panibillo/Colorimeter/docs/IMPLEMENTATION_COMPLETE.md

# Exposure Optimization Implementation — Complete ✓

**Date:** 2026-08-20  
**All steps completed and verified**

---

## Summary

Three major deliverables completed:

### 1. ✓ Database: Improved Exposures Written

**File:** `/home/bill/R/pi/colorimeter_2026-08-20.sqlite`

**What was updated:**
- Violet e* improved: 17,808 → 11,872 µs (−1 rung)
- Royal-blue e* improved: 3,290 → 2,193 µs (−1 rung)
- Cyan e* improved: 7,402 → 11,103 µs (+1 rung)

**Result:** 45 new active exposures inserted; 45 old ones deactivated (history preserved)

**Status:** Next Normal test run automatically uses improved exposures — **no action required**

---

### 2. ✓ Config: Pre-Image LEDs Updated

**Action taken by you:** Updated `capture_preimage_led_order` to `photo_red,green,cyan,royal_blue,violet`

**Current pre-image setup:**
```
Enabled:      true
LEDs:         photo_red, green, cyan, royal_blue, violet (5 illuminants)
Rung shift:   Per-LED (see #3 below)
```

**Result:** Next test run will capture pre-images of all five LEDs + the measurement LEDs

---
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
