panibillo/Colorimeter/captures/ZP1006_roi.png

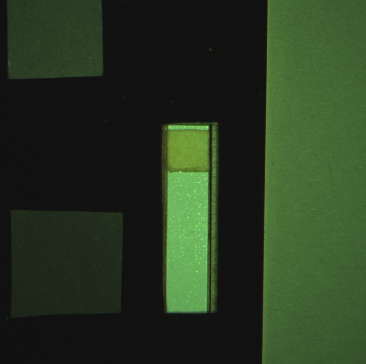
captures/ZP1006_roi.png
