panibillo/Colorimeter/desktop/padanalysis/fig/analysis1_C1002_roi.png

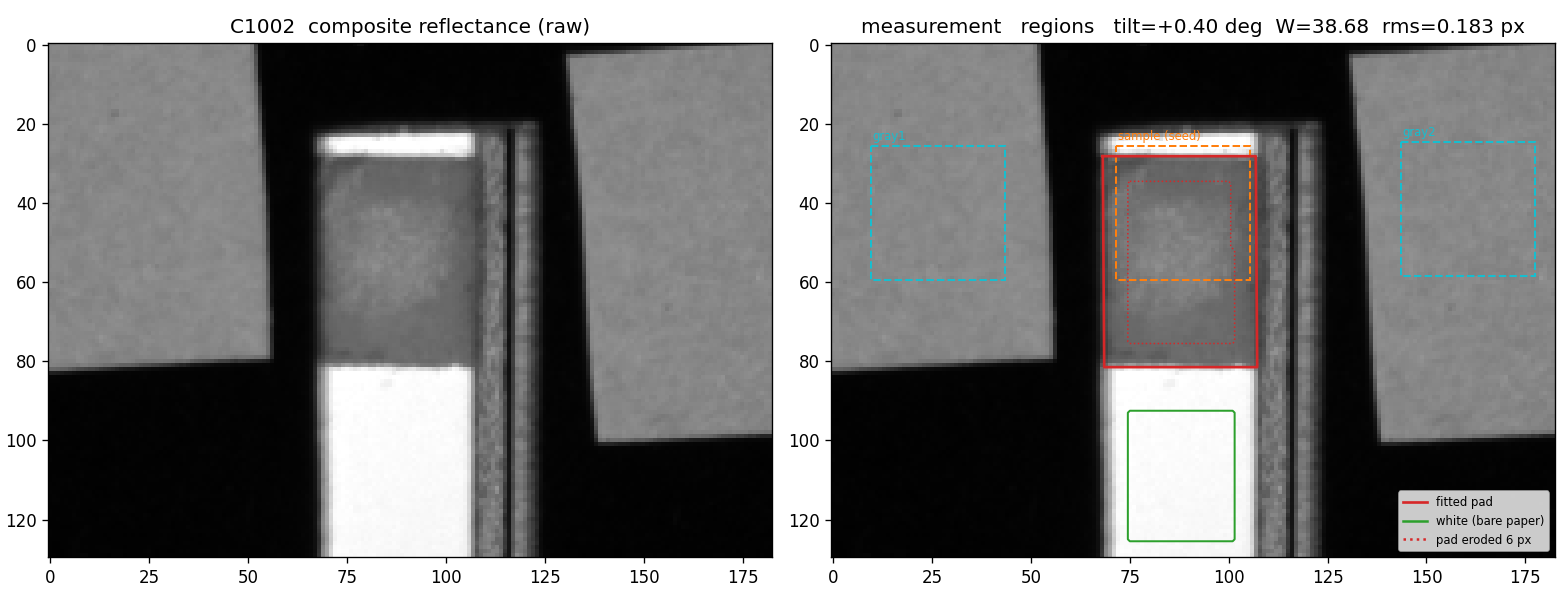
desktop/padanalysis/fig/analysis1_C1002_roi.png
