panibillo/Colorimeter/desktop/padanalysis/fig/analysis1_C1017_pca.png

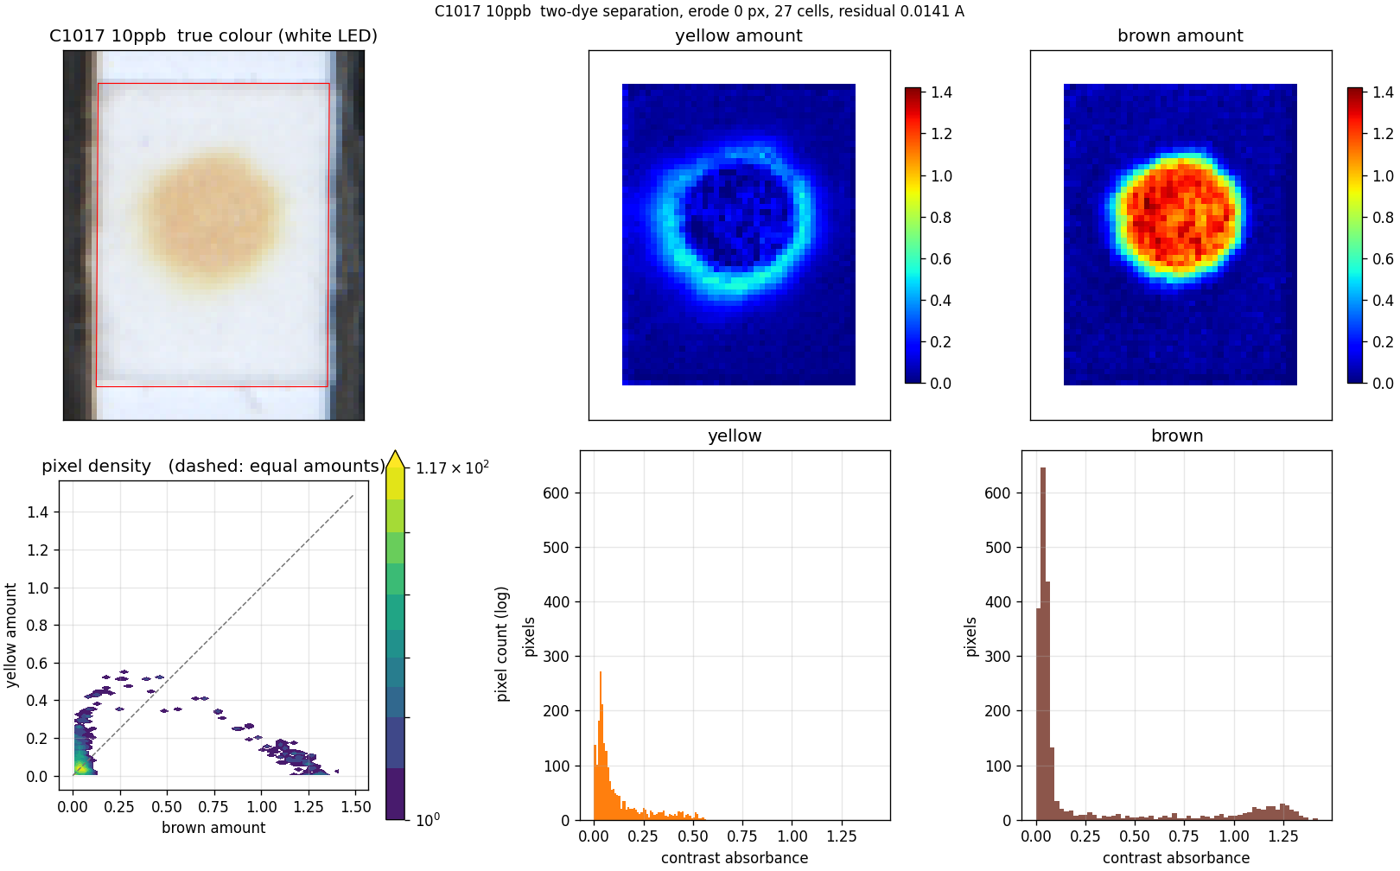
desktop/padanalysis/fig/analysis1_C1017_pca.png
