panibillo/Colorimeter/desktop/padanalysis/fig/analysis1_C1020_cells_R.png

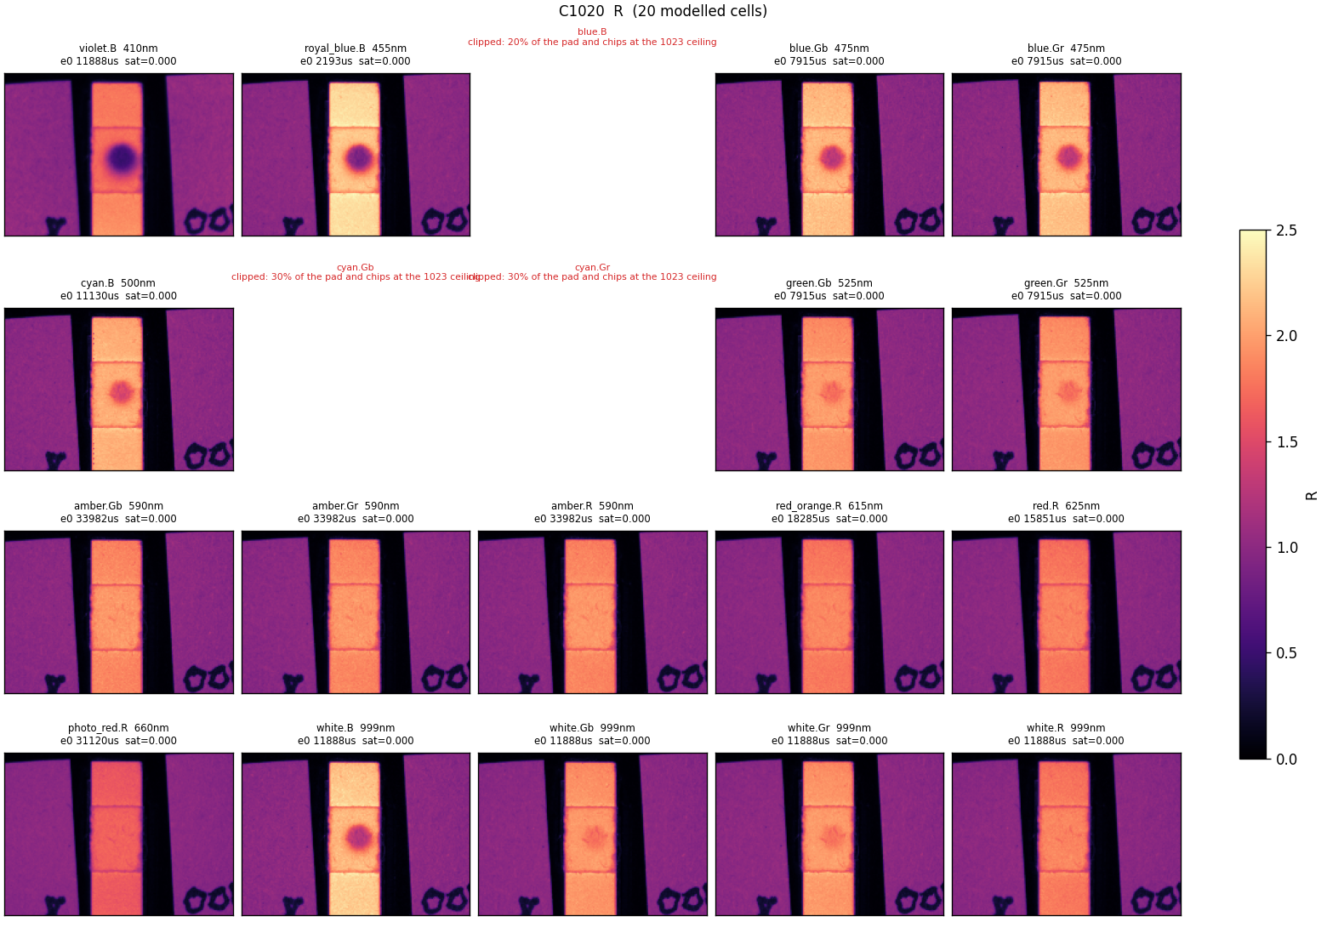
desktop/padanalysis/fig/analysis1_C1020_cells_R.png
