panibillo/Colorimeter/desktop/padanalysis/fig/analysis1_C1020_prepost.png

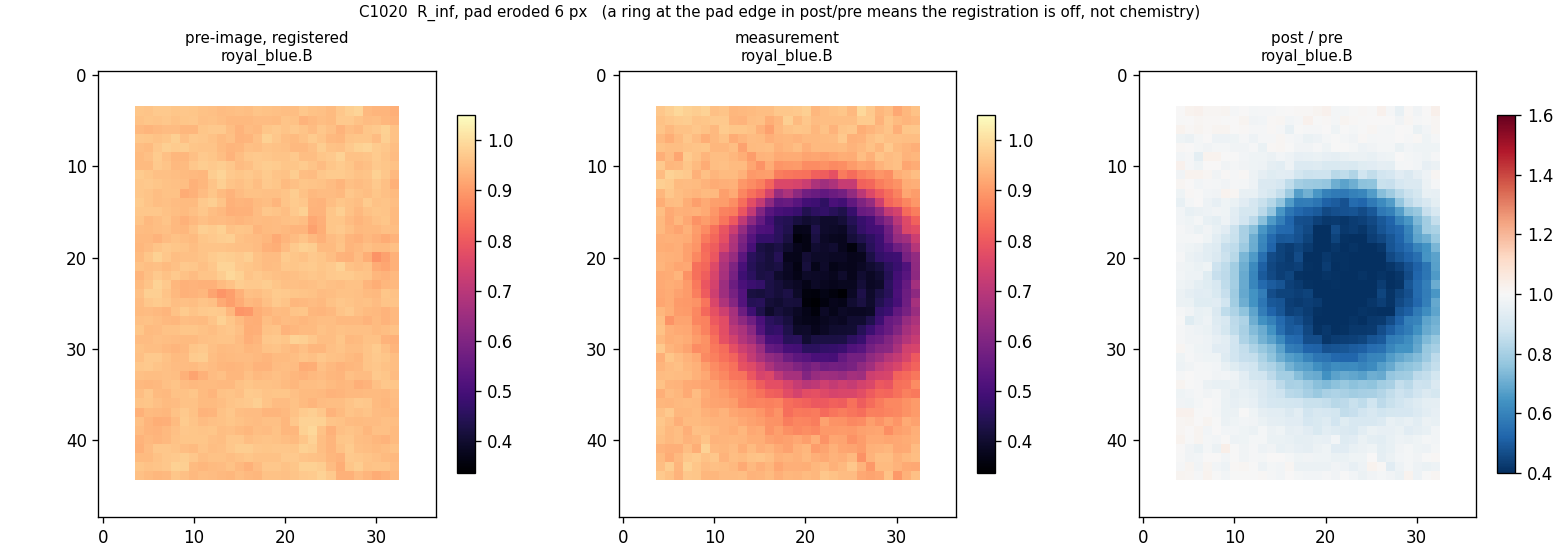
desktop/padanalysis/fig/analysis1_C1020_prepost.png
