panibillo/Colorimeter/desktop/padanalysis/fig/analysis1_C1020_roi.png

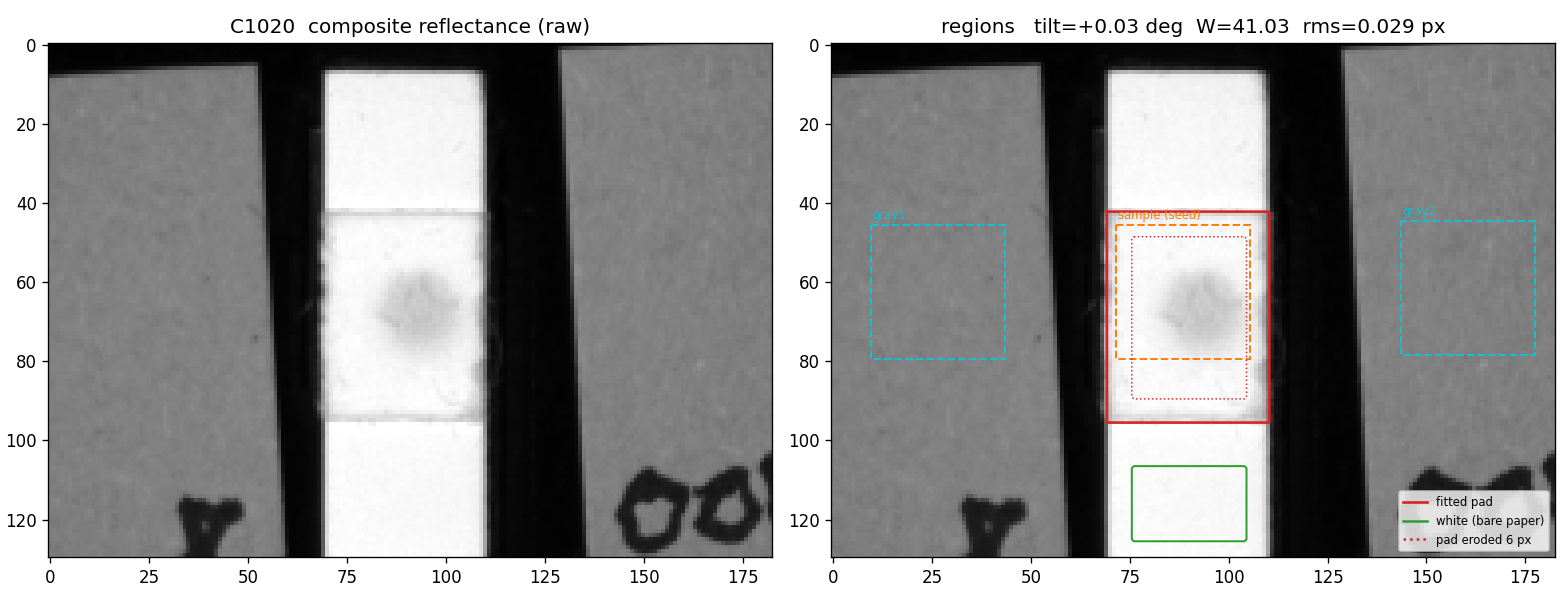
desktop/padanalysis/fig/analysis1_C1020_roi.png
