panibillo/Colorimeter/desktop/padanalysis/fig/analysis1_C1022_cells_R_inf.png

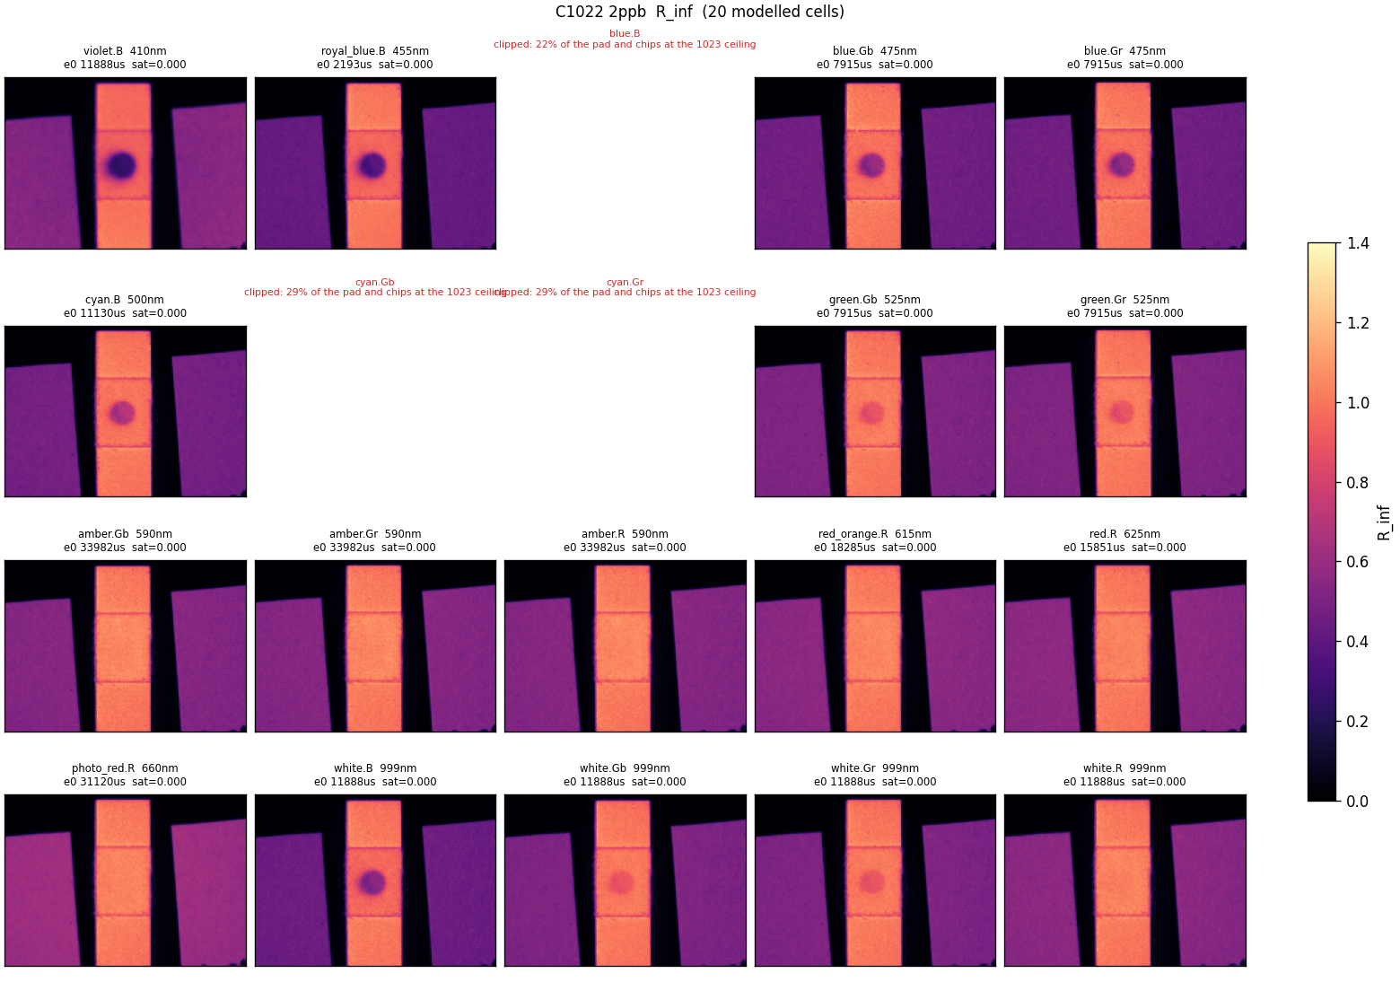
desktop/padanalysis/fig/analysis1_C1022_cells_R_inf.png
