panibillo/Colorimeter/desktop/padanalysis/fig/analysis1_C1022_pca.png

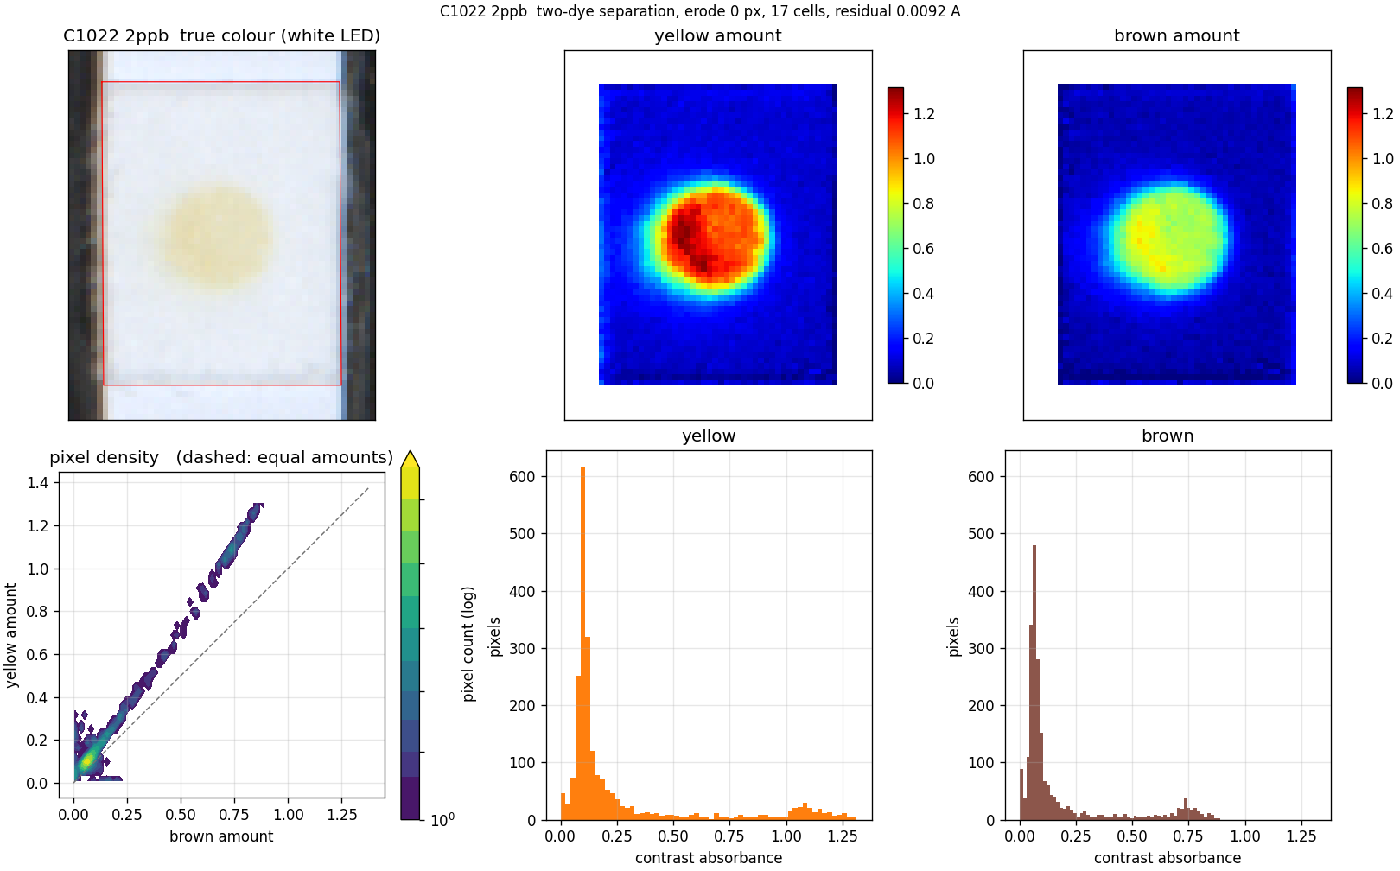
desktop/padanalysis/fig/analysis1_C1022_pca.png
