panibillo/Colorimeter/desktop/padanalysis/fig/analysis1_C1022_roi.png

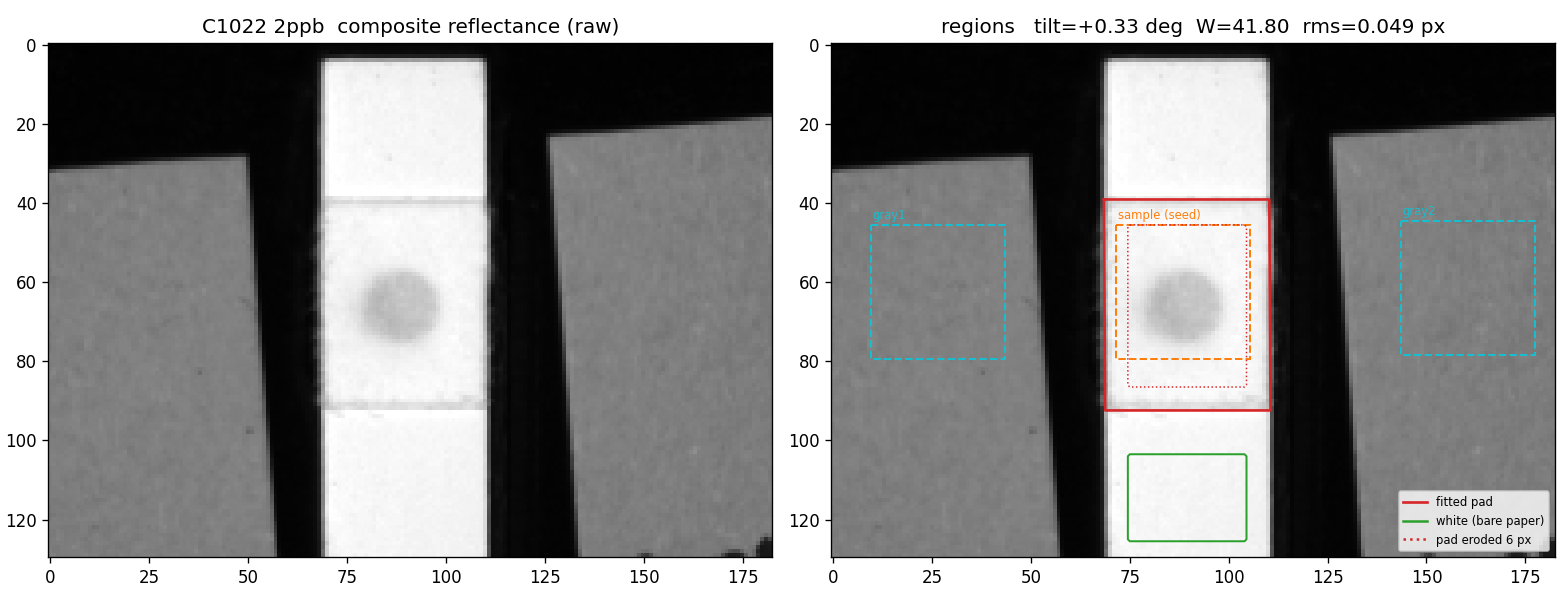
desktop/padanalysis/fig/analysis1_C1022_roi.png
