panibillo/Colorimeter/desktop/padanalysis/fig/analysis1_C1023_cells_R_inf.png

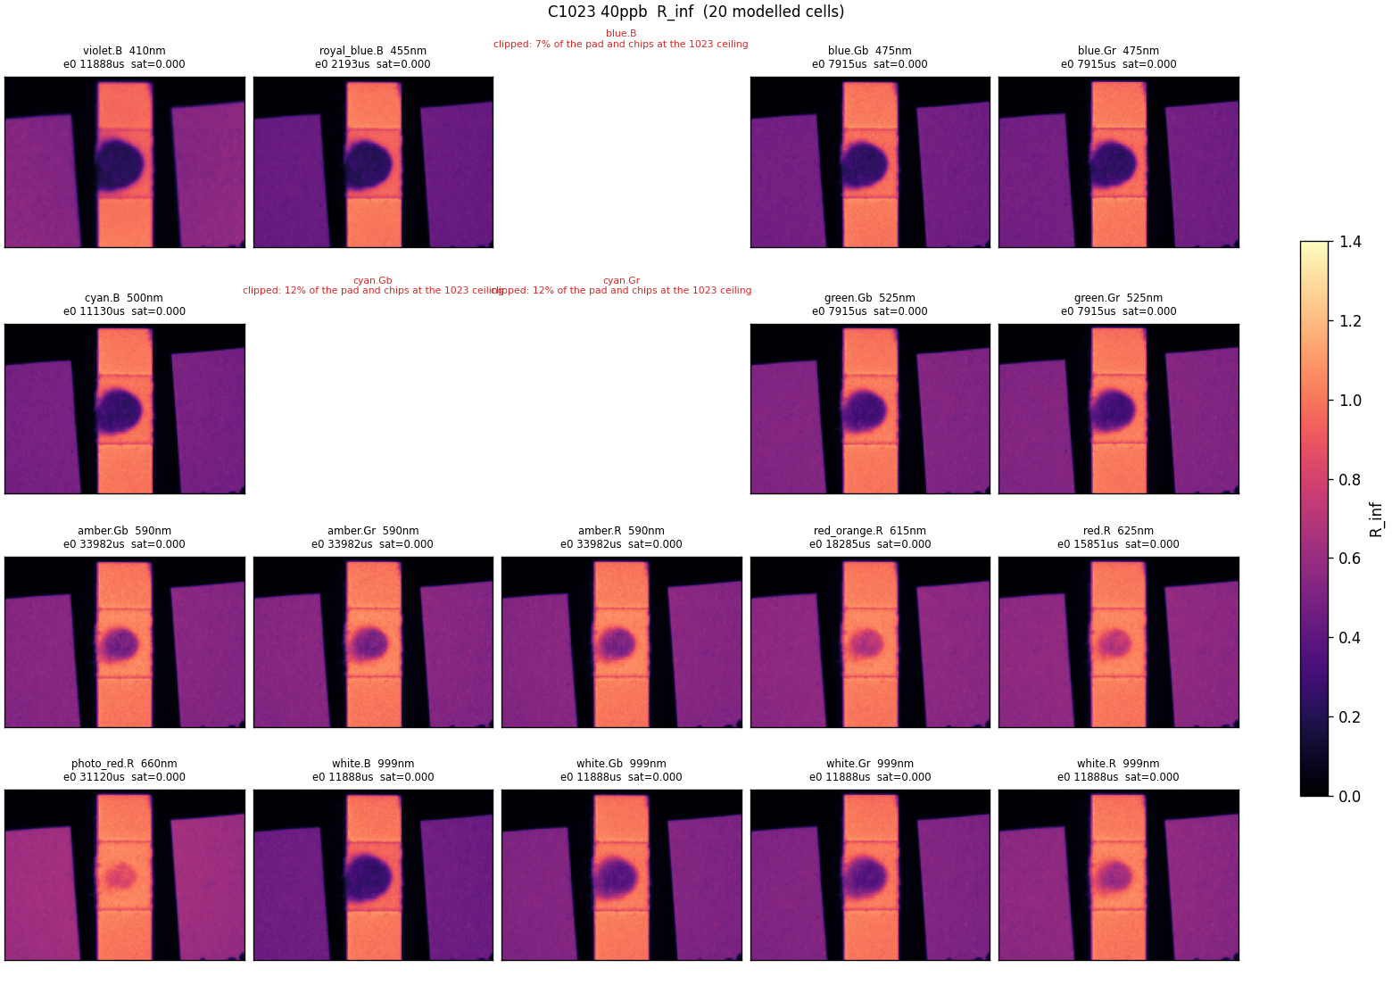
desktop/padanalysis/fig/analysis1_C1023_cells_R_inf.png
