panibillo/Colorimeter/desktop/padanalysis/fig/analysis1_C1023_pca.png

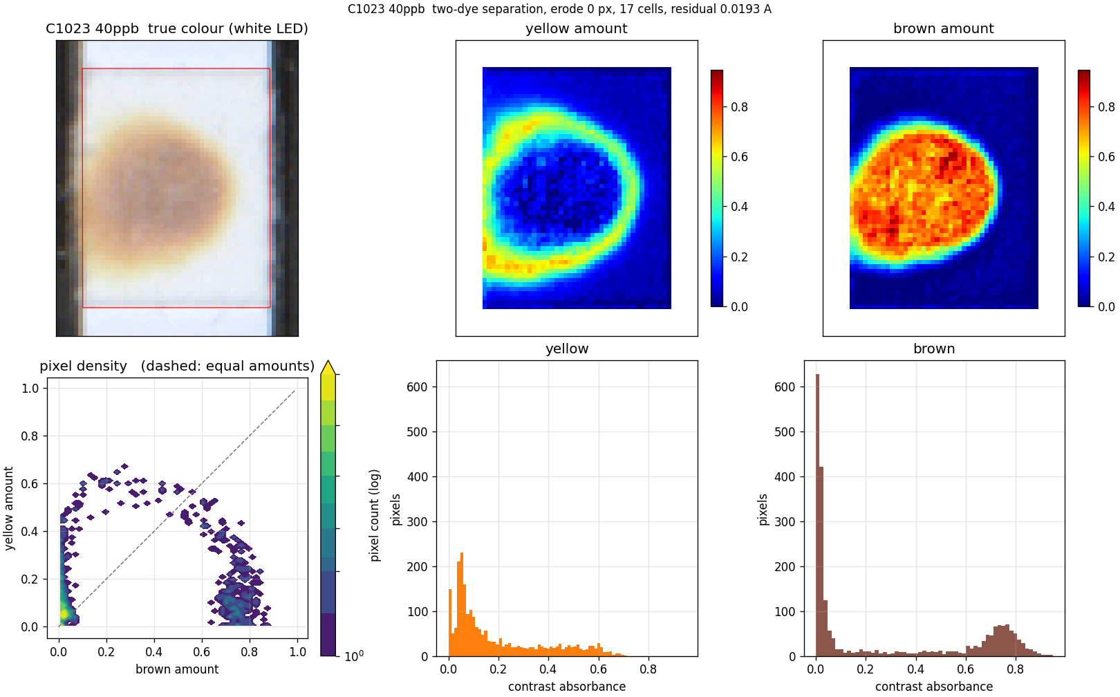
desktop/padanalysis/fig/analysis1_C1023_pca.png
