panibillo/Colorimeter/desktop/padanalysis/fig/analysis1_C1023_roi.png

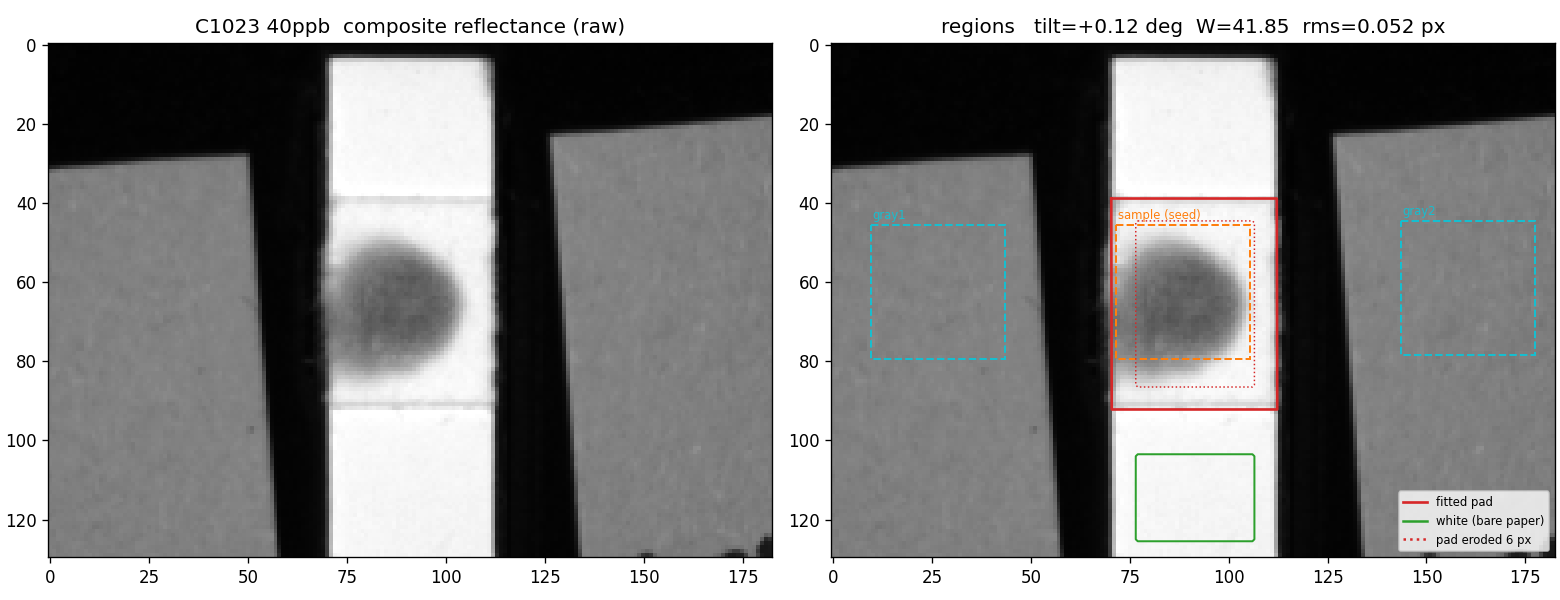
desktop/padanalysis/fig/analysis1_C1023_roi.png
