panibillo/Colorimeter/desktop/padanalysis/fig/analysis1_C1025_pca.png

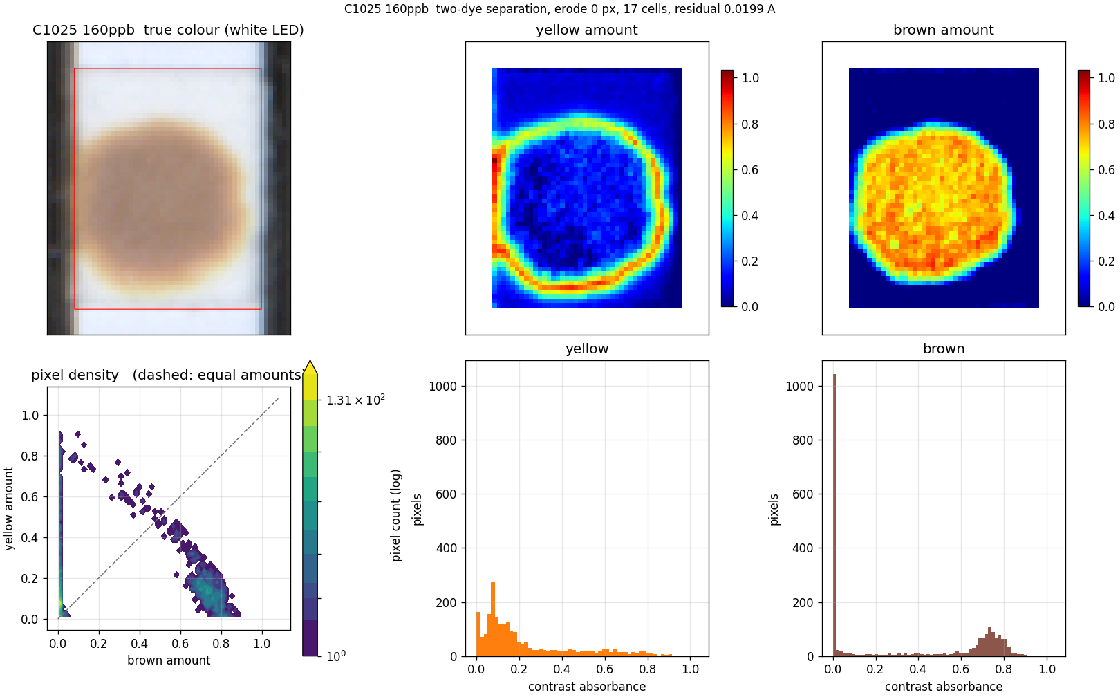
desktop/padanalysis/fig/analysis1_C1025_pca.png
