panibillo/Colorimeter/desktop/padanalysis/fig/analysis1_C1025_roi.png

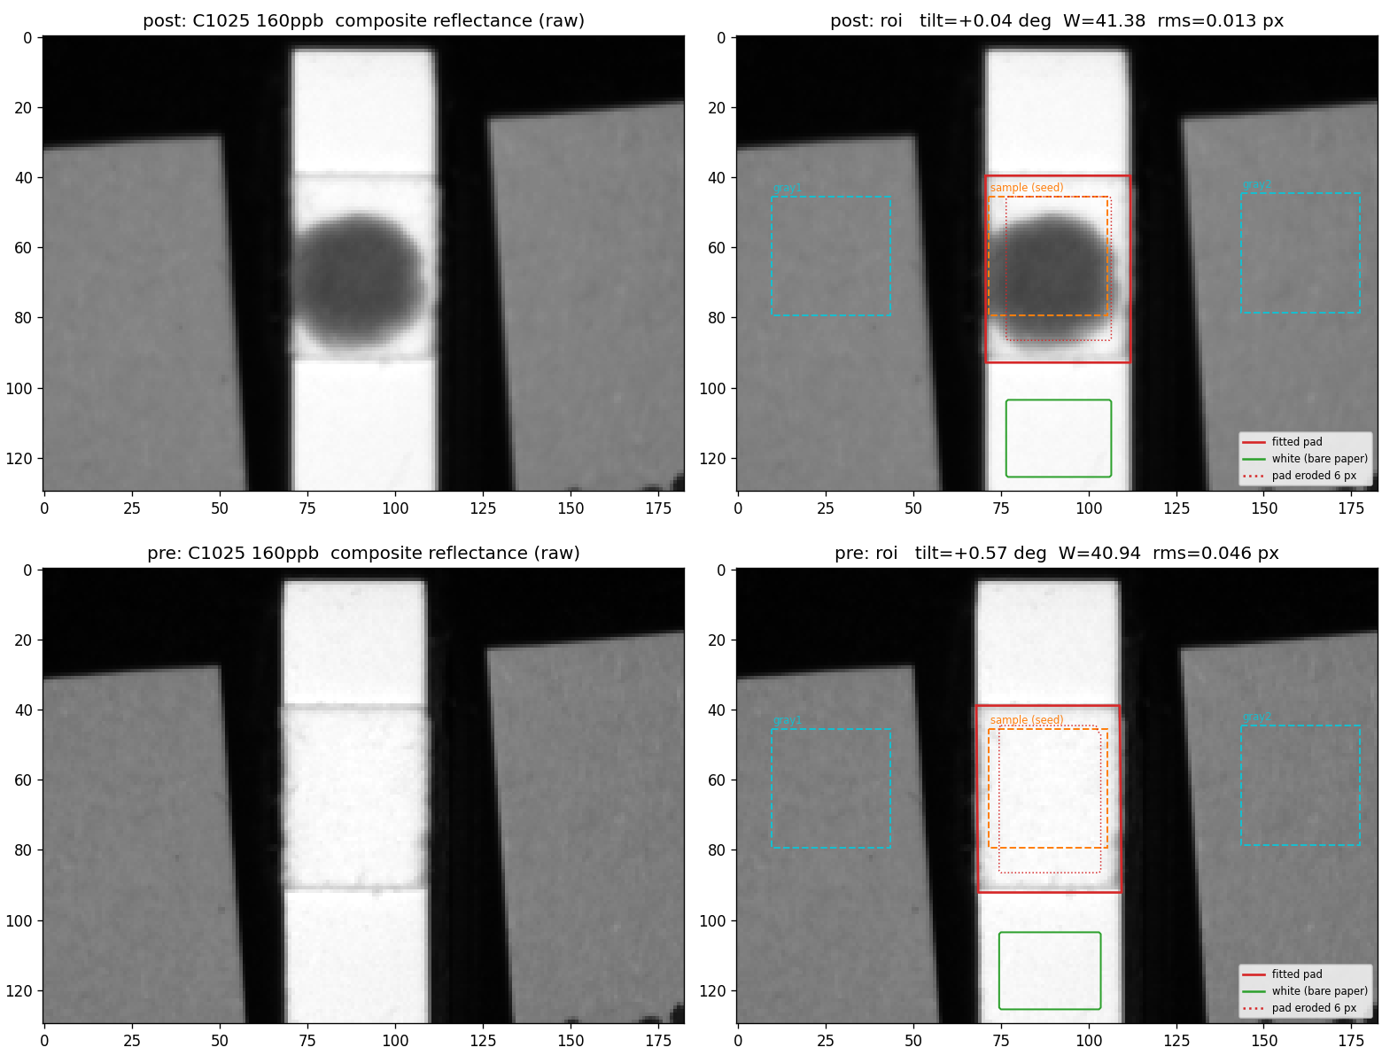
desktop/padanalysis/fig/analysis1_C1025_roi.png
