panibillo/Colorimeter/desktop/padanalysis/fig/C1002_white_bound.png

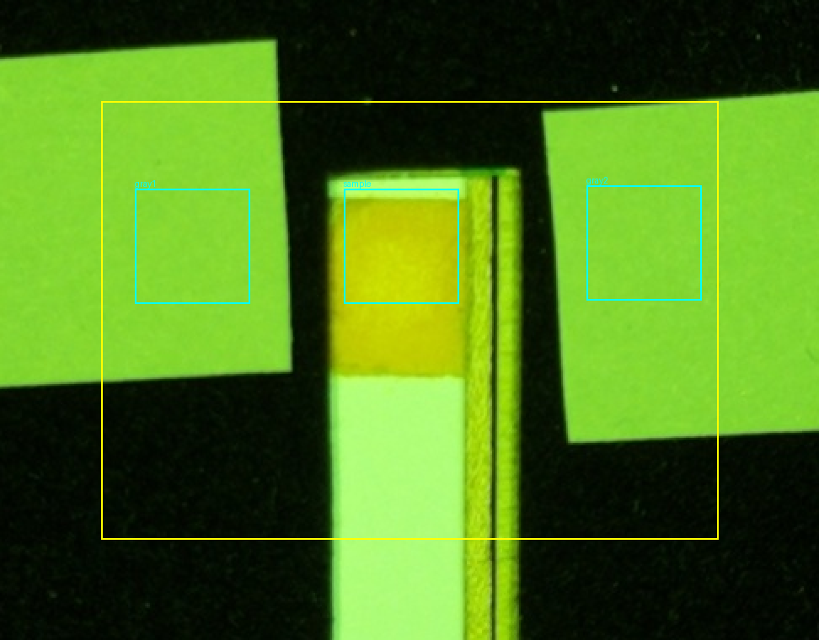
desktop/padanalysis/fig/C1002_white_bound.png
