panibillo/Colorimeter/desktop/padanalysis/fig/C1004_white_bound.png

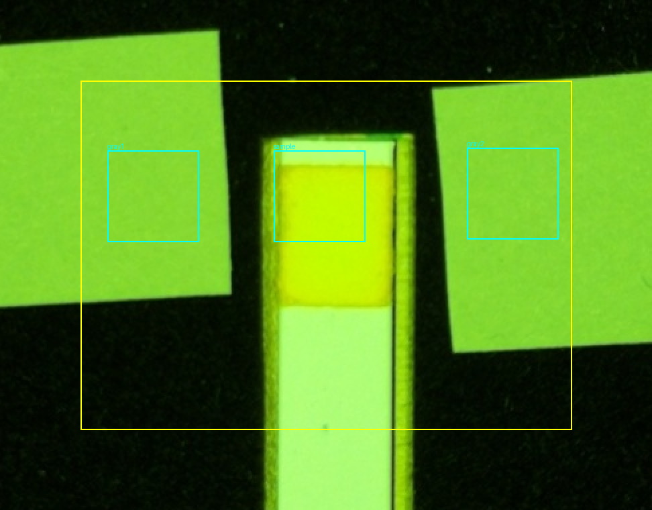
desktop/padanalysis/fig/C1004_white_bound.png
