panibillo/Colorimeter/desktop/padanalysis/fig/edge_effect.png

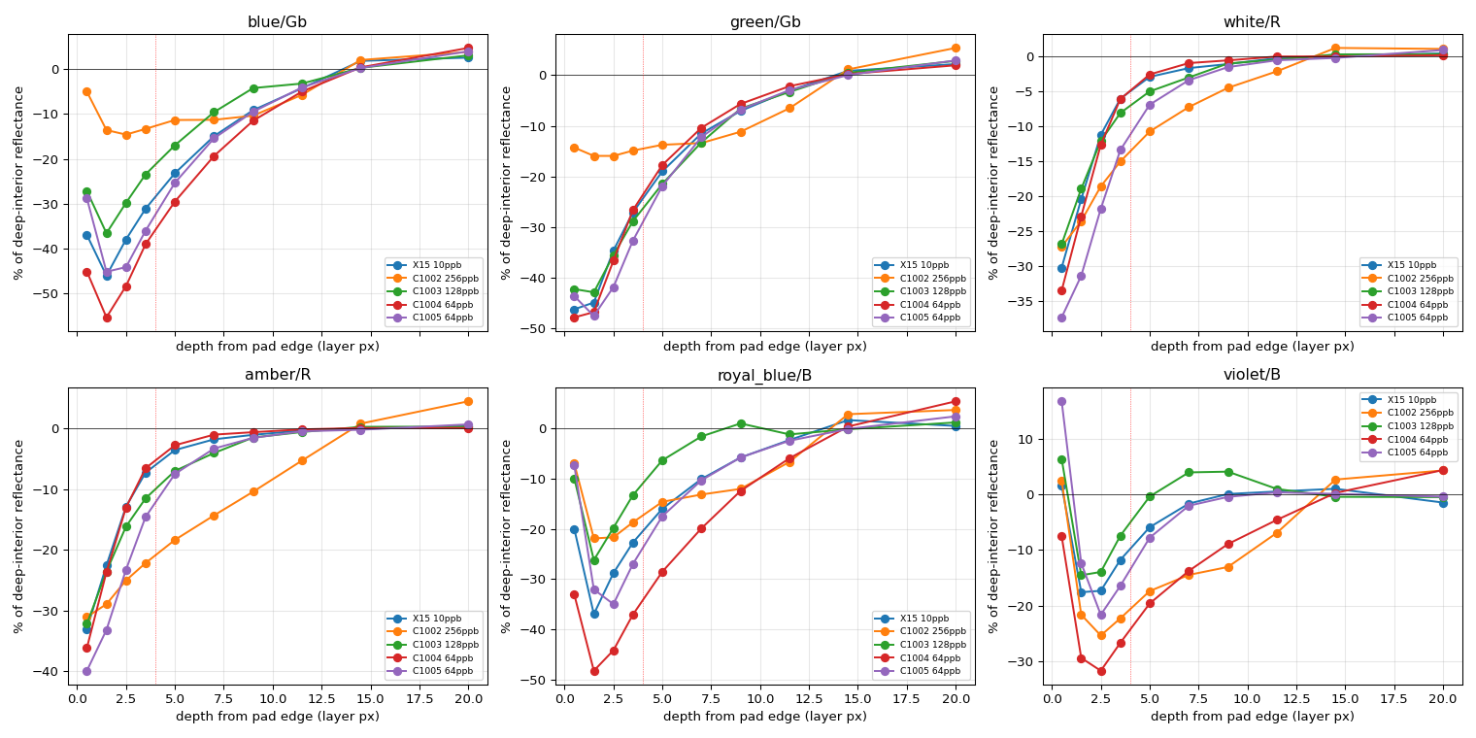
desktop/padanalysis/fig/edge_effect.png
