panibillo/Colorimeter/desktop/padanalysis/fig/edge_origin.png

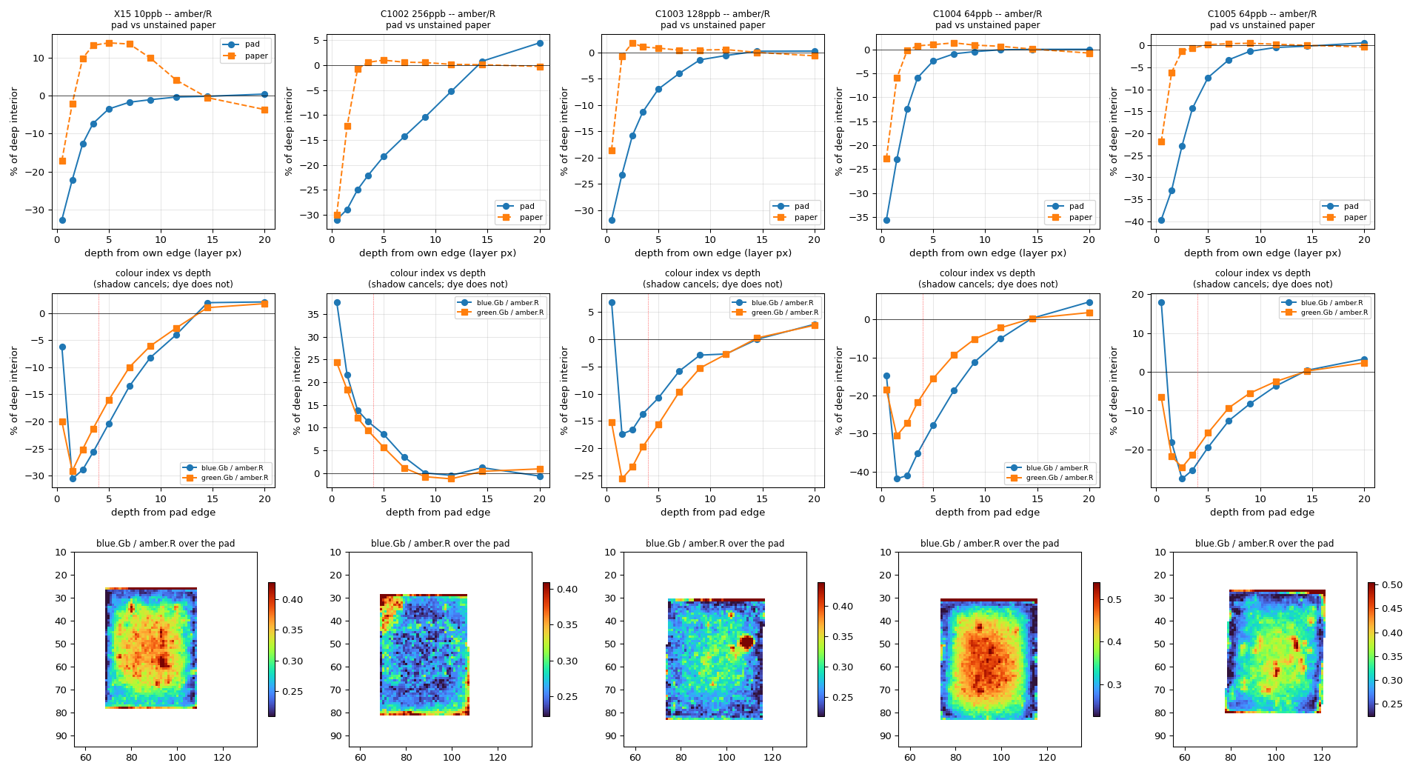
desktop/padanalysis/fig/edge_origin.png
