panibillo/Colorimeter/desktop/padanalysis/fig/look1.png

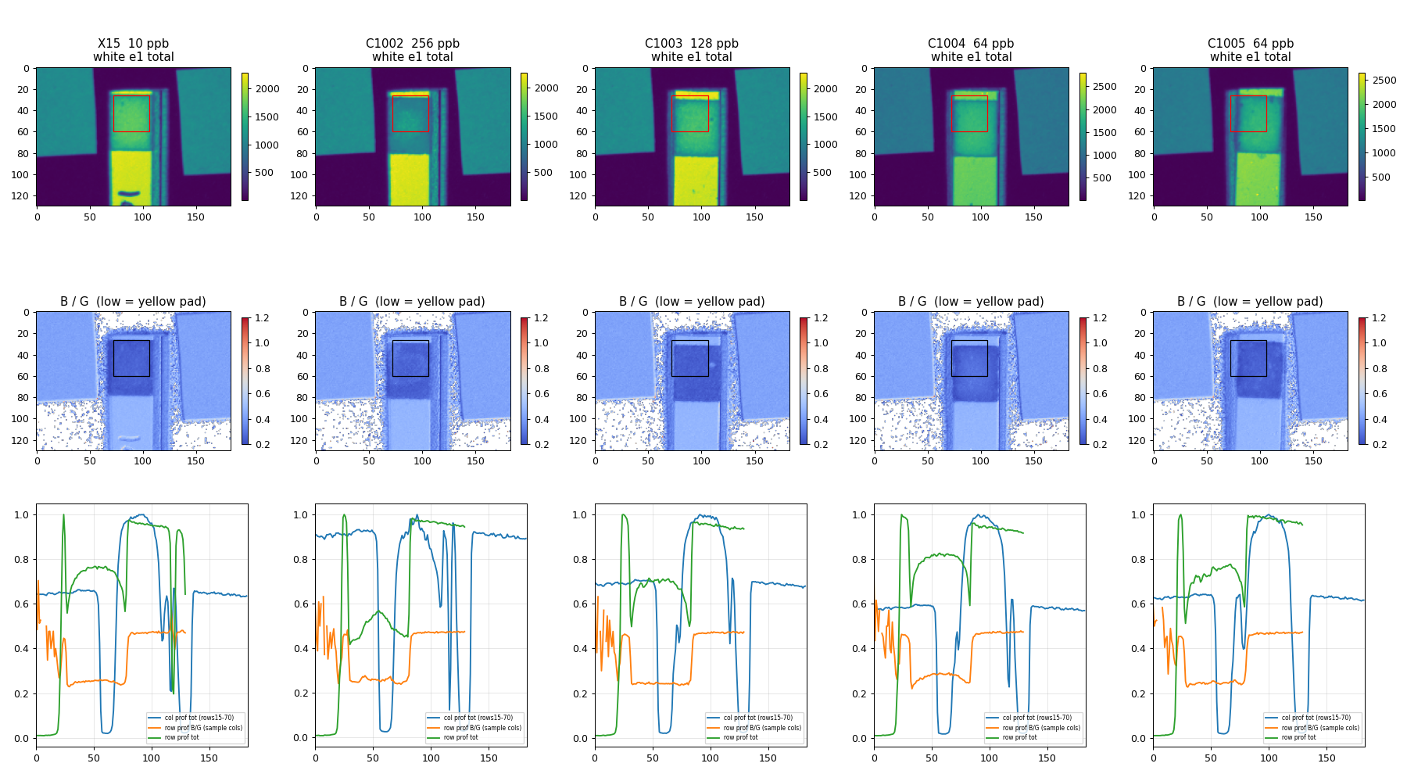
desktop/padanalysis/fig/look1.png
