panibillo/Colorimeter/desktop/padanalysis/fig/look2.png

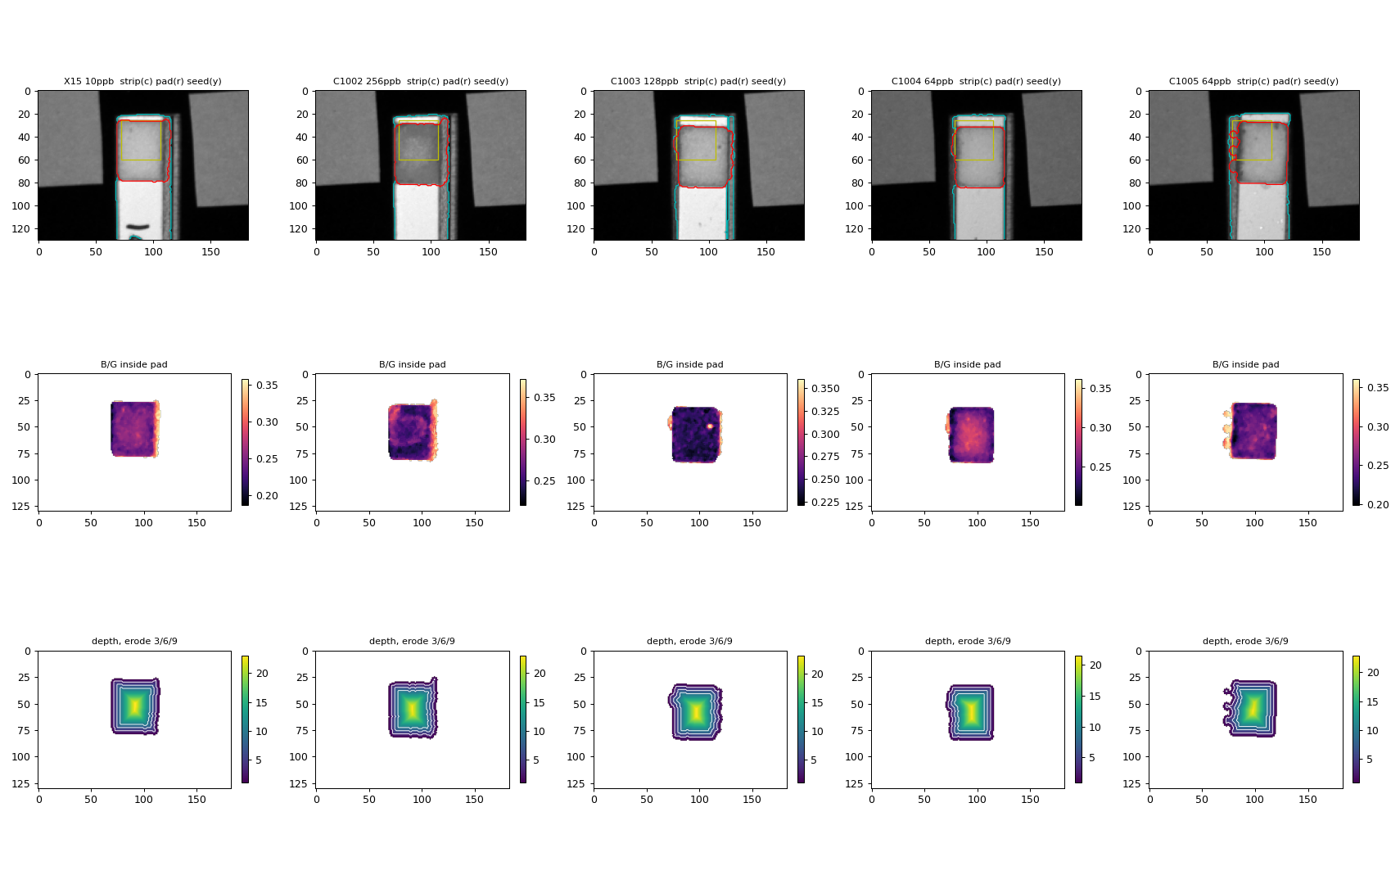
desktop/padanalysis/fig/look2.png
