panibillo/Colorimeter/desktop/padanalysis/fig/look3.png

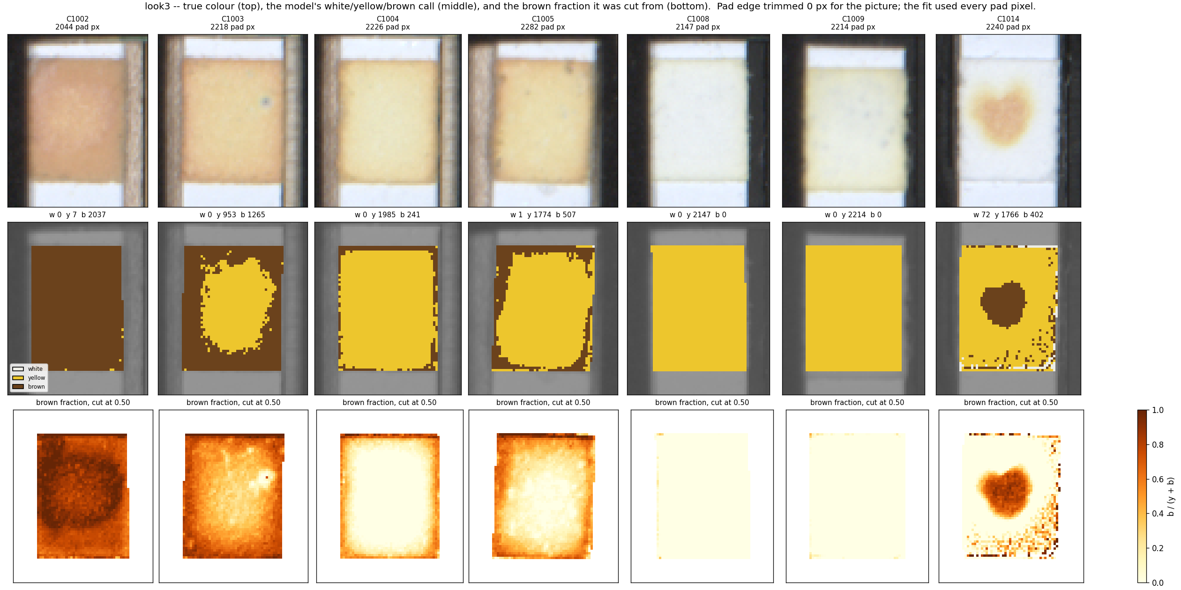
desktop/padanalysis/fig/look3.png
