panibillo/Colorimeter/desktop/padanalysis/fig/padrect.png

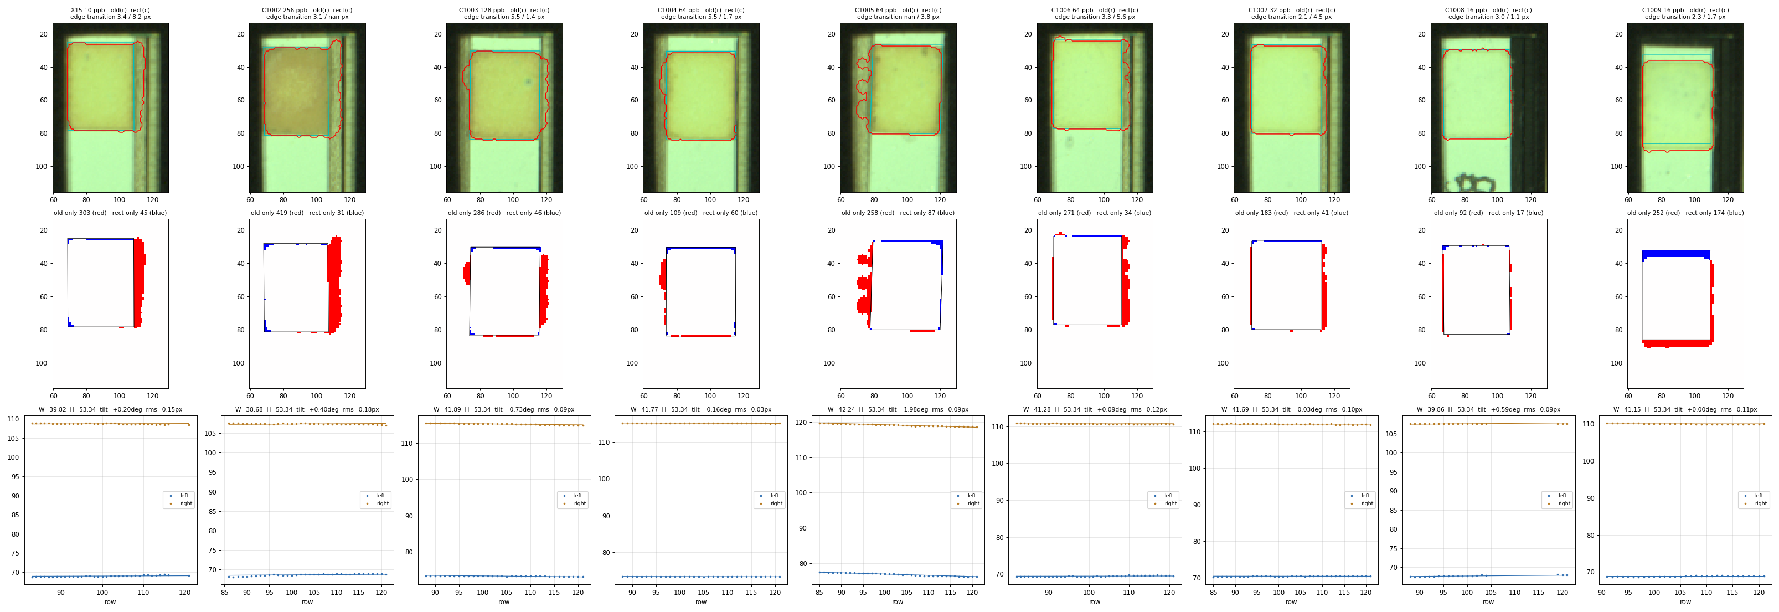
desktop/padanalysis/fig/padrect.png
