panibillo/Colorimeter/desktop/padanalysis/fig/pca.png

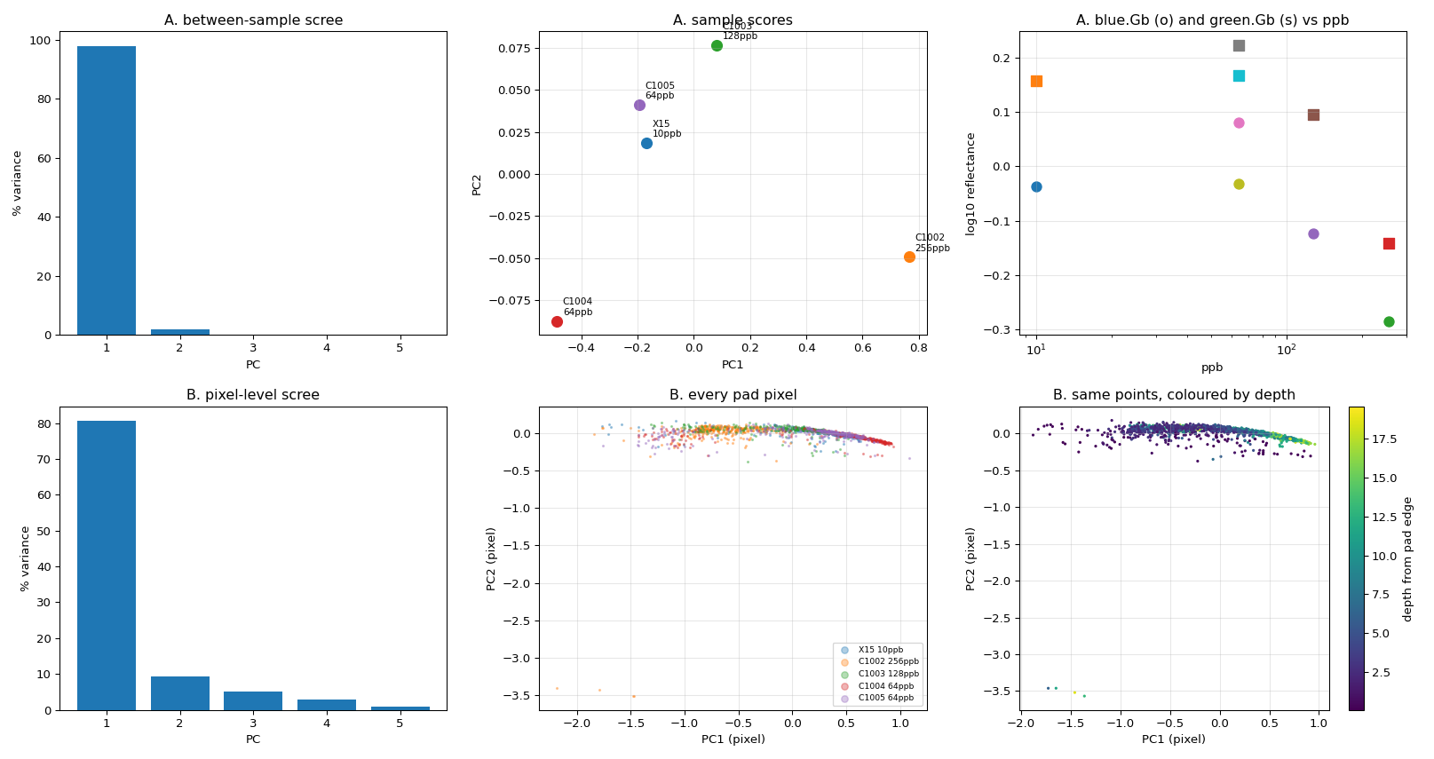
desktop/padanalysis/fig/pca.png
