panibillo/Colorimeter/desktop/padanalysis/fig/report9_paper.png

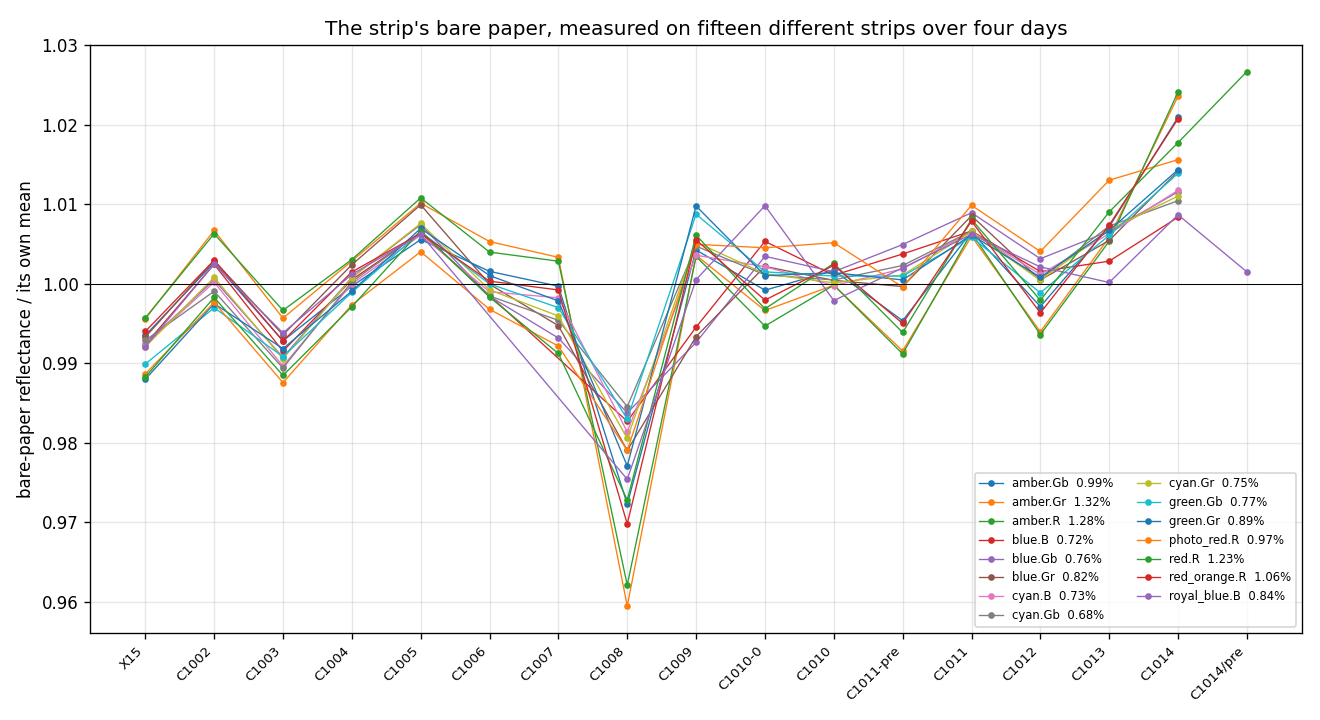
desktop/padanalysis/fig/report9_paper.png
