panibillo/Colorimeter/desktop/padanalysis/fig/report10_cells.png

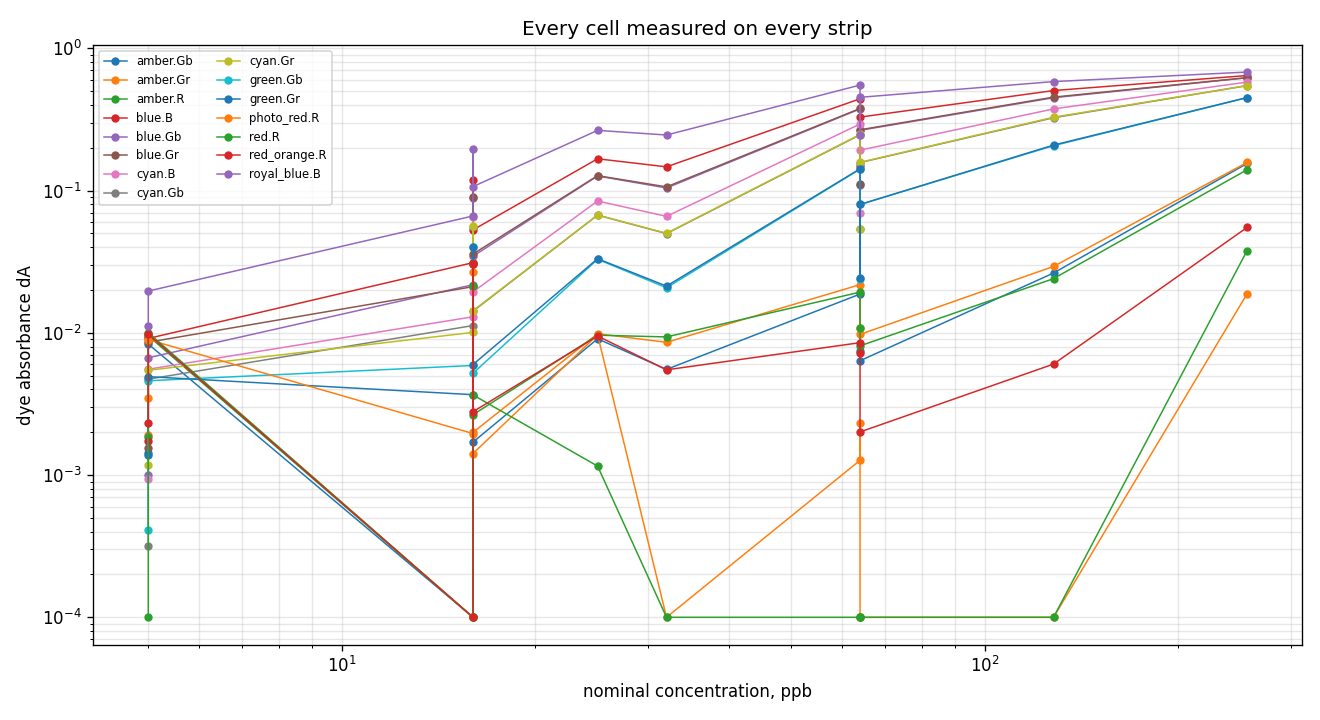
desktop/padanalysis/fig/report10_cells.png
