panibillo/Colorimeter/desktop/padanalysis/fig/report10_dose.png

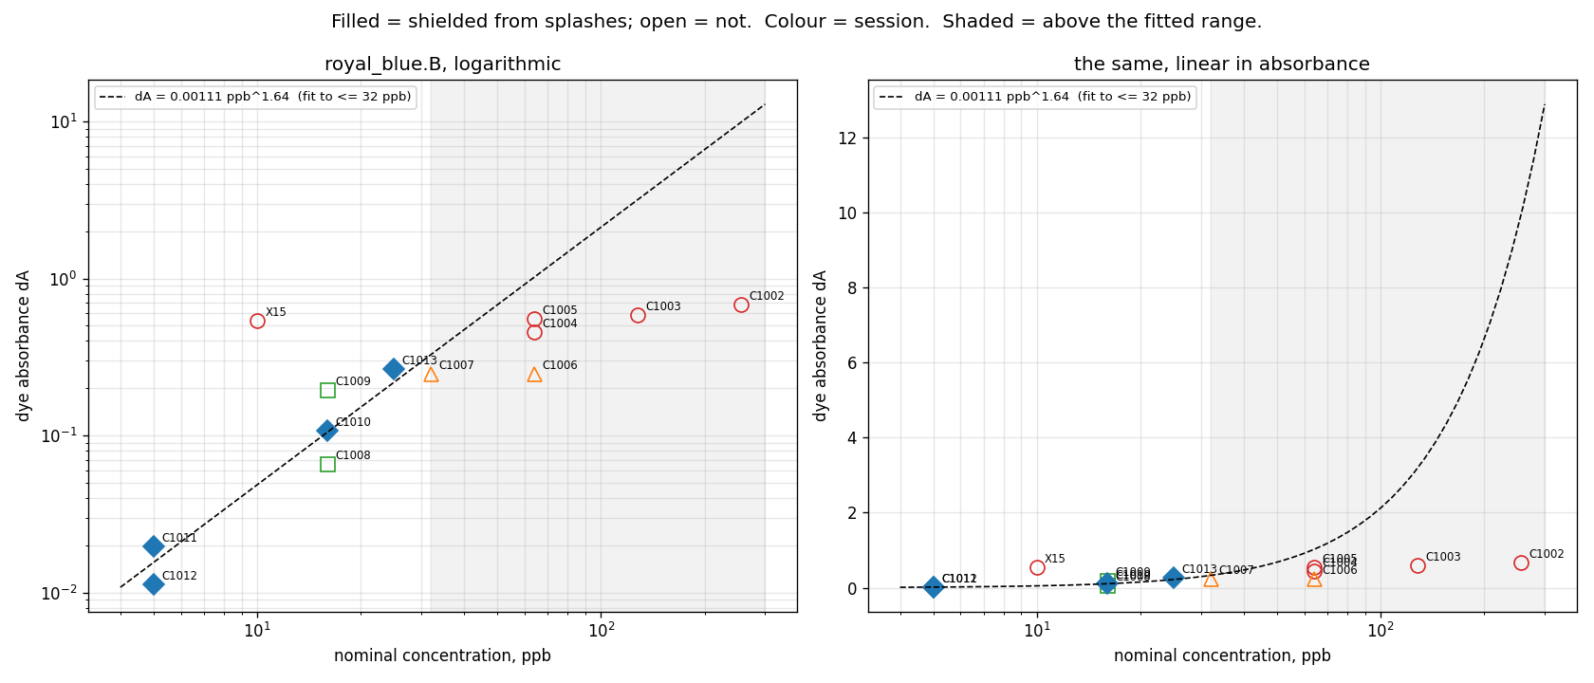
desktop/padanalysis/fig/report10_dose.png
