panibillo/Colorimeter/desktop/padanalysis/fig/report11_pairs.png

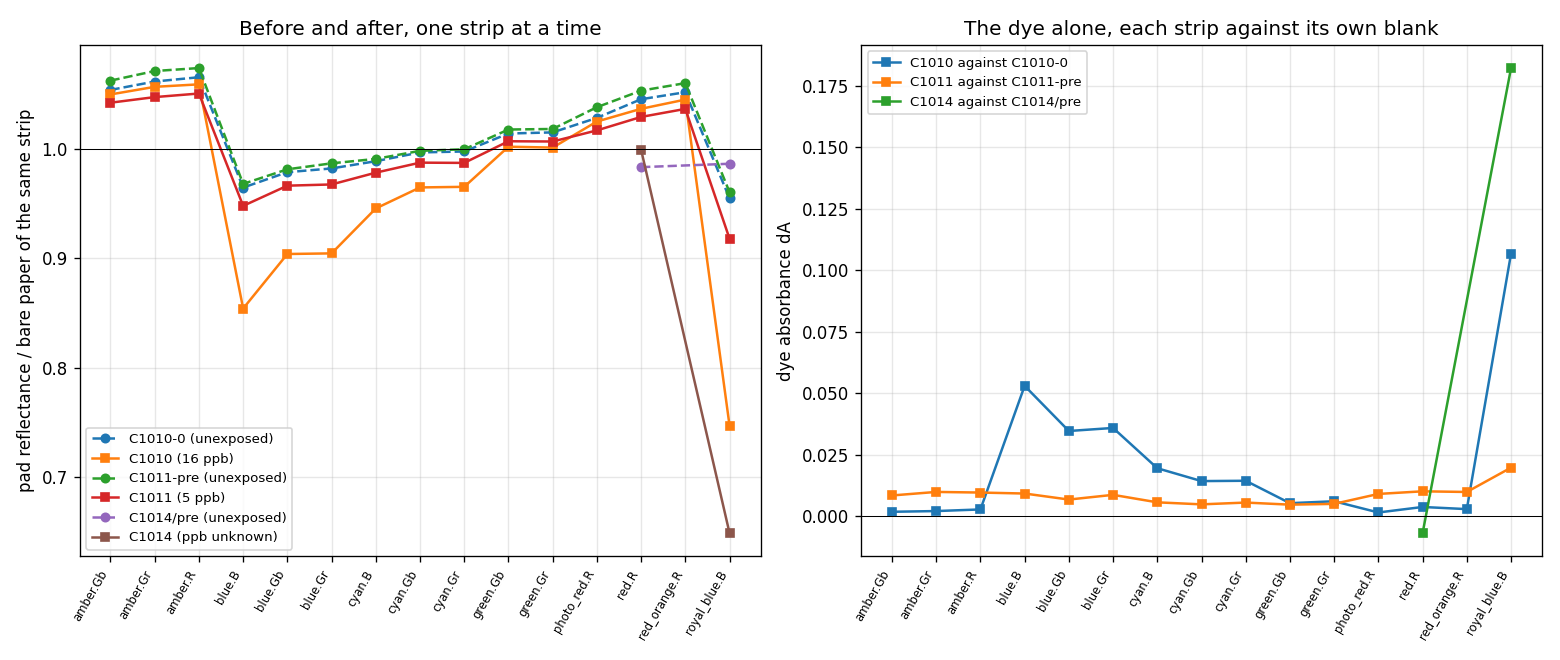
desktop/padanalysis/fig/report11_pairs.png
