panibillo/Colorimeter/desktop/padanalysis/fig/report12_structure.png

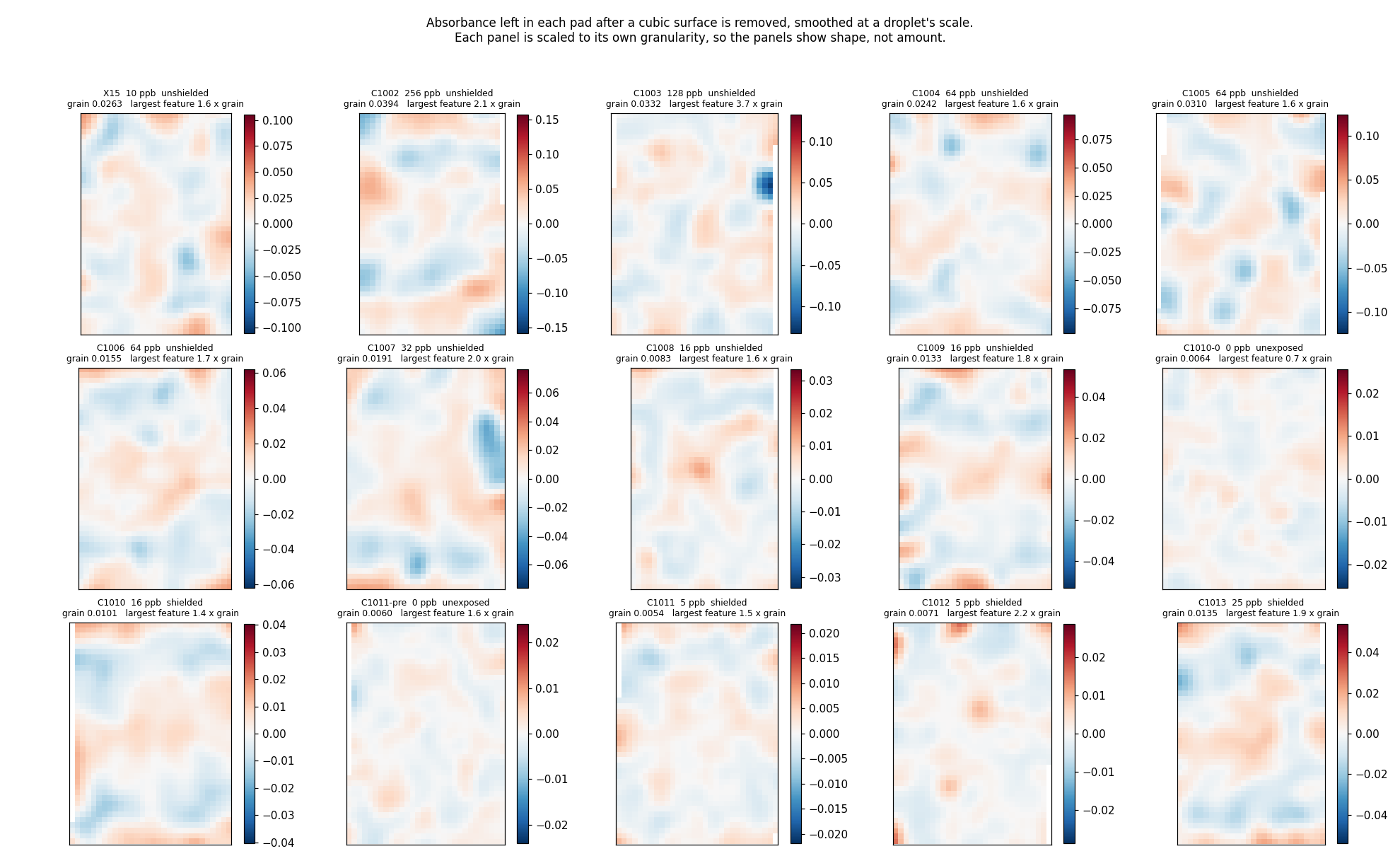
desktop/padanalysis/fig/report12_structure.png
