panibillo/Colorimeter/desktop/padanalysis/fig/report13_timing.png

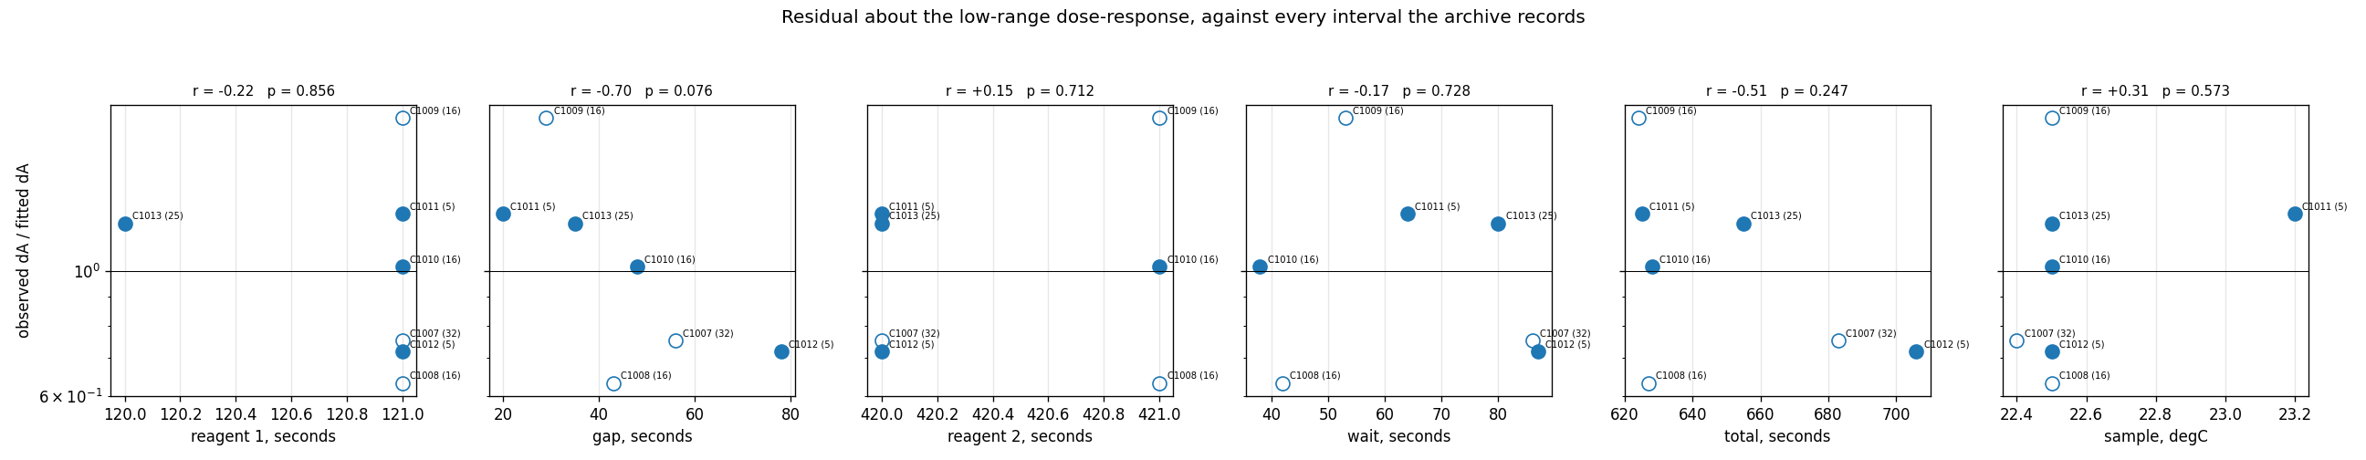
desktop/padanalysis/fig/report13_timing.png
