panibillo/Colorimeter/desktop/padanalysis/fig/report14_ranking.png

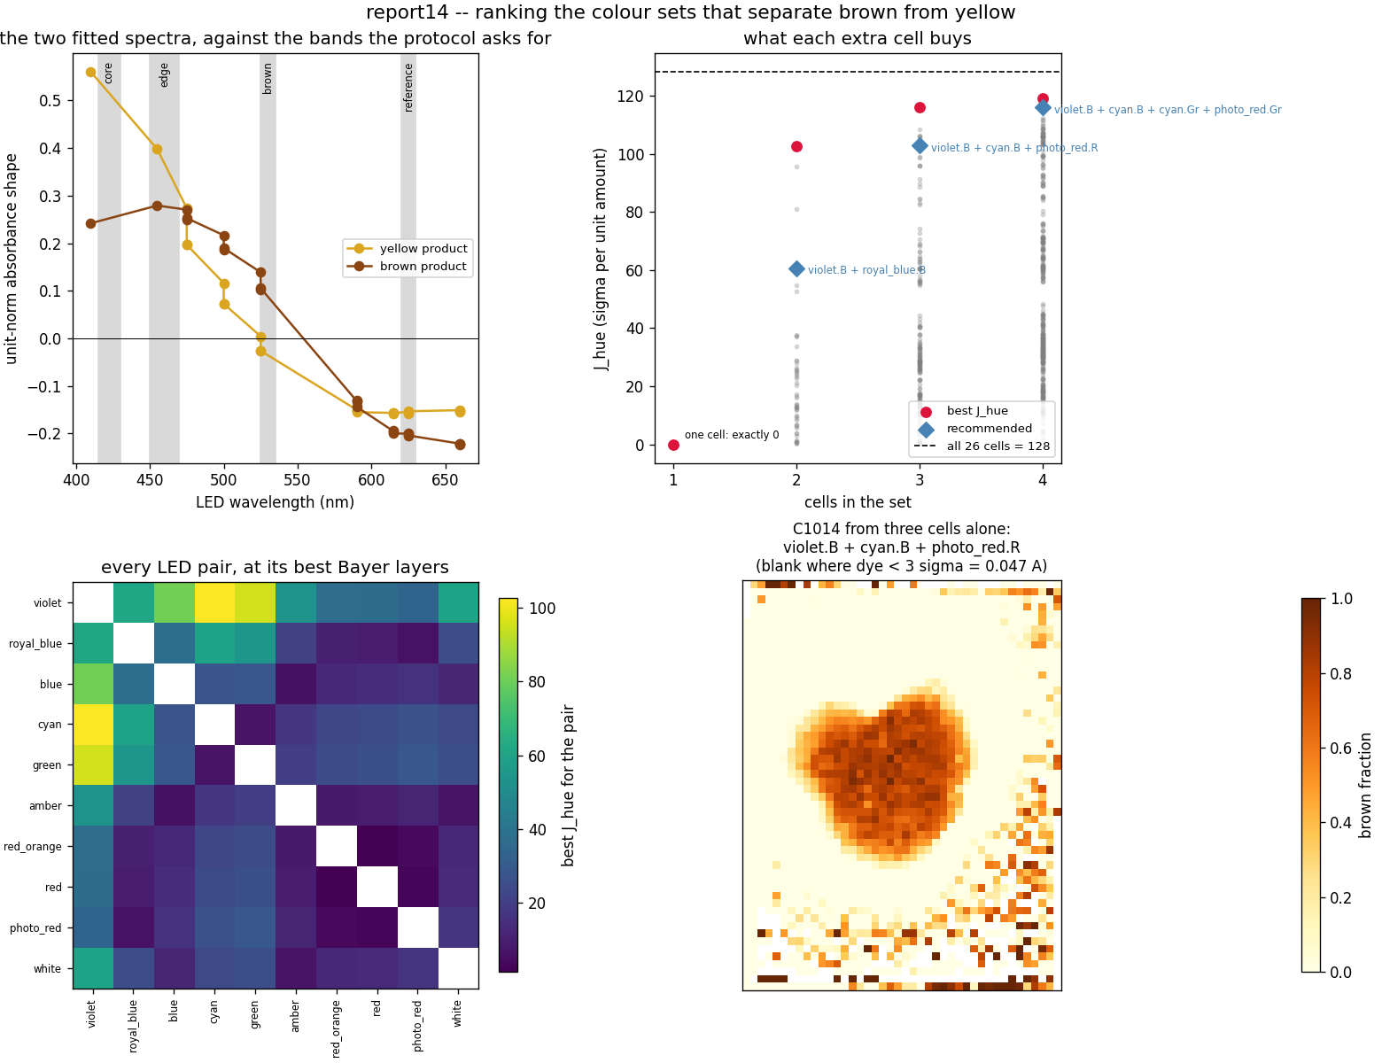
desktop/padanalysis/fig/report14_ranking.png
