panibillo/Colorimeter/desktop/padanalysis/fig/spectra.png

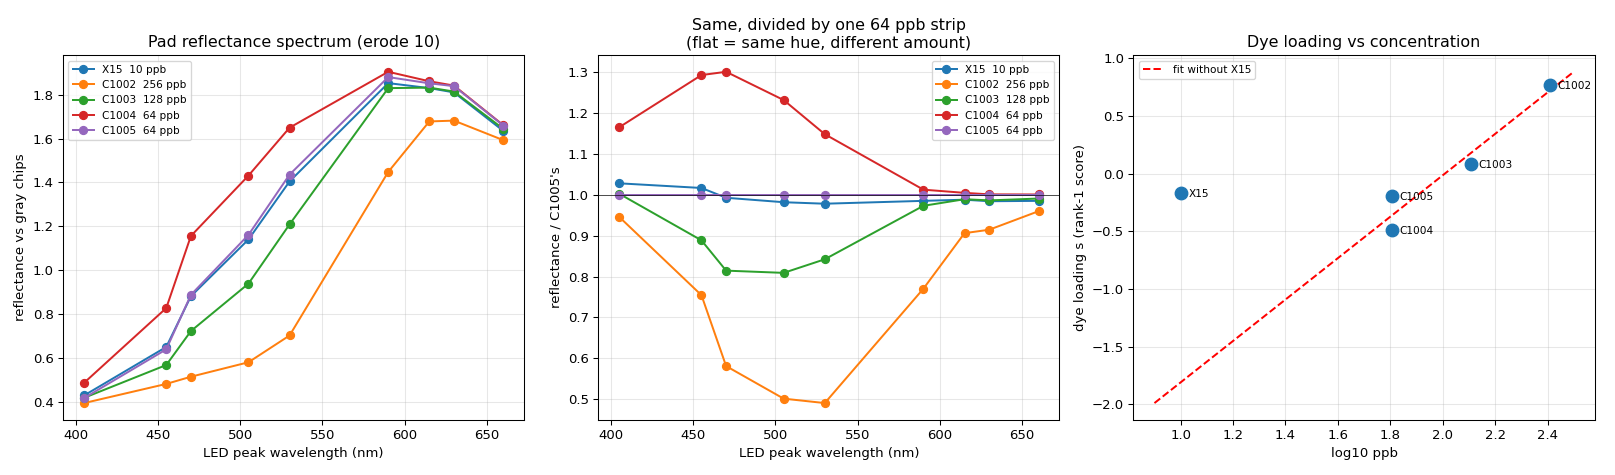
desktop/padanalysis/fig/spectra.png
