panibillo/Colorimeter/dev/captures/20260615_2120/analyze_amber_B.png

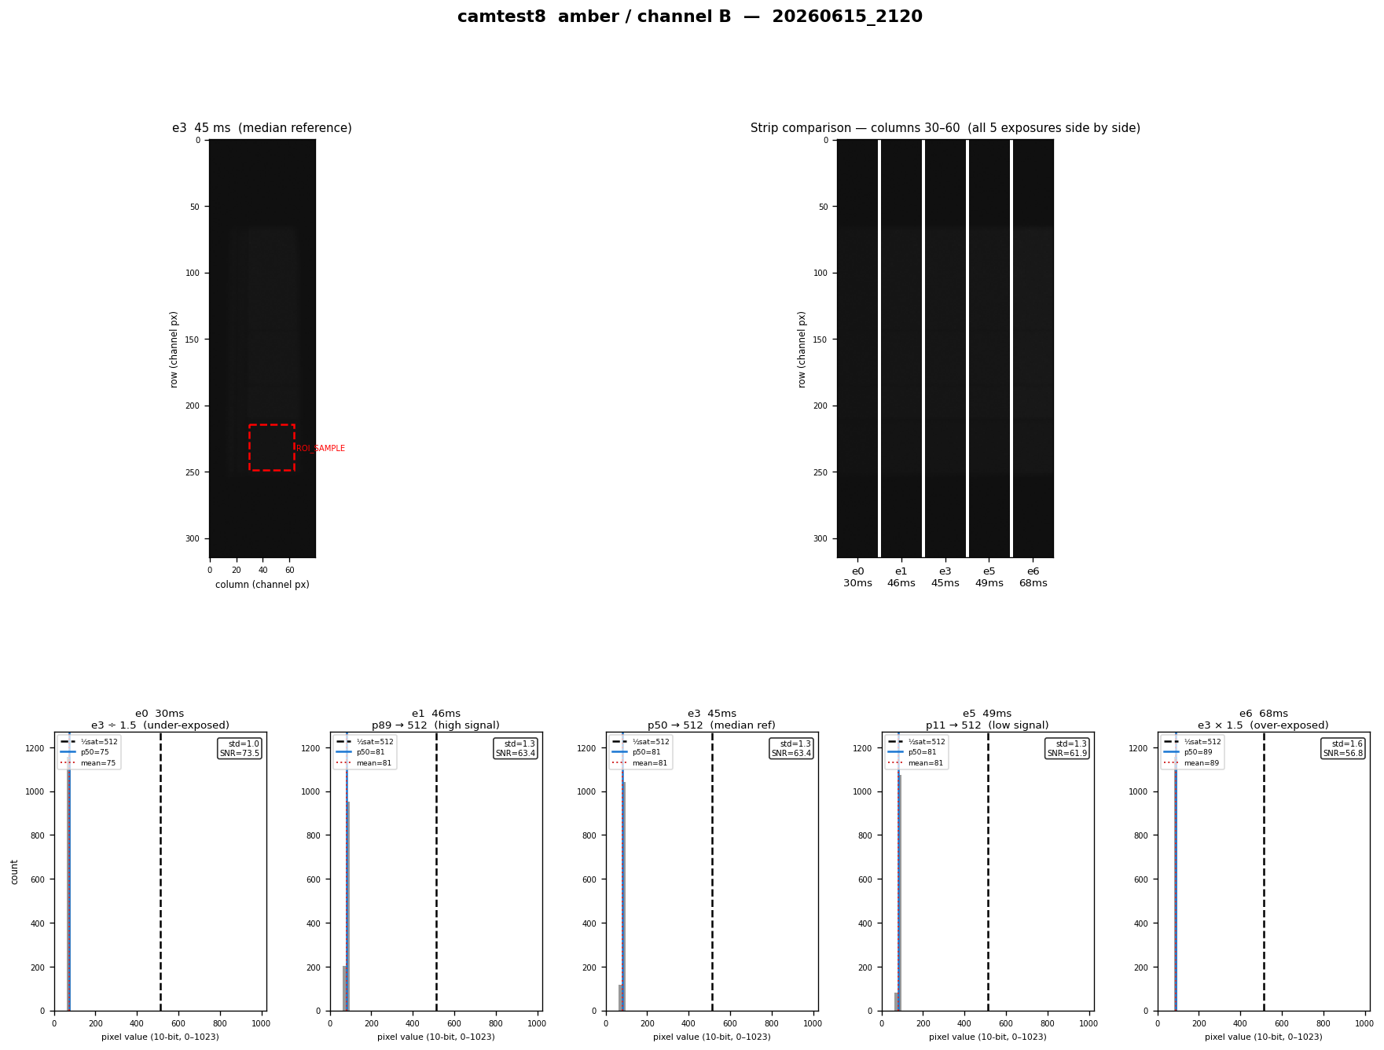
dev/captures/20260615_2120/analyze_amber_B.png
