panibillo/Colorimeter/dev/captures/20260615_2120/analyze_amber_Gb.png

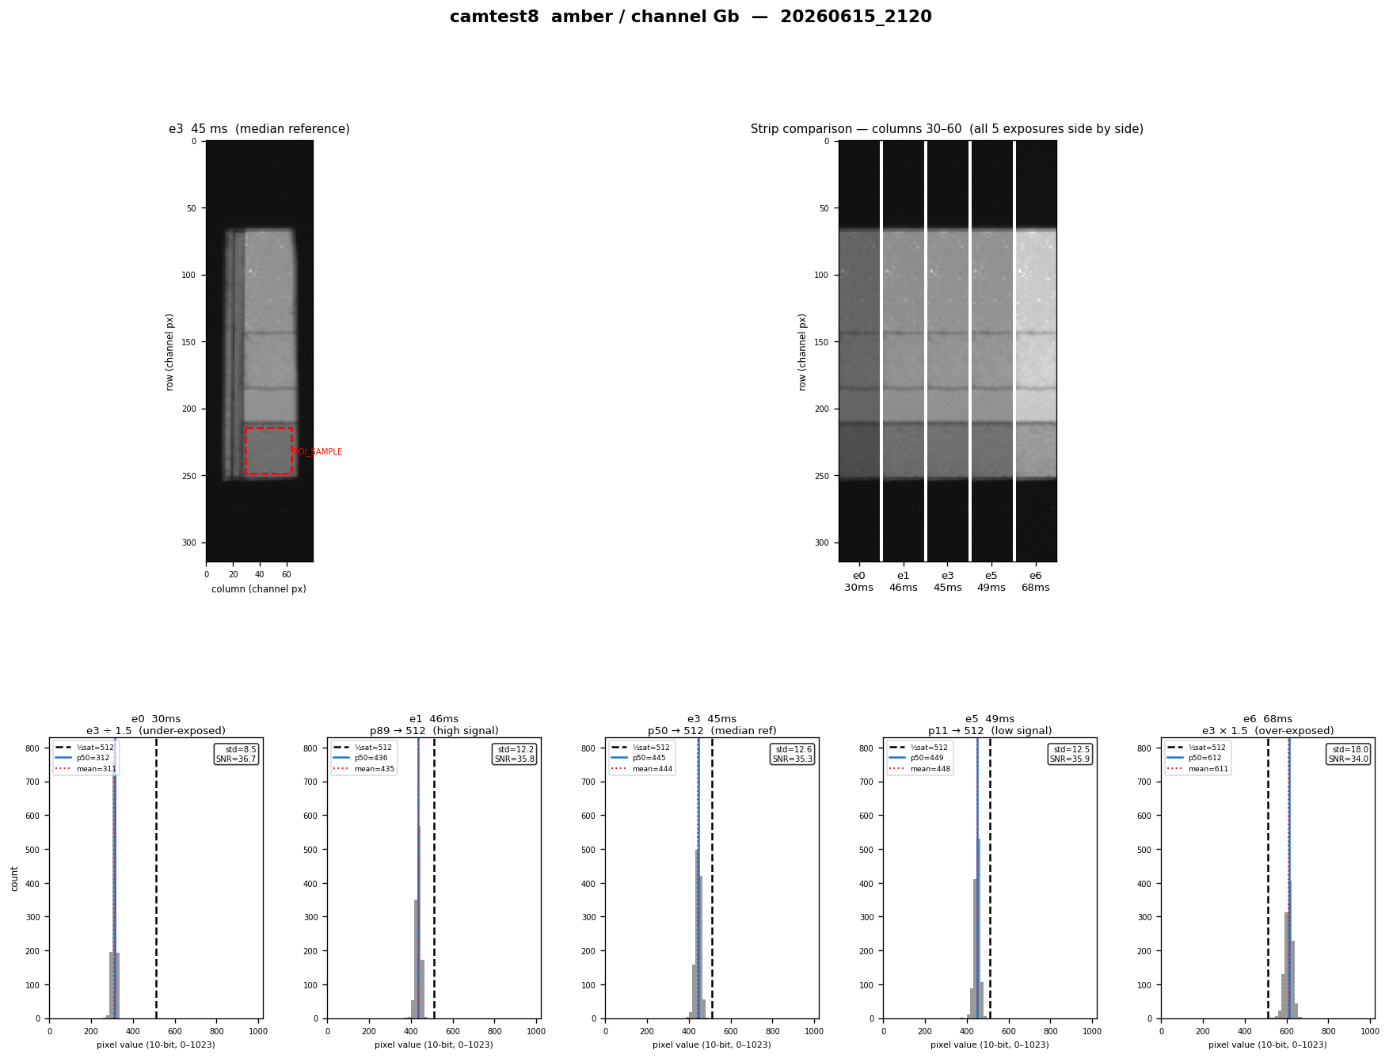
dev/captures/20260615_2120/analyze_amber_Gb.png
