panibillo/Colorimeter/dev/figs/flatfield_violet_after_ZP1009.png

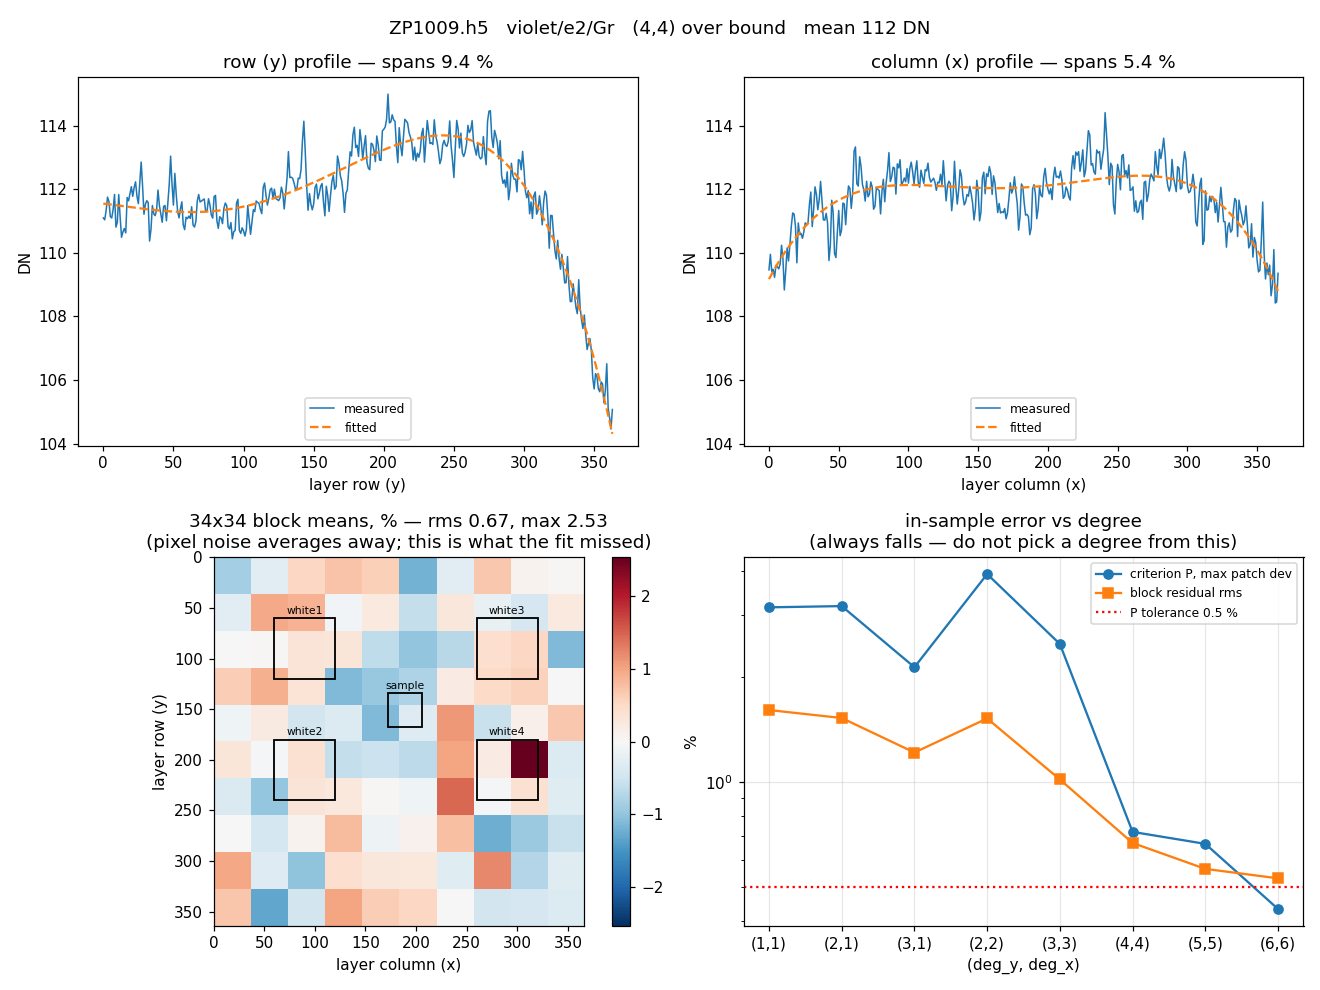
dev/figs/flatfield_violet_after_ZP1009.png
