panibillo/Colorimeter/dev/figs/flatfield_violet_before_ZP1004.png

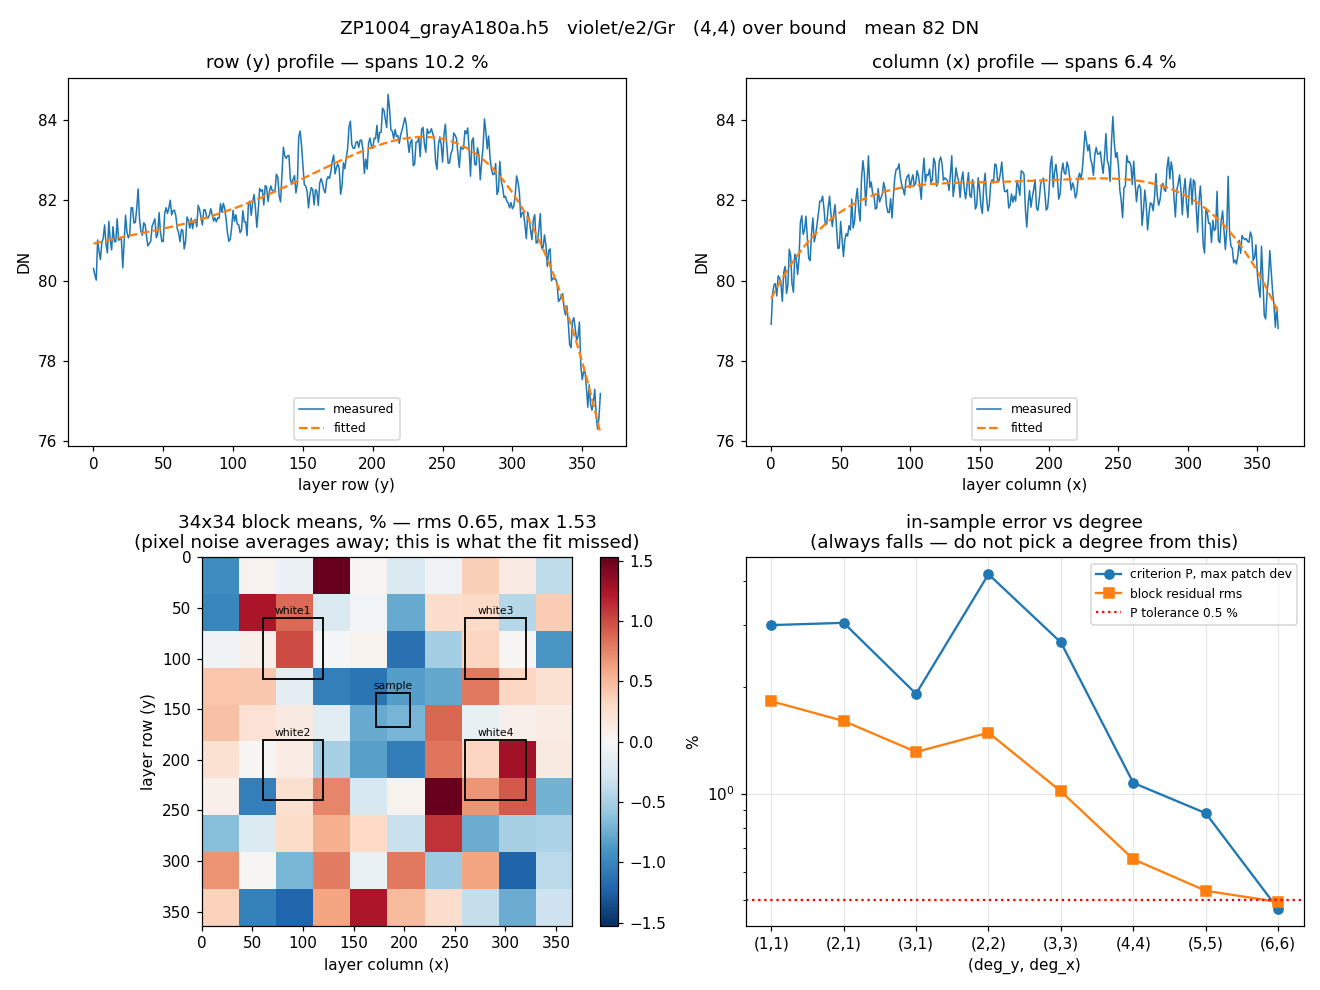
dev/figs/flatfield_violet_before_ZP1004.png
