panibillo/Colorimeter/dev/figs/mean_vs_SNR.png

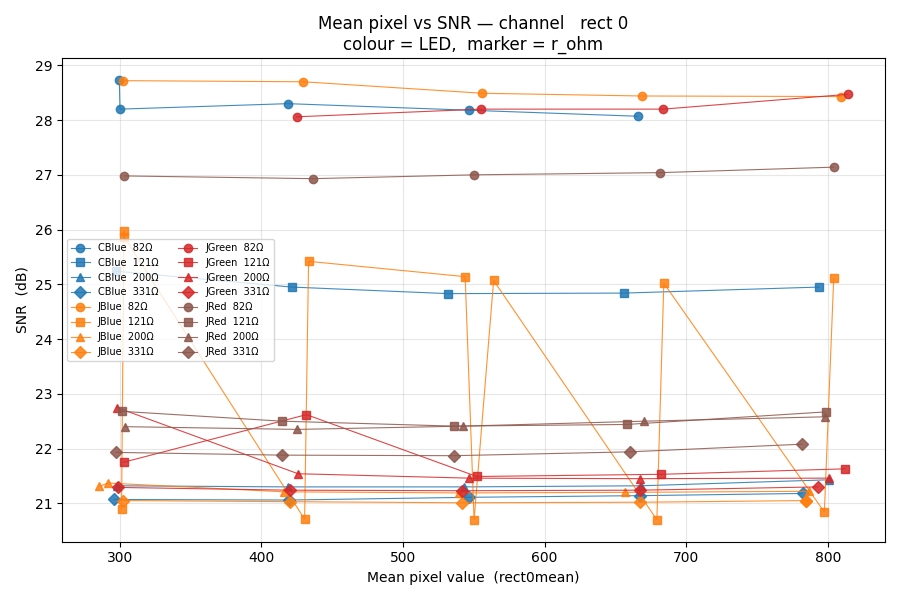
dev/figs/mean_vs_SNR.png
