panibillo/Colorimeter/dev/figs/mean_vs_SNRB.png

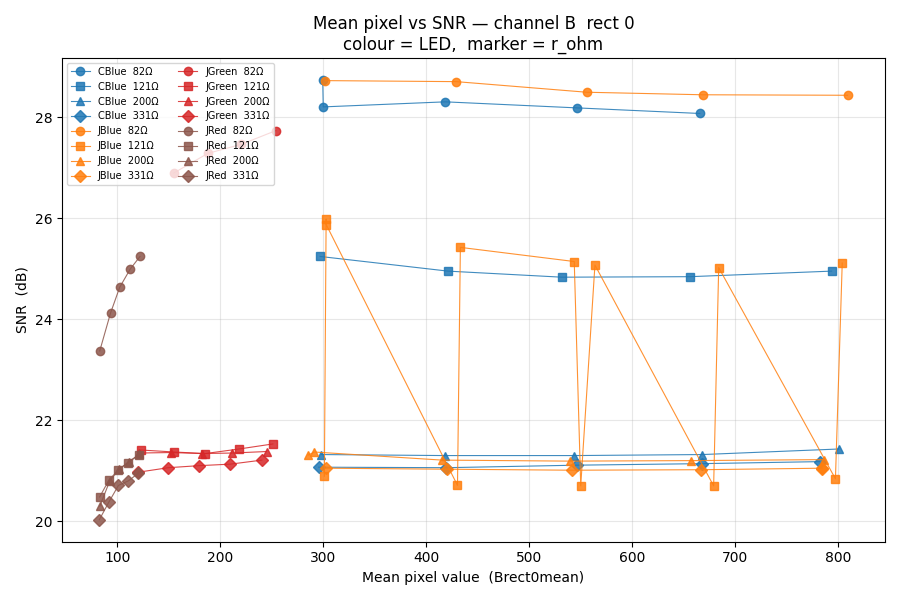
dev/figs/mean_vs_SNRB.png
