panibillo/Colorimeter/dev/figs/mean_vs_SNRGb.png

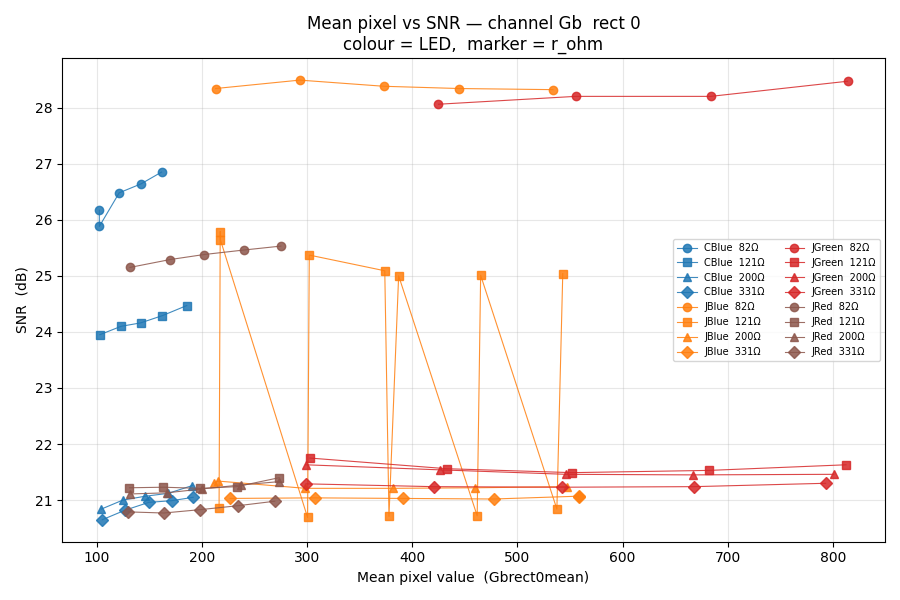
dev/figs/mean_vs_SNRGb.png
