panibillo/Colorimeter/dev/figs/mean_vs_SNRGr.png

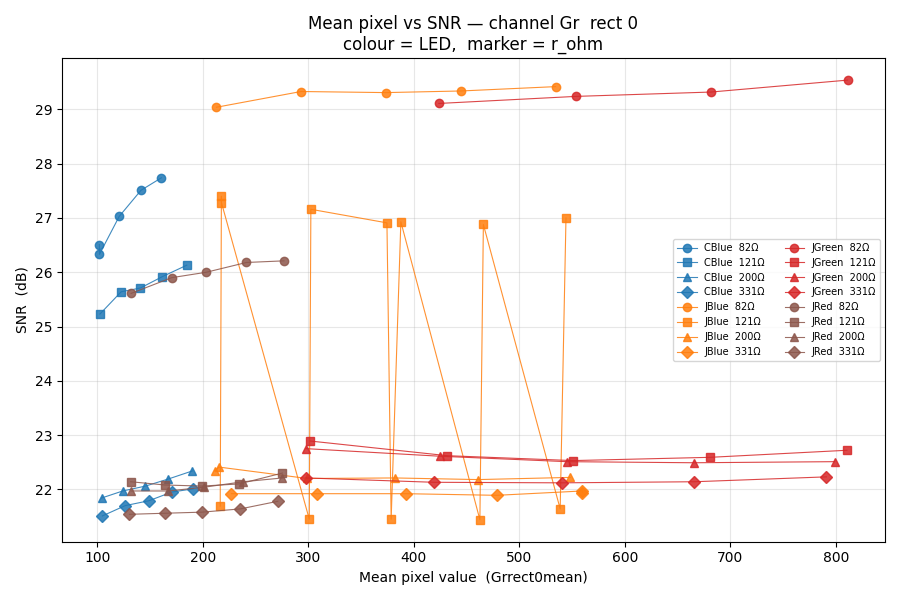
dev/figs/mean_vs_SNRGr.png
