panibillo/Colorimeter/dev/figs/mean_vs_SNRR.png

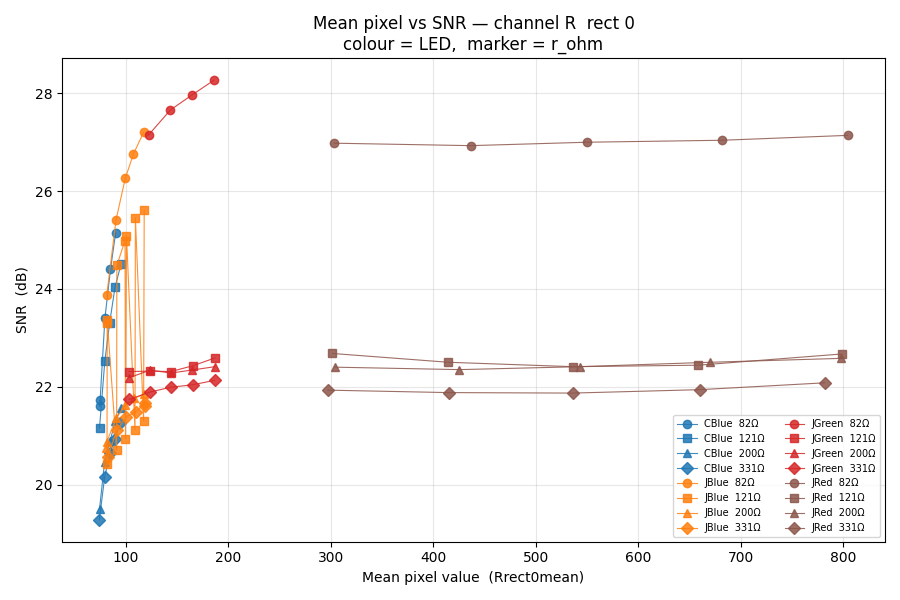
dev/figs/mean_vs_SNRR.png
