panibillo/Colorimeter/dev/figs/SNR_heatmap.png

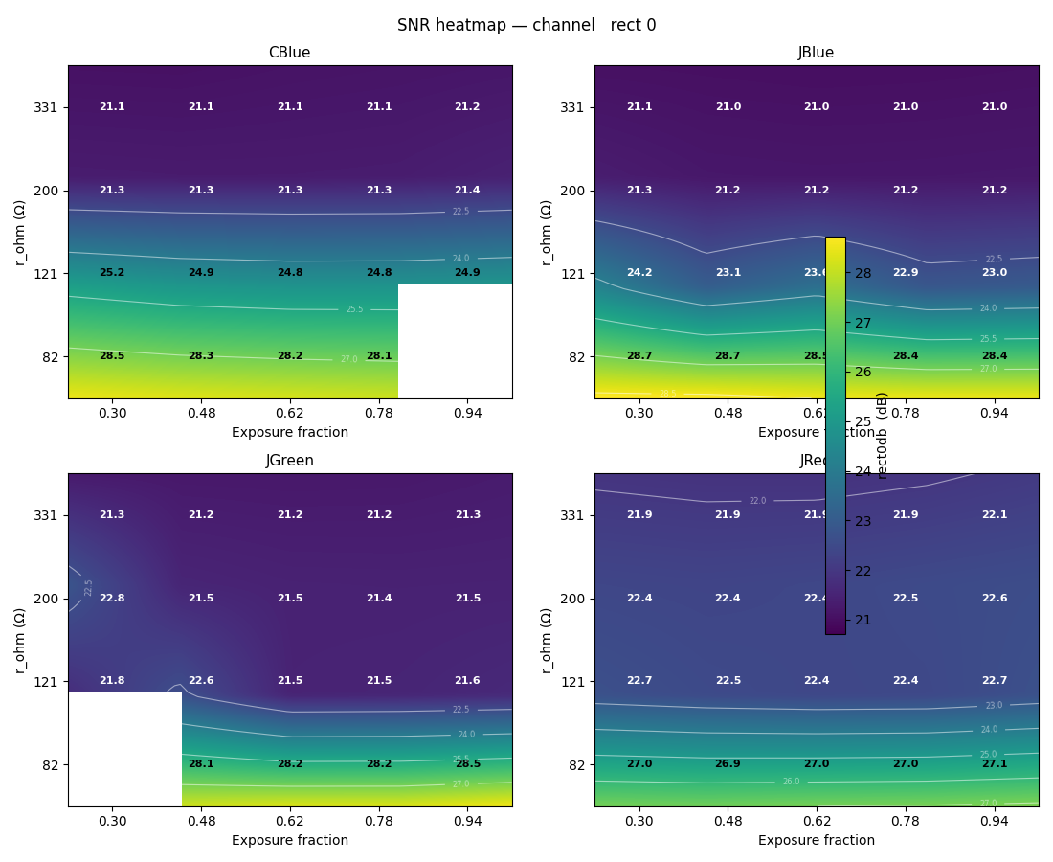
dev/figs/SNR_heatmap.png
