panibillo/Colorimeter/dev/figs/SNR_heatmapB.png

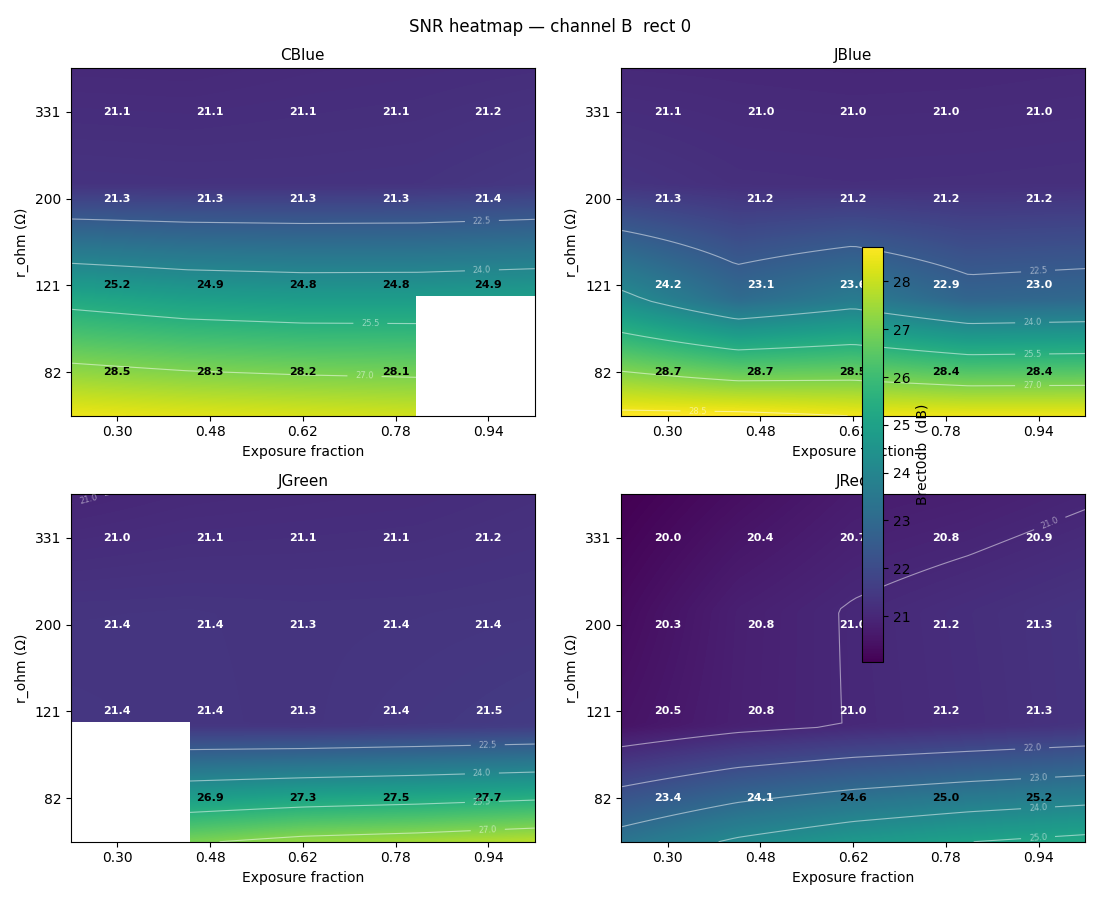
dev/figs/SNR_heatmapB.png
