panibillo/Colorimeter/dev/figs/SNR_heatmapGb.png

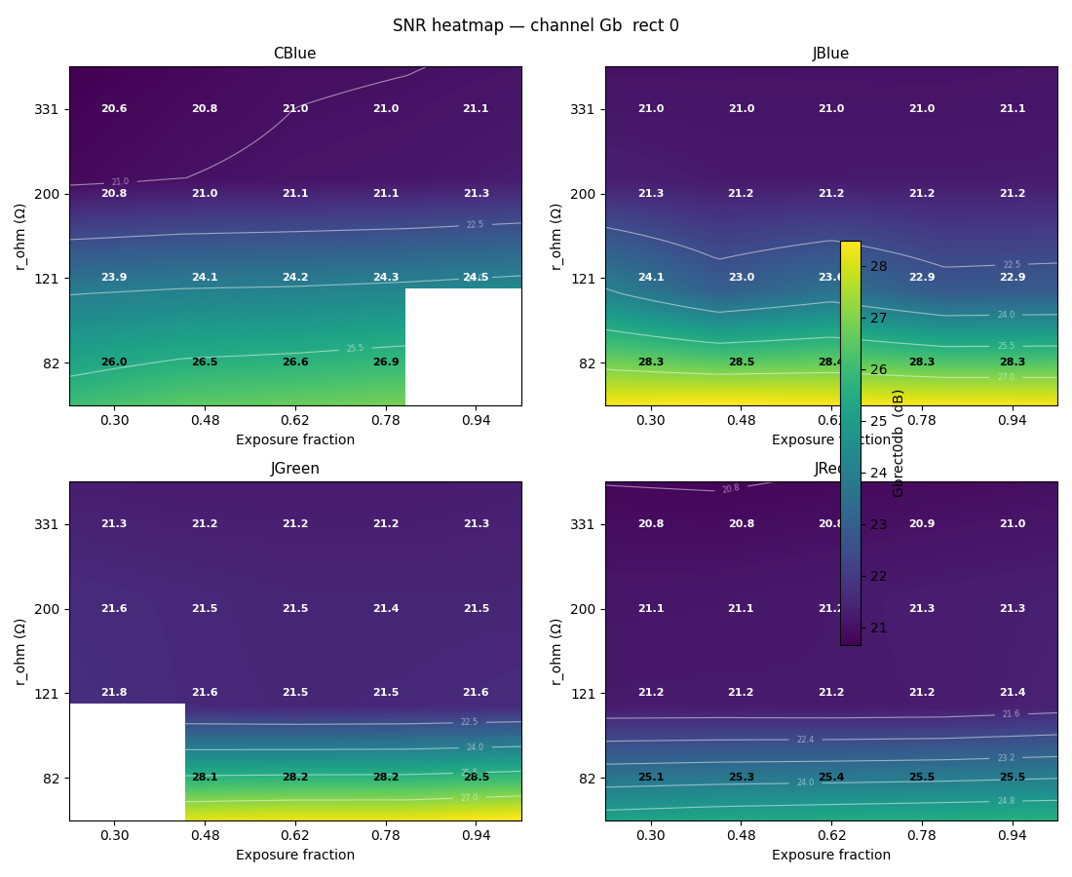
dev/figs/SNR_heatmapGb.png
