panibillo/Colorimeter/dev/figs/SNR_heatmapR.png

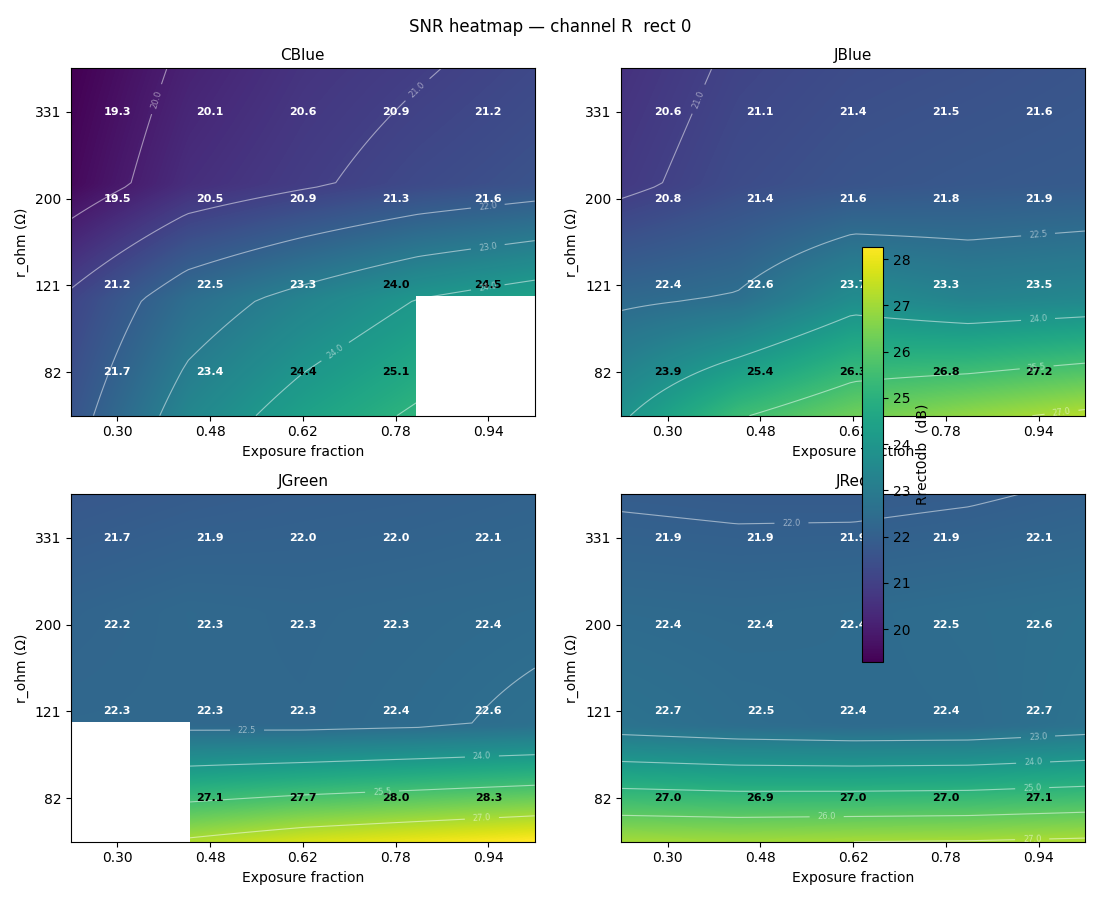
dev/figs/SNR_heatmapR.png
