panibillo/Colorimeter/dev/figs/SNR_lines.png

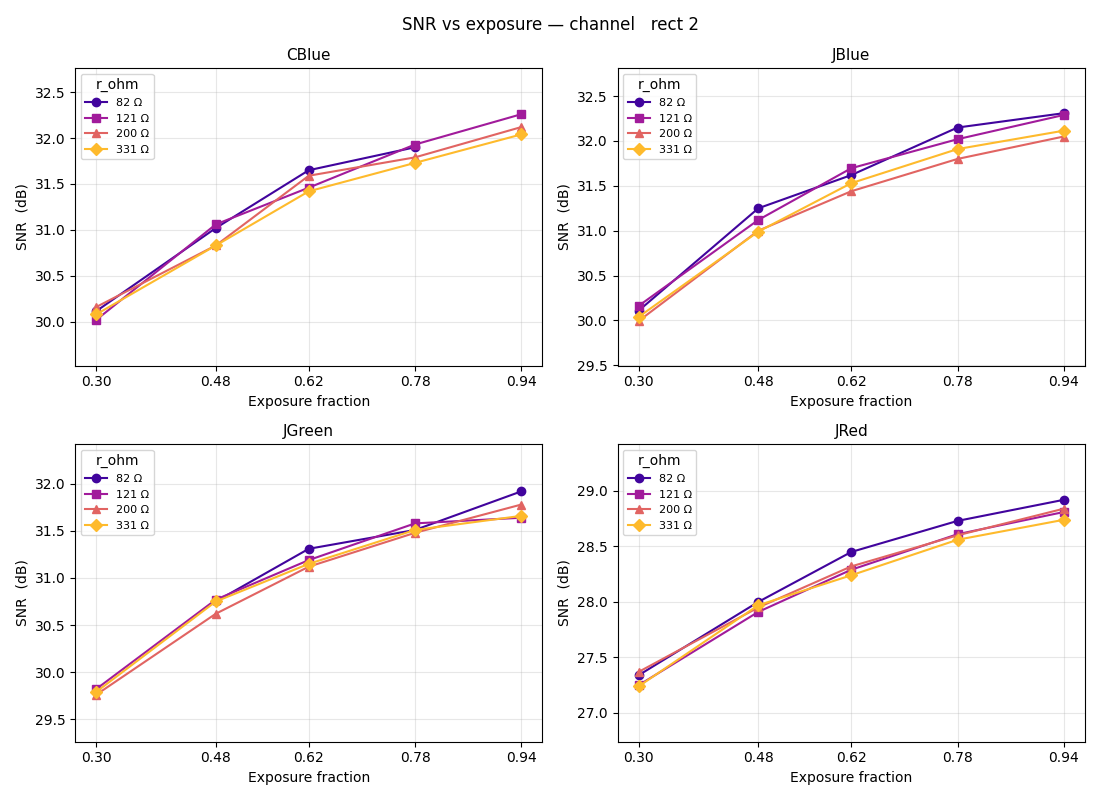
dev/figs/SNR_lines.png
