panibillo/Colorimeter/dev/figs/SNR_linesGb.png

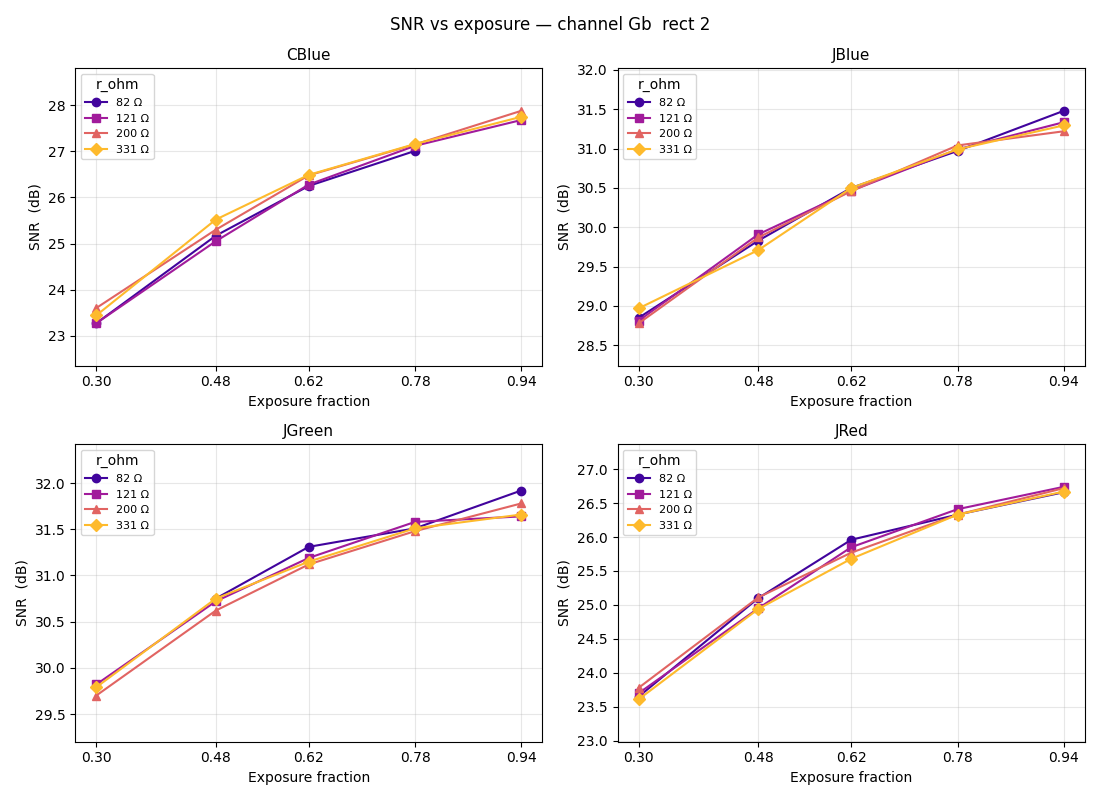
dev/figs/SNR_linesGb.png
