panibillo/Colorimeter/dev/figs/SNR_linesGr.png

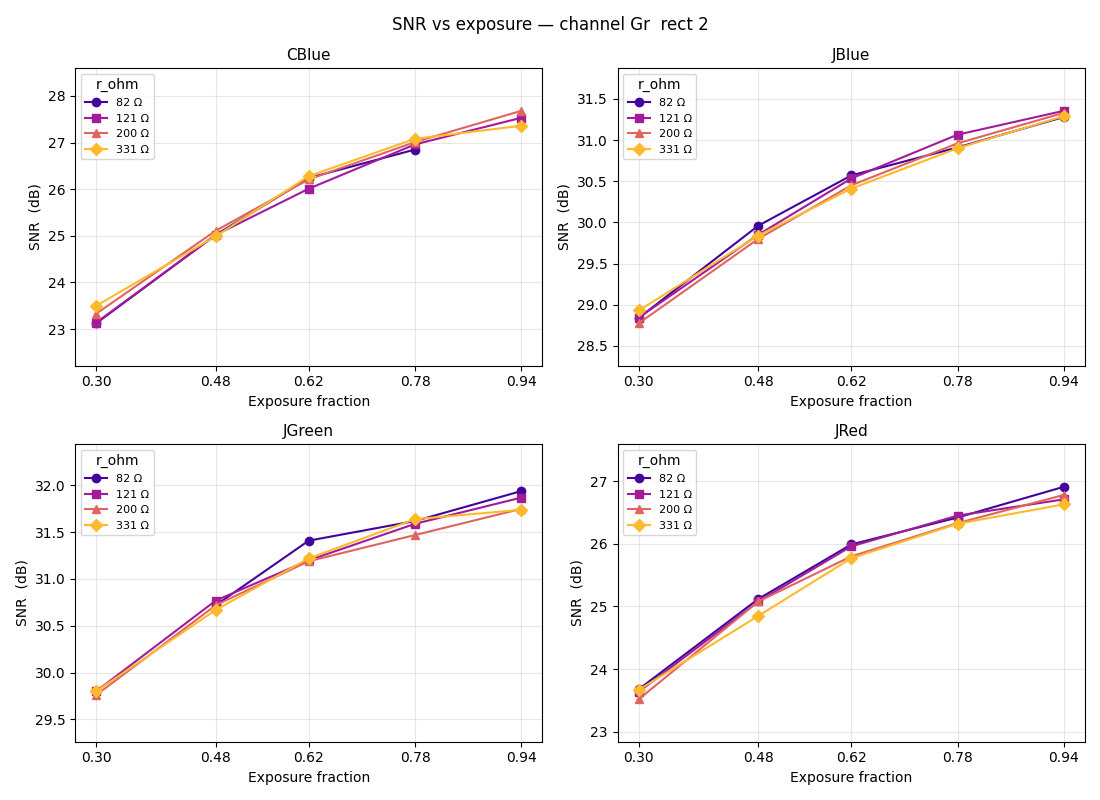
dev/figs/SNR_linesGr.png
