panibillo/Colorimeter/dev/figs/snr_vs_rect_expfrac.png

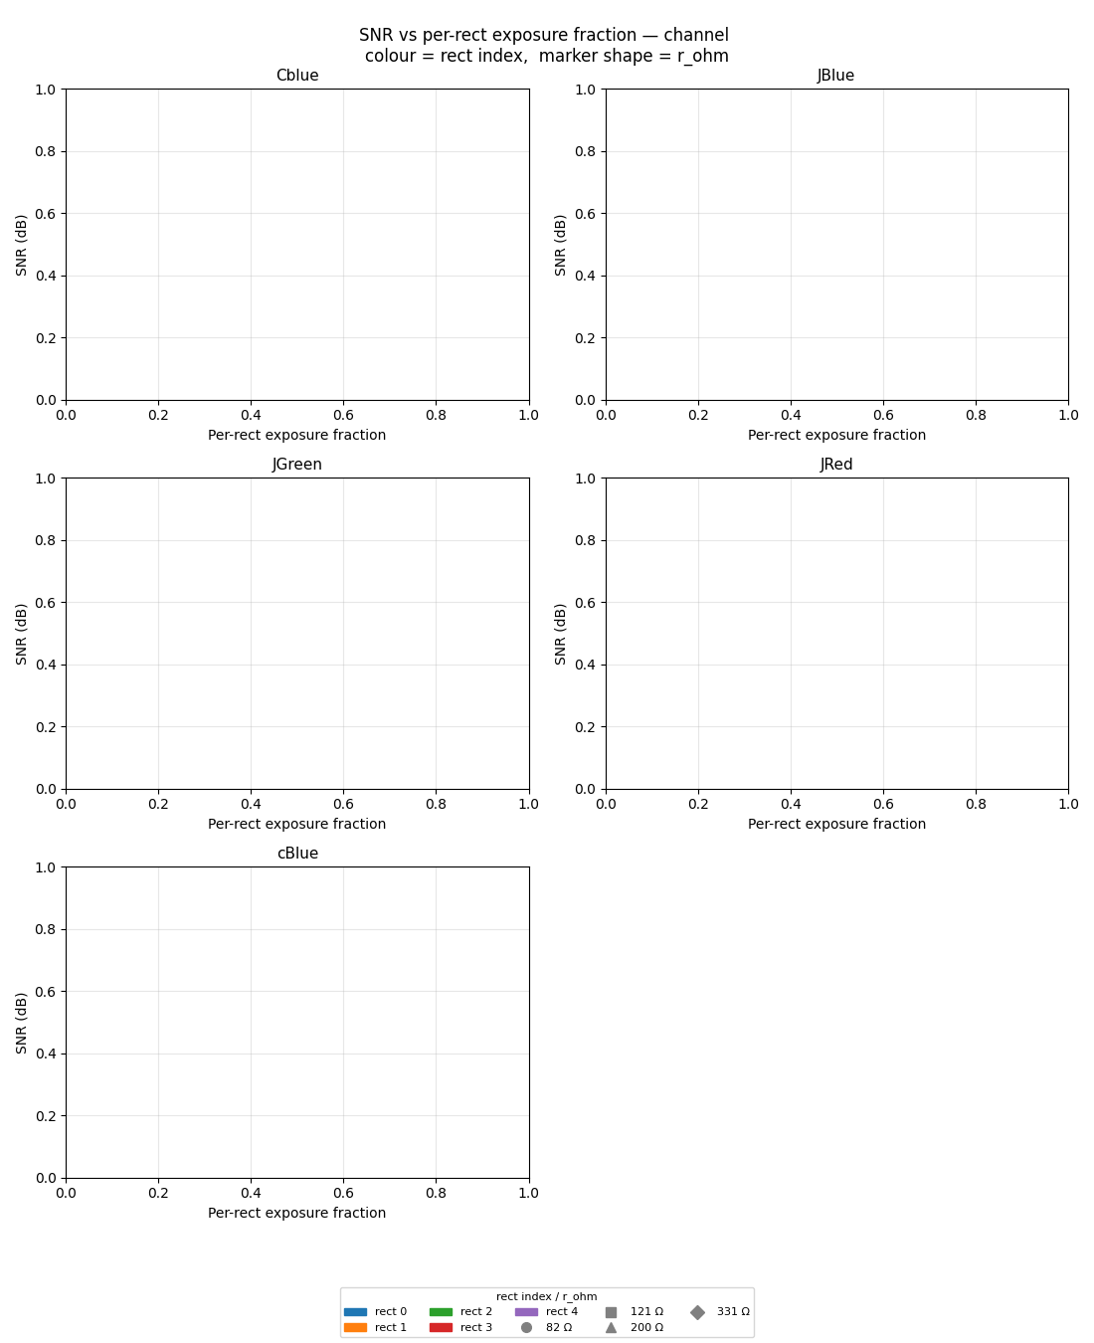
dev/figs/snr_vs_rect_expfrac.png
