panibillo/Colorimeter/dev/figs/snr_vs_rect_expfracB.png

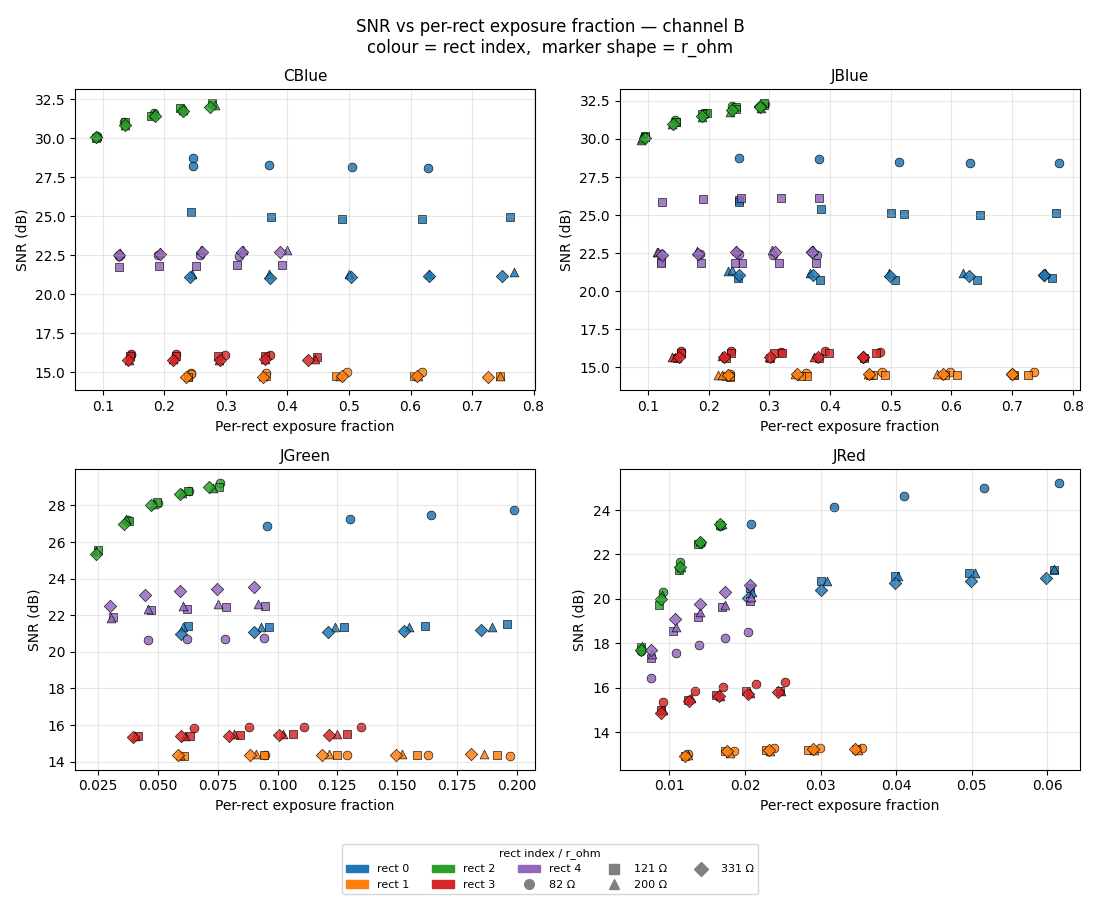
dev/figs/snr_vs_rect_expfracB.png
