panibillo/Colorimeter/dev/figs/snr_vs_rect_expfracGb.png

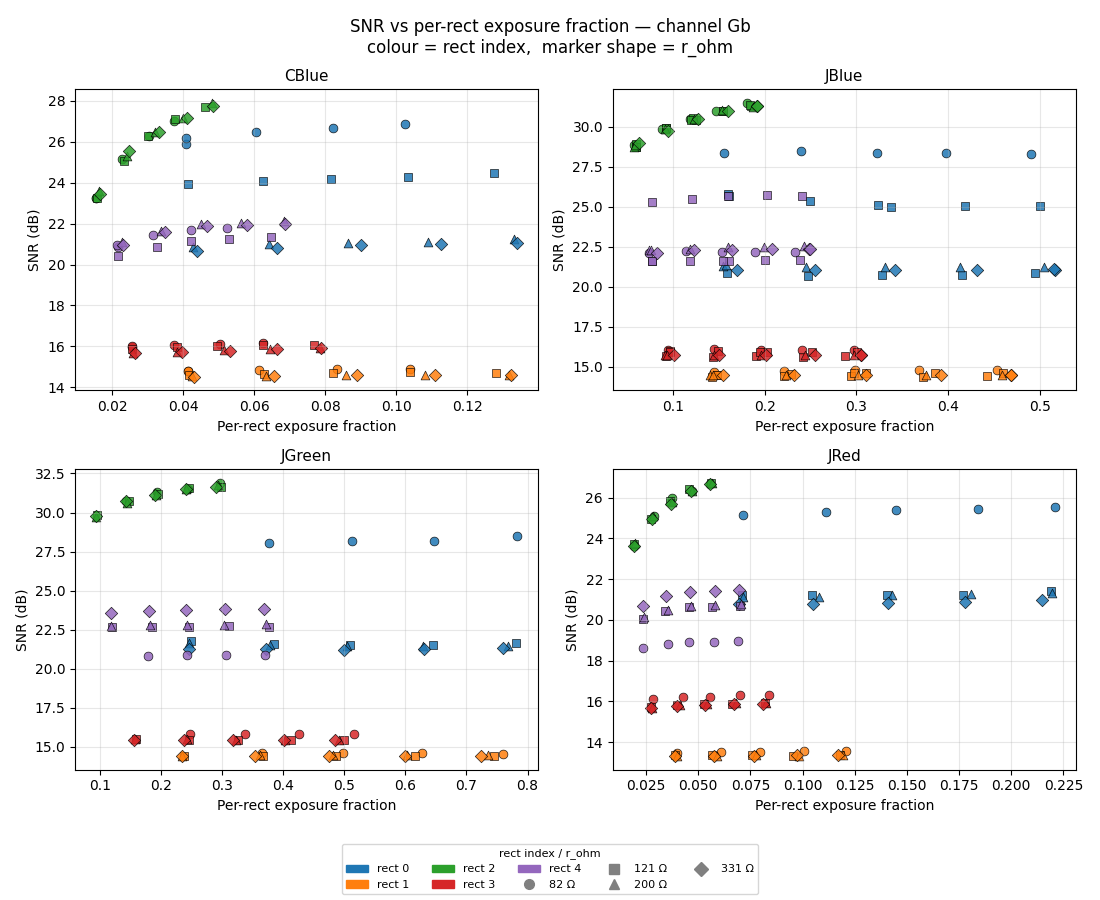
dev/figs/snr_vs_rect_expfracGb.png
