panibillo/Colorimeter/dev/figs/snr_vs_rect_expfracR.png

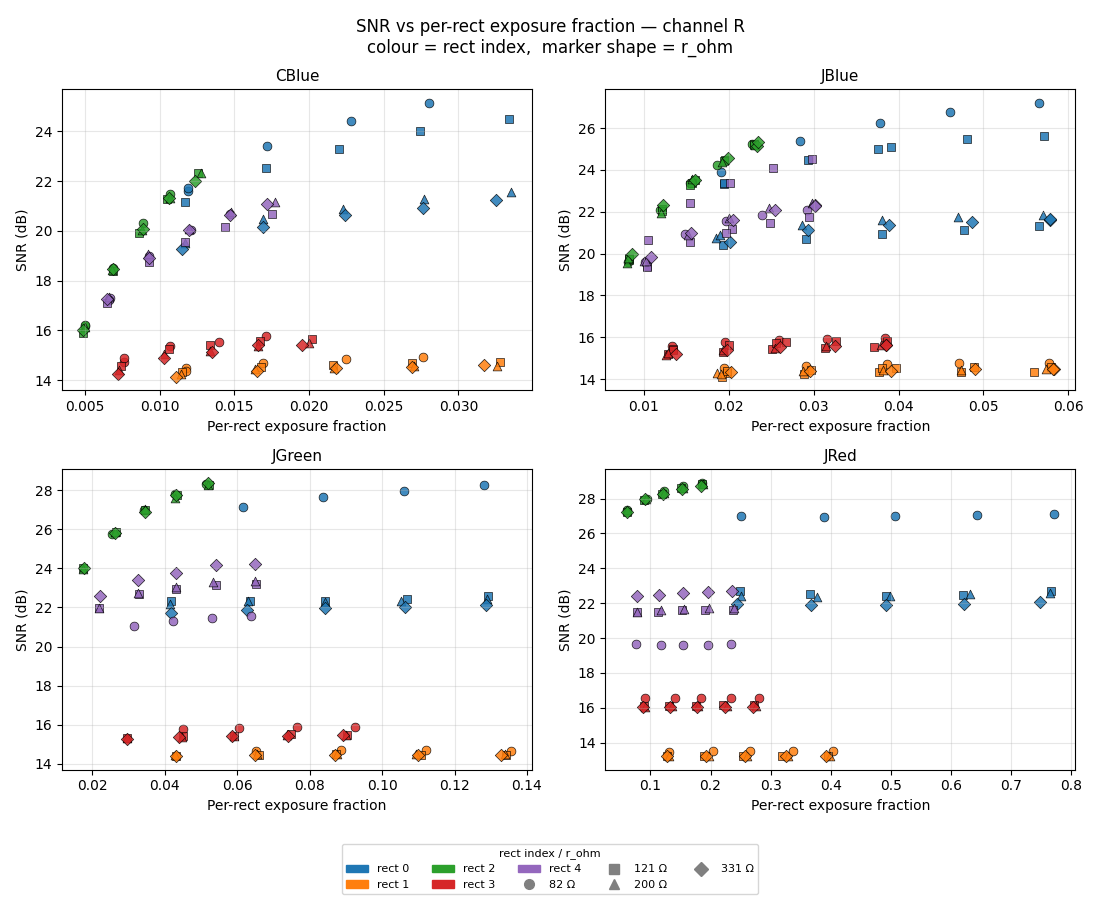
dev/figs/snr_vs_rect_expfracR.png
