panibillo/Colorimeter/dev/figs/TstAGYp_C72-00_0007_hbalance.png

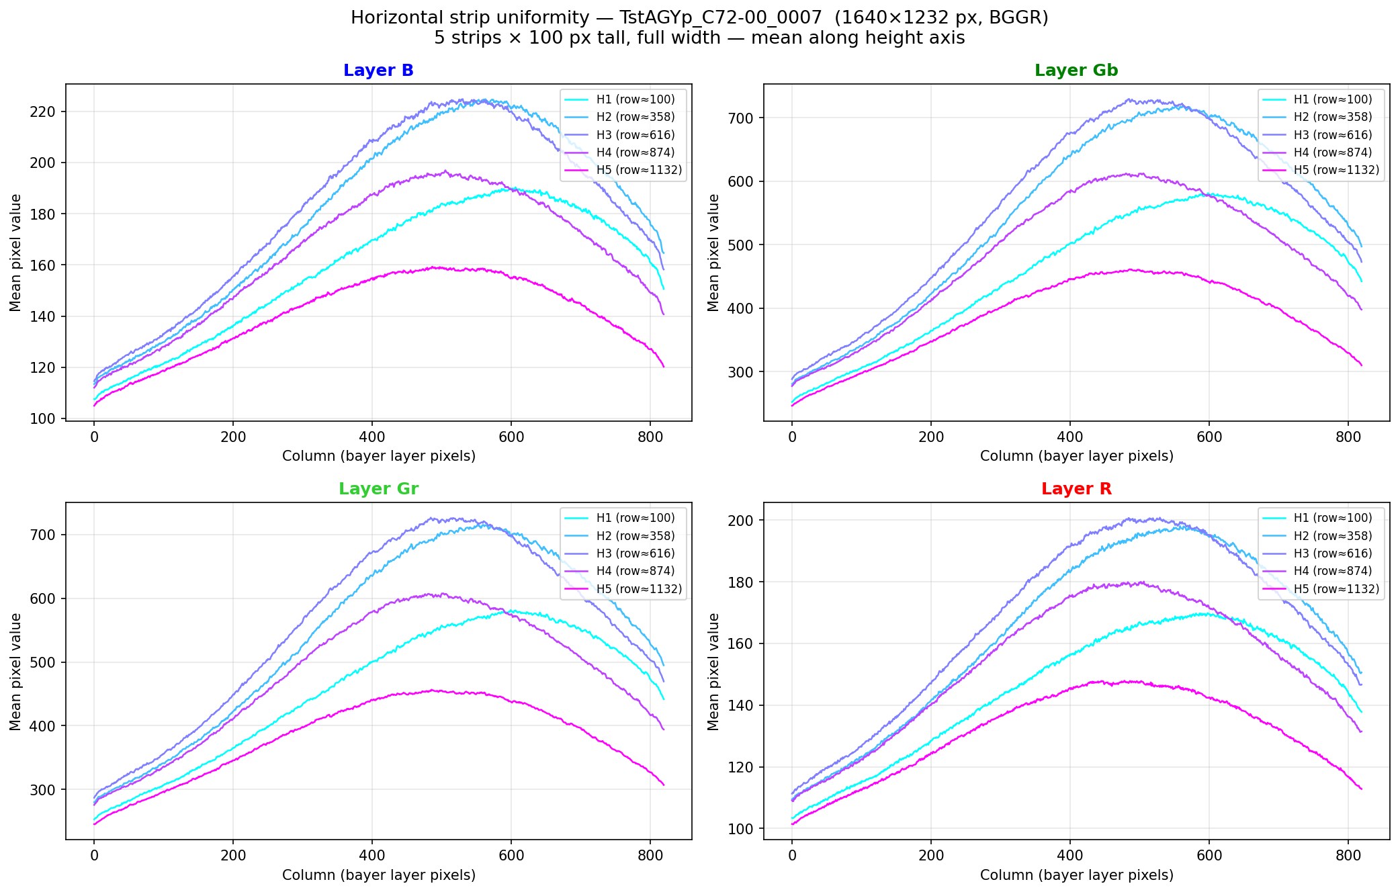
dev/figs/TstAGYp_C72-00_0007_hbalance.png
