panibillo/Colorimeter/dev/figs/TstAGYp_C72-00_0007_vbalance.png

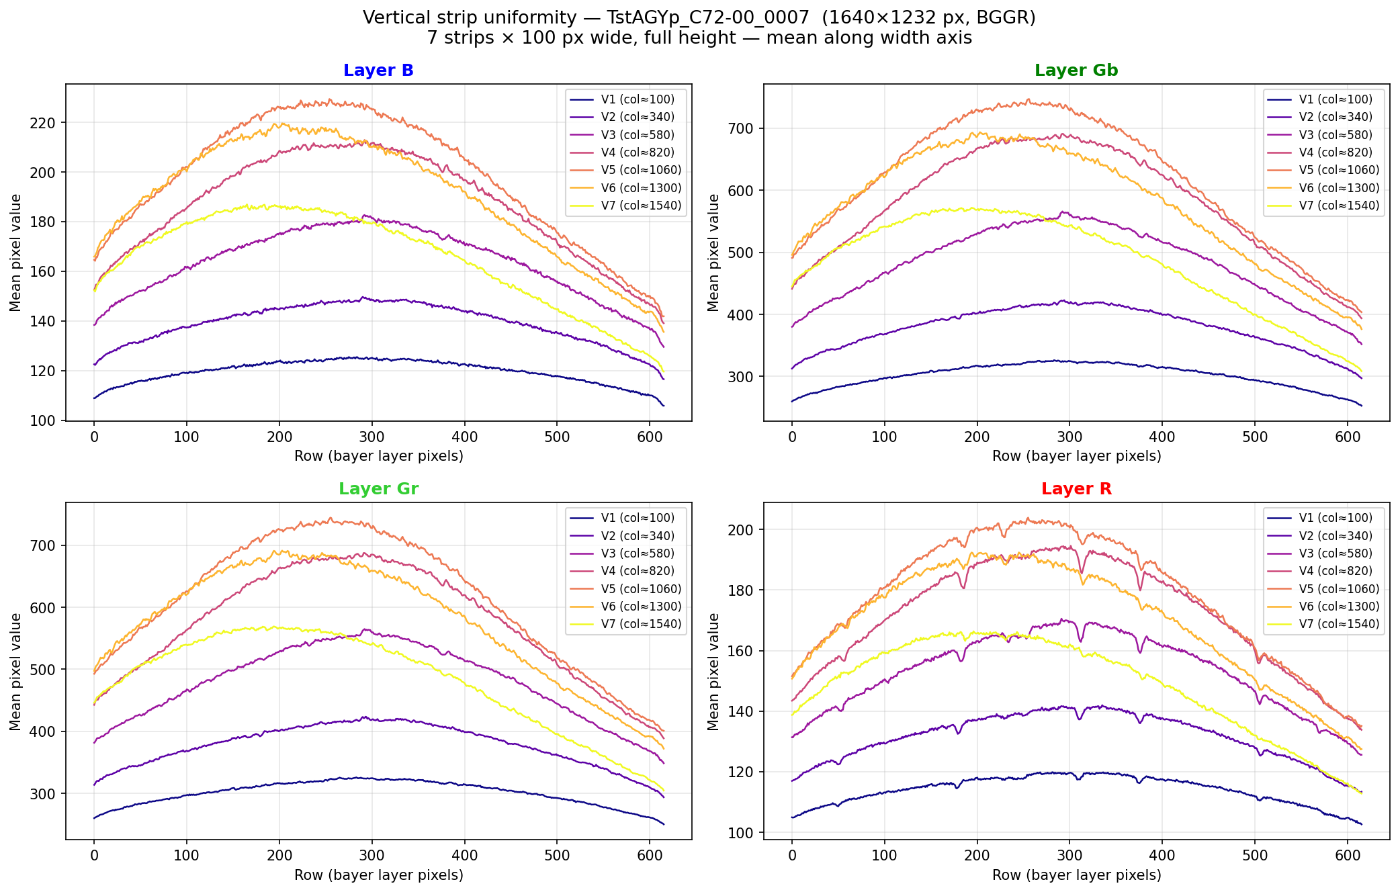
dev/figs/TstAGYp_C72-00_0007_vbalance.png
