panibillo/Colorimeter/dev/figs/TstAGYp_C72-35_0006_contours.png

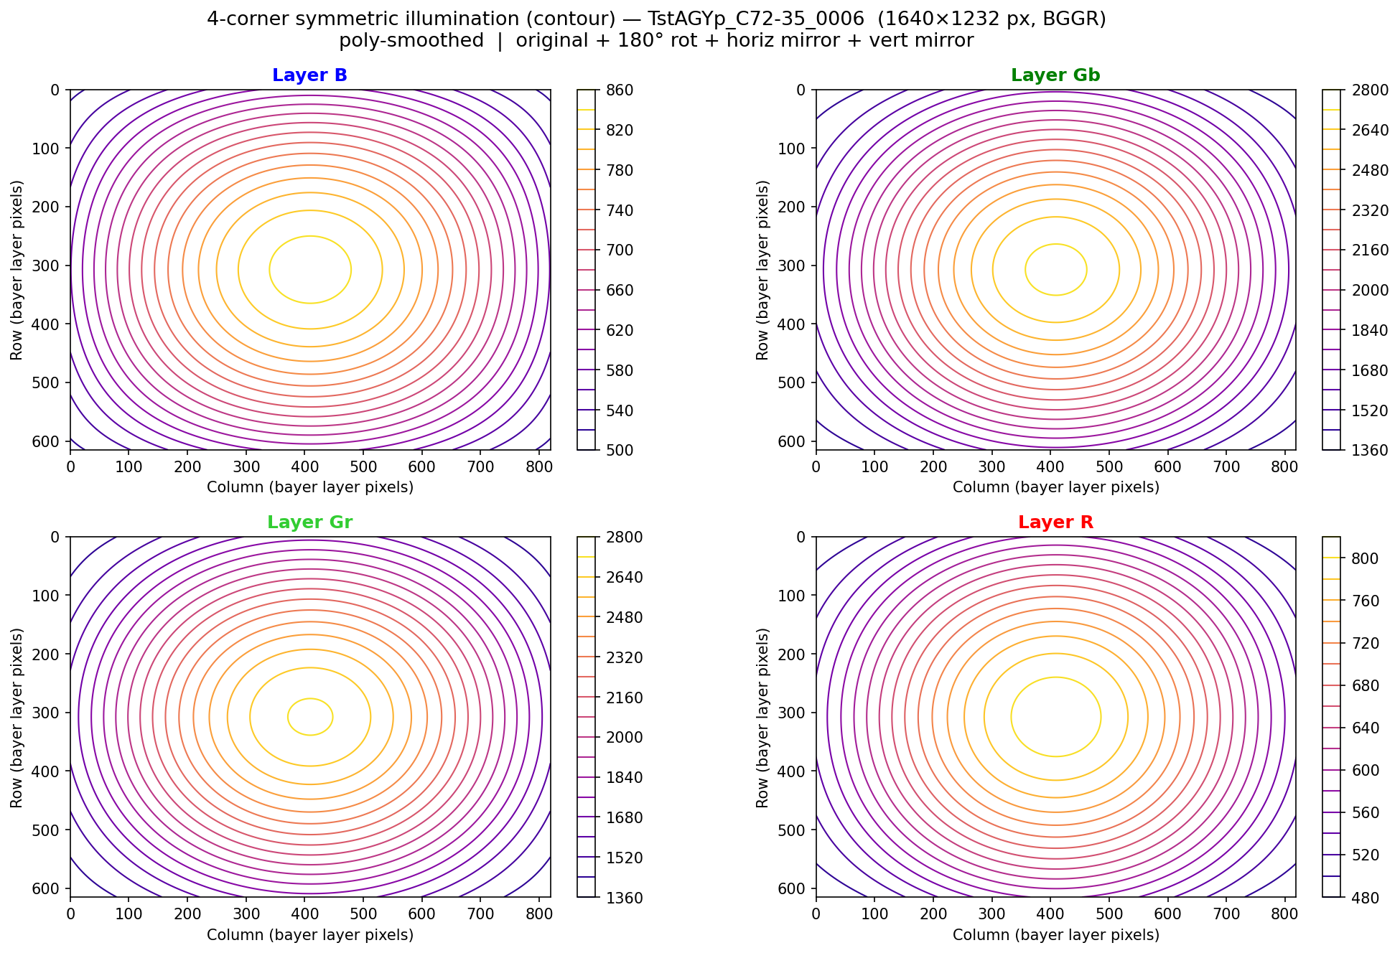
dev/figs/TstAGYp_C72-35_0006_contours.png
