panibillo/Colorimeter/dev/figs/TstAGYp_C72-35_0006_vbalance.png

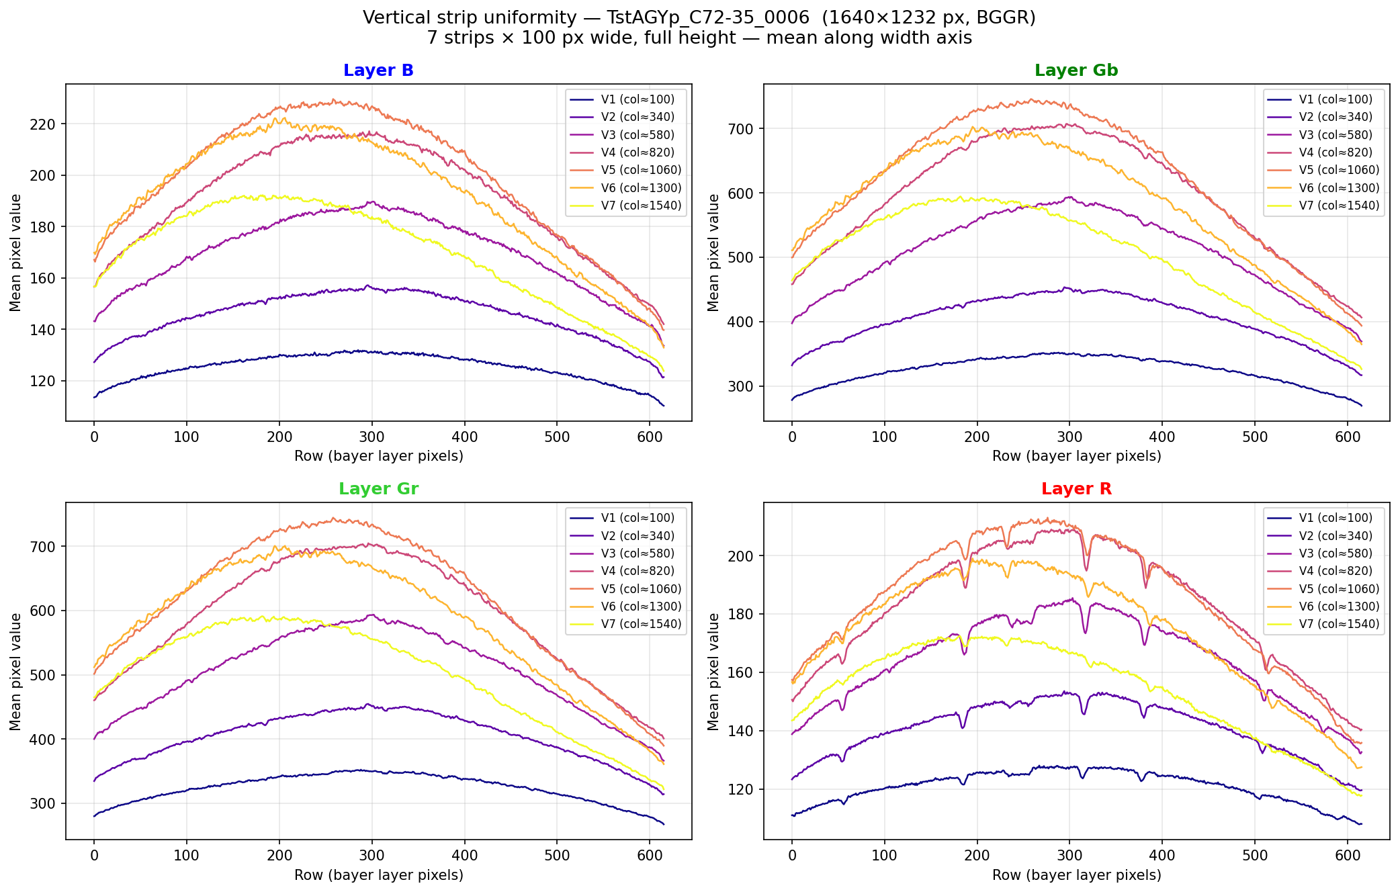
dev/figs/TstAGYp_C72-35_0006_vbalance.png
