panibillo/Colorimeter/dev/figs/TstBGYp_K51--5-10_0014_contours.png

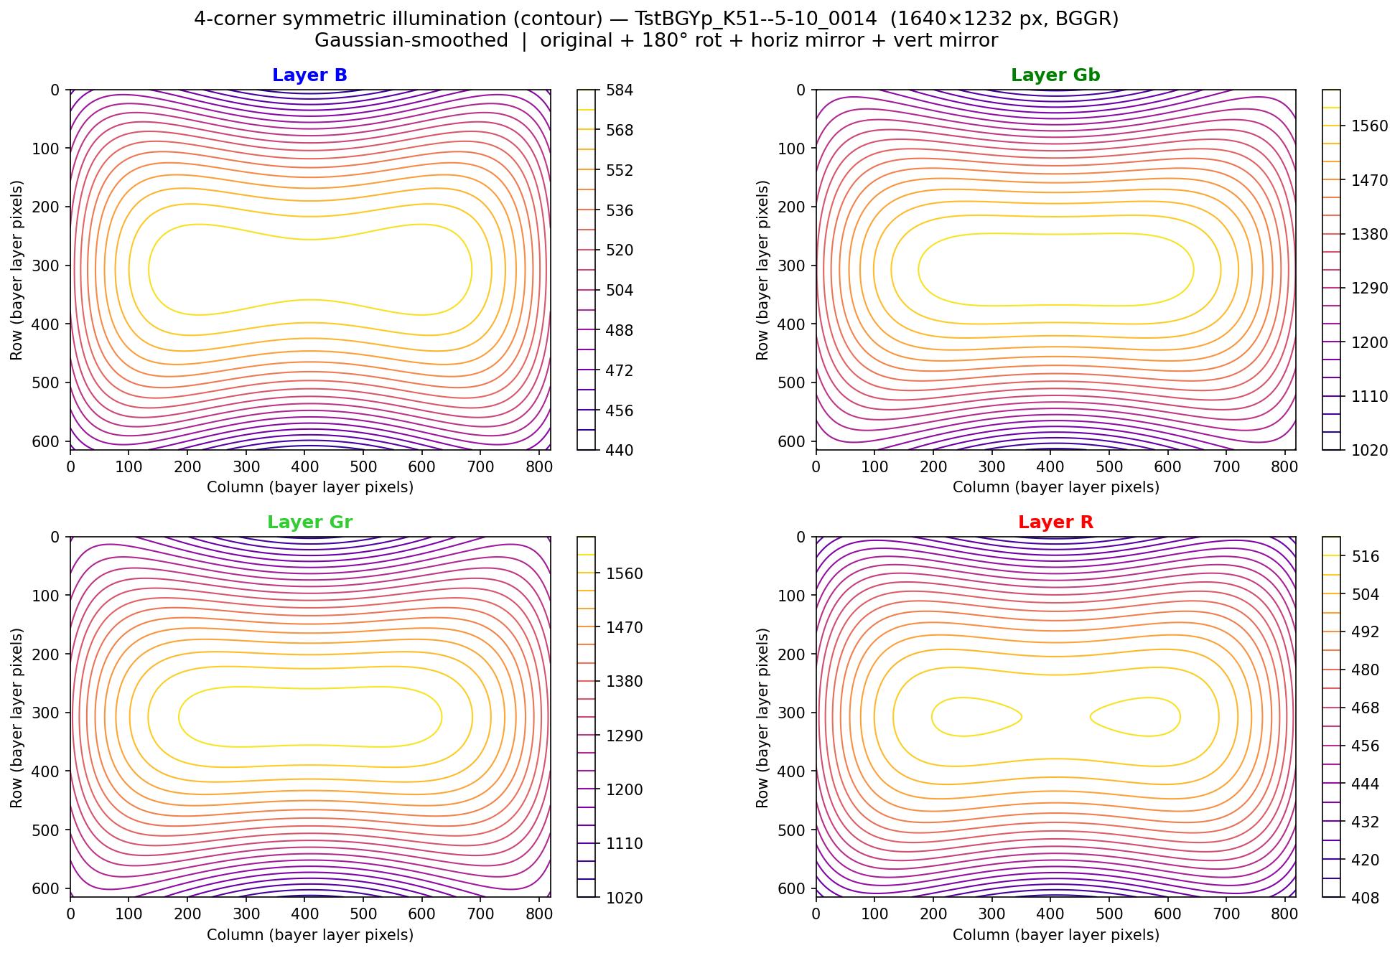
dev/figs/TstBGYp_K51--5-10_0014_contours.png
