panibillo/Colorimeter/dev/figs/TstBGYp_K71--5-10_0012_contours.png

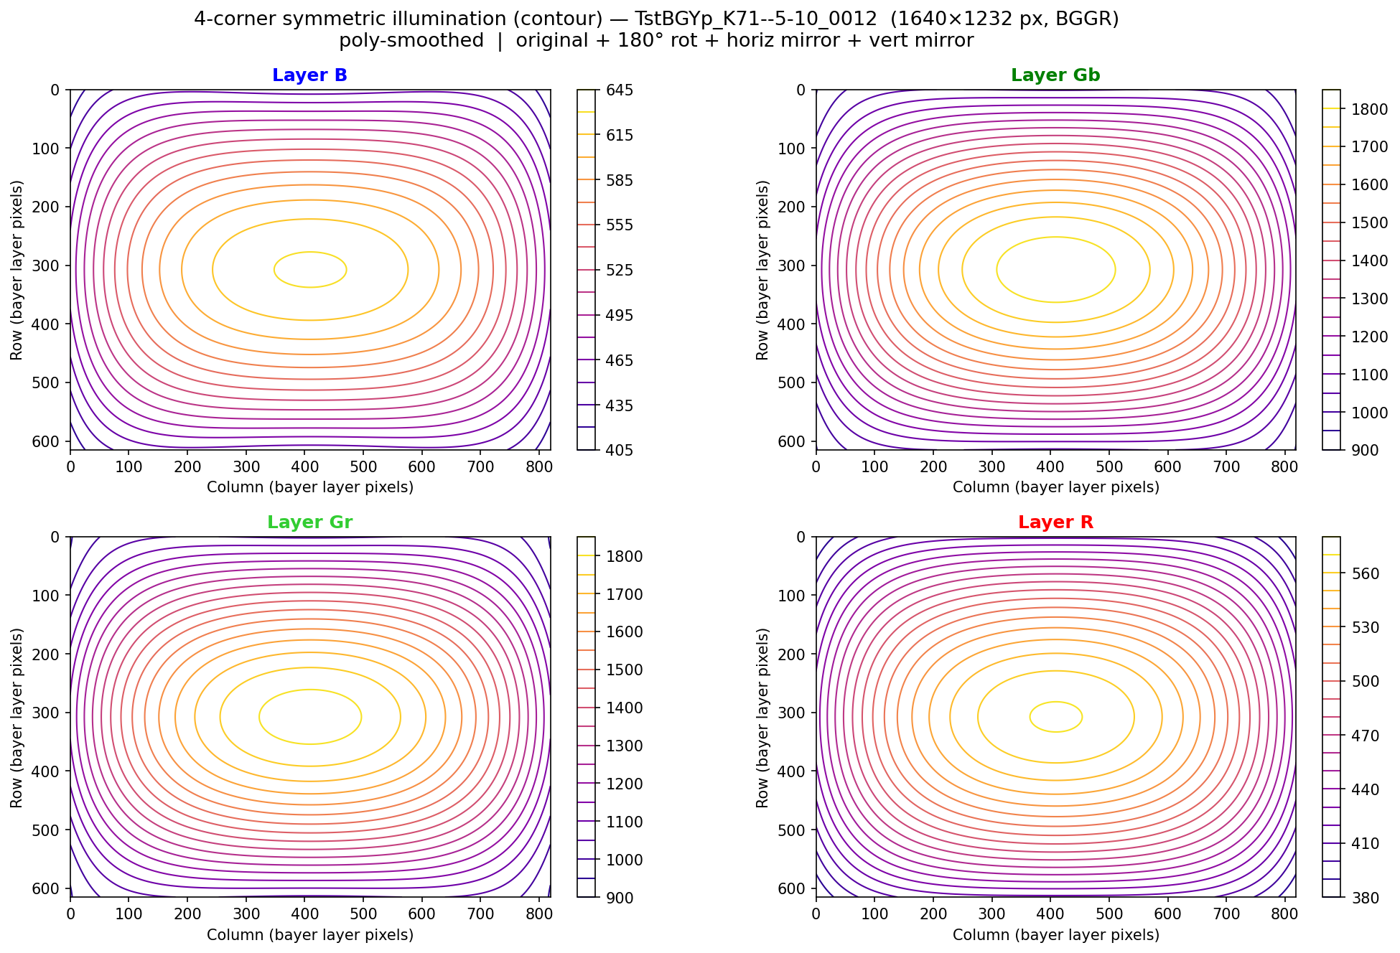
dev/figs/TstBGYp_K71--5-10_0012_contours.png
