panibillo/Colorimeter/dev/figs/TstBGYp_K71--5-10_0012_hbalance.png

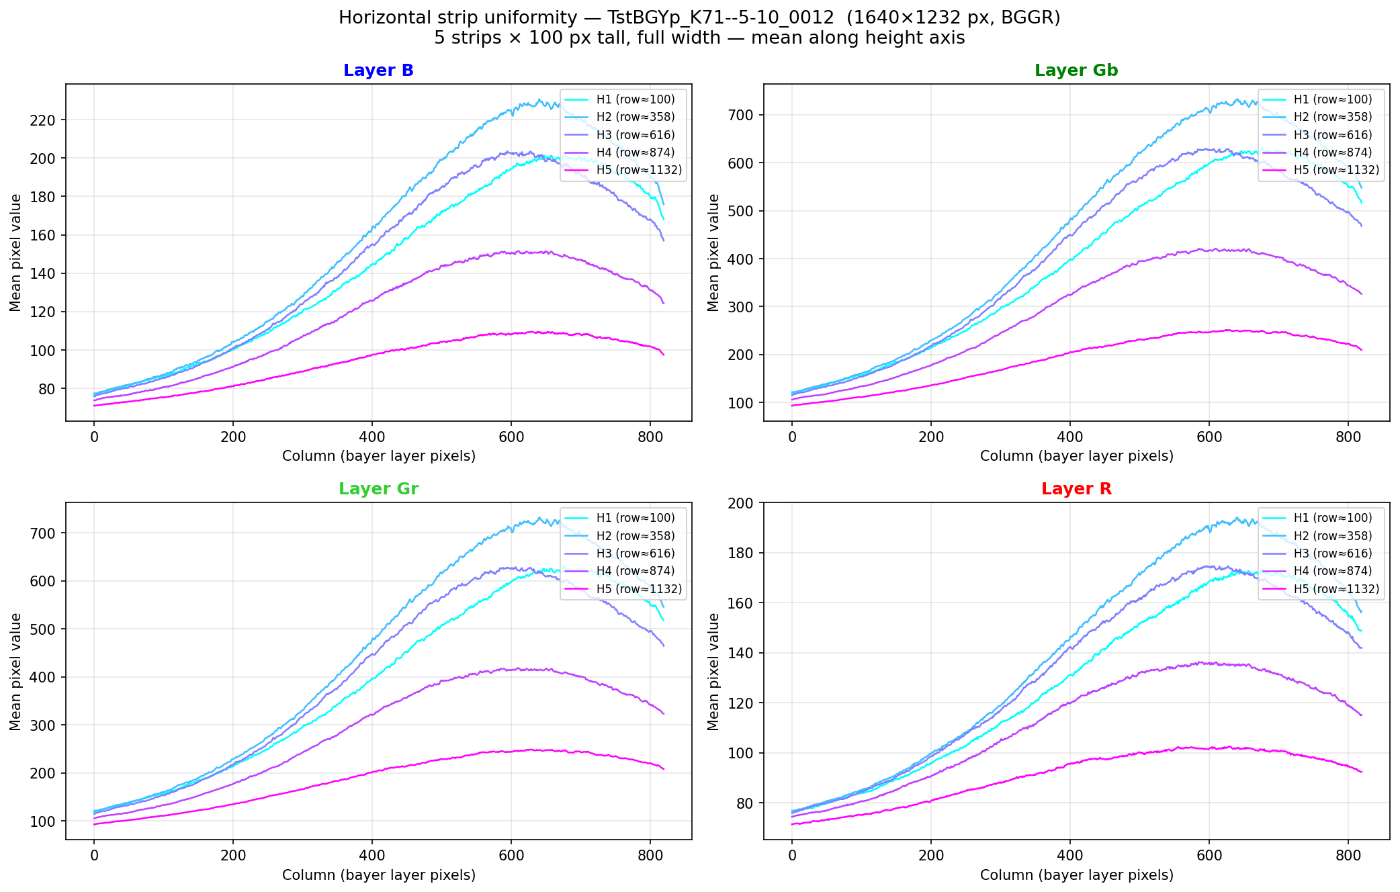
dev/figs/TstBGYp_K71--5-10_0012_hbalance.png
