panibillo/Colorimeter/dev/figs/TstBGYp_K71--5-10_0012_vbalance.png

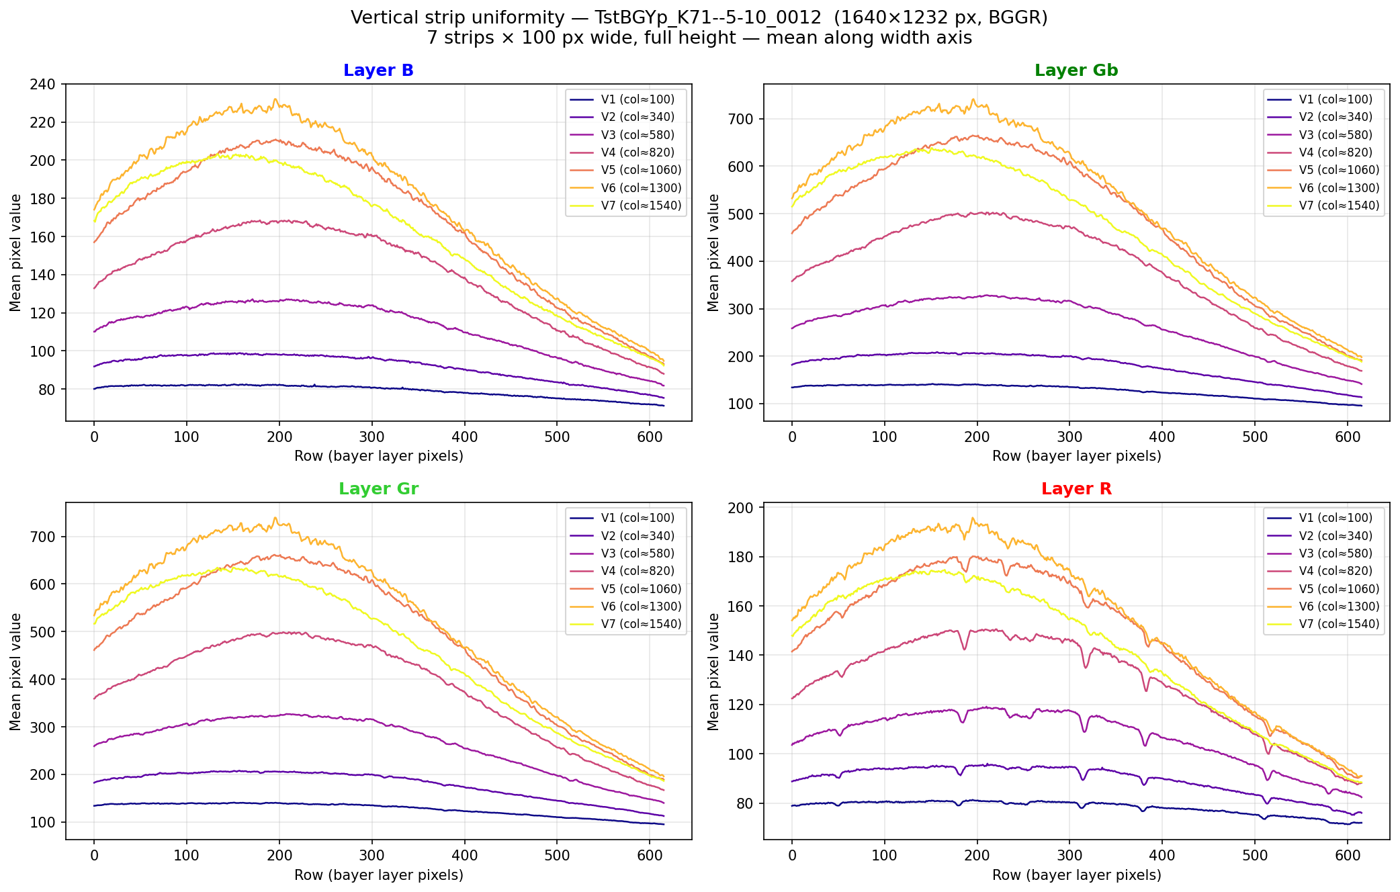
dev/figs/TstBGYp_K71--5-10_0012_vbalance.png
