panibillo/Colorimeter/dev/figs/TstBGYp_K71--5_0011_hbalance.png

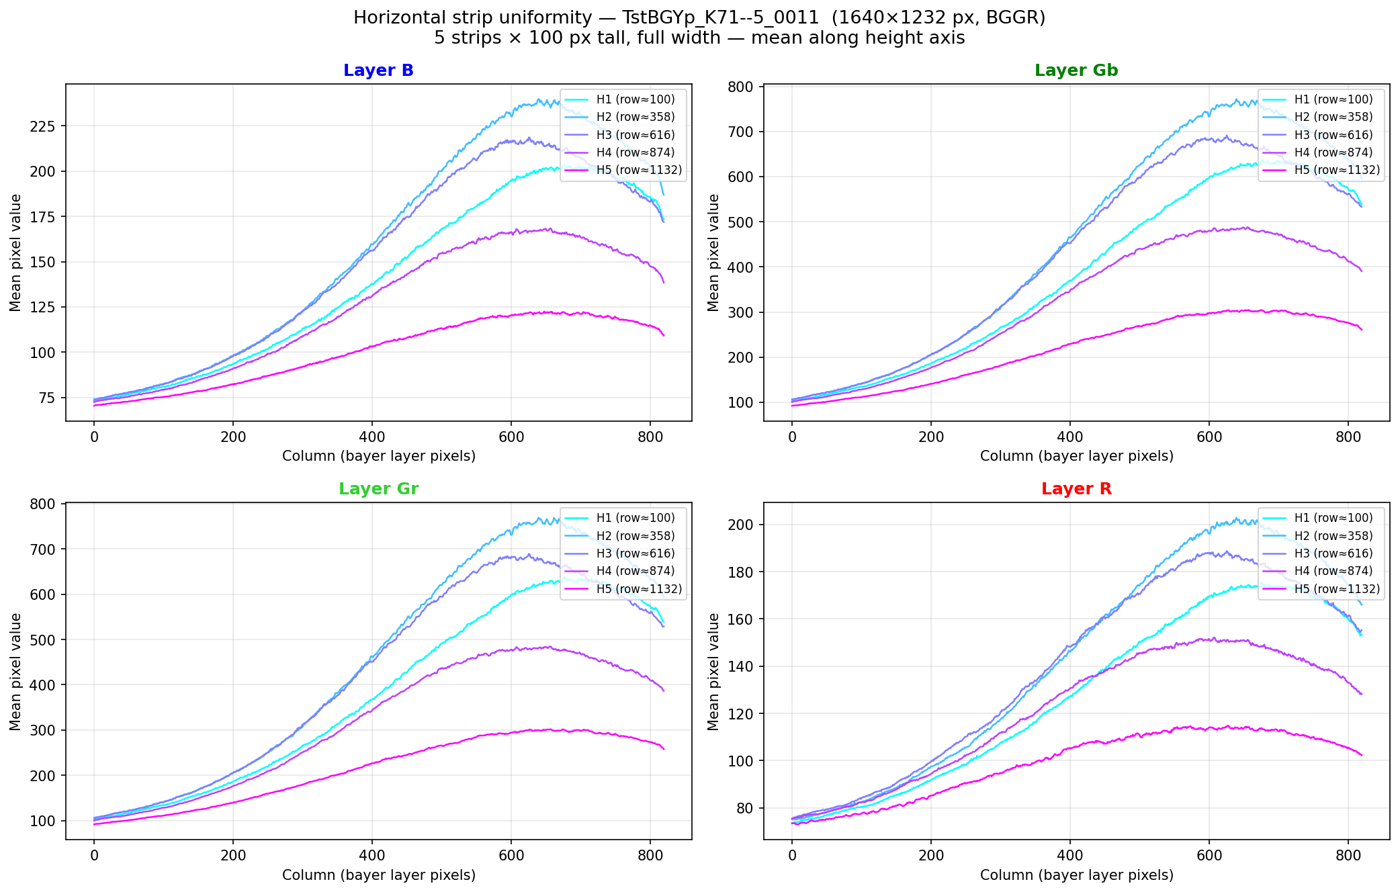
dev/figs/TstBGYp_K71--5_0011_hbalance.png
