panibillo/Colorimeter/dev/figs/TstBGYp_K71--5_0011_vbalance.png

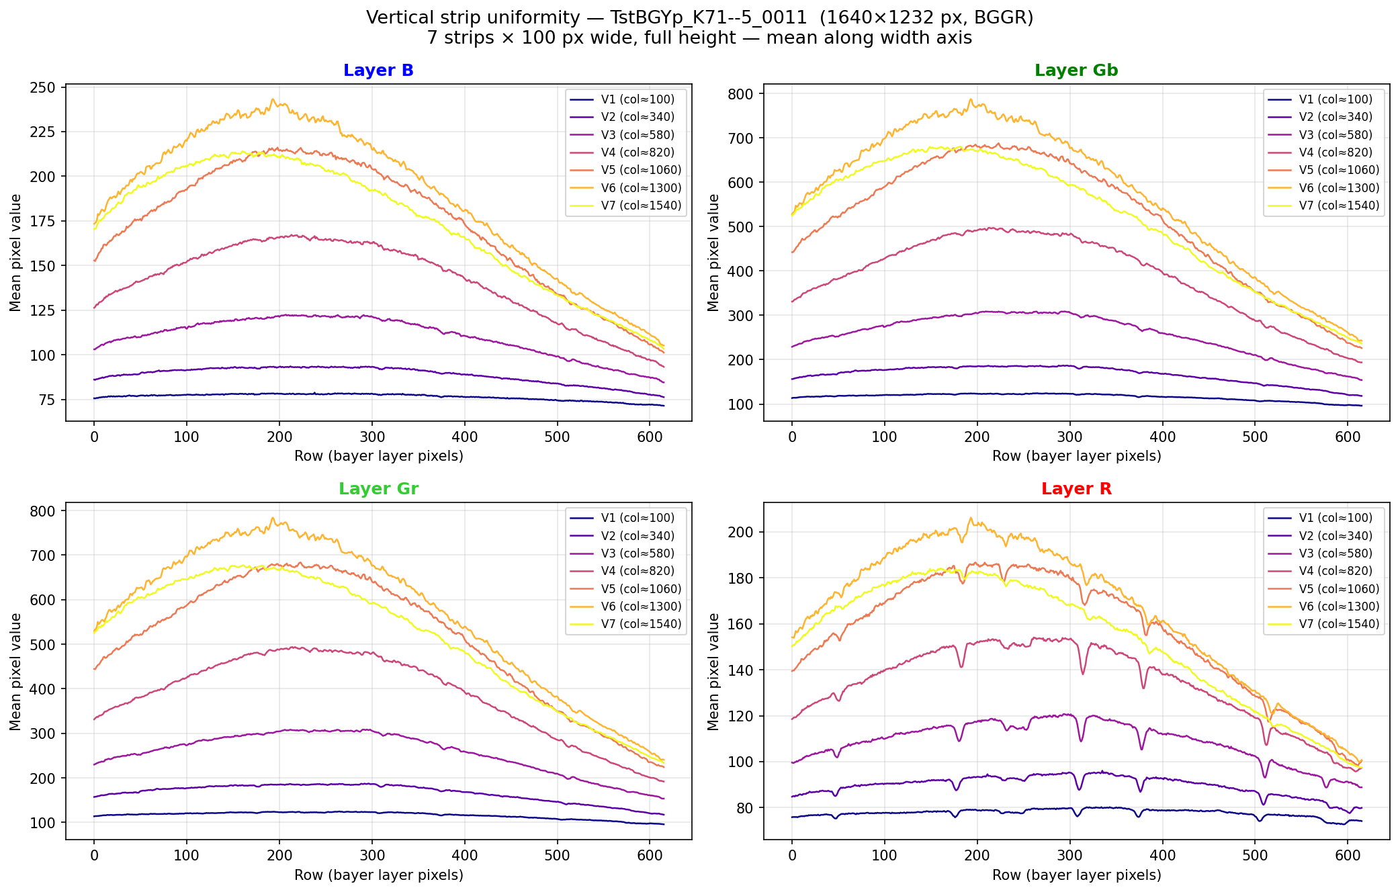
dev/figs/TstBGYp_K71--5_0011_vbalance.png
