panibillo/Colorimeter/dev/figs/TstBGYp_K72-00_0008_vbalance.png

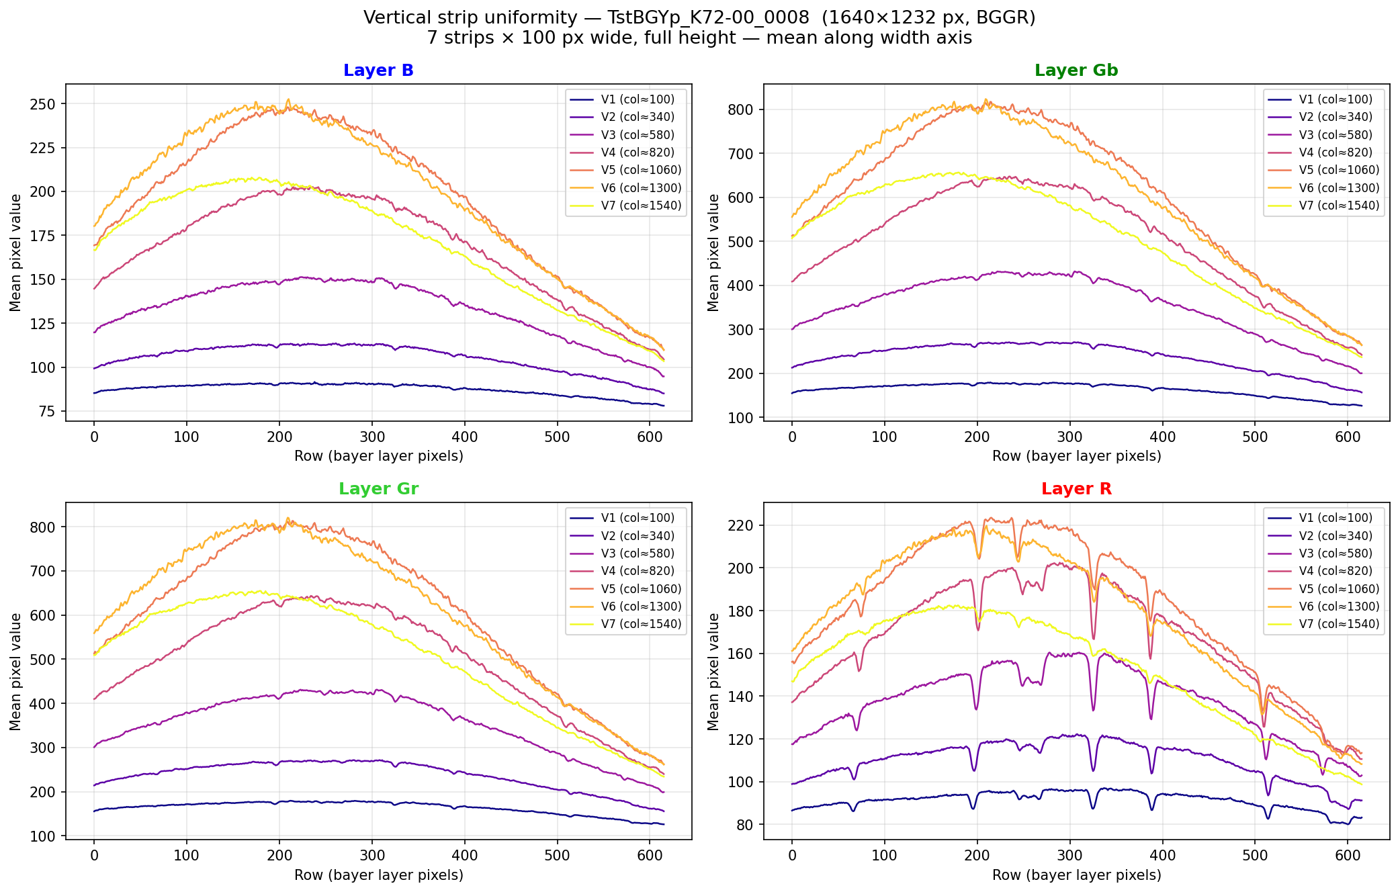
dev/figs/TstBGYp_K72-00_0008_vbalance.png
