panibillo/Colorimeter/dev/figs/TstBGYp_K72_0015_vbalance.png

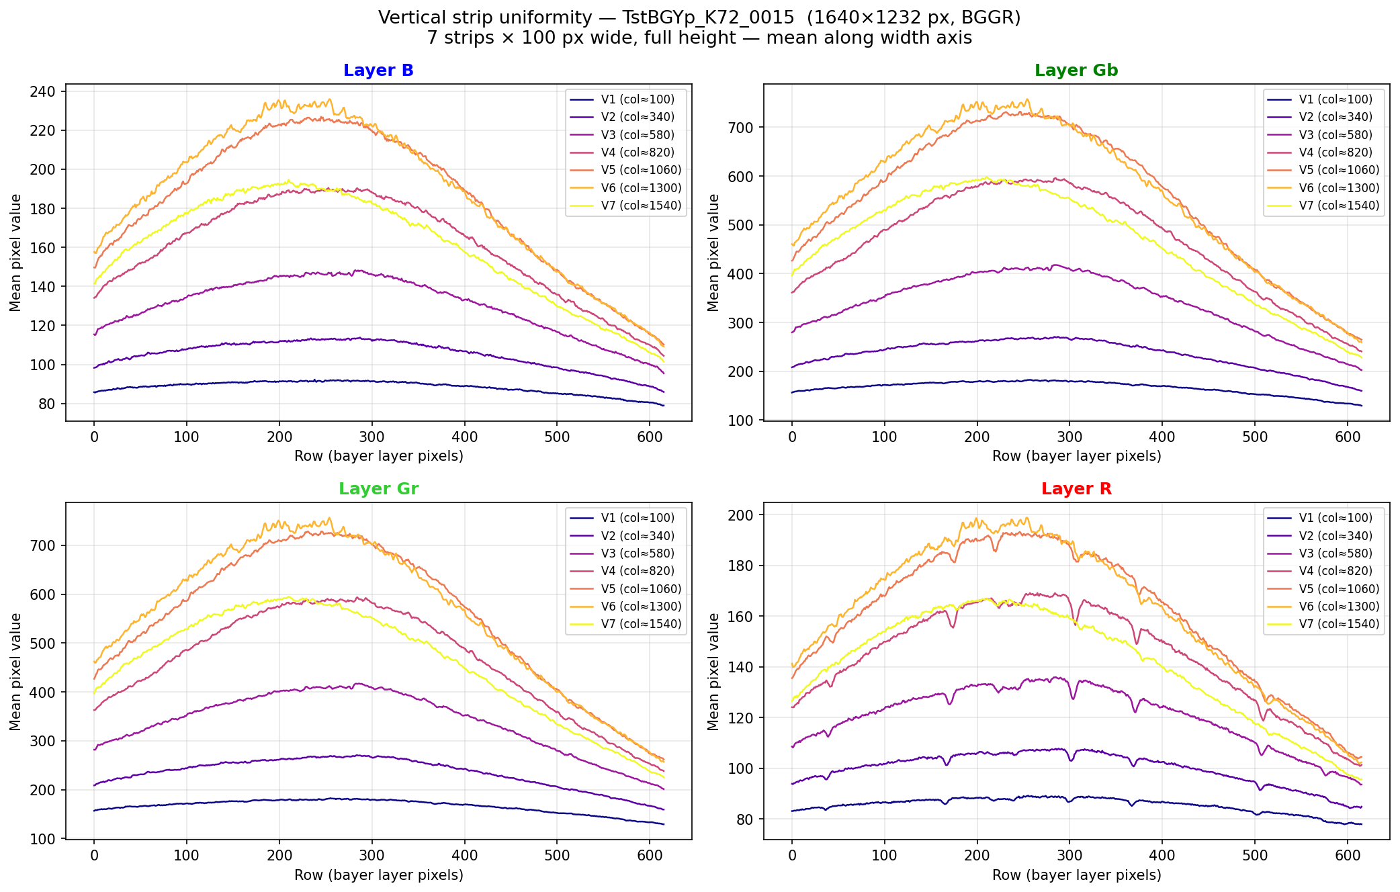
dev/figs/TstBGYp_K72_0015_vbalance.png
