panibillo/Colorimeter/dev/figs/TstBGYp_K99-00_0009_contours.png

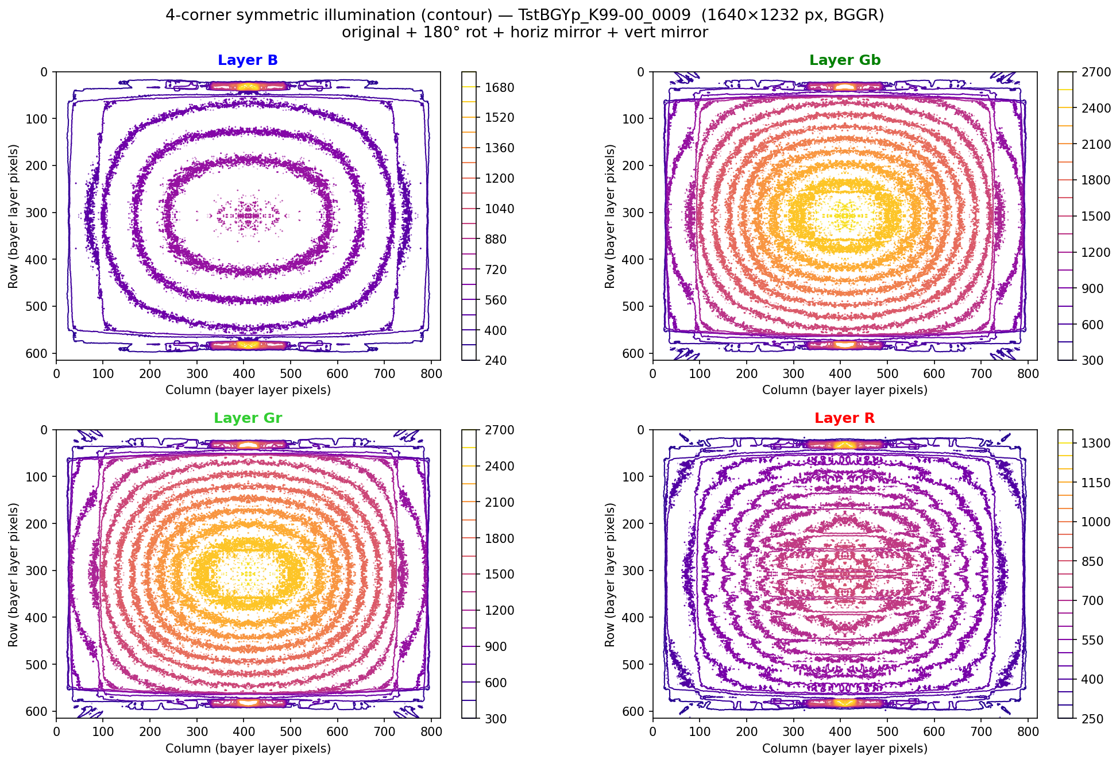
dev/figs/TstBGYp_K99-00_0009_contours.png
