panibillo/Colorimeter/dev/figs/TstBGYp_K99-00_0009_hbalance.png

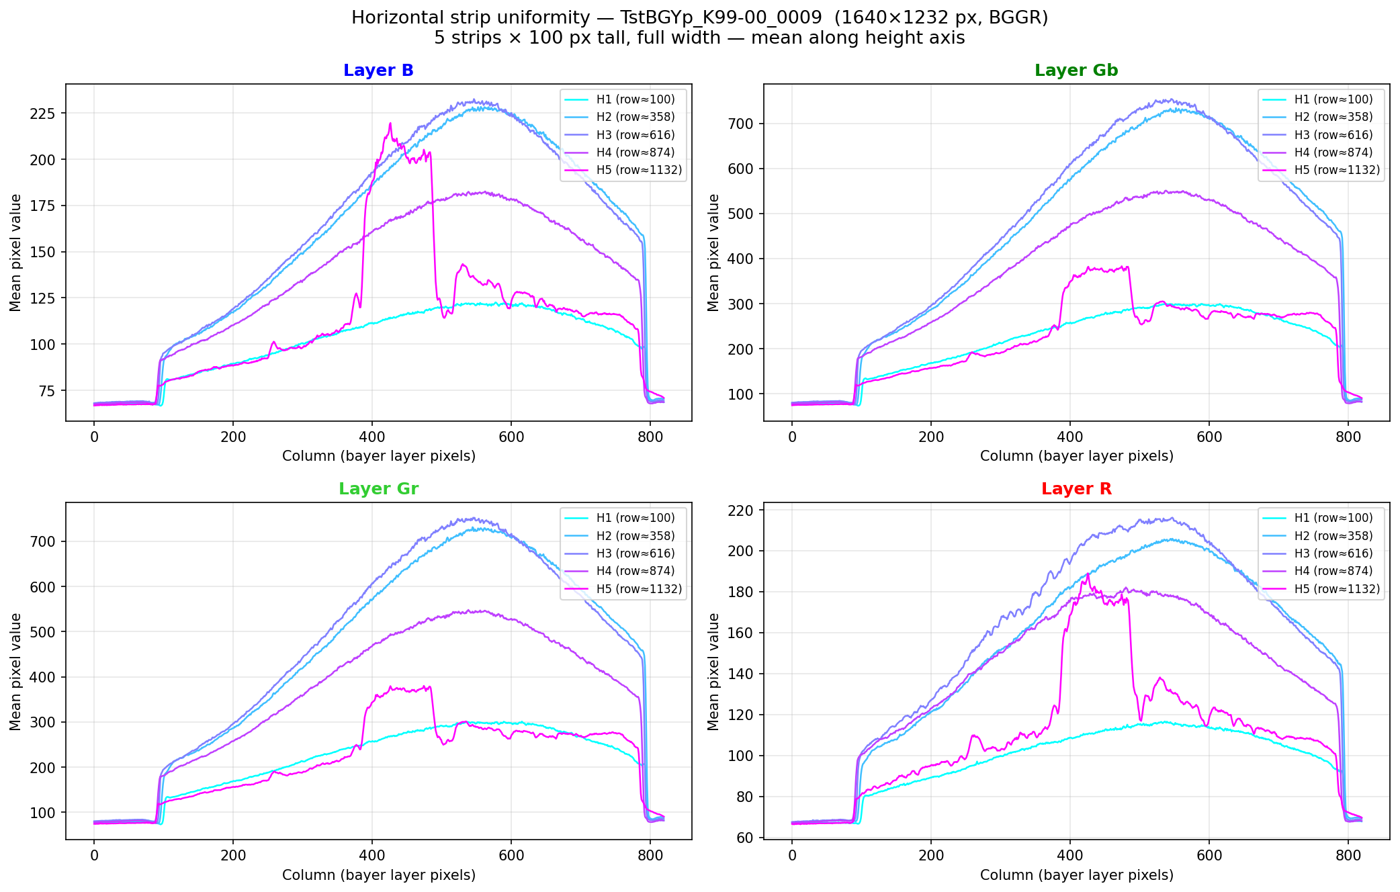
dev/figs/TstBGYp_K99-00_0009_hbalance.png
