panibillo/Colorimeter/dev/figs/TstBGYp_K99--5_0010_vbalance.png

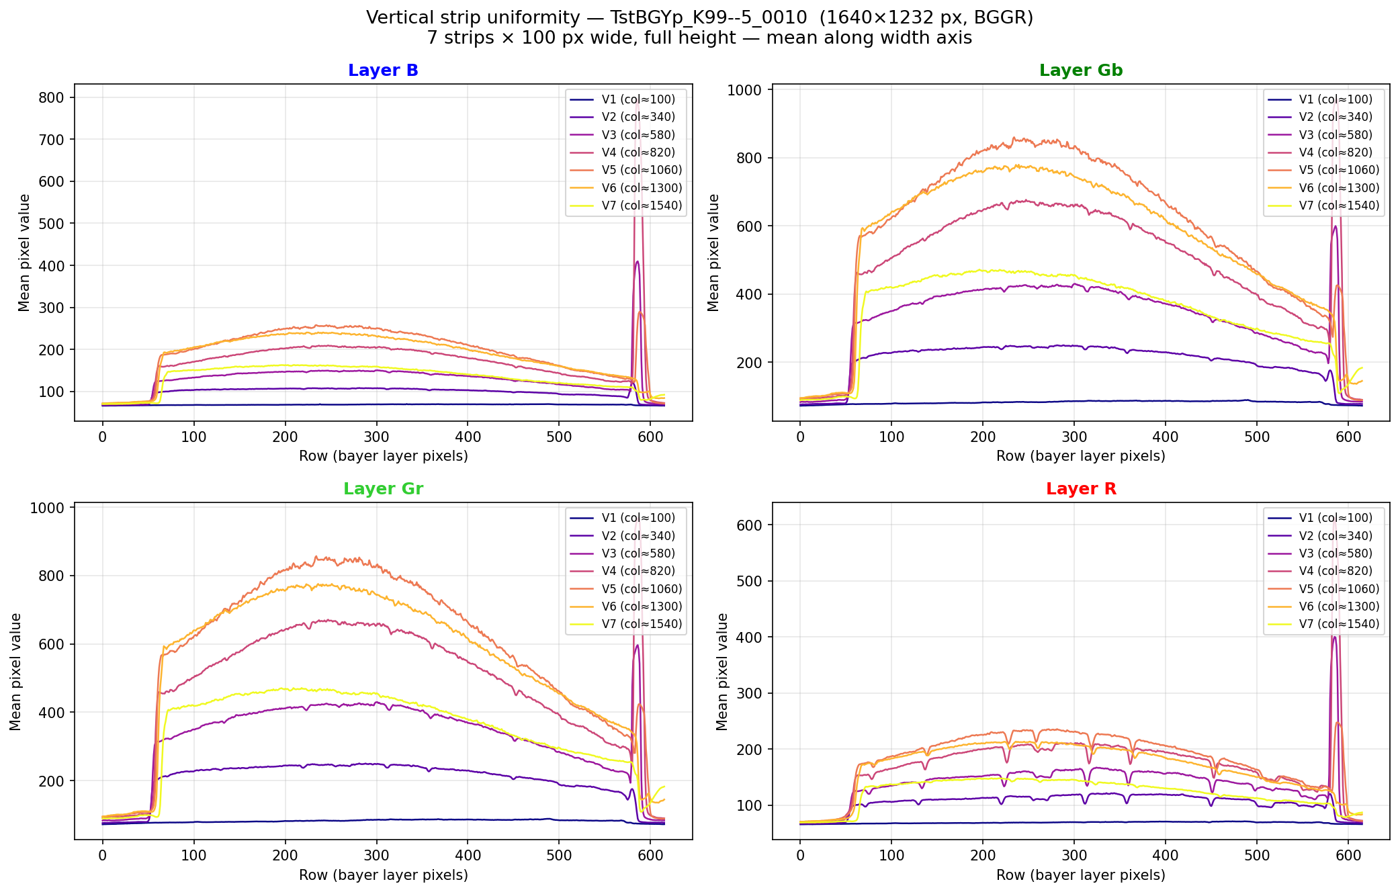
dev/figs/TstBGYp_K99--5_0010_vbalance.png
