panibillo/Colorimeter/dev/figs/TstBGYp_K100_0016_hbalance.png

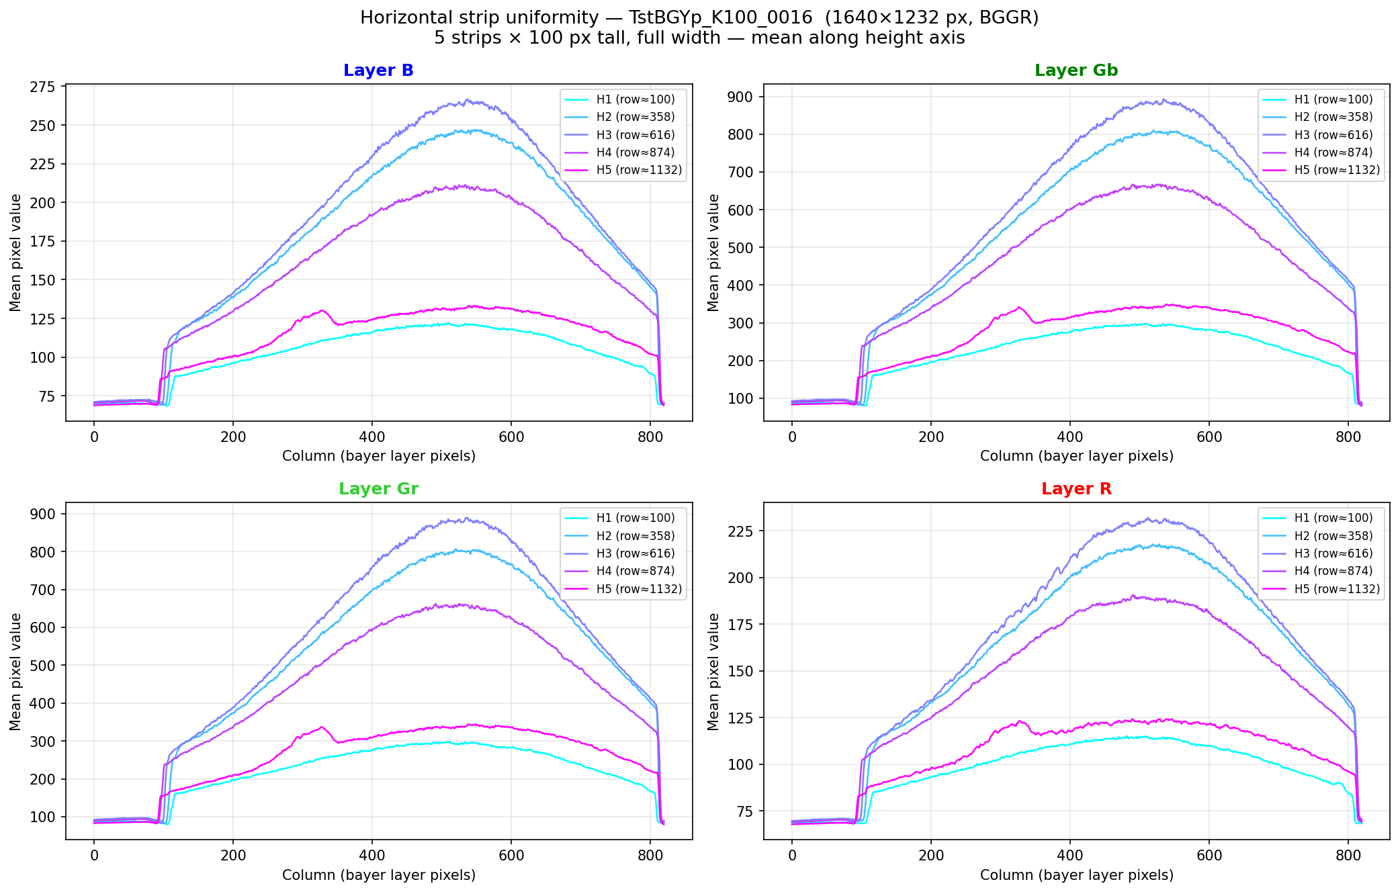
dev/figs/TstBGYp_K100_0016_hbalance.png
