panibillo/Colorimeter/dev/figs/TstBGYp_K100_0016_vbalance.png

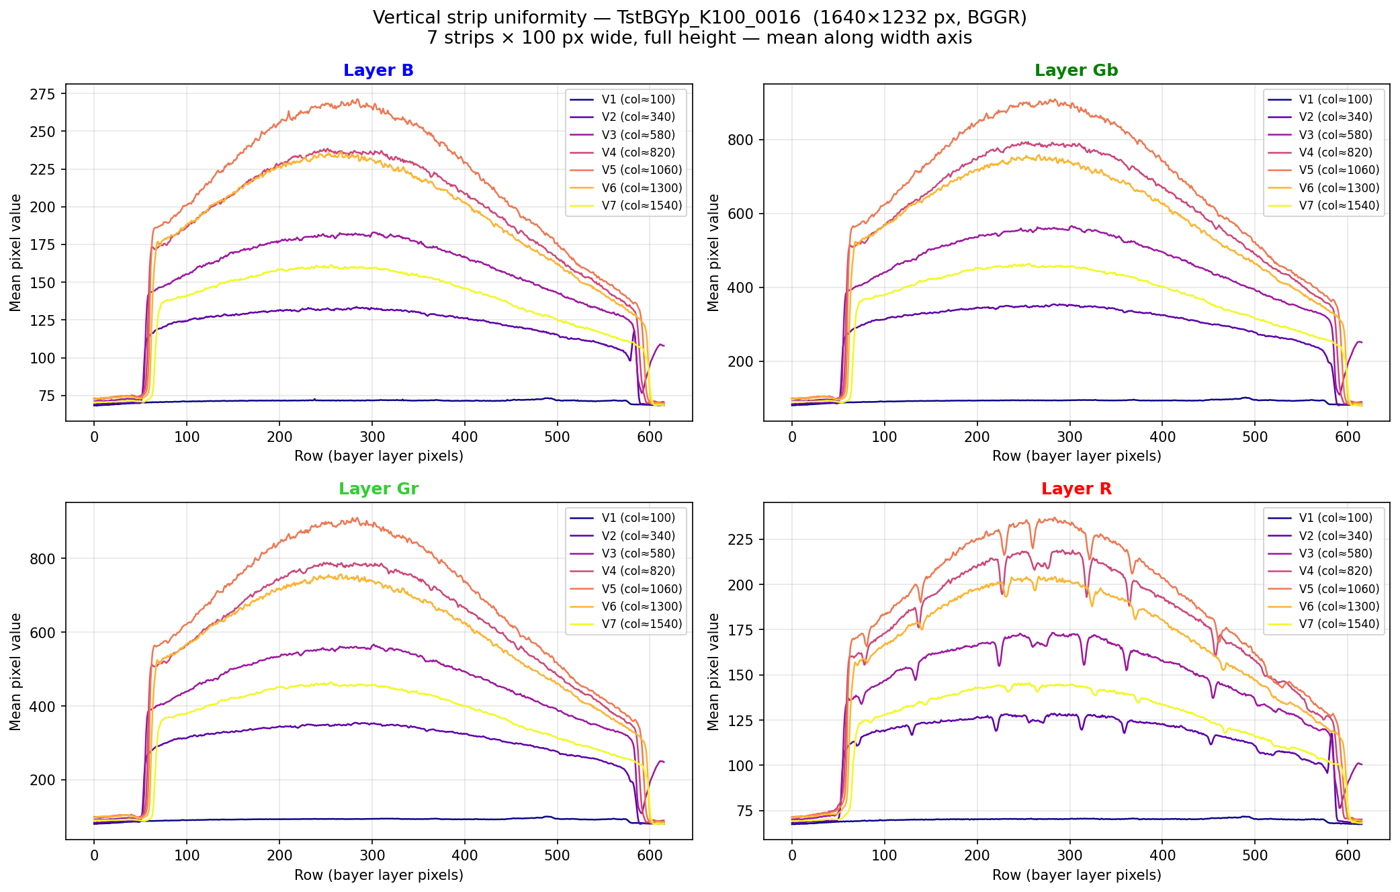
dev/figs/TstBGYp_K100_0016_vbalance.png
