panibillo/Colorimeter/dev/figs/TstBGYp_K100_0017_vbalance.png

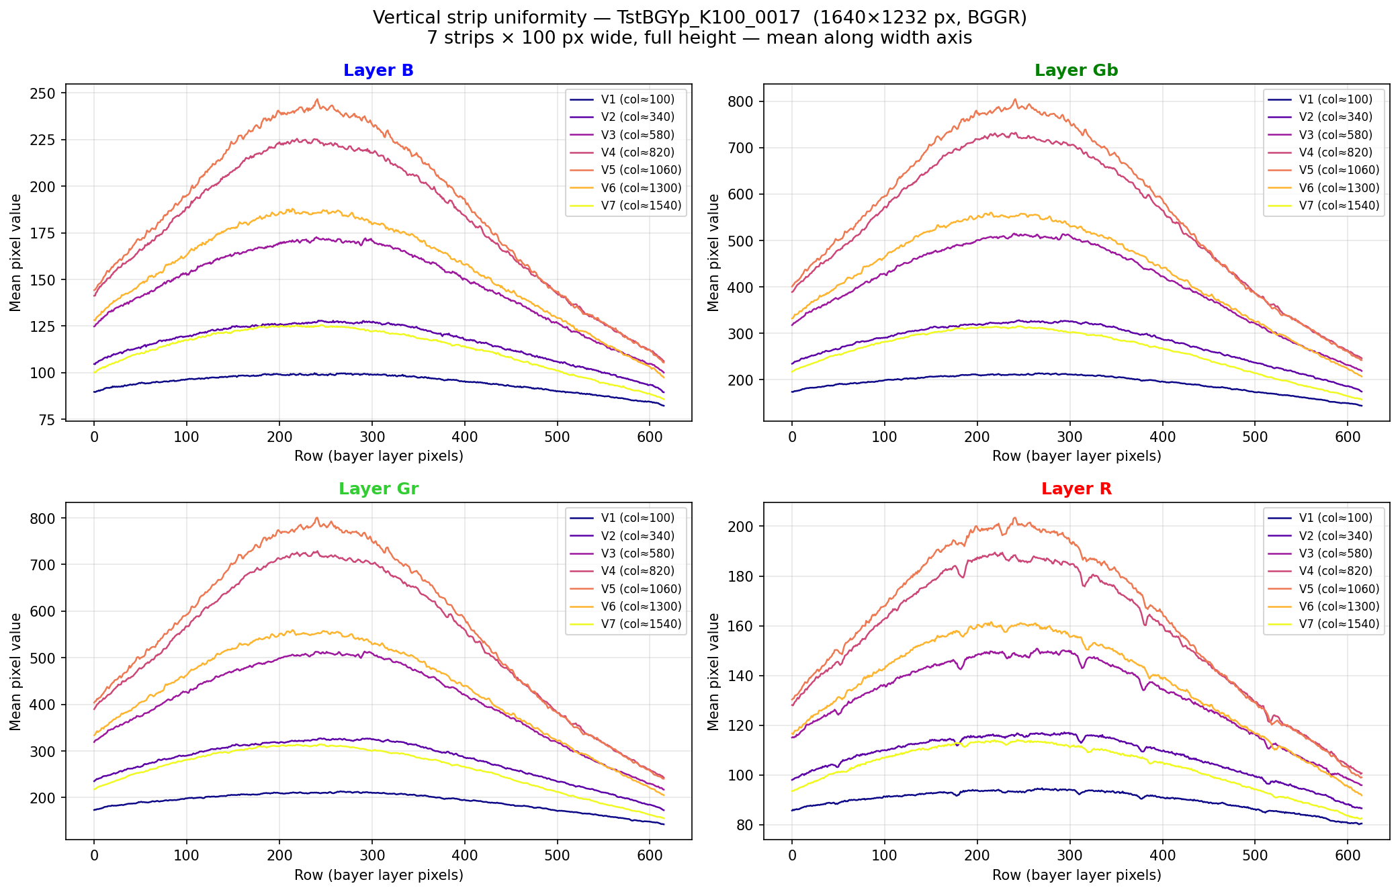
dev/figs/TstBGYp_K100_0017_vbalance.png
