panibillo/Colorimeter/devdesk/flatfield/figs/fit_red_R.png

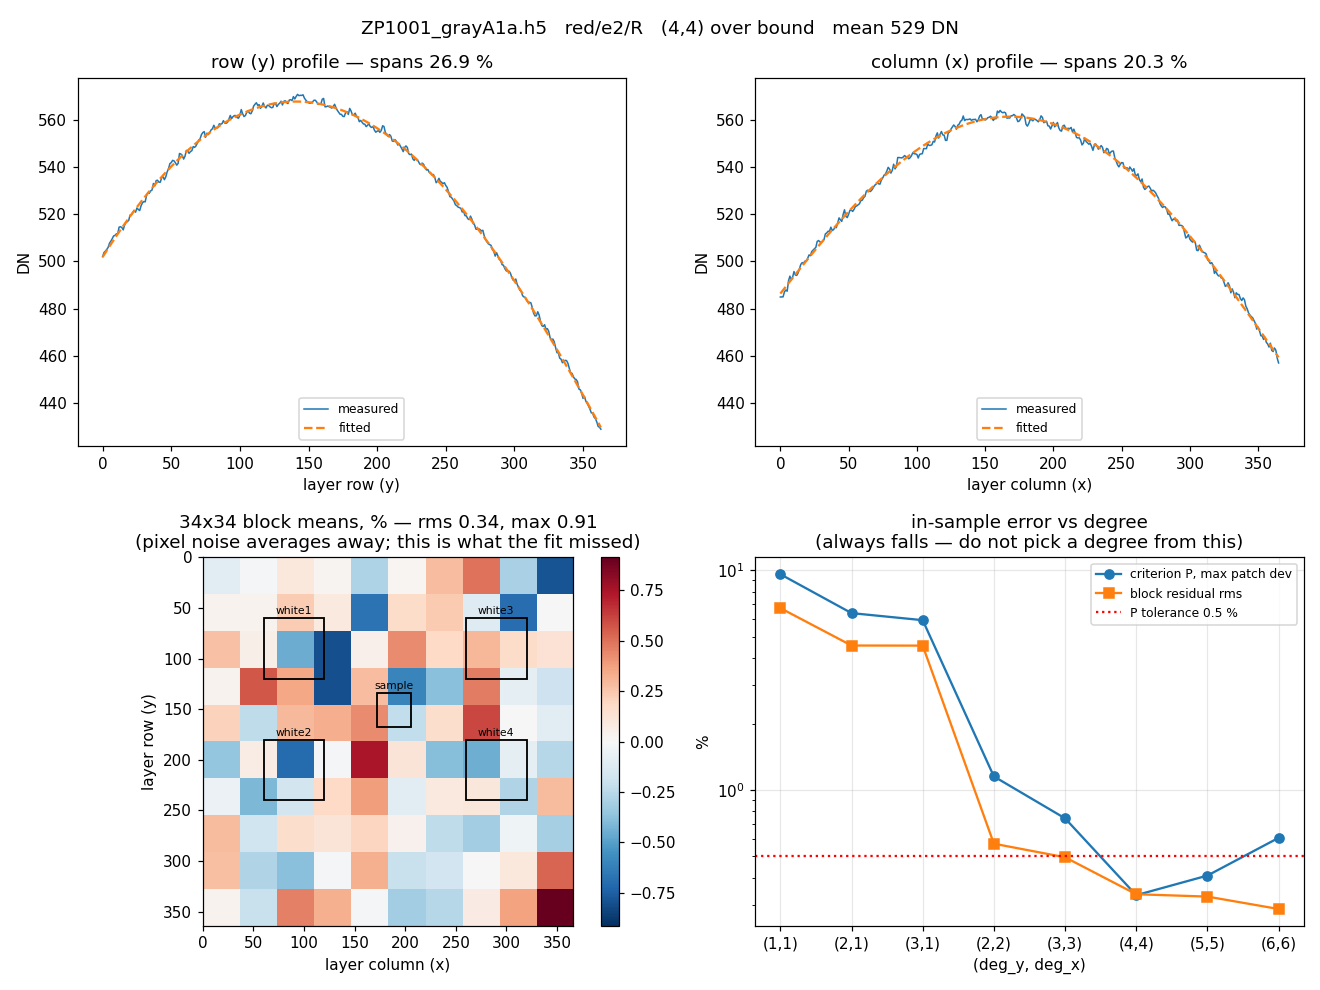
devdesk/flatfield/figs/fit_red_R.png
