panibillo/Colorimeter/devdesk/flatfield/figs/fit_violet_B.png

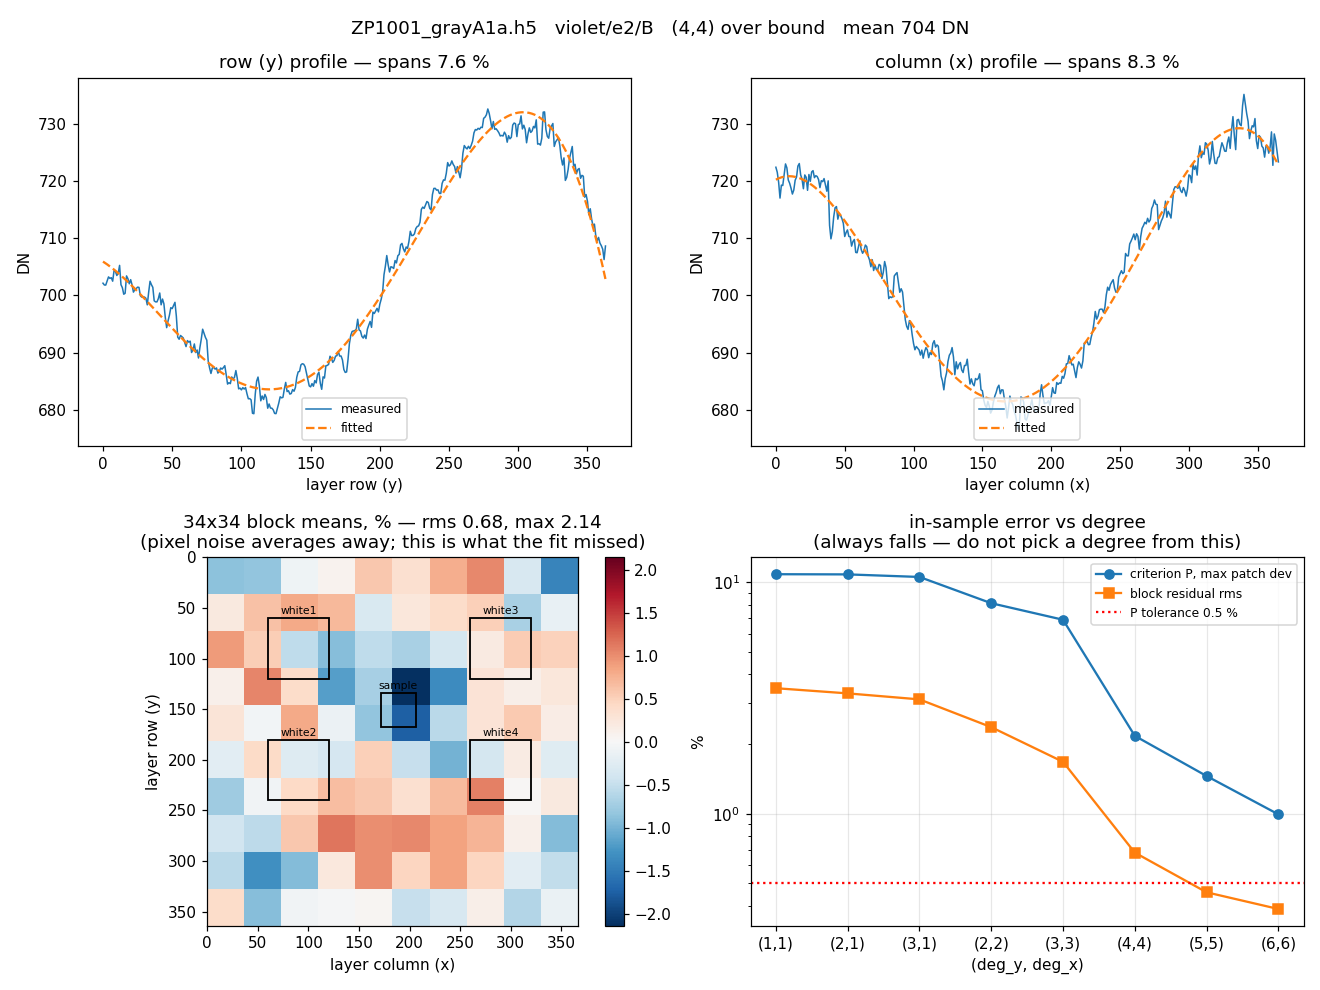
devdesk/flatfield/figs/fit_violet_B.png
