panibillo/Colorimeter/edocs/circuits/mainboard_C.png

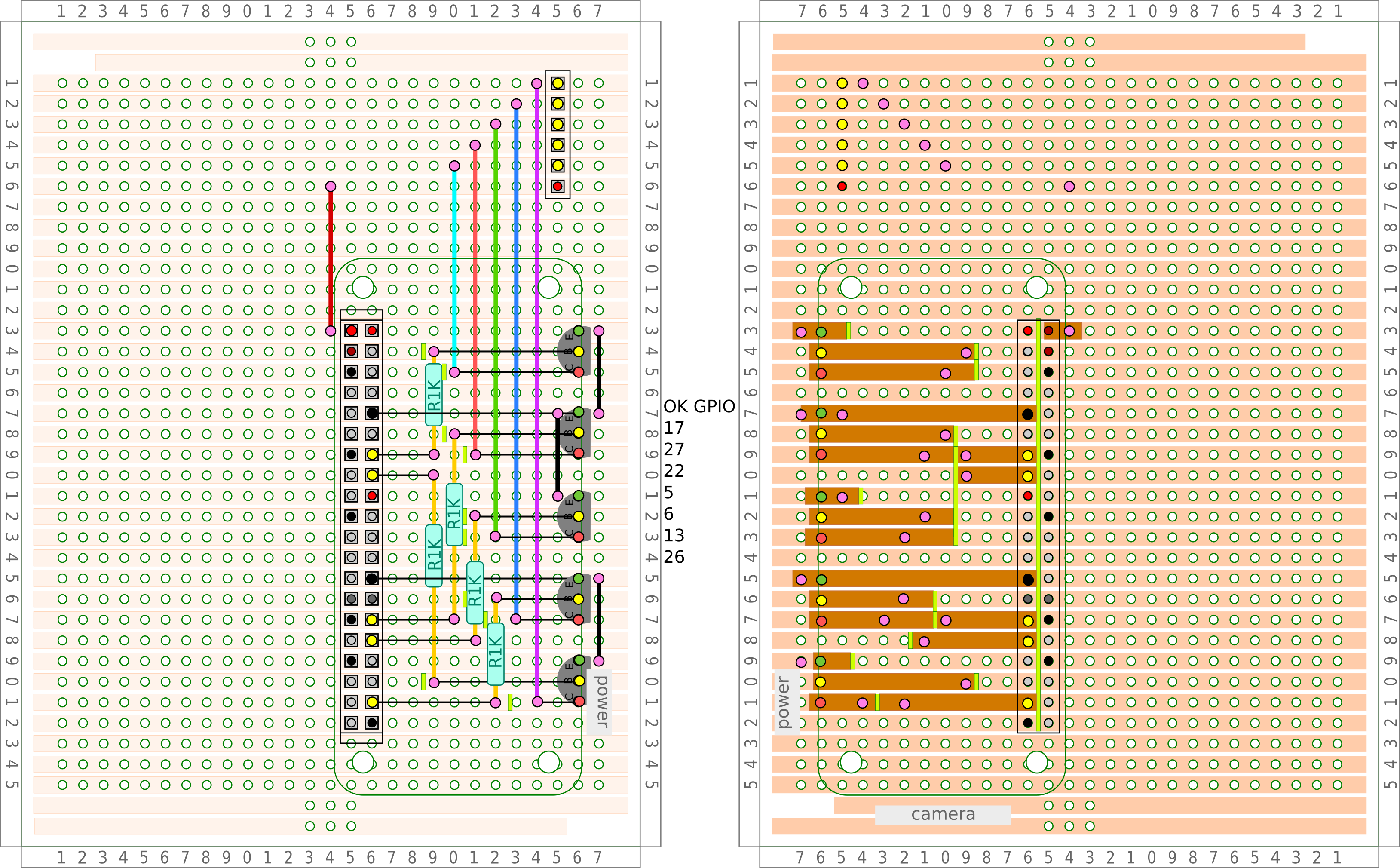
edocs/circuits/mainboard_C.png
