panibillo/Colorimeter/hardware/IMG_3598.JPG

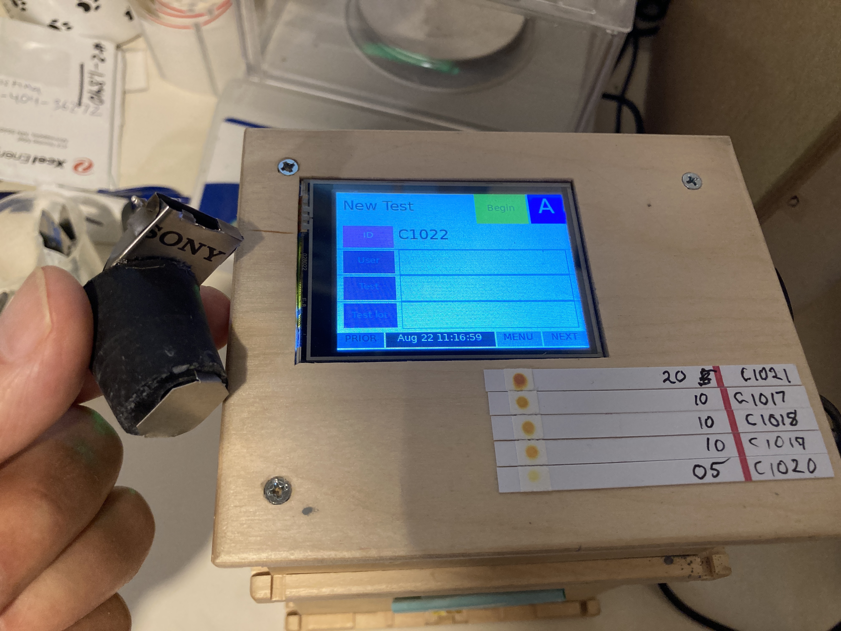
hardware/IMG_3598.JPG
