panibillo/Colorimeter/images/colorimeter_rgb.png

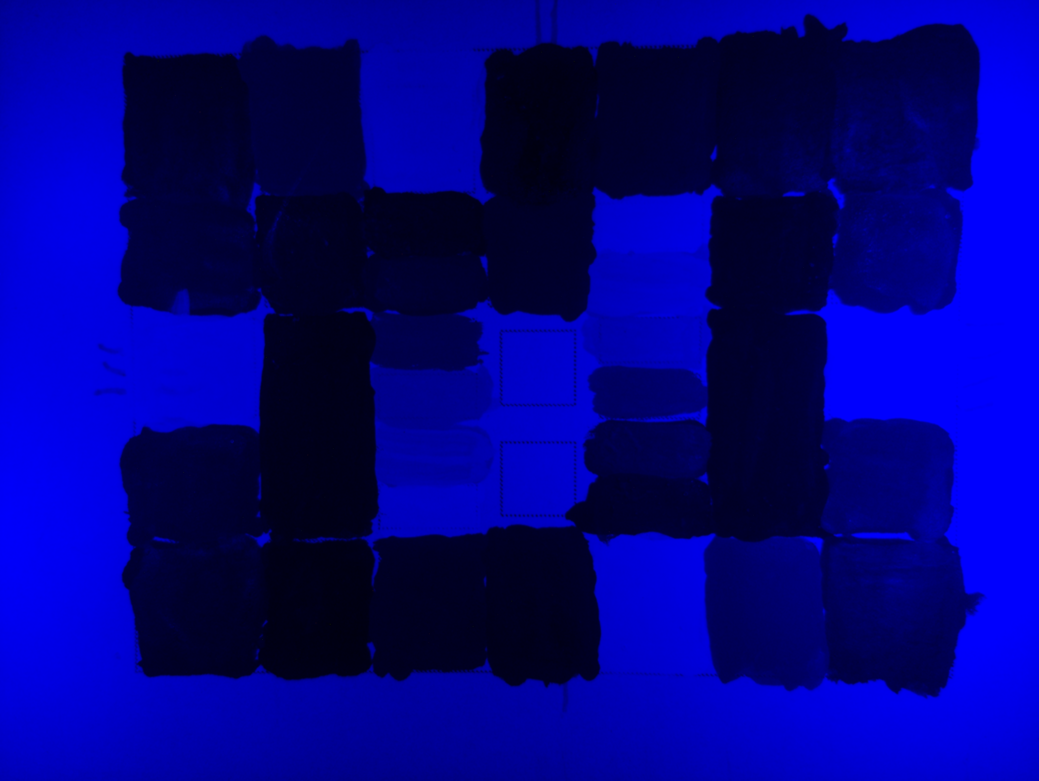
images/colorimeter_rgb.png
