panibillo/Colorimeter/images/colorimeter_rgb_d.png

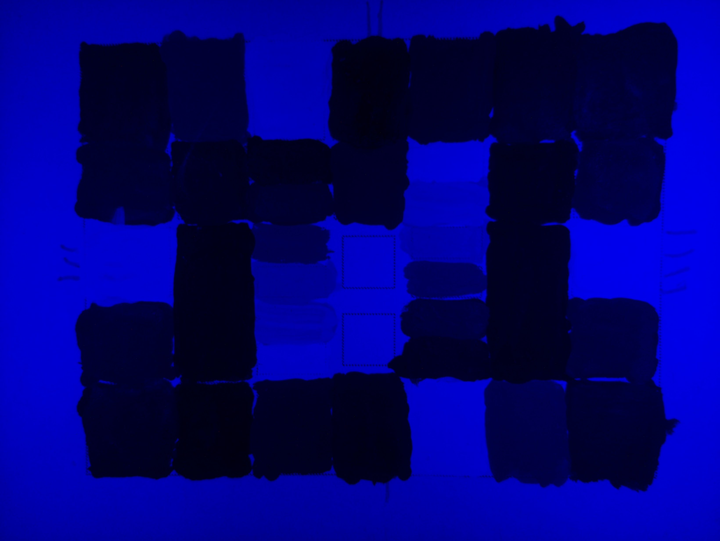
images/colorimeter_rgb_d.png
