panibillo/Colorimeter/images/rgb2.png

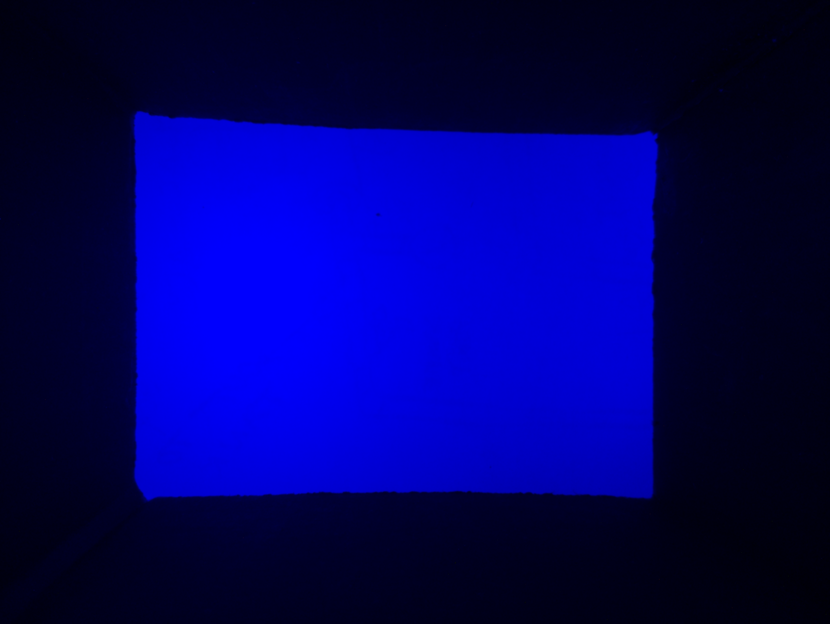
images/rgb2.png
