panibillo/Colorimeter/images/rgb3.png

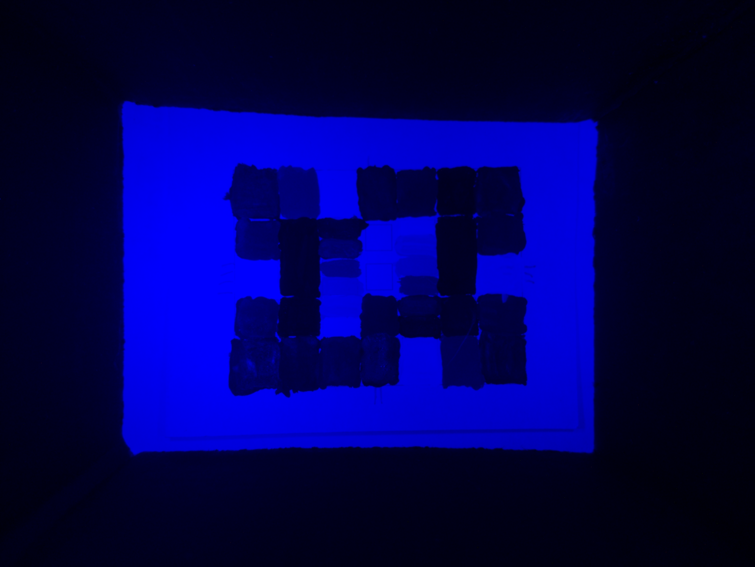
images/rgb3.png
