panibillo/Colorimeter/images/t8_White_7295ms_found.png

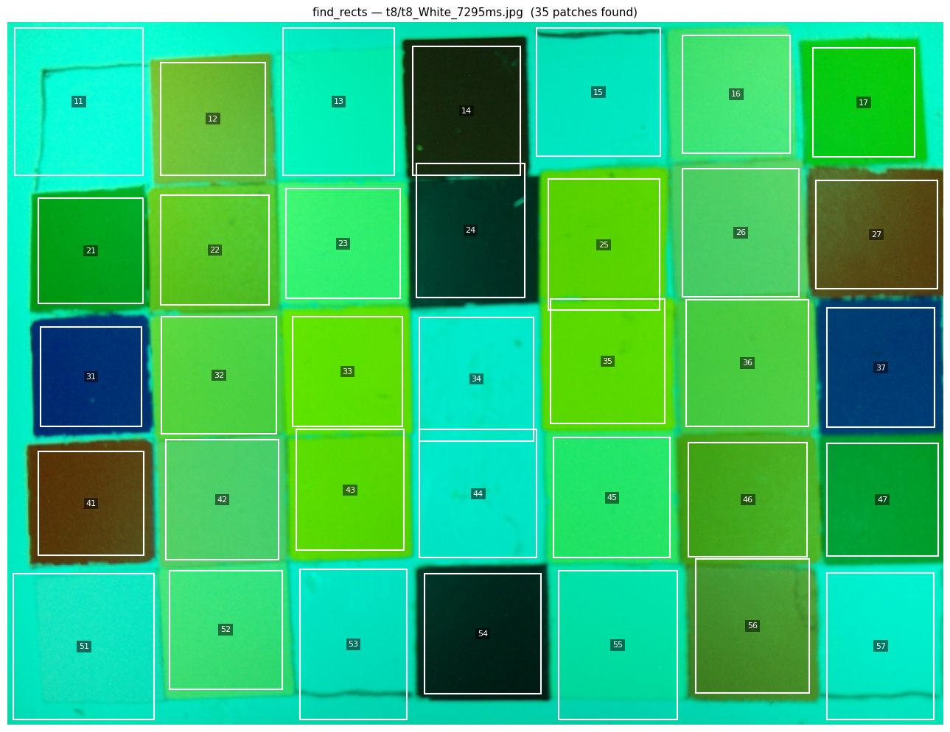
images/t8_White_7295ms_found.png
