panibillo/Colorimeter/edocs/LED_design/led_calculator.xlsx

Sheet: Catalog
rowid | color | rank | wavelength_nm | vf_typ_V | vf_min_V | vf_max_V | imax_mA | imax_source | i_test_mA | flux | viewing_angle | package | price_USD | n_leds | color_group | notes
1015 | Violet | 1 | 410nm dom/420nm peak | 2.80 | 2.80 | 4.00 | 30 | datasheet | 20 | — | 130° | 0603 (1608) | 0.415 | 6 | Violet | Confirmed: Imax=30mA, Pdmax=120mW, Vf 2.8-4.0V. Only true violet in catalog.
1012 | Violet | 2 | 455nm dom | 3.00 | 2.80 | 3.40 | 100 | estimated | 60 | 850 mcd | 120° | 1411 (3528) | 0.290 | 4 | Violet | Imax estimated from package/test current.
4 | Violet | 3 | 455nm (450-460nm) | 2.96 | 2.80 | 3.20 | 240 | datasheet | 140 | 265 mW | 124° | 1411 (3528) | 0.260 | 4 | Violet | Power LED. Budget-constrained to <50% Imax even at High level.
2 | Blue | 1 | 475nm (470-480nm) | 2.95 | 2.75 | 3.20 | 240 | datasheet | 140 | 20 lm | 126° | 1411 (3528) | 0.240 | 4 | Blue
1014 | Blue | 2 | 455nm dom | 3.20 | 3.00 | 3.50 | 200 | estimated | 150 | 2100 mcd | 120° | 4-SMD J-Lead | 0.400 | 4 | Blue | Imax estimated.
102 | Blue | 3 | 465nm (460-470nm) | 3.20 | 3.00 | 3.50 | 200 | datasheet | 150 | 11 lm | 120° | 1411 (3528) | 0.320 | 4 | Blue
1 | Green | 1 | 525nm (520-530nm) | 2.80 | 2.60 | 3.20 | 240 | datasheet | 140 | 62 lm | 124° | 1411 (3528) | 0.230 | 4 | Green | Best value in catalog.
532 | Green | 2 | 525nm dom/515nm peak | 3.10 | 2.90 | 3.50 | 30 | estimated | 20 | 1000 mcd | 120° | 1411 (3528) | 0.190 | 4 | Green | Indicator class. Imax estimated.
783 | Green | 3 | 525nm dom/520nm peak | 3.40 | 3.20 | 3.80 | 200 | estimated | 150 | 8000 mcd | 120° | 1411 (3528) | 0.360 | 4 | Green | High-brightness indicator. Imax estimated.
3 | Red | 1 | 625nm (620-630nm) | 2.20 | 2.00 | 2.60 | 250 | datasheet | 140 | 26 lm | 122° | 1411 (3528) | 0.260 | 4 | Red | Perfect wavelength and price.
727 | Red | 2 | 624nm dom/632nm peak | 2.00 | 1.80 | 2.40 | 200 | estimated | 150 | 4500 mcd | 120° | 1411 (3528) | 0.330 | 4 | Red | Lower Vf. Imax estimated.
6 | Red | 3 | 620nm (typ) | 2.20 | 2.00 | 2.60 | 200 | datasheet | 150 | 24 lm | 120° | 1411 (3528) | 0.320 | 4 | Red | Lower Imax than row 3.

Sheet: Calculator
LED Color Analyzer — Driver Design Calculator
Design Parameters
Supply voltage (V) |  | Vcc | 4.50 | V | Exact 5V supply — no LDO possible (LDO needs Vin > Vout)
Max total current budget (mA) |  | Ibudg | 500 | mA | 500mA available for LEDs (2.5A supply shared with RPi Zero 2W)
Max exposure time (s) |  | Texp | 1.2 | s | Camera max exposure per channel
Target brightness range |  |  |  |  | Low≈40%, Med≈60%, High≈80% of Imax per LED
E24 resistor series (Ω) — reference for R E24 column
 |  |  | 1.0 | 1.1 | 1.2 | 1.3 | 1.5 | 1.6 | 1.8 | 2.0 | 2.2 | 2.4 | 2.7 | 3.0 | 3.3 | 3.6 | 3.9 | 4.3 | 4.7 | 5.1 | 5.6 | 6.2 | 6.8 | 7.5 | 8.2 | 9.1 | 10.0 | 11.0 | 12.0 | 13.0 | 15.0 | 16.0 | 18.0 | 20.0 | 22.0 | 24.0 | 27.0 | 30.0 | 33.0 | 36.0 | 39.0 | 43.0 | 47.0 | 51.0 | 56.0 | 62.0 | 68.0 | 75.0 | 82.0 | 91.0 | 100.0 | 110.0 | 120.0 | 130.0 | 150.0 | 160.0 | 180.0 | 200.0 | 220.0
Row ID (enter) | Color Group | Rank | Wavelength | Vf typ (V) | Vf min (V) | Vf max (V) | Imax (mA) | Imax source | N LEDs | Price $/LED | Rel. Brightness (0–1) | I target /LED (mA) | R calc (Ω) | R E24 (Ω) [suggest] | I actual /LED (mA) | I total group (mA) | % of Imax | V drop across R (V) | P per LED (mW) | P resistor (mW) | Budget OK? | Warnings / Notes
 |  |  |  | V | V | V | mA |  | # | $ | 0–1 | mA | Ω | Ω | mA | mA | % | V | mW | mW
1015 | Violet | 1 | 410nm dom/420nm peak | 2.80 | 2.80 | 4.00 | 30 | datasheet | 4 | 0.41 | 60.0% | 18.0 | 94.4 | 91.0 | 18.7 | 74.7 | 62.3% | 1.700 | 52.3 | 31.8 | OK | | Wide Vf range
1015 | Violet | 1 | 410nm dom/420nm peak | 2.80 | 2.80 | 4.00 | 30 | datasheet | 6 | 0.41 | 60.0% | 18.0 | 94.4 | 91.0 | 18.7 | 112.1 | 62.3% | 1.700 | 52.3 | 31.8 | OK | | Wide Vf range
1012 | Violet | 2 | 455nm dom | 3.00 | 2.80 | 3.40 | 100 | estimated | 4 | 0.29 | 60.0% | 60.0 | 25.0 | 24.0 | 62.5 | 250.0 | 62.5% | 1.500 | 187.5 | 93.8 | OK | * Imax estimated
1012 | Violet | 2 | 455nm dom | 3.00 | 2.80 | 3.40 | 100 | estimated | 6 | 0.29 | 60.0% | 60.0 | 25.0 | 24.0 | 62.5 | 375.0 | 62.5% | 1.500 | 187.5 | 93.8 | OK | * Imax estimated
4 | Violet | 3 | 455nm (450-460nm) | 2.96 | 2.80 | 3.20 | 240 | datasheet | 4 | 0.26 | 60.0% | 144.0 | 10.7 | 11.0 | 140.0 | 560.0 | 58.3% | 1.540 | 414.4 | 215.6 | OVER | | OVER BUDGET
4 | Violet | 3 | 455nm (450-460nm) | 2.96 | 2.80 | 3.20 | 240 | datasheet | 6 | 0.26 | 60.0% | 144.0 | 10.7 | 11.0 | 140.0 | 840.0 | 58.3% | 1.540 | 414.4 | 215.6 | OVER | | OVER BUDGET
2 | Blue | 1 | 475nm (470-480nm) | 2.95 | 2.75 | 3.20 | 240 | datasheet | 4 | 0.24 | 60.0% | 144.0 | 10.8 | 11.0 | 140.9 | 563.6 | 58.7% | 1.550 | 415.7 | 218.4 | OVER | | OVER BUDGET
1014 | Blue | 2 | 455nm dom | 3.20 | 3.00 | 3.50 | 200 | estimated | 4 | 0.40 | 60.0% | 120.0 | 10.8 | 11.0 | 118.2 | 472.7 | 59.1% | 1.300 | 378.2 | 153.6 | OK | * Imax estimated
102 | Blue | 3 | 465nm (460-470nm) | 3.20 | 3.00 | 3.50 | 200 | datasheet | 4 | 0.32 | 60.0% | 120.0 | 10.8 | 11.0 | 118.2 | 472.7 | 59.1% | 1.300 | 378.2 | 153.6 | OK
1 | Green | 1 | 525nm (520-530nm) | 2.80 | 2.60 | 3.20 | 240 | datasheet | 4 | 0.23 | 60.0% | 144.0 | 11.8 | 12.0 | 141.7 | 566.7 | 59.0% | 1.700 | 396.7 | 240.8 | OVER | | OVER BUDGET
532 | Green | 2 | 525nm dom/515nm peak | 3.10 | 2.90 | 3.50 | 30 | estimated | 4 | 0.19 | 60.0% | 18.0 | 77.8 | 75.0 | 18.7 | 74.7 | 62.2% | 1.400 | 57.9 | 26.1 | OK | * Imax estimated
783 | Green | 3 | 525nm dom/520nm peak | 3.40 | 3.20 | 3.80 | 200 | estimated | 4 | 0.36 | 60.0% | 120.0 | 9.2 | 9.1 | 120.9 | 483.5 | 60.4% | 1.100 | 411.0 | 133.0 | OK | * Imax estimated
3 | Red | 1 | 625nm (620-630nm) | 2.20 | 2.00 | 2.60 | 250 | datasheet | 4 | 0.26 | 60.0% | 150.0 | 15.3 | 15.0 | 153.3 | 613.3 | 61.3% | 2.300 | 337.3 | 352.7 | OVER | | OVER BUDGET | R>250mW: use 1206
727 | Red | 2 | 624nm dom/632nm peak | 2.00 | 1.80 | 2.40 | 200 | estimated | 4 | 0.33 | 60.0% | 120.0 | 20.8 | 20.0 | 125.0 | 500.0 | 62.5% | 2.500 | 250.0 | 312.5 | OK | * Imax estimated | R>250mW: use 1206
6 | Red | 3 | 620nm (typ) | 2.20 | 2.00 | 2.60 | 200 | datasheet | 4 | 0.32 | 60.0% | 120.0 | 19.2 | 20.0 | 115.0 | 460.0 | 57.5% | 2.300 | 253.0 | 264.5 | OK | | R>250mW: use 1206
Max single-group total current (worst case in table): |  |  |  |  |  |  |  |  |  |  |  |  |  |  |  | 840.0 | Some groups exceed budget -- review column V
KEY: Blue text / light blue background = cells you enter or can change | Green text = looked up from Catalog sheet | Black text = calculated | Amber column O = suggested E24 resistor (override by typing your chosen value) | Column J (N LEDs) can also be changed
Vf_max Headroom Check |  |  | At worst-case Vf_max, current through R_E24 could be very low. Check here.
Row | R E24 (Ω) | I @ Vf_max (mA) | I @ Vf_typ (mA) | Ratio max/typ | Headroom note
1015 | 91.0 | 5.5 | 18.7 | 29.4% | >50% brightness variation
1015 | 91.0 | 5.5 | 18.7 | 29.4% | >50% brightness variation
1012 | 24.0 | 45.8 | 62.5 | 73.3% | Acceptable range
1012 | 24.0 | 45.8 | 62.5 | 73.3% | Acceptable range
4 | 11.0 | 118.2 | 140.0 | 84.4% | Acceptable range
4 | 11.0 | 118.2 | 140.0 | 84.4% | Acceptable range
2 | 11.0 | 118.2 | 140.9 | 83.9% | Acceptable range
1014 | 11.0 | 90.9 | 118.2 | 76.9% | Acceptable range
102 | 11.0 | 90.9 | 118.2 | 76.9% | Acceptable range
1 | 12.0 | 108.3 | 141.7 | 76.5% | Acceptable range
532 | 75.0 | 13.3 | 18.7 | 71.4% | Acceptable range
783 | 9.1 | 76.9 | 120.9 | 63.6% | Acceptable range
3 | 15.0 | 126.7 | 153.3 | 82.6% | Acceptable range
727 | 20.0 | 105.0 | 125.0 | 84.0% | Acceptable range
6 | 20.0 | 95.0 | 115.0 | 82.6% | Acceptable range
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
