panibillo/Colorimeter/Study_guides/led_study_guide.pdf

# Designing with LEDs

## A Practical Study Guide

Selecting components, calculating resistors, and matching circuits to design goals

VCC

R

light

Topics covered: LED physics, forward voltage, current limiting Ohm’s law applied to LED circuits Selecting operating current (Low / Medium / High) Resistor power ratings and package sizing Matching LEDs to voltage and current budgets Interpreting datasheets and handling uncertainty

Exercises and worked examples throughout. Answer key in Appendix A.

LED Circuit Design — Study Guide | CONTENTS

Contents

1 What Is an LED? | 3
2 The Basic LED Circuit | 5
3 Understanding LED Specifications | 6
4 Choosing an Operating Current | 8
5 Calculating the Current-Limiting Resistor | 9
6 Resistor Power Rating | 11
7 Parallel LED Groups | 12
8 Supply Voltage Considerations | 16
9 The MOSFET Switch | 17
10 Reading the Violet LED Datasheet: A Case Study | 18
April 6, 2026 | Page 1

LED Circuit Design — Study Guide | CONTENTS
11 Putting It All Together: Design Checklist | 20
12 Comprehensive Exercises | 20
A Answer Key | 21

LED Circuit Design — Study Guide | Section 1 — What Is an LED?

### 1 What Is an LED?

A Light Emitting Diode (LED) is a semiconductor device that emits light when current flows through it in the forward direction. Unlike a resistor, whose resistance is fixed by Ohm’s law, an LED presents a nearly constant voltage drop when conducting, and is very sensitive to the current flowing through it.

- Forward Voltage (Vf ): The voltage drop across the LED when it is conducting. This is fixed by the LED’s chemistry and color, not by the circuit. Typical values range from about 1.8 V (red) to 4.0 V (violet/UV).
- Forward Current (ILED): The current flowing through the LED. Brightness is approximately proportional to current.
- Maximum Current (Imax): The absolute maximum current the LED can handle continuously without damage. Never exceed this.
- Reverse breakdown: LEDs are destroyed if significant voltage is applied backwards. Always connect the anode (+) toward the positive supply.

### 1.1 The LED’s I–V Curve and the Load Line

Unlike a resistor, the LED does not obey Ohm’s law directly. Its current-versus-voltage relationship is highly nonlinear: below Vf almost no current flows; above it, current rises exponentially and extremely steeply. This behaviour is described by the diode equation, but for practical circuit design the key points are:

- The curve is nearly flat near zero — the LED is essentially an open circuit below its threshold voltage.
- The curve becomes nearly vertical above Vf — once conducting, a tiny increase in voltage produces a huge increase in current.
- The steepness means that connecting an LED directly to a fixed voltage source is dangerous: with no resistance to limit current, the LED sits on the vertical part of its curve and draws as much current as the source can supply, burning out in milliseconds.

The Load Line

The series resistor R imposes its own constraint on the circuit, described by a straight line called the load line. By Kirchhoff’s voltage law, whatever voltage the LED takes (VLED), the resistor gets the rest:

VR = VCC − VLED

and the current through the resistor is I = VR/R, so:

I =

VCC − VLED
R

This is a straight line on the I–V axes. It has two easy-to-find endpoints:

- X-intercept (current = 0): VLED = VCC. If no current flows, the full supply appears across the LED.

LED Circuit Design — Study Guide | Section 1 — What Is an LED?
- Y-intercept (voltage across LED = 0): I = VCC/R. If the LED were a short circuit, the resistor would limit current to VCC/R.

The Operating Point

The LED and resistor are in the same series loop, so they must simultaneously satisfy both constraints — the LED’s I–V curve and the load line. The only point that satisfies both at once is where the two lines intersect. This intersection is the operating point: the actual current and voltage at which the circuit runs.

Graphically, you draw the LED curve and the load line on the same axes. The operating point falls naturally on the steep part of the LED curve, in the region where the curve is nearly vertical. This has an important consequence: the steep curve means the operating point’s current is mostly controlled by the load line (i.e. the resistor), while the voltage is pinned near Vf by the LED. This is exactly the behaviour we want — the resistor sets the current, and the LED self-selects its voltage.

0 | 0.5 | 1 | 1.5 | 2 | 2.5 | 3 | 3.5 | 4 | 4.5 | 5

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
Operating point
I ≈ 77 mA, | V ≈ 2.85 V

Load line slope = −1/R

Voltage across LED, VLED (V)

Current (mA)

LED I–V Curve and Load Line (VCC = 5 V, R = 28 Ω, red LED Vf ≈ 2.2 V)

LED I–V curve
Load line: I = (5 V − VLED) / 28 Ω

Figure 1: The LED I–V curve (red) and the load line (blue) for a 28 Ω resistor on a 5 V supply. The load line runs from (0, VCC/R) on the current axis to (VCC, 0) on the voltage axis. The operating point (filled circle) is the unique intersection: the only combination of current and voltage that satisfies both the LED’s physics and Ohm’s law in the resistor simultaneously. Note that the operating point lies to the right of Vf on the steep part of the curve, confirming that the LED is conducting. Moving to a smaller R rotates the load line upward (steeper slope), raising both the current and the operating-point voltage slightly; a larger R rotates it downward.

Tip

Reading the load line intuitively. The load line’s slope is −1/R: a smaller resistor gives a steeper line and higher current; a larger resistor gives a shallower line and lower current. Changing VCC shifts both intercepts, sliding the line along both axes. In practice you never need to draw this graph — the equations in Section 5 give the same answer analytically — but understanding it explains why the resistor controls current rather than voltage, and why

LED Circuit Design — Study Guide | Section 2 — The Basic LED Circuit

the LED’s voltage barely changes even when you change the resistor.

Common Mistake

Do not connect an LED directly to a voltage source. Without a resistor there is no load line — or equivalently, the load line is vertical (zero resistance), and the intersection with the LED curve can be anywhere up the steep part of the curve, determined only by how much current the source can supply. The LED will burn out in milliseconds.

### 2 The Basic LED Circuit

The solution is simple: add a series resistor R between the supply and the LED. The resistor absorbs the difference between the supply voltage and Vf , and limits the current to a safe value.

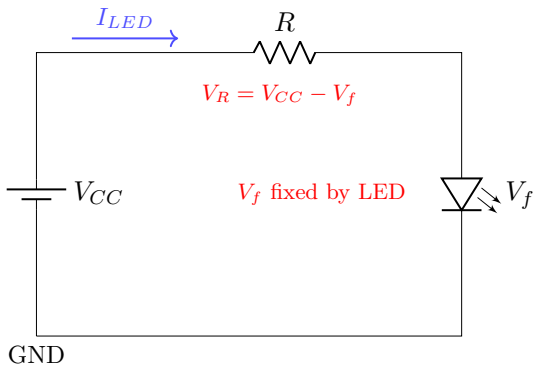
[picture p101: figure]
GND; VCC; ILED; VR = VCC − Vf; Vf fixed by LED

Figure 2: The fundamental LED circuit. The resistor R limits current by dropping the voltage difference VR = VCC − Vf .

### 2.1 The Governing Equations

The three equations you need are all forms of Ohm’s law.

The Three LED Circuit Equations

VR = VCC − Vf | (1)

ILED =

VR
R

=

VCC − Vf
R

(2)

R =

VCC − Vf

ILED

(3)

where:
- VCC = supply voltage (V)
- Vf = LED forward voltage (V) — from the datasheet
- VR = voltage across the resistor (V)
- ILED = LED current (A or mA) — you choose this

LED Circuit Design — Study Guide | Section 3 — Understanding Specifications
- R = resistor value (Ω)

Tip

The LED current ILED is the same as the current through the resistor — they are in series, so only one current flows in the whole loop.

### 2.2 Worked Example: Finding R

Given:
- Supply voltage: VCC = 5.0 V
- Red LED: Vf = 2.2 V (typical), Imax = 250 mA
- Desired current: ILED = 100 mA
Step 1: Find the voltage across the resistor.

VR = VCC − Vf = 5.0 − 2.2 = 2.8 V

Step 2: Calculate the required resistance.

R =

VR

ILED

=

2.8 V
0.100 A = 28 Ω
Step 3: Choose the nearest standard (E24) value.
The nearest E24 value below 28 Ω is 27 Ω. The nearest above is 30 Ω.
With 27 Ω: ILED = 2.8/27 = 103.7 mA (slightly over target, but under Imax)
With 30 Ω: ILED = 2.8/30 = 93.3 mA (slightly under target)
Either is acceptable. Choose 27 Ω for slightly more brightness, 30 Ω for slightly more headroom below Imax.

Q1. A blue LED has Vf = 2.95 V and is powered from a 5 V supply. You want ILED = 80 mA. What resistor do you need?

VR = | Rcalc = | Nearest E24 =

(See Appendix A for the answer.)

### 3 Understanding LED Specifications

Before you can design a circuit, you need to read and understand the LED datasheet. This section explains the most important specifications.

### 3.1 Forward Voltage (Vf ): Typical, Minimum, and Maximum

Datasheets usually give three values for Vf :

LED Circuit Design — Study Guide | Section 3 — Understanding Specifications
Value | Meaning | How to use it

V

typ
f | Most LEDs from this
| batch | Use for nominal calculations

V

min
f | Best-case (lowest
| voltage, highest current
| for given R) | Use to find maximum possible
| | current

V

max
f | Worst-case (highest
| voltage, lowest current
| for given R) | Use to verify the LED still lights at
| | minimum brightness

Common Mistake

Using only V

typ
f

can mislead you. If V

max
f

is much higher than V

typ
f

, some LEDs from
the production run will be noticeably dimmer than expected. Example: The violet LED (row 1015 in our project) has V

typ
f = 2.8 V but V

max
f = 4.0 V. With a 120 Ω resistor on a 5 V supply:
- At V

typ
f

: I = (5.0 − 2.8)/120 = 18.3 mA
- At V
max
f

: I = (5.0 − 4.0)/120 = 8.3 mA The dimmest LEDs produce less than half the current of the brightest. Always check the full Vf range.

### 3.2 Maximum Current (Imax)

Imax is the absolute maximum continuous forward current. Exceeding it will destroy the LED by overheating its junction. It is not a target — it is a hard ceiling.

Tip

A good operating current is 50–75% of Imax. This gives good brightness while keeping the junction temperature low, extending LED lifetime and maintaining spectral stability.

### 3.3 Power Dissipation (Pmax)

Every LED also has a maximum power dissipation rating:

PLED = Vf × ILED

This must stay below the datasheet’s Pmax. For the violet LED: Pmax = 120 mW. At Vf = 2.8 V and I = 18 mA: P = 2.8 × 0.018 = 50.4 mW. Well within limit.

Quick Check 3.1

Q2. A green LED has Vf = 2.8 V, Imax = 240 mA, and Pmax = 800 mW. You plan to run it at I = 150 mA.
(a) What is the power in the LED?
(b) Is this within the power limit?
(c) What percentage of Imax are you using?

LED Circuit Design — Study Guide | Section 4 — Choosing an Operating Current

(See Appendix A.)

### 3.4 Luminous Output

LEDs may specify brightness in several units depending on their class:

- lm (lumens): Total light output. Used for power/high-brightness LEDs.
- mcd (millicandela): Intensity in a specific direction. Used for indicator LEDs.
- mW (milliwatts): Optical radiant power. Used for UV/IR LEDs where human visibility is less meaningful.

Brightness is approximately proportional to current. Running at 50% of Imax gives roughly 50% of the rated luminous output.

### 4 Choosing an Operating Current

One of the most important design decisions is how hard to drive your LED. This section introduces a systematic approach using three defined levels.

### 4.1 The Three Brightness Levels

Rather than picking current arbitrarily, define three levels as fractions of Imax:

Level | % of Imax | When to use
Low | ≈40% | Calibration, testing, or when camera exposure can compensate
Medium | ≈60% | Normal operation; good brightness with comfortable thermal margin
High | ≈80% | Maximum brightness needed; monitor temperature; shorter LED lifetime

Given: Green LED, Imax = 240 mA.

ILow = 0.40 × 240 = 96 mA
IMedium = 0.60 × 240 = 144 mA IHigh = 0.80 × 240 = 192 mA

Before accepting these, check the power budget. If four LEDs run in parallel, total current at Medium = 4 × 144 = 576 mA. If the budget is 500 mA, the Medium target must be reduced:

IMedium,max =

500 mA
4 LEDs

= 125 mA (52% of Imax)

This is still a good operating point, just slightly below the 60% guideline.

LED Circuit Design — Study Guide | Section 5 — Calculating the Resistor

### 4.2 The Power Budget Constraint

When multiple LEDs run in parallel, the total current is:

Itotal = N × ILED | (4)

This must not exceed your supply’s current limit. Always check Itotal before finalizing a resistor value.

Q3. You have a red LED with Imax = 250 mA. You want to run 4 LEDs in parallel from a supply limited to 500 mA.
(a) What is IMedium per LED at 60% of Imax?
(b) What is the total current at Medium? Does it fit the budget?
(c) What is the maximum per-LED current that fits the 500 mAbudget?
(d) What percentage of Imax is that maximum?
(See Appendix A.)

### 5 Calculating the Current-Limiting Resistor

### 5.1 Step-by-Step Procedure

1. Choose the desired LED current ILED (using the brightness-level approach from Section 4, constrained by the power budget).
2. Compute the voltage across the resistor:

VR = VCC − V

typ
f
3. Calculate the exact resistor value:

Rcalc =

VR

ILED

(Use amperes, not milliamperes, in this formula.)

4. Round to the nearest E24 standard value (see Table 1).
5. Calculate the actual current with the standard resistor:

I

actual
LED =

VR

RE24

6. Verify: I

actual
LED < Imax and N × I

actual
LED < budget.

### 5.2 The E24 Resistor Series

Standard resistors come in the E24 series, which provides 24 values per decade. These are the most commonly available values.

LED Circuit Design — Study Guide | Section 5 — Calculating the Resistor

Table 1: E24 Standard Resistor Values (multiply by any power of 10)

1.0 | 1.1 | 1.2 | 1.3 | 1.5 | 1.6 | 1.8 | 2.0 | 2.2 | 2.4 | 2.7 | 3.0
3.3 | 3.6 | 3.9 | 4.3 | 4.7 | 5.1 | 5.6 | 6.2 | 6.8 | 7.5 | 8.2 | 9.1

Tip

To find the nearest E24 value to any calculated resistance: divide by the appropriate power of 10 to get a value between 1 and 10, find the nearest entry in Table 1, then multiply back. For example, Rcalc = 18.7 Ω: divide by 10 → 1.87; nearest E24 is 1.8; multiply by 10 → 18 Ω.

### 5.3 Full Worked Example

Given:
- Supply: VCC = 5.0 V
- LED: V

typ
f = 2.80 V, Imax = 240 mA
- 4 LEDs in parallel
- Current budget: 500 mA
- Target level: Medium (60% of Imax)
Step 1: Initial target current.

I

target
LED = 0.60 × 240 = 144 mA
Step 2: Check power budget.

Itotal = 4 × 144 = 576 mA > 500 mA (over budget!)

Reduce: I

max
LED = 500/4 = 125 mA. Use ILED = 122 mA(51% of Imax).
Step 3: Voltage across resistor.

VR = 5.0 − 2.80 = 2.20 V

Step 4: Calculate Rcalc.

Rcalc =

2.20
0.122

= 18.03 Ω

Step 5: Nearest E24 value. 18.03 Ω → divide by 10 → 1.803 → nearest E24 is 1.8 → multiply by 10 → 18 Ω.
Step 6: Actual current.

I

actual
LED =

2.20
18

= 0.1222 A = 122.2 mA

Step 7: Verify.
- 122.2 mA < 240 mA (Imax) ✓
- 4 × 122.2 = 488.9 mA < 500 mA (budget) ✓
- 122.2/240 = 50.9% of Imax ✓

LED Circuit Design — Study Guide | Section 6 — Resistor Power Rating

### 6 Resistor Power Rating

A resistor carrying current dissipates power as heat. If this exceeds the resistor’s power rating, it will overheat and drift in value (or fail). Always calculate resistor power and select an appropriate package.

### 6.1 Calculating Resistor Power

PR = I

2
LED × R | (5)

From Example 5.1: ILED = 122.2 mA, R = 18 Ω.

PR = (0.1222)² × 18 = 0.01493 × 18 = 0.269W = 269 mW

### 6.2 Choosing the Right Package

SMD resistors come in standard packages with different power ratings:

Package | Size (mm) | Power Rating | Notes
0402 | 1.0 × 0.5 | 0.063W | Indicator LEDs (<63 mWin resistor)
0603 | 1.6 × 0.8 | 0.100W | Low-power applications
0805 | 2.0 × 1.25 | 0.125W | Moderate current
1206 | 3.2 × 1.6 | 0.25W | Recommended for power LED resistors
2512 | 6.3 × 3.2 | 1.0W | High-power applications

Tip

Always use a package rated for at least twice the calculated dissipation. This “2× derating” keeps the resistor cool and extends its life. In Example 6.1, PR = 269 mW: a 1206 rated 0.25W is marginal; consider a 2512 (1W) for a comfortable margin.

Common Mistake

The most common beginner mistake in LED driver design is using a 0402 or 0603 resistor for a power LED circuit. At 100 mAor more, the resistor can reach temperatures that change its value, cause solder joint failures, or start a fire on a PCB. Calculate PR for every design.

Quick Check 6.1

Q4. Calculate the power dissipated in the resistor for each case:
(a) Blue LED: R = 18 Ω, ILED = 114 mA. What is PR? What package do you need?
(b) Violet LED: R = 120 Ω, ILED = 18 mA. What is PR? What package do you need?
(c) Red LED: R = 24 Ω, ILED = 117 mA. What is PR? What package do you need?

LED Circuit Design — Study Guide | Section 7 — Parallel LED Groups

(See Appendix A.)

### 7 Parallel LED Groups

### 7.1 Why Parallel, Not Series?

When illuminating a surface evenly it is tempting to wire all LEDs in a single series string with one shared resistor. This section explains in detail why that approach fails when simple resistors are used, and what the correct alternative is.

### 7.1.1 How a Series String Works in Principle

In a series string every LED carries exactly the same current — there is only one path for current to flow. The resistor is calculated for the total string voltage:

R =

VCC − N · Vf

ILED

For example, 3 red LEDs (Vf = 2.2 V) on a 12 V supply at 100 mA:

R =

12 − (3 × 2.2)
0.100

=

12 − 6.6
0.100

= 54 Ω

This looks straightforward. In fact, series strings are the standard approach in commercial LED lighting — but only when paired with a constant-current driver IC that actively regulates the current regardless of what the LEDs do. The problems described below are specific to using a simple resistor instead of a driver IC.

### 7.1.2 Problem 1: A Resistor Cannot Stabilize a Series String on 5 V

The fundamental role of the resistor is to absorb the difference between the supply and the LED voltage, providing a stable current. This only works when the voltage across the resistor is large enough relative to the LED voltage variations.

With 3 red LEDs in series on a 5 V supply:

VR = 5.0 − (3 × 2.2) = 5.0 − 6.6 = −1.6 V

The math is negative — the supply voltage is not high enough for 3 red LEDs in series at all. Only 2 red LEDs fit: VR = 5.0 − 4.4 = 0.6 V, which is barely enough headroom for a resistor to function (recall the 1 V headroom rule from Section 8). For blue or green LEDs (Vf ≈ 2.8–3.0 V), even 2 in series exceeds 5 V. A 5 V supply can only drive series strings of one or two LEDs of any color — making it impractical for groups of 4 or 6.

### 7.1.3 Problem 2: Vf Production Spread Destabilizes the Whole String

Every LED from a production batch has a slightly different Vf , typically varying ±0.1–0.3 V around the nominal value. In a series string, these variations add up across all LEDs. With 4 LEDs each having a ±0.2 V spread, the total string voltage could range from 4×(2.0) = 8.0 V to 4×(2.4) = 9.6 V

LED Circuit Design — Study Guide | Section 7 — Parallel LED Groups

— a 1.6 V range. The resistor, which must absorb VCC minus the string voltage, sees its share swing widely, causing a proportional swing in current.

Because the LED I-V curve is very steep near Vf , even a small change in the net voltage affects the current dramatically. The resistor provides damping only in proportion to how large VR is compared to the total string voltage. On a 5 V supply with most of the voltage consumed by LEDs, VR is so small that the resistor provides almost no stabilization at all.

Two red LEDs, V

nom
f = 2.2 V. LED A has Vf = 2.1 V; LED B has Vf = 2.3 V. Supply: 5 V. Series, R = 30 Ω (designed for nominal):

I =

5.0 − (2.1 + 2.3)
30

=

5.0 − 4.4
30

=

0.6
30

= 20 mA

Now suppose both LEDs happen to be at V

max
f = 2.3 V:

I =

5.0 − 4.6
30

=

0.4
30

= 13 mA (35% less current)

A 0.2 V Vf shift per LED cut the current by a third because VR is tiny.
Parallel, R = 14 Ω each (designed for nominal 100 mA): LED A: IA = (5.0 − 2.1)/14 = 2.9/14 = 207 mA— wait, that exceeds Imax!
Lesson: Parallel also has issues if VR is too small. Using a 5 V supply with a proper VR ≥ 1 V: R = (5.0 − 2.2)/0.100 = 28 Ω. LED A (Vf = 2.1 V): IA = 2.9/28 = 103.6 mA. LED B (Vf = 2.3 V): IB = 2.7/28 = 96.4 mA. Only a 7% variation — each LED self-regulates independently.

### 7.1.4 Problem 3: Different Colors Cannot Share a Series String

Different LED colors have very different Vf values:

Color | Typical Vf
Red | 2.0–2.4 V
Green | 2.6–3.2 V
Blue | 2.8–3.2 V
Violet | 2.8–4.0 V

To mix a red and a blue LED in a series string on 5 V:

Vstring = 2.2 + 2.95 = 5.15 V > 5.0 V

The combined forward voltage already exceeds the supply. No current would flow at all — or if the supply voltage is slightly above nominal the LED with the lower breakdown margin could be damaged. Mixed-color series strings on 5 V are simply impossible by arithmetic.

### 7.1.5 Problem 4: One Failure Kills the Whole Group

When an LED fails, it most commonly fails open circuit (the bond wire inside breaks). In a series string, one open LED breaks the only current path and extinguishes all the others instantly. In a

LED Circuit Design — Study Guide | Section 7 — Parallel LED Groups

parallel group with individual resistors, a failed LED removes only one branch — the remaining LEDs continue operating, and the failure is immediately visible in the image as one dark spot rather than total illumination loss.

### 7.1.6 Problem 5: You Cannot Adjust LEDs Independently

In a parallel group, changing one LED’s individual resistor adjusts that LED only. This is useful during calibration. In a series string, the single resistor controls all LEDs together — there is no way to compensate for one particularly dim or bright LED without affecting the rest.

### 7.1.7 When Series Strings Are the Right Choice

It is worth understanding that commercial LED products do use series strings extensively — but with a constant-current driver IC, not a resistor. The IC continuously measures the actual current and adjusts its output voltage to keep it exactly at the target, regardless of Vf spread, temperature, or number of LEDs. This makes series strings efficient (no resistor heat loss) and tightly controlled.

For our circuit, which uses simple resistors and a fixed 5 V supply, parallel LEDs with individual resistors is the only practical approach. The resistor approach trades some efficiency for simplicity, and works well as long as VR ≥ 1 V.

### 7.1.8 Summary of Series vs. Parallel (with Resistor)

Property | Series + 1 resistor | Parallel + individual R
Works on 5 V with multiple LEDs | Rarely | Yes
Sensitive to Vf production spread | Very (cumulative) | Low (independent)
Supports mixed colors | No | Yes
Failure of one LED | All go dark | Others continue
Independent per-LED adjustment | No | Yes
Suitable for resistor-based design | No | Yes

Individual resistors with parallel LEDs is therefore the correct topology for this design. Each LED is independently current-controlled regardless of its individual Vf , the 5 V supply is fully compatible, colors can be freely mixed, and individual LEDs can be trimmed or replaced without disturbing their neighbours.

LED Circuit Design — Study Guide | Section 7 — Parallel LED Groups

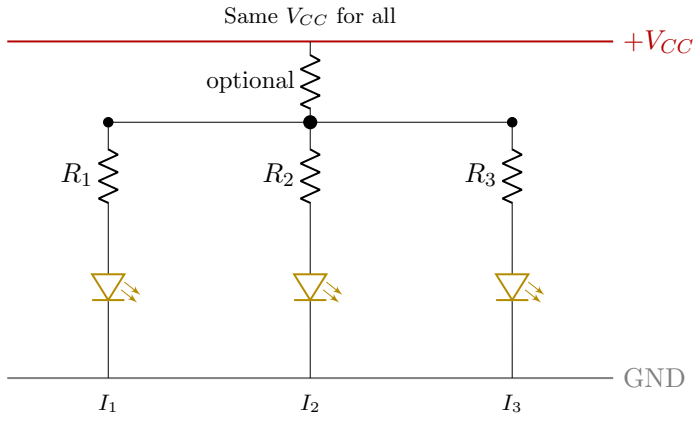
[picture p102: figure]
+VCC; GND; optional; Same VCC for all

Figure 3: Three parallel LEDs, each with its own current-setting resistor R1, R2, R3. An optional shared series resistor Rsh trims the whole group simultaneously.

### 7.2 The Optional Shared Resistor

A single shared series resistor Rsh can be added between the supply and the distribution bus to trim the brightness of the entire group without changing individual resistors. It carries the full group current:

Ish = N × ILED

Common Mistake

Rsh carries all the group current. At N = 4 and ILED = 125 mA, Ish = 500 mA. A standard 1/4W resistor rated for 250 mAwould fail. Always use a power-rated wirewound resistor (≥2W) for Rsh, or replace it with a wire (0 Ω) and use software exposure time to tune brightness.

Suppose 4 red LEDs (Vf = 2.2 V) each have R1–R4 = 22 Ω on a 5.0 V supply. Without Rsh (Rsh = 0):

ILED =

5.0 − 2.2
22

=

2.8
22

= 127 mA

Add Rsh = 10 Ω. The total resistance in series with each LED becomes:

Rtotal = Ri + N × Rsh/N

Wait — Rsh is in series with the whole group, not each LED individually. The current per LED is found by:

ILED =

VCC − Vf
Ri + Rsh

=

5.0 − 2.2
22 + 10

=

2.8
32

= 87.5 mA

Adding just 10 Ω of shared resistance reduced current from 127 mAto 87.5 mA(a 31% reduction in brightness) — a powerful and easy group trim.

LED Circuit Design — Study Guide | Section 8 — Supply Voltage

Q5. Four blue LEDs (Vf = 2.95 V, Ri = 18 Ω each) are on a 5.0 V supply.
(a) What is ILED with no shared resistor?
(b) What is Itotal?
(c) You add Rsh = 5 Ω. What is the new ILED?
(d) What power does Rsh dissipate at the current from part (b)? (See Appendix A.)

### 8 Supply Voltage Considerations

### 8.1 Headroom: Why Supply Voltage Matters

For stable current control, the voltage across the resistor (VR = VCC − Vf ) should be at least 1 V. If VR is too small, tiny variations in Vf between LEDs or with temperature cause large swings in current.

A blue LED with Vf = 2.95 V on a 3.3 V supply:

VR = 3.3 − 2.95 = 0.35 V

With R = 10 Ω: ILED = 0.35/10 = 35 mA.
But if this particular LED has Vf = 3.05 V (within production spread):

ILED = (3.3 − 3.05)/10 = 0.025 A = 25 mA

That’s a 29% current variation from a 0.1 V Vf change. The LED group will have noticeable brightness differences.
On a 5 V supply with R = 22 Ω:

ILED = (5.0 − 2.95)/22 = 93 mA (at V

typ
f

)

ILED = (5.0 − 3.05)/22 = 89 mA (at V

typ
f + 0.1)

Only a 4.3% variation. The 5 V supply gives much better current stability.

### 8.2 LDOs and the 5 V Supply Problem

A Linear Dropout Regulator (LDO) produces a regulated output voltage from an input. But it requires the input to be higher than the output by at least the dropout voltage (VDO):

Vin ≥ Vout + VDO

Common Mistake

You cannot regulate 5 V from a 5 V supply. Even the best LDOs have VDO ≥ 0.1 V. A 5.0 V-to-5.0 V LDO would require 5.1 V input minimum, and most need 5.5–6.2 V. If your supply is exactly 5 V, connect the LED circuit directly to the supply (with bypass capacitors)

LED Circuit Design — Study Guide | Section 9 — The MOSFET Switch

rather than through an LDO.

Regulator | VDO | Min Input for 5 V out

Verdict for 5 V supply

LM7805 | ∼2.0 V | 7.0 V | Cannot use on 5 V supply
LD1117 | ∼1.2 V | 6.2 V | Cannot use on 5 V supply
LM2940 | ∼0.5 V | 5.5 V | Cannot use on 5 V supply
MCP1700 | ∼0.18 V | 5.18 V | Still cannot use on 5 V supply
Direct connection | 0 | 5.0 V | Correct choice

Q6. You have a 9 V DC adapter powering an LED circuit. You want to produce a clean 5 V rail for the LEDs.
(a) Can you use an LM7805 (needs Vin ≥ 7 V)?
(b) How much power does the LM7805 dissipate at 400 mAload current?
(c) Would you need a heatsink on the LM7805?
(See Appendix A.)

### 9 The MOSFET Switch

LEDs in this design are switched on and off by a microcontroller (the Raspberry Pi). Because the GPIO pin can only supply about 16 mA, we use a transistor to switch the much larger LED current.

### 9.1 Why a MOSFET?

A Metal-Oxide-Semiconductor Field-Effect Transistor (MOSFET) is ideal for this application:

- The gate (control input) draws virtually zero current — it only needs a voltage.
- A logic-level N-channel MOSFET turns fully on with a gate voltage of 2–3 V, well within the 3.3 V GPIO output.
- When fully on, the drain-to-source resistance RDS(on)
is very low (milliohms to tens of milliohms), so it drops very little voltage.

### 9.2 The Gate Circuit

Two small resistors protect the MOSFET gate:

LED Circuit Design — Study Guide | Section 10 — Case Study: Violet LED

GPIO
1 kΩ

Rpd

To LED group cathodes

RDS(on) ≈ 77 mΩ

Figure 4: MOSFET gate circuit. Rg limits the current spike when the gate capacitance charges. Rpd holds the gate at 0 V when the GPIO pin is not actively driving it.

- Rg (1 kΩ): The gate has a small capacitance. Without a series resistor, turning on the MOSFET would demand a large current spike from the GPIO to charge it. 1 kΩ limits this to 3.3 V/1000 Ω = 3.3 mA, well within GPIO capability.
- Rpd (100 kΩ): During boot, software crashes, or GPIO reconfiguration, the pin may float. Without Rpd, the gate could float to any voltage and partially turn on the LEDs at an uncontrolled time. Rpd ensures the gate is firmly at 0 V (LED off) unless the GPIO actively drives it high.

Q7. A MOSFET with RDS(on) = 0.077 Ω switches a group of 4 LEDs drawing a total of 490 mA.
(a) What voltage drops across the MOSFET when it is on?
(b) How much power does the MOSFET dissipate?
(c) Does it need a heatsink?
(See Appendix A.)

### 10 Reading the Violet LED Datasheet: A Case Study

The violet LED used in this project (supplier row 1015, 410 nm dominant wavelength) illustrates several important real-world complications.

LED Circuit Design — Study Guide | Section 10 — Case Study: Violet LED

### 10.1 What the Datasheet Says

Parameter | Value
Dominant wavelength | 410 nm

Forward voltage V

typ f | 2.8 V

Forward voltage V

max f | 4.0 V
Maximum current Imax | 30 mA
Maximum power Pmax | 120 mW
Package | 0603 SMD

### 10.2 Design Implications

The Vf spread is very wide: from 2.8 V to 4.0 V — a 1.2 V range. This means different LEDs from the same reel can behave very differently on the same resistor.

The Imax is very low: only 30 mA. This is consistent with Pmax = V

max
f × Imax = 4.0 × 0.030 =
120 mW. It confirms that the datasheet is internally consistent.

Given: VCC = 5.0 V, R = 120 Ω (chosen to give Medium brightness at typical Vf ). At V

typ
f = 2.8 V:

ILED =

5.0 − 2.8
120

=

2.2
120

= 18.3 mA

PLED = 2.8 × 18.3 = 51.2 mW (< 120 mW✓)

%Imax = 18.3/30 = 61% (Medium level✓)

At V

max
f = 4.0 V:

ILED =

5.0 − 4.0
120

=

1.0
120

= 8.3 mA

PLED = 4.0 × 8.3 = 33.3 mW (< 120 mW✓)

Conclusion: The same 120 Ω resistor gives 8.3 mAto 18.3 mAdepending on the individual LED’s Vf . This is a 2.2× variation in brightness. For a measurement application, this is acceptable because the camera exposure time compensates for group-level brightness; within the group, brighter LEDs simply have a lower Vf .
Why 6 LEDs instead of 4? At only 18 mAeach, a single 0603 violet LED is much dimmer than one power LED. Using 6 multiplies total brightness by 1.5× at minimal cost, while keeping each LED safely within its 30 mAlimit. Total group current = 6 × 18.3 = 110 mA. Well within budget.

LED Circuit Design — Study Guide | Section 12 — Comprehensive Exercises

### 11 Putting It All Together: Design Checklist

□ Choose LEDs matching wavelength, package, and price goals.

□ Record V

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
, Imax, Pmax from the datasheet.

□ Check supply voltage headroom: VR = VCC − V

typ
f ≥ 1 V.

□ Decide number of LEDs N per group.

□ Select operating current ILED (target 50–75% of Imax).

□ Check power budget: N × ILED ≤ Ibudget. Reduce ILED if necessary.

□ Calculate Rcalc = (VCC − V

typ
f

)/ILED.

□ Round to nearest E24 value RE24.

□ Calculate actual current I

act
LED = (VCC − V

typ
f

)/RE24.

□ Verify I

act
LED < Imax and N × I

act
LED < Ibudget.

□ Calculate resistor power PR = (I

act
LED)

2 × RE24.

□ Select resistor package rated for at least 2 × PR.

□ Check V

max
f

scenario: verify LED still lights at minimum current.

□ Select MOSFET with ID > N × I

act
LED, logic-level gate threshold < 3.3 V.

□ Add gate resistor (1 kΩ) and pull-down (100 kΩ).
□ Add bypass capacitors (100 µF bulk + 100 nF ceramic at supply input; 10 µF near each LED group).

□ Add polyfuse (hold current ≥ max group current, trip ≤ 1 A).

### 12 Comprehensive Exercises

Work through each exercise completely, showing all steps. Check your answers in Appendix A.

Exercise 1. Design a circuit for a single blue LED on a 3.3 V supply.
LED specs: V

typ
f = 2.75 V, V

max
f = 3.1 V, Imax = 30 mA.
Target: Medium brightness.
(a) What is I

target
LED at Medium level?
(b) What is VR using V

typ
f

?
(c) Is the headroom (VR) adequate? (Is it ≥1 V?)
(d) Calculate Rcalc.
(e) What is the nearest E24 value?
(f) What is I

actual
LED ?
(g) What is the resistor power PR? What package do you need?
(h) What is ILED at V

max
f

? Does the LED still light?

LED Circuit Design — Study Guide | Appendix A — Answer Key

Exercise 2. You have four red LEDs (Vf = 2.2 V, Imax = 250 mA) on a 5 V supply. Your current budget is 400 mA(not 500 mA— this supply is more constrained).
(a) What is the maximum allowed current per LED?
(b) What percentage of Imax is that?
(c) Calculate Rcalc for this current.
(d) Round to E24. What is I

actual
LED and Itotal?
(e) Calculate PR. What package?
(f) Now recalculate for Low and High brightness. Can you reach High within budget?

Exercise 3. A green LED has V

typ
f = 2.80 V and V

max
f = 3.20 V. You choose R = 18 Ω on a 5.0 V supply.
(a) What is ILED at V

typ
f

?
(b) What is ILED at V

max
f

?
(c) What is the ratio I(V

max
f

)/I(V

typ
f

) expressed as a percentage?
(d) Is the headroom (VR at V

max
f

) at least 1 V?
(e) Repeat for a supply of 3.3 V with R = 2 Ω. What do you notice?

Exercise 4. Design resistors for all four channels of a color analyzer. Supply: 5.0 V, budget: 500 mAper group. Use Medium brightness (but cap at budget limit). LEDs:
Channel | V typ f | Imax | N LEDs | Notes
Violet | 2.80 V | 30 mA | 6 | Estimated Imax
Blue | 2.95 V | 240 mA | 4
Green | 2.80 V | 240 mA | 4
Red | 2.20 V | 250 mA | 4

For each channel: (a) target current per LED, (b) Rcalc, (c) RE24, (d) I

| | | | actual LED , (e) Itotal, (f)
PR and minimum package.

Exercise 5. For each scenario, state whether the proposed resistor package is adequate, marginal, or dangerously undersized, and explain why.
(a) ILED = 20 mA, R = 100 Ω, package = 0402 (63 mWrating)
(b) ILED = 120 mA, R = 18 Ω, package = 0603 (100 mWrating)
(c) ILED = 115 mA, R = 24 Ω, package = 1206 (250 mWrating)
(d) ILED = 80 mA, R = 20 Ω, package = 0805 (125 mWrating)

A Answer Key

LED Circuit Design — Study Guide | Appendix A — Answer Key

Quick Check 2.1

Blue LED, Vf = 2.95 V, VCC = 5 V, target ILED = 80 mA.

VR = 5.0 − 2.95 = 2.05 V

Rcalc =

2.05
0.080

= 25.6 Ω

Nearest E24: 25.6 Ω → divide by 10 → 2.56 → nearest E24 values are 2.4 and 2.7. Distance: |2.56 − 2.4| = 0.16; |2.56 − 2.7| = 0.14. Nearest is 2.7 → 27 Ω.
Actual current: ILED = 2.05/27 = 75.9 mA(slightly under target, fine).

Quick Check 3.1

Vf = 2.8 V, Imax = 240 mA, Pmax = 800 mW, I = 150 mA.
(a) PLED = 2.8 × 0.150 = 0.42W= 420 mW.
(b) 420 mW < 800 mW — within limit. ✓
(c) 150/240 = 62.5% of Imax.

Quick Check 4.1

Red LED, Imax = 250 mA, 4 LEDs, 500 mAbudget.
(a) IMedium = 0.60 × 250 = 150 mAper LED.
(b) Itotal = 4 × 150 = 600 mA. Exceeds 500 mAbudget.
(c) Imax,LED = 500/4 = 125 mAper LED.
(d) 125/250 = 50% of Imax. Still a reasonable operating point.

Quick Check 6.1

(a) Blue: PR = (0.114)² × 18 = 0.01300 × 18 = 234 mW. Need 1206 (250 mW) minimum; 2× derating suggests 2512 (1W).
(b) Violet: PR = (0.018)² × 120 = 0.000324 × 120 = 38.9 mW. 0402 (63 mW) is adequate; 0603 comfortable.
(c) Red: PR = (0.117)² × 24 = 0.01369 × 24 = 328 mW. Exceeds 1206 (250 mW) rating — use 2512 (1 W) or use R = 27 Ω to reduce current slightly.

LED Circuit Design — Study Guide | Appendix A — Answer Key

Quick Check 7.1

Blue LEDs, Vf = 2.95 V, Ri = 18 Ω, VCC = 5.0 V, N = 4.
(a) ILED = (5.0 − 2.95)/18 = 2.05/18 = 113.9 mA.
(b) Itotal = 4 × 113.9 = 455.6 mA.
(c) With Rsh = 5 Ω: ILED = (5.0 − 2.95)/(18 + 5) = 2.05/23 = 89.1 mA.
(d) PRsh = (0.4556)² × 5 = 0.2076 × 5 = 1.04W. Must use a wirewound resistor rated ≥2W.

Quick Check 8.1

9 V supply, LM7805 (needs Vin ≥ 7 V), 400 mAload.
(a) Yes. 9 V ≥ 7 V. The LM7805 can be used.
(b) Power dissipated in LM7805 = (Vin − Vout) × I = (9 − 5) × 0.4 = 4 × 0.4 = 1.6W.
(c) Yes, a heatsink is required. The LM7805 in TO-220 can only dissipate about 1W without a heatsink in free air. At 1.6W it will overheat and go into thermal shutdown. Use a clip-on TO-220 heatsink.

Quick Check 9.1

IRL540N MOSFET, RDS(on) = 0.077 Ω, I = 490 mA.
(a) VDS = I × RDS(on) = 0.490 × 0.077 = 37.7 mV. Negligible.
(b) PF ET = I

2 × RDS(on) = (0.490)² × 0.077 = 0.240 × 0.077 = 18.5 mW.
(c) No heatsink needed. 18.5 mWis far below the TO-220 package’s thermal limit. The device will barely warm up.

Exercise 12.1

Blue LED, V

typ
f = 2.75 V, V

max
f = 3.1 V, Imax = 30 mA, VCC = 3.3 V.
(a) IMedium = 0.60 × 30 = 18 mA.
(b) VR = 3.3 − 2.75 = 0.55 V.
(c) Headroom is inadequate. 0.55 V < 1 V. Current will be very sensitive to Vf variation. This supply-LED combination is marginal at best.
(d) Rcalc = 0.55/0.018 = 30.6 Ω.
(e) Nearest E24: 30 Ω.
(f) ILED = 0.55/30 = 18.3 mA.
(g) PR = (0.0183)² × 30 = 0.000335 × 30 = 10.0 mW. 0402 is fine (63 mWrated).
(h) At V

max
f = 3.1 V: VR = 3.3 − 3.1 = 0.2 V. ILED = 0.2/30 = 6.7 mA. The LED is very dim but still lit. Key lesson: a 3.3 V supply is too close to the Vf of blue LEDs for stable, repeatable results. Use 5 V if possible.

LED Circuit Design — Study Guide | Appendix A — Answer Key

Exercise 12.2

Red LED, Vf = 2.2 V, Imax = 250 mA, N = 4, VCC = 5 V, budget=400 mA.
(a) Imax/LED = 400/4 = 100 mA.
(b) 100/250 = 40% of Imax. This is the Low level.
(c) Rcalc = (5.0 − 2.2)/0.100 = 2.8/0.100 = 28 Ω.
(d) Nearest E24: 27 Ω. ILED = 2.8/27 = 103.7 mA. Itotal = 4 × 103.7 = 414.8 mA. Slightly over 400 mA; use 30 Ω instead. ILED = 2.8/30 = 93.3 mA. Itotal = 373.3 mA. ✓
(e) PR = (0.0933)² × 30 = 261 mW. Use 1206 (250 mW) or larger.
(f) Low with 30 Ω: done above.
Medium (60%): Itarget = 150 mA; Itotal = 600 mA— exceeds 400 mAbudget. Medium must be capped at 100 mA(same as Low for this budget).
High (80%): Itarget = 200 mA; Itotal = 800 mA— far over budget. High is not achievable within a 400 mAbudget with 4 LEDs at Imax = 250 mA. The budget limits this design to approximately the Low operating level.

Exercise 12.3

Green LED, V

typ
f = 2.80 V, V

max
f = 3.20 V, R = 18 Ω, VCC = 5.0 V.
(a) ILED(V

typ
f

) = (5.0 − 2.80)/18 = 2.20/18 = 122.2 mA.
(b) ILED(V

max
f

) = (5.0 − 3.20)/18 = 1.80/18 = 100.0 mA.
(c) 100.0/122.2 = 81.8%. The dimmest LED produces 82% of the brightest LED’s output — an 18% variation. Acceptable for most applications.
(d) VR at V

max
f = 5.0 − 3.2 = 1.8 V > 1 V. ✓Adequate headroom.
(e) At 3.3 V with R = 2 Ω: ILED(V

typ
f

) = (3.3 − 2.8)/2 = 0.5/2 = 250 mA. Exceeds Imax!

ILED(V

max
f

) = (3.3 − 3.2)/2 = 0.1/2 = 50 mA. The ratio is 50/250 = 20%: a 5× variation. The low-voltage supply makes the circuit extremely sensitive to Vf variation.

Exercise 12.4

Ch. | Itarget | Rcalc | RE24 | Iact | Itot | PR | Package
Violet | 18.0 mA | 122.2 Ω | 120 Ω | 18.3 mA | 110 mA | 39.9 mW | 0402
Blue | 114 mA* | 18.0 Ω | 18 Ω | 113.9 mA 455 mA | 234 mW | 1206
Green | 122 mA* | 18.0 Ω | 18 Ω | 122.2 mA 489 mA | 268 mW | 1206
Red | 117 mA* | 23.9 Ω | 24 Ω | 116.7 mA 467 mA | 327 mW | 2512
*Budget-constrained: 500 mA/4 = 125 mA max; round to nearest E24 that keeps Itotal ≤ 500 mA. Violet: Imax = 30 mA, Medium = 0.60 × 30 = 18 mA; 6 LEDs ×18.3 = 110 mA. Red: 22 Ωgives Itotal = 509 mA(over); use 24 Ω.

LED Circuit Design — Study Guide | Appendix A — Answer Key

Exercise 12.5

(a) PR = (0.020)² × 100 = 40 mW. 0402 rated 63 mW: 40 < 63. Adequate, though 2× derating suggests 0603 for comfort.
(b) PR = (0.120)² × 18 = 259 mW. 0603 rated 100 mW: 259 ≫ 100. Dangerously undersized. The resistor will overheat and fail. Use 1206 at minimum.
(c) PR = (0.115)²×24 = 317 mW. 1206 rated 250 mW: 317 > 250. Marginal to undersized. Exceeds the 1206 rating. Use 2512 (1W) for 2× derating. At minimum, increase R to reduce current slightly.
(d) PR = (0.080)² × 20 = 128 mW. 0805 rated 125 mW: 128 ≈ 125. Marginal. Barely at the limit; 2× derating is violated. Use 1206 for safety.
