panibillo/Colorimeter/Study_guides/sensors-16-01649-v2.pdf

## sensors (http://www.mdpi.com/journal/sensors)

Article

# Ultraviolet Imaging with Low Cost Smartphone Sensors: Development and Application of a Raspberry Pi-Based UV Camera

Thomas C. Wilkes 1,*, Andrew J. S. McGonigle 1,2, Tom D. Pering 1

, Angus J. Taggart 1
,
Benjamin S. White 3

, Robert G. Bryant 1 and Jon R. Willmott 3

1 | Department of Geography, The University of Sheffield, Winter Street, Sheffield S10 2TN, UK;
| a.mcgonigle@sheffield.ac.uk (A.J.S.M.); t.pering@sheffield.ac.uk (T.D.P.); a.taggart@sheffield.ac.uk (A.J.T.);
| r.g.bryant@sheffield.ac.uk (R.G.B.)
2 | Istituto Nazionale di Geofisica e Vulcanologia, Sezione di Palermo, via Ugo La Malfa 153,
| Palermo 90146, Italy
3 | Department of Electronic and Electrical Engineering, The University of Sheffield, Portobello Centre,
| Pitt Street, Sheffield S1 4ET, UK; ben.white@sheffield.ac.uk (B.S.W.); j.r.willmott@sheffield.ac.uk (J.R.W.)
* | Correspondence: tcwilkes1@sheffield.ac.uk; Tel.: +44-7798-837-894

Academic Editor: Gonzalo Pajares Martinsanz
Received: 5 September 2016; Accepted: 3 October 2016; Published: 6 October 2016

Abstract: Here, we report, for what we believe to be the first time, on the modification of a low cost sensor, designed for the smartphone camera market, to develop an ultraviolet (UV) camera system. This was achieved via adaptation of Raspberry Pi cameras, which are based on back-illuminated complementary metal-oxide semiconductor (CMOS) sensors, and we demonstrated the utility of these devices for applications at wavelengths as low as 310 nm, by remotely sensing power station smokestack emissions in this spectral region. Given the very low cost of these units, ≈ USD 25, they are suitable for widespread proliferation in a variety of UV imaging applications, e.g., in atmospheric science, volcanology, forensics and surface smoothness measurements.

Keywords: UV camera; UV imaging; smartphone sensor technology; sulphur dioxide emissions; Raspberry Pi; low-cost camera

### 1. Introduction

Ultraviolet (UV) imaging has a wide variety of scientific, industrial and medical applications, for instance in forensics [1], industrial fault inspection [2], astronomy, monitoring skin conditions [3] and in remote sensing [4,5]. To date, scientific grade UV cameras, which have elevated quantum efficiencies in this spectral region, have been applied in this context. However, these systems are relatively expensive (typical unit costs thousands of dollars) and can be power intensive, since they may incorporate thermo-electric cooling. Although these units may provide high signal-to-noise ratios, a lower price point solution could expedite more widespread implementation of UV imaging. Recently, considerable effort has been invested in developing low cost back-illuminated complementary metal-oxide semiconductor (CMOS) sensor technology. Previously, this sensor architecture was applied only within specialist, low light imaging arenas, e.g., in astronomy. In the last few years, however, the manufacturing costs of these devices have been reduced markedly, such that they now feature prominently in consumer electronic products, particularly smartphones. The key advantage of the back-illuminated sensor architecture, over the conventional CMOS configuration, is that the photo-diodes are placed in front of the metal wiring matrix layer of the sensor, thereby improving fill factor and substantially increasing optical throughput to the photoreceptors, particularly in the UV, where these detectors are photosensitive.

Sensors 2016, 16, 1649; doi:10.3390/s16101649 | www.mdpi.com/journal/sensors

Sensors 2016, 16, 1649 | 2 of 8

To date, however, application of these inexpensive sensors has predominantly been focused on visible imaging, due to the choice of fore-optics and the Bayer filter layer applied to the sensors, in order to generate red-green-blue (RGB) mosaics. Recent studies have highlighted that these smartphone cameras do have some UV sensitivity [6–8], even with the above optical arrangement. Here, we build on this work by modifying such a camera sensor, to maximize UV throughput to the sensor. To the best of our knowledge, this constitutes the first report of an imaging system specifically adapted for the UV, based on a back-illuminated CMOS device developed for the smartphone market. In particular, we developed a UV camera system, based on Raspberry Pi camera boards, and demonstrated its utility for UV imaging applications down to 310 nm, via a case study involving remote sensing of sulphur dioxide (SO2) emissions from a power station smokestack.

### 2. UV Camera Development

This work was achieved using Raspberry Pi Camera Module v1.3 boards (referred to as PiCams hereafter), of cost ≈ USD 25 (Raspberry Pi Foundation). The PiCam is based on an Omnivision OV5647 back-illuminated CMOS sensor, developed primarily for the mobile phone market; the OV5647 is a 1/4” 5-megapixel (2592 × 1944 active array) backlit-CMOS unit, with 8-/10-bit RGB/RAW image output. PiCam boards were chosen here due to the ease of data acquisition and image processing using Raspberry Pi computer boards (Raspberry Pi Foundation), via the Python programming language. Due to their low expense and power consumption, Raspberry Pi computers are increasingly being used in a variety of sensing applications (e.g., [9,10]). Whilst this work is focused on one sensor type, preliminary tests with another such back-illuminated CMOS device, the Sony IMX219 (Sony Corporation, Minato, Tokyo, Japan), also evidence UV sensitivity.
The PiCam lens and filter, housed above the sensor within a plastic casing unit, both absorb the UV signal, and were therefore removed as a first step to developing the UV camera. This was achieved chemically using a Posistrip® EKC830TM (DuPont, Wilmington, DE, USA) bath. To improve UV sensitivity of the sensor, we then removed the microlens and Bayer filter layers, the latter of which masks the sensor in a mosaic of RGB colour filters (Figure 1), and attenuates much of the incident UV radiation. This process effectively turns the PiCam into a monochrome sensor.

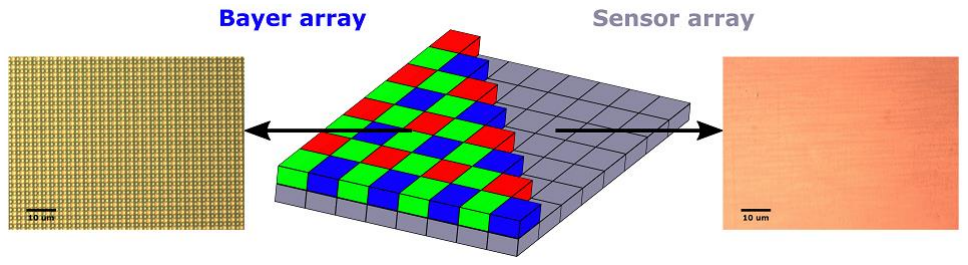
[picture p103: figure]

Figure 1. A schematic (Centre) of the Bayer filter array and its positioning on the photodetector array. Also shown are microscope images of the PiCam sensor pre- (Left) and post- (Right) Bayer removal process.

Whilst the filter can be removed by careful scratching (a range of tools, such as metal tweezers or a pointed wooden object, can be used for this process), a far more uniform finish is achievable chemically; we adopted the latter approach using a five step procedure. We first submerged the sensors in photoresist remover (Posistrip® EKC830TM) and heated (70–100 ◦C) until the filter was entirely removed; this generally takes 10–30 minutes, depending on the level of applied heating and agitation. A second bath of this remover was then applied to optimise the cleaning procedure. Following this, the photoresist remover was washed from the sensor by a three stage cleaning procedure, using successive baths of n-butyl acetate, acetone and isopropyl alcohol. All the above chemicals were applied undiluted. For each of these steps, the sensor was submerged on the order of minutes, to ensure a thorough cleaning. Careful and rigorous application of this methodology can result in uniform and clean sensors which exhibit greatly enhanced UV sensitivity relative to non-de-Bayered units. For example, a clear-sky image taken with a partially de-Bayered unit, captured through a 310 nm filter and with a shutter speed of 400 ms, exhibits an increase of ≈ 600% in a de-Bayered region relative to the unmodified section of the sensor.
For image capture, it is necessary to retrieve RAW sensor data, rather than the standard JPEG image output, as the former excludes the de-Bayering algorithm and image processing, which results in a non-linear response from the sensor. This, and all the below acquisition and processing steps were achieved with in-house authored Python codes. Here the RAW images were saved to the camera, where they were stored in the metadata of the 8-bit JPEG image. These binary data are then extracted and saved as PNG images, to preserve the 10-bit RAW digital number (DN) format, in files of ≈ 6 MB. These images could then be straightforwardly processed and analysed.
A UV transmissive anti-reflection (AR) coated plano-convex quartz lens of 6 mm diameter and 9 mm focal length (Edmund Optics Ltd., Barrington, NJ, USA; $100), was then mounted to the fore of the PiCam, using an in-house designed, 3D printed lens holder, attached to the board using its pre-existing mount holes; this provided a field of view of ≈ 28◦
. This lens housing consists of two parts, enabling straightforward focusing via screw thread adjustment. As the housing covers the entire camera board, it was necessary to disable the board’s light-emitting diode (LED), which, by default, is programmed to turn on during image acquisition (see Figure 2). By way of comparison: the all in cost of this camera configuration (e.g., PiCam, lens, filter, filter holder, chemical removal costs) including a UV bandpass filter is ≈ USD 200–300, depending on the filter, in comparison to a typical figure of at least ten times the upper value, for such a system based on currently available scientific grade UV cameras.

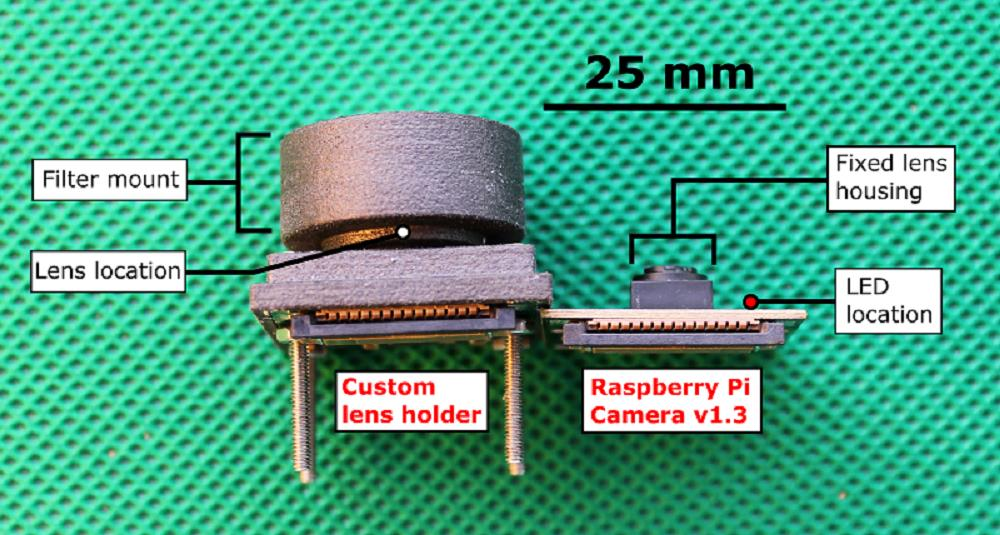
[picture p104: figure]

Figure 2. A profile image of the Raspberry Pi Camera Module (Right), and the modified system with custom built optics (Left). The custom design is bolted to the camera board using the pre-existing mount holes.

Following construction of the imaging system, the sensor linearity, which is important for quantitative applications, and UV sensitivity were tested. This was achieved by mounting a UV bandpass filter, of 12.5 mm diameter, centred on 310 nm and of 10 nm full width at half maximum (FWHM) (Edmund Optics Ltd.) to the fore of the camera lens; these filters have no other transmission features in the spectral sensitivity range of the CMOS detectors.
To test the UV sensor response, images of uniformly illuminated clear-sky were taken through the 310 nm filter at varying shutter speeds; these experiments were performed in Sheffield, UK, at approximately 11:00 local time (solar zenith angle of around 50◦
), during February 2016. At each shutter speed four images were captured and analog gain was fixed throughout, for consistency; the operating software does not allow gain specification, but it does enable this to be fixed, following stabilization of the system after the camera start-up process. By averaging pixel DNs from a 800 × 600 pixel region in the centre of each image, we observed a linear increase in average pixel DN relative to shutter speed, for the RAW 10-bit sensor data (Figure 3A). Furthermore, the RAW images demonstrated near saturation at shutter speeds well below 1 s, in a spectral region where there is very little skylight due to ozone absorption, indicating usable UV sensor sensitivity.

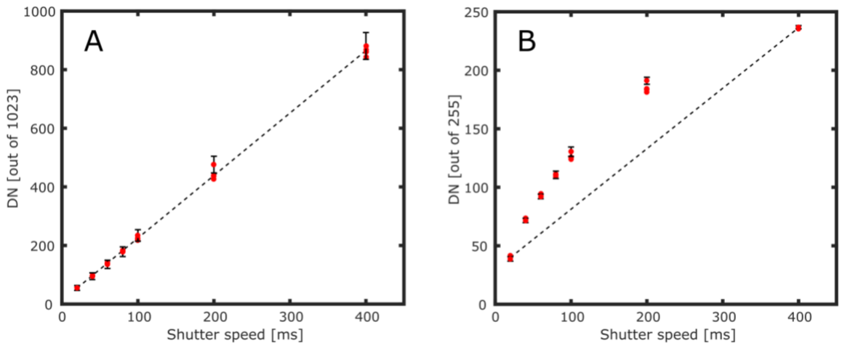
[picture p105: figure]

Figure 3. Plots of average pixel signal (in digital number; DN) vs. shutter speed (ms) for a cropped region (800 × 600 pixels) of clear-sky images taken at 310 nm: (A) the 10-bit RAW image output shows a linear increase in DN with respect to shutter speed; (B) the 8-bit standard output JPEG image shows a non-linear response in all three of the red-green-blue (RGB) channels (Red-channel DNs are plotted here) in line with gamma correction. An error bar is inserted on one data point per exposure time, indicating the standard deviation of the pixel intensities in the cropped region; the bar heights are approximately the same for all points of equivalent shutter speed, and just one bar is displayed for clarity.

### 3. Measurements of Power Station Sulphur Dioxide Emissions

Sulphur dioxide has strong UV absorption bands between 300 and 320 nm [11], which have been exploited in a range of atmospheric remote sensing measurements of this species, using differential optical absorption spectroscopy and UV imagery [12–14]. In particular, power stations release SO2 to the atmosphere from their smokestacks, and remotely sensing these emissions is one means of ensuring regulatory compliance and constraining effects on the atmosphere [4,5,15,16].
In order to demonstrate proof of concept of the utility of the developed sensors for UV imaging applications, we deployed two UV PiCam units at Drax power station in the United Kingdom over a ≈ 15 min period on 15 August 2016. Bandpass filters, centred at 310 and 330 nm (10 nm FWHM; Edmund Optics Ltd.), were mounted to the fore of the co-aligned cameras, one on one unit, with the other filter on the other camera. Both devices simultaneously imaged the rising smokestack plume. Shutter speeds of ≈ 300 and 40 ms, respectively, were applied for the cameras, in view of the greater scattered skylight intensity at the latter wavelength, and images were acquired at 0.25 Hz. Camera-to-camera pixel mapping was achieved subsequently in software, using the smokestack as a reference. The acquisition and retrieval protocols followed those of Kantzas et al. [17], in particular by collecting dark images for each camera, which were subtracted from all acquired sky images. Clear sky images, taken adjacent to the plume, were also acquired, then normalised to generate a mask, which all acquired plume images were divided by; this eliminates vignetting as well as any sensor non-uniformity which may have resulted from the de-Bayering process. As SO2 absorbs at 310 nm, but not at 330 nm, contrasting resulting images provides a means of constraining the spatial distribution of gas concentration across the field of view, whilst eliminating sources of extinction common to both wavelengths, e.g., due to aerosols. In particular, SO2 apparent absorbance (AA) for each pixel was determined using the following relation [17]:

AA = −log10
IP310

IB310

. IP330

IB330
(1)

where IP is the in-plume intensity, and IB is the background intensity, taken as the average value in the clear sky adjacent to the rising gas plume; the subscripts specify the camera filter in question, for the dark subtracted, mask corrected imagery. Calibration of AA was then carried out using quartz cells containing known column amounts of SO2 (in our case 0, 300 and 900 ppm.m), in particular measuring AA values for each cell when pointing at plume free sky, plotting concentration vs. these, and then multiplying all acquired plume image AA values by this gradient. The cell column amounts were verified using an Ocean Optics Inc. USB2000 spectrometer, using the VolcanoSO2 differential optical absorption spectroscopy code [18].
Figure 4C shows a typical calibrated SO2 image, after binning pixels to a 648 × 486 array to reduce noise, highlighting the ability of the cameras to clearly resolve the smokestack emissions. Furthermore, background image noise levels are remarkably low (typically ≈ 25 ppm.m standard deviation in a 648 × 486 binned image), in contrast to values of ≈ 30 ppm.m, previously reported from more expensive scientific grade camera systems in atmospheric SO2 monitoring [5], indicating the potential of these low cost units in UV imaging applications.

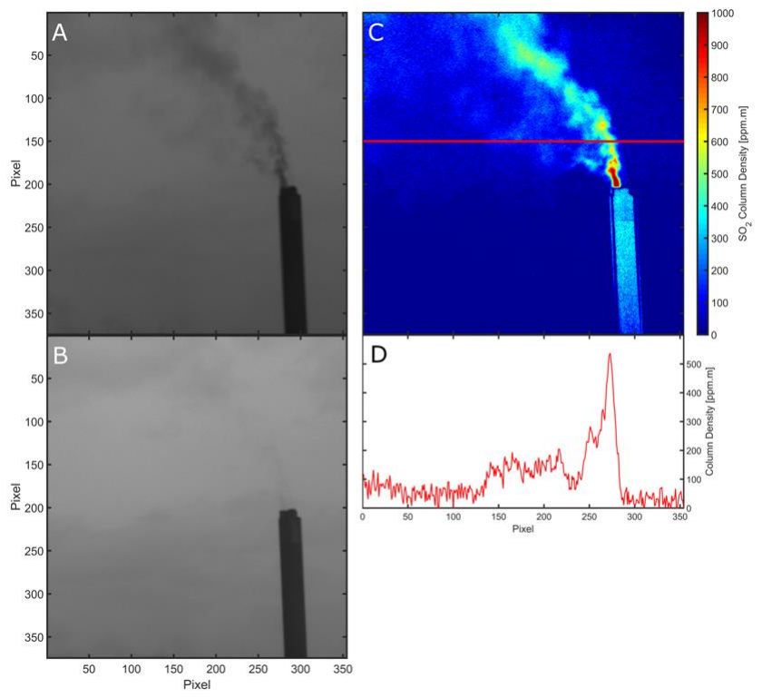
[picture p106: figure]

Figure 4. (A) A cropped image of the Drax smokestack taken at 310 nm with a shutter speed of 300 ms. The initial image pixels are binned to generate a pixel resolution of 648 × 486, to reduce noise; dark image subtraction and mask corrections have been applied. (B) As in (A) but at 330 nm with a shutter speed of 40 ms. (C) The resulting calibrated SO2

image of Drax power station stack and plume showing the clear capacity of the system to resolve the plume emissions. (D) A cross-section of (C) showing gas concentrations along the row delineated by the red line. The background noise level can be clearly observed between pixels 300 to 350.

By integrating across the plume, perpendicular to the plume transport direction, integrated column amounts (ICAs) of SO2 were obtained, and a time series of ICAs through successive images was produced. A plume speed of ≈4.9 m/s was calculated by generating two such ICA time series, determined for parallel plume cross sections, located at different distances from the source, and then cross correlating these. This plume speed was then multiplied by the ICA values to generate a SO2 flux time series, as shown in Figure 5. The SO2 flux was found to be relatively stable from the smokestack, with a mean emission of 0.44 kg/s; nevertheless, notable gas “puffs” are apparent, and can be seen both in the flux time series and SO2 absorption image video (see Video S1 in the supplementary materials). The Drax Annual Reviews of Environmental Performance [19], provide the best available ancillary emissions data for comparison, stating annual SO2 loadings ranging 24.5–35.1 kt/yr for the period 2008–2013, and thus, average annual fluxes ranging 0.78–1.1 kg/s. These data corroborate our observations, falling within an order of magnitude, given that Drax’s operational output will fall somewhat below the mean annual value during the British summer.

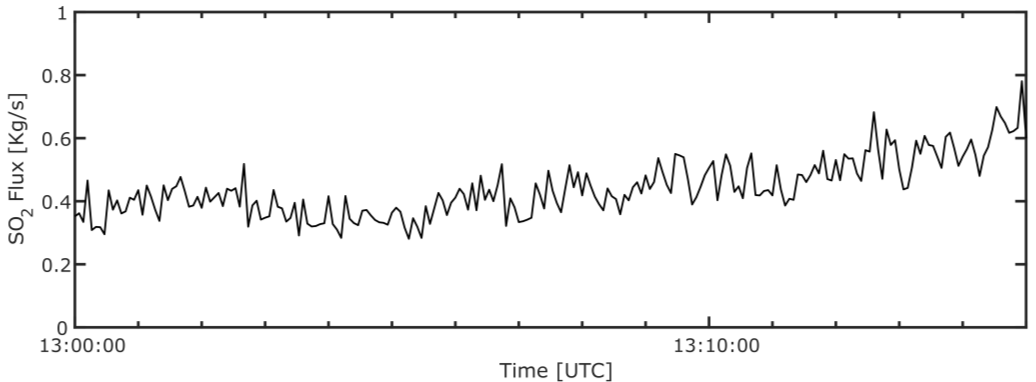
[picture p107: figure]

Figure 5. Time series of SO2 flux from Drax power station for a 15 min acquisition period.

### 4. Discussion and Concluding Remarks

In this paper we have presented, for the first time, a relatively simple methodology for the development of low-cost UV cameras, based on inexpensive sensors developed for the smartphone market. We show that by modification of Raspberry Pi camera sensors, and rebuilding of the optical systems, camera boards as cheap as ≈ USD 25 can be adapted to applications down to wavelengths of at least 310 nm. The potential utility of such devices in UV imaging applications was illustrated via a case study, in which we used the cameras to perform ultraviolet remote sensing of SO2 fluxes from a power station smokestack.
With this in mind, other possible areas in which this technology could be applied include, but are not limited to: ground-based mineral aerosol detection (331/360 nm), to mimic satellite based TOMS retrievals [20,21], monitoring skin conditions [3,22], forensics during crime scene investigation [1,23], fault detection in power systems [2], fault detection in vehicles, and astronomy. The low cost would be of particular benefit in application areas where budgets are limited, or arrays of these units are required. One example of such a scenario is in the field of volcanology, where UV cameras are used to image SO2 emissions in volcanic plumes [4,24,25] as a means of investigating magmatic processes. As many volcanoes are located in developing countries, lower cost sensors could greatly expedite more comprehensive monitoring of global volcanic hazards, with allowance for sensor destruction in the event of explosions.
One potential current limitation to this system is its maximum achievable frame rate. The shutter speeds used here at the power station (300 ms at 310 nm) correspond to a theoretically achievable acquisition rate of >1 Hz. However, in reality obtainable frame rates are rather lower due to on chip processing. Preliminary tests suggest that framerates >0.5 Hz are achievable, however, over prolonged periods this resulted in sporadic dropping of frames, which disappeared altogether for acquisition at

0.25 Hz. More work is required to identify the limiting factor in frame capture, and whether stable higher acquisition rates might be achievable with further software optimisation. For the majority of applications, however, we suggest that framerates of 0.25 Hz will be more than adequate.
Future work could focus on the spectral range of such units; the sensitivity of this system below 310 nm has not been quantified herein, and whilst the sensors do likely respond at deeper UV wavelengths, there may be a trade off in terms of signal to noise. Investigating the longer wavelength cut off of these monochrome devices could also be of interest, in establishing their use in high temperature thermal imaging applications. Other work may include consideration of thermal effects on sensor stability/noise, and the degree to which cooling/temperature stabilisation might improve signal to noise. Finally, whilst signal to noise levels appear promising here, particularly given the low sensor price point, further work is now also merited in comparing the system sensitivity and noise characteristics against more expensive scientific grade UV cameras.

Supplementary Materials: The following are available online at http://www.mdpi.com/1424-8220/16/10/1649/s1, (http://www.mdpi.com/1424-8220/16/10/1649/s1) Video S1: Absorbance image sequence of Drax SO2 emissions. Warmer colours indicate larger SO2 column densities. Images were captured at 0.25 Hz, and this video sequence is speeded up to eight times real-time.

Acknowledgments: This work was funded by a Scholarship from the University of Sheffield, awarded to TCW. TCW would like to thank the Raspberry Pi community (found at https://www.raspberrypi.org/forums/), who provided great support whilst working with the PiCam module. We would also like to thank Matthew Davies for his help in selecting the object lens used herein. TDP acknowledges the support of a NERC studentship (NE/K500914/1) and AMcG acknowledges a Leverhulme Trust Research Fellowship (RF-2016-580).

Author Contributions: The paper was written by T.C.W and A.Mc.G. Development of the camera system and data processing/analysis was predominantly performed by T.C.W.; A.Mc.G. aided in initial camera tests, in the field work, and is the supervisor; T.D.P. provided the initial concept and aided in field work; A.T. aided in early-stage camera development and software development for camera control; B.W. devised and performed the methodology for removal of the Bayer filter from the camera sensor; R.B. is a co-supervisor; J.R.W. aided in the development of the camera optics.

Conflicts of Interest: The authors declare no conflict of interest. The founding sponsors had no role in the design of the study; in the collection, analyses, or interpretation of data; in the writing of the manuscript, and in the decision to publish the results.

References

1. Krauss, T.; Warlen, S. The Forensic Science Use of Reflective Ultraviolet Photography BT—The Forensic Science Use of Reflective Ultraviolet Photography. J. Forensic Sci. 1985, 30, 262–268. [CrossRef] (http://dx.doi.org/10.1520/JFS10991J) [PubMed] (http://www.ncbi.nlm.nih.gov/pubmed/3981118)
2. Chen, Z.; Wang, P.; Yu, B. Research of UV detection system based on embedded computer. World Automation Congress 2008. Available online: http://ieeexplore.ieee.org/stamp/stamp.jsp?tp=&arnumber=4699210&isnumber=4698939 (http://ieeexplore.ieee.org/stamp/stamp.jsp?tp=&arnumber=4699210&isnumber=4698939) (accessed on 26 August 2016).
3. Fulton, J.E. Utilizing the Ultraviolet (UV Detect) Camera to Enhance the Appearance of Photodamage and Other Skin Conditions. Dermatol. Surg. 1997, 23, 163–169. [CrossRef] (http://dx.doi.org/10.1111/j.1524-4725.1997.tb00013.x) [PubMed] (http://www.ncbi.nlm.nih.gov/pubmed/9145957)
4. McElhoe, H.B.; Conner, W.D. Remote Measurement of Sulfur Dioxide Emissions Using an Ultraviolet Light Sensitive Video System. JAPCA J. Air Pollut. Control Assoc. 1986, 36, 42–47. [CrossRef] (http://dx.doi.org/10.1080/00022470.1986.10466043)
5. Smekens, J.-F.; Burton, M.R.; Clarke, A.B. Validation of the SO2 camera for high temporal and spatial resolution monitoring of SO2 emissions. J. Volcanol. Geoth. Res. 2015, 300. [CrossRef] (http://dx.doi.org/10.1016/j.jvolgeores.2014.10.014)
6. Igoe, D.; Parisi, A.V.; Carter, B. Characterization of a smartphone camera’s response to ultraviolet a radiation. Photochem. Photobiol. 2013, 89, 215–218. [CrossRef] (http://dx.doi.org/10.1111/j.1751-1097.2012.01216.x) [PubMed] (http://www.ncbi.nlm.nih.gov/pubmed/22862556)
7. Igoe, D.; Parisi, A.V. Evaluation of a Smartphone Sensor to Broadband and Narrowband Ultraviolet A Radiation. Instrum. Sci. Technol. 2015, 43, 283–289. [CrossRef] (http://dx.doi.org/10.1080/10739149.2014.1002039)
8. Igoe, D.; Parisi, A.V. Broadband direct UVA irradiance measurement for clear skies evaluated using a smartphone. Radiat. Prot. Dosim. 2015, 167, 485–489. [CrossRef] (http://dx.doi.org/10.1093/rpd/ncu344) [PubMed] (http://www.ncbi.nlm.nih.gov/pubmed/25449750)
9. Moure, D.; Torres, P.; Casas, B.; Toma, D.; Blanco, M.J.; Del Río, J.; Manuel, A. Use of Low-Cost Acquisition Systems with an Embedded Linux Device for Volcanic Monitoring. Sensors 2015, 15, 20436–20462. [CrossRef] (http://dx.doi.org/10.3390/s150820436) [PubMed] (http://www.ncbi.nlm.nih.gov/pubmed/26295394)
10. Schlobohm, J.; Pösch, A.; Reithmeier, E. A Raspberry Pi Based Portable Endoscopic 3D Measurement System. Electronics 2016, 5. [CrossRef] (http://dx.doi.org/10.3390/electronics5030043)

11. Vandaele, A.C.; Simon, P.C.; Guilmot, J.M.; Carleer, M.; Colin, R. SO2 absorption cross section measurements in the UV using a Fourier transform spectrometer. J. Geophys. Res. 1994, 99, 25599–25605. [CrossRef] (http://dx.doi.org/10.1029/94JD02187)
12. Mori, T.; Burton, M.R. The SO2 camera: A simple, fast and cheap method for ground-based imaging of SO2 in volcanic plumes. Geophys. Res. Lett. 2006, 33. [CrossRef] (http://dx.doi.org/10.1029/2006GL027916)
13. Kantzas, E.P.; McGonigle, A.J.S. Ground Based Ultraviolet Remote Sensing of Volcanic Gas Plumes. Sensors 2008, 8, 1559–1574. [CrossRef] (http://dx.doi.org/10.3390/s8031559)
14. Theys, N.; De Smedt, I.; van Gent, J.; Danckaert, T.; Wang, T.; Hendrick, F.; Stavrakou, T.; Bauduin, S.; Clarisse, L.; Li, C.; et al. Sulfur dioxide vertical column DOAS retrievals from the Ozone Monitoring Instrument: Global observations and comparison to ground-based and satellite data. J. Geophys. Res. Atmos. 2015, 120, 2470–2491. [CrossRef] (http://dx.doi.org/10.1002/2014JD022657)
15. Millán, M.M. Remote sensing of air pollutants. A study of some atmospheric scattering effects. Atmos. Environ. 1980, 14, 1241–1253. [CrossRef] (http://dx.doi.org/10.1016/0004-6981(80)90226-7)
16. McGonigle, A.J.S.; Thomson, C.L.; Tsanev, V.I.; Oppenheimer, C. A simple technique for measuring power station SO2 and NO2 emissions. Atmos. Environ. 2004, 38, 21–25. [CrossRef] (http://dx.doi.org/10.1016/j.atmosenv.2003.09.048)
17. Kantzas, E.P.; McGonigle, A.J.S.; Tamburello, G.; Aiuppa, A.; Bryant, R.G. Protocols for UV camera volcanic SO2 measurements. J. Volcanol. Geoth. Res. 2010, 194, 55–60. [CrossRef] (http://dx.doi.org/10.1016/j.jvolgeores.2010.05.003)
18. McGonigle, A.J.S. Measurement of volcanic SO2 fluxes with differential optical absorption spectroscopy.
J. Volcanol. Geotherm. Res. 2007, 162, 111–122. [CrossRef] (http://dx.doi.org/10.1016/j.jvolgeores.2007.02.001)
19. Annual review of Environmental Performance, Drax, 2013. Available online: http://www.drax.com/media/56551/Environmental-Performance-Review-2013.pdf (http://www.drax.com/media/56551/Environmental-Performance-Review-2013.pdf) (accessed on 26 August 2016).
20. Torres, O.; Bhartia, P.K.; Herman, J.R.; Ahmad, Z.; Gleason, J. Derivation of aerosol properties from satellite measurements of backscattered ultraviolet radiation: Theoretical basis. J. Geophys. Res. Atmos. 1998, 103, 17099–17110. [CrossRef] (http://dx.doi.org/10.1029/98JD00900)
21. Sinyuk, A.; Torres, O.; Dubovik, O. Combined use of satellite and surface observations to infer the imaginary part of refractive index of Saharan dust. Geophys. Res. Lett. 2003, 30. [CrossRef] (http://dx.doi.org/10.1029/2002GL016189)
22. Mahler, H.M.; Kulik, J.A.; Harrell, J.; Correa, A.; Gibbons, F.X.; Gerrard, M. Effects of UV photographs, photoaging information, and use of sunless tanning lotion on sun protection behaviors. Arch. Dermatol. 2005, 141, 373–380. [CrossRef] (http://dx.doi.org/10.1001/archderm.141.3.373) [PubMed] (http://www.ncbi.nlm.nih.gov/pubmed/15781679)
23. Yosef, N.; Almog, J.; Frank, A.; Springer, E.; Cantu, A. Short UV Luminescence for Forensic Applications: Design of a Real-Time Observation System for Detection of Latent Fingerprints and Body Fluids.
J. Forensic Sci. 1998, 43, 299–304. [CrossRef] (http://dx.doi.org/10.1520/JFS16136J) [PubMed] (http://www.ncbi.nlm.nih.gov/pubmed/9544537)
24. Bluth, G.; Shannon, J.; Watson, I.M.; Prata, A.J.; Realmuto, V. Development of an ultra-violet digital camera for volcanic SO2

imaging. J. Volcanol. Geoth. Res. 2007, 161, 47–56. [CrossRef] (http://dx.doi.org/10.1016/j.jvolgeores.2006.11.004)
25. Peters, N.; Hoffmann, A.; Barnie, T.; Herzog, M.; Oppenheimer, C. Use of motion estimation algorithms for improved flux measurements using SO2 cameras. J. Volcanol. Geoth. Res. 2015, 300, 58–69. [CrossRef] (http://dx.doi.org/10.1016/j.jvolgeores.2014.08.031)

© 2016 by the authors; licensee MDPI, Basel, Switzerland. This article is an open access article distributed under the terms and conditions of the Creative Commons Attribution (CC-BY) license (http://creativecommons.org/licenses/by/4.0/).
