panibillo/Colorimeter/tex/figs/R-inf-guide-C1020-royal-blue.B-3.pdf

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

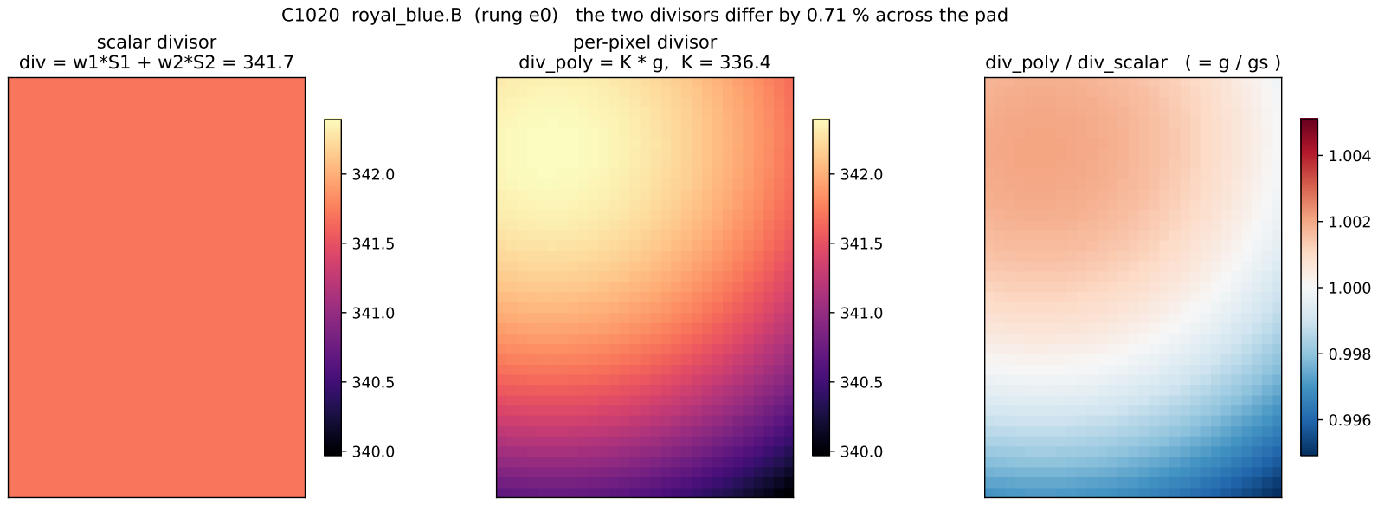
[picture p108: page 1]
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
