panibillo/Colorimeter/tex/figs/R-inf-guide-C1020-royal-blue.B-4.pdf

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

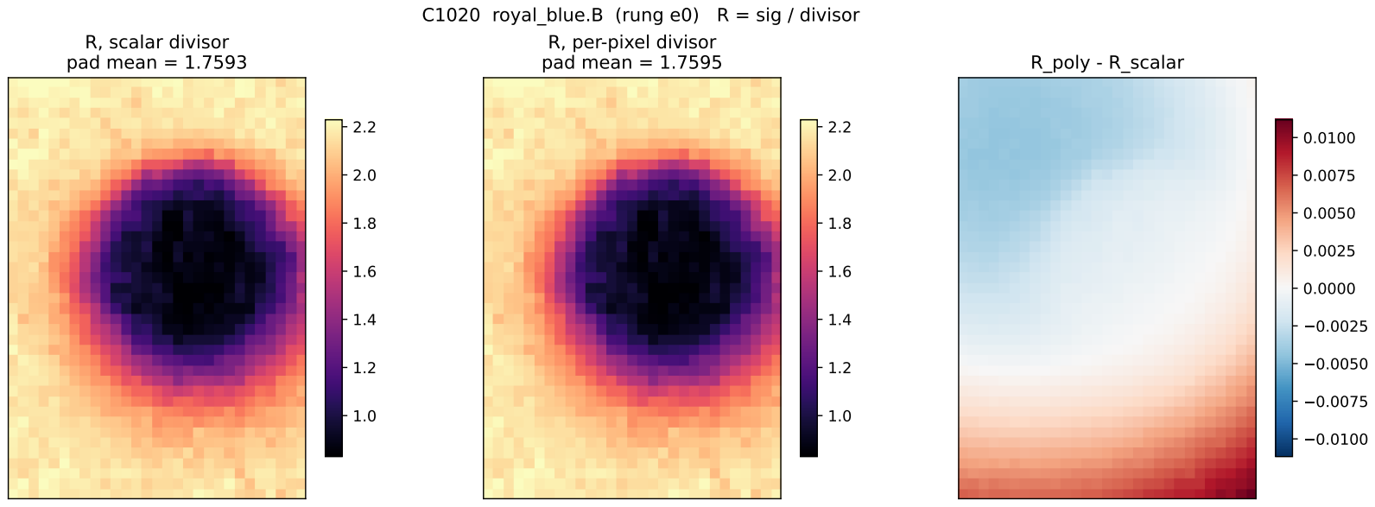
[picture p109: page 1]
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
