panibillo/Colorimeter/desktop/padanalysis/fig/R_guide_C1020_royal_blue.B_6.png

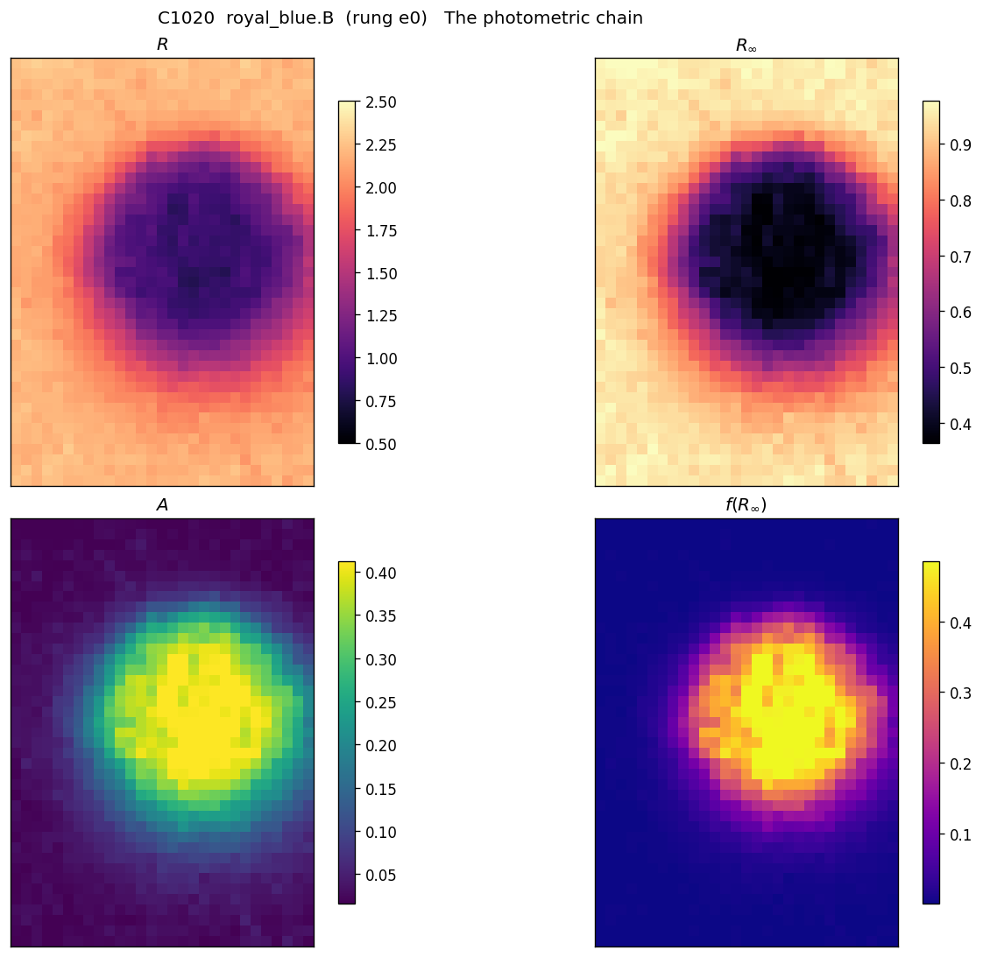
desktop/padanalysis/fig/R_guide_C1020_royal_blue.B_6.png
