panibillo/Colorimeter/desktop/padanalysis/fig/R_inf_guide_C1020_survey.png

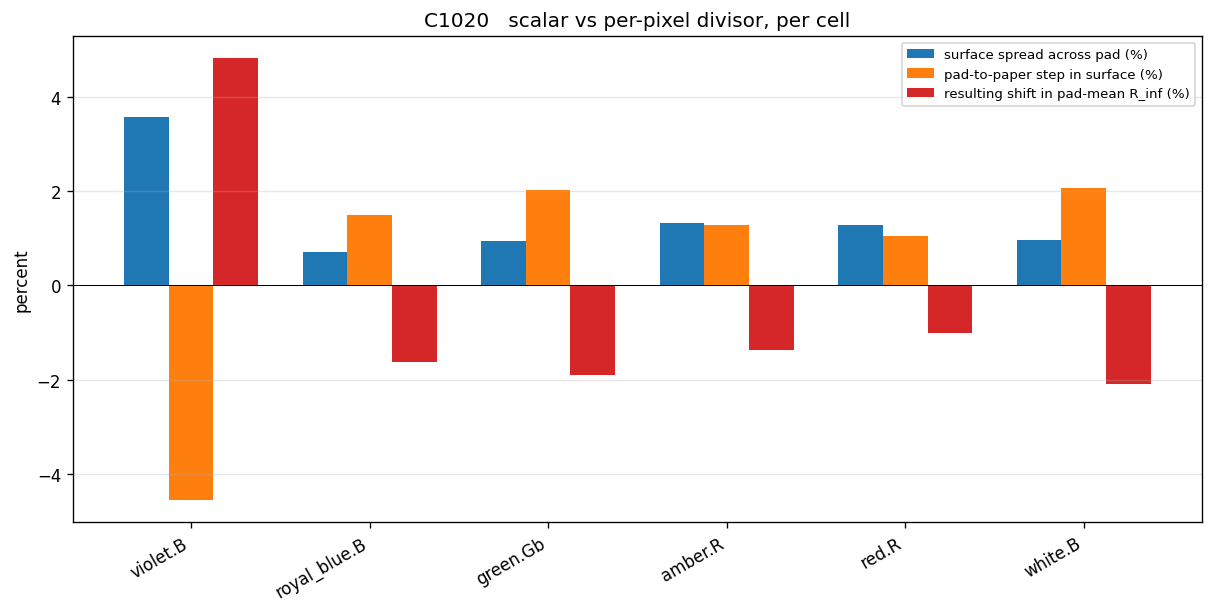
desktop/padanalysis/fig/R_inf_guide_C1020_survey.png
