panibillo/Colorimeter/docs/commissioning/05_testing.md

# Step 5 — Test

**Status:** 🟡 mostly ready

Goal: prove each peripheral works, install the two systemd services, run the
application by hand, then confirm it auto-starts at boot. Do these in order —
stop and fix anything that fails before moving on.

← [04_ssh.md](04_ssh.md) · Back to [master guide](../RPi_commissioning.md) · Re-entering? [00_reentry.md](00_reentry.md) · Next → [06_calibration.md](06_calibration.md)

> ⚠ **Re-running these on a unit where 5d is already installed?** Stop the app
> service first — `sudo systemctl stop colorimeter` — then start it again (or
> reboot) when you finish. A running `main.py` holds the display, camera, and
> I2C bus, so 5a's probes and 5c's hand-run will contend with it and fail in ways
> that look like hardware faults. `Restart=on-failure` means a killed instance
> comes back on its own. Every step on this page is otherwise safe to repeat.

---

## 5a — Verify peripherals (scripted)

Run the bundled checker on the Pi. It confirms SPI0, SPI1, I2C (+ the TSC2007 at
`0x48`), 1-Wire (+ a `28-*` probe and a temperature read), the GPIO character
device (`gpiozero`/`lgpio` backends — no daemon), the camera, and the USB
keyboard (`evdev` + `input` group), printing a ✓/✗ line for each.

```bash
# On the Pi:
~/pi/Colorimeter/provisioning/verify_peripherals.sh
```

If any line is ✗, jump to [07_troubleshooting.md](07_troubleshooting.md) or the
[cal8 reference guide](../../edocs/rpi_configuration_guide_for_cal8.md) for that
bus, fix it, and re-run. The script makes no system changes and is safe to run
repeatedly — but its `i2cdetect` and `rpicam-hello` probes do touch live buses,
so stop `colorimeter.service` first if it is already installed.

Manual spot checks it wraps (run individually if you want detail):

```bash
ls /dev/spidev0.0 /dev/spidev1.0 /dev/i2c-1       # buses present
sudo i2cdetect -y 1                                # touch at 0x48
cat /sys/bus/w1/devices/28-*/w1_slave              # probe temperature (…t=NNNNN)
pinctrl get 20                                     # SPI1 MOSI → ALT-func (not input)
ls /dev/gpiochip0                                  # GPIO char device (gpiozero/lgpio)
python3 -c 'import gpiozero, lgpio'                # backlight + beeper libs import
rpicam-hello --list-cameras                        # camera detected
python3 -c 'import evdev; print(evdev.list_devices())'   # keyboard node visible
groups | tr ' ' '\n' | grep -x input               # in the input group (keyboard)
```

> ⚠ An empty list from `evdev.list_devices()` is ambiguous: it means either no
> keyboard is plugged in **or** you are not in the `input` group — `evdev` needs
> r/w on the nodes and silently skips those it cannot open. Check `groups`
> before suspecting the hardware.

---

## 5b — Boot-time LED safe-state service

On the cal8 board the LEDs hang off the 74HC595 shift register, which can latch
a stray bit **on** during boot. `colorimeter-gpio-init.service` clears it after
boot (writes `0x00`, pulses RCLK) and forces the direct-control pins low. The
application service is ordered to start **after** it.

Install it with the bundled script (on the Pi, after step 3d uploaded the
`provisioning/` set):

```bash
# On the Pi:
~/pi/Colorimeter/provisioning/install_gpio_init_service.sh
```

It copies `colorimeter-gpio-init.sh` to `/usr/local/bin/`, writes the
`colorimeter-gpio-init.service` unit, then enables and starts it. Confirm:

```bash
systemctl status colorimeter-gpio-init.service    # → active (exited), SUCCESS
```

> **Manual alternative:** the same unit can be created by hand — full recipe in
> **[edocs/rpi_configuration_guide_for_cal8.md — Step 12](../../edocs/rpi_configuration_guide_for_cal8.md)**.
> The installer just automates it.

> A short (~10–15 s) LED-on flash during boot, until this service runs, is
> expected with the software-only fix. See the guide's note on the hardware fix
> for the next PCB revision.

---

## 5c — Run the application by hand (smoke test)

Before wiring it into boot, confirm `main.py` starts on real hardware:

```bash
# On the Pi:
cd ~/pi/Colorimeter
.venv/bin/python3 src/main.py
```

Expect: the ILI9341 shows the entry screen, the backlight is on, touch responds,
and there are no traceback/import errors in the console. The DB line
(`… db_manager.py using db: …/src/colorimeter.sqlite`) should point at the DB
you copied in step 3c. Exit with **Ctrl-C** (graceful shutdown).

If it fails on imports, the venv is the usual cause — see
[07_troubleshooting.md](07_troubleshooting.md#venv-import-fails-make_venvsh).

---

## 5d — Install the auto-start service

Once the hand-run works, install the boot-launch unit (idempotent — safe to
re-run after code changes):

```bash
# On the Pi:
~/pi/Colorimeter/provisioning/install_colorimeter_service.sh
```

This writes `/etc/systemd/system/colorimeter.service` (User=*whoever runs the
script* — e.g. `mgwwg` on a new unit, `bill` on rpizero1 — auto-detected via
`whoami`, not hardcoded; `WorkingDirectory=~/pi/Colorimeter`, launching via the
venv interpreter),
`daemon-reload`s, enables, and starts it. Watch it:

```bash
systemctl status colorimeter --no-pager
journalctl -u colorimeter -f          # live logs; Ctrl-C to stop watching
```

To undo: `~/pi/Colorimeter/provisioning/uninstall_colorimeter_service.sh`
(leaves the gpio-init service and all files untouched).

---

## 5e — Full reboot test (the real proof)

```bash
# On the Pi:
sudo reboot
```

After it comes back (~30–60 s), from a fresh SSH session:

```bash
systemctl is-enabled colorimeter.service colorimeter-gpio-init.service   # both "enabled"
systemctl status colorimeter --no-pager                                  # active (running)
```

And look at the instrument itself: the display should reach the entry screen on
its own, with **no LED stuck on** after the initial boot flash, and touch
working. That is a commissioned unit.

---

Next → [06_calibration.md](06_calibration.md) — touchscreen, focus, exposure,
and measurement calibration (partly awaiting software).
