panibillo/Colorimeter/edocs/LED_design/LED_Test_observations.ods

Sheet: Sheet1
SMD LED testing |  |  |  |  |  |  |  |  | Vcc (out) | Calculated as Vcc-Vr
A | Led’s connected to power supply with no resistor |  |  |  |  |  |  |  | A | Observed while LED is lit: should be well below Set level
B | Led’s connected to power supply with POT |  |  |  |  |  |  |  | Vr | Vr is measured across the resistor while the LED is lit
C Blue | Clear Blue
J Blue | Cree J Series JE2835 Color LEDs
J Green | Cree J Series JE2835 Color LEDs |  |  | Vcc |  | Green: Selected for cal8 box 1
J Red | Cree J Series JE2835 Color LEDs |  |  | 5
 |  |  |  | Vr is measured across the resistor while the LED is lit
 | A |  |  | Calculations |  | B
 | Vcc (out) | Amp (obs) | Note | Vr | R = V/I | R actual | Vcc – set | A obs | A*4
C Blue | 3.24 | 0.029 | max | 1.76 | 61 | 65.24 | 5 | 0.027 | 0.108
J Violet | 2.962 | 0.024 | max | 2.038 | 85 | 82 | 5 | 0.024 | 0.096
J Violet | 3.12 | 0.063 | max | 1.88 | 30 | 30 | 5 | 0.063 | 0.252
J Royal Blue | 2.1 | 0.071 | max | 2.9 | 41 | 30 | 5 | 0.071 | 0.284
J Blue | 2.63 | 0.023 | max | 2.37 | 103 | 105 | 5 | 0.220 | 0.88
J Blue | 2.86 | 0.072 | max | 2.14 | 30 | 30 | 5 | 0.072 | 0.288 | To bright
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
