panibillo/Colorimeter/test/TEST_SUITE_QUICK_REFERENCE.md

# Test Suite Quick Reference

## Directory Structure
```
test/
├── __init__.py                         (Python package marker)
├── README.md                           (Test suite overview)
├── test_bayer_display.py               (Main test module - 150 lines)
├── TEST_BAYER_DISPLAY_GUIDE.md        (Detailed guide)
├── TEST_SUITE_QUICK_REFERENCE.md      (This file)
└── bayer_display.png                  (Output: generated by test)
```

## Quick Start (30 seconds)

```bash
cd /home/bill/eclipse-workspace1/Colorimeter
python test/test_bayer_display.py
```

## What This Test Does

| Step | Action | Verification |
|---|---|---|
| 1 | Load `cfg5_sbggr1_raw_00.npy` | ✓ File exists and readable |
| 2 | Check file format | ✓ Shape (1232, 1640), dtype uint16 |
| 3 | Extract 4 Bayer layers | ✓ Each layer (616, 820) |
| 4 | Validate data ranges | ✓ Values in 0–1023 (10-bit) |
| 5 | Display in 2×2 grid | ✓ Visual inspection possible |
| 6 | Save PNG output | ✓ Output file created |

## Expected Output

### Console
```
✓ Loaded successfully
✓ Shape matches config 5 (1640×1232)
✓ Dtype is uint16 (10-bit Bayer in 16-bit container)
B  (BGGR['B']): (616, 820), min=    0, max= 1023, mean= 512.5
Gb (BGGR['Gb']): (616, 820), min=    0, max= 1023, mean= 512.5
Gr (BGGR['Gr']): (616, 820), min=    0, max= 1023, mean= 512.5
R  (BGGR['R']): (616, 820), min=    0, max= 1023, mean= 512.5
✓ Test completed successfully!
```

### Figure
2×2 subplots with colormaps:
- **[0,0] Blue** (Blues)
- **[0,1] Green-Blue** (Greens)
- **[1,0] Green-Red** (Greens)
- **[1,1] Red** (Reds)

## Requirements

**Python packages**:
```bash
pip install numpy matplotlib
```

**Test data file**:
```
mock_camera/cfg5_sbggr1_raw_00.npy  (1232×1640 uint16)
```

## Common Issues & Fixes

| Problem | Fix |
|---|-----|
| FileNotFoundError | `mkdir mock_camera/` then generate test files |
| ModuleNotFoundError: matplotlib | `pip install matplotlib` |
| Wrong shape warning | Ensure file is cfg5 (1640×1232) not other config |
| All zeros output | File exists but not populated; regenerate from RPi |
| Can't find mock directory | Run from: `/home/bill/eclipse-workspace1/Colorimeter` |

## File API Reference

### `extract_bayer_layers(bayer_array) → dict`
Extract BGGR pattern into separate layers.

```python
from test.test_bayer_display import extract_bayer_layers
import numpy as np

bayer = np.load("mock_camera/cfg5_sbggr1_raw_00.npy")
layers = extract_bayer_layers(bayer)

# Access layers
blue_layer = layers['B']    # (616, 820)
green_layer = layers['Gb']  # (616, 820)
red_layer = layers['R']     # (616, 820)
```

### `plot_bayer_layers(bayer_array, output_file=None) → (fig, axes)`
Display layers in 2×2 subplot grid.

```python
from test.test_bayer_display import plot_bayer_layers
import numpy as np

bayer = np.load("mock_camera/cfg5_sbggr1_raw_00.npy")
fig, axes = plot_bayer_layers(bayer, output_file="output.png")
# Opens matplotlib window, saves PNG if output_file specified
```

### `main() → bool`
Full test execution with file loading and validation.

```python
from test.test_bayer_display import main

success = main()  # Returns True if test passed
```

## Usage Examples

### Example 1: Run Test (Simplest)
```bash
python test/test_bayer_display.py
```

### Example 2: Import in Your Code
```python
import sys
sys.path.insert(0, "test")
from test_bayer_display import extract_bayer_layers, plot_bayer_layers
import numpy as np

bayer = np.load("mock_camera/cfg5_sbggr1_raw_00.npy")
layers = extract_bayer_layers(bayer)
plot_bayer_layers(bayer, "my_output.png")
```

### Example 3: Programmatic Analysis
```python
from test.test_bayer_display import extract_bayer_layers
import numpy as np

bayer = np.load("mock_camera/cfg5_sbggr1_raw_00.npy")
layers = extract_bayer_layers(bayer)

# Analyze each layer
for name, layer in layers.items():
    print(f"{name}: mean={layer.mean():.1f}, max={layer.max()}")
```

### Example 4: Batch Process All Configs
```python
from test.test_bayer_display import plot_bayer_layers
from pathlib import Path
import numpy as np

mock_dir = Path("mock_camera")
for cfg in [4, 5, 6]:
    npy_file = mock_dir / f"cfg{cfg}_sbggr1_raw_00.npy"
    if npy_file.exists():
        bayer = np.load(npy_file)
        plot_bayer_layers(bayer, f"test/cfg{cfg}_display.png")
```

## Test Verification Checklist

```
□ File loads without error
□ Shape is (1232, 1640)
□ Dtype is uint16
□ Min value ≥ 0
□ Max value ≤ 1023
□ All 4 layers display
□ Colormaps match (blue, green, green, red)
□ PNG file created successfully
□ Console shows ✓ for all checks
```

## Next Steps After Test Passes

1. ✓ Verify mock_Picamera2 can load this file
2. ✓ Test color analysis on Bayer data
3. ✓ Run all 6 configs through complete pipeline
4. ✓ Integration test with colorimeter.py

## Documentation Files

| File | Purpose |
|---|---|
| README.md | Overview of test suite |
| test_bayer_display.py | Main test module (executable) |
| TEST_BAYER_DISPLAY_GUIDE.md | Detailed guide & troubleshooting |
| TEST_SUITE_QUICK_REFERENCE.md | This file - quick lookup |

## Key Functions

```python
extract_bayer_layers(array) → {B, Gb, Gr, R} layers
plot_bayer_layers(array, file=None) → (fig, axes)
main() → bool
```

## Running from Different Locations

```bash
# From Colorimeter root
python test/test_bayer_display.py

# From test directory
cd test
python test_bayer_display.py

# From anywhere (add to path)
python -c "
import sys
sys.path.insert(0, '/home/bill/eclipse-workspace1/Colorimeter')
from test.test_bayer_display import main
main()
"
```
