panibillo/Colorimeter/docs/Calibration_dilution_calcs.ods

Calculations for a Colorimeter calibration run
Start with 1000 ml of 500 ug/l concentration
Take off 5 samples. Each diluted slightly. Slight dilutions shown in order, but randomize. This dithers the data. Allows actual visualization of 1% diffs.
Dilluting distilled water vol | Source concentration | Net source vol | sample vol from source | diluting distilled water vol | sample concentration
ml | ug/ml | ml | ml | ml | ug/l
Initial | 500 | 1000 | 100 | 0 | 500
 | 500 | 900 | 99 | 1 | 495
 | 500 | 801 | 98 | 2 | 490
 | 500 | 703 | 97 | 3 | 485
 | 500 | 606 | 96 | 4 | 480
 | 500 | 510 | 10
500 | 250 | 1000 | 100 | 0 | 250
 | 250 | 900 | 99 | 1 | 247.5
 | 250 | 801 | 98 | 2 | 245
 | 250 | 703 | 97 | 3 | 242.5
 | 250 | 606 | 96 | 4 | 240
 | 250 | 510 | 10
500 | 125 | 1000 | 100 | 0 | 125
 | 125 | 900 | 99 | 1 | 123.75
 | 125 | 801 | 98 | 2 | 122.5
 | 125 | 703 | 97 | 3 | 121.25
 | 125 | 606 | 96 | 4 | 120
 | 125 | 510 | 10
500 | 62.5 | 1000 | 100 | 0 | 62.5
 | 62.5 | 900 | 99 | 1 | 61.875
 | 62.5 | 801 | 98 | 2 | 61.25
 | 62.5 | 703 | 97 | 3 | 60.625
 | 62.5 | 606 | 96 | 4 | 60
 | 62.5 | 510 | 10
500 | 31.25 | 1000 | 100 | 0 | 31.25
 | 31.25 | 900 | 98 | 2 | 30.625
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
