panibillo/Colorimeter/edocs/circuits/test_light_1.png

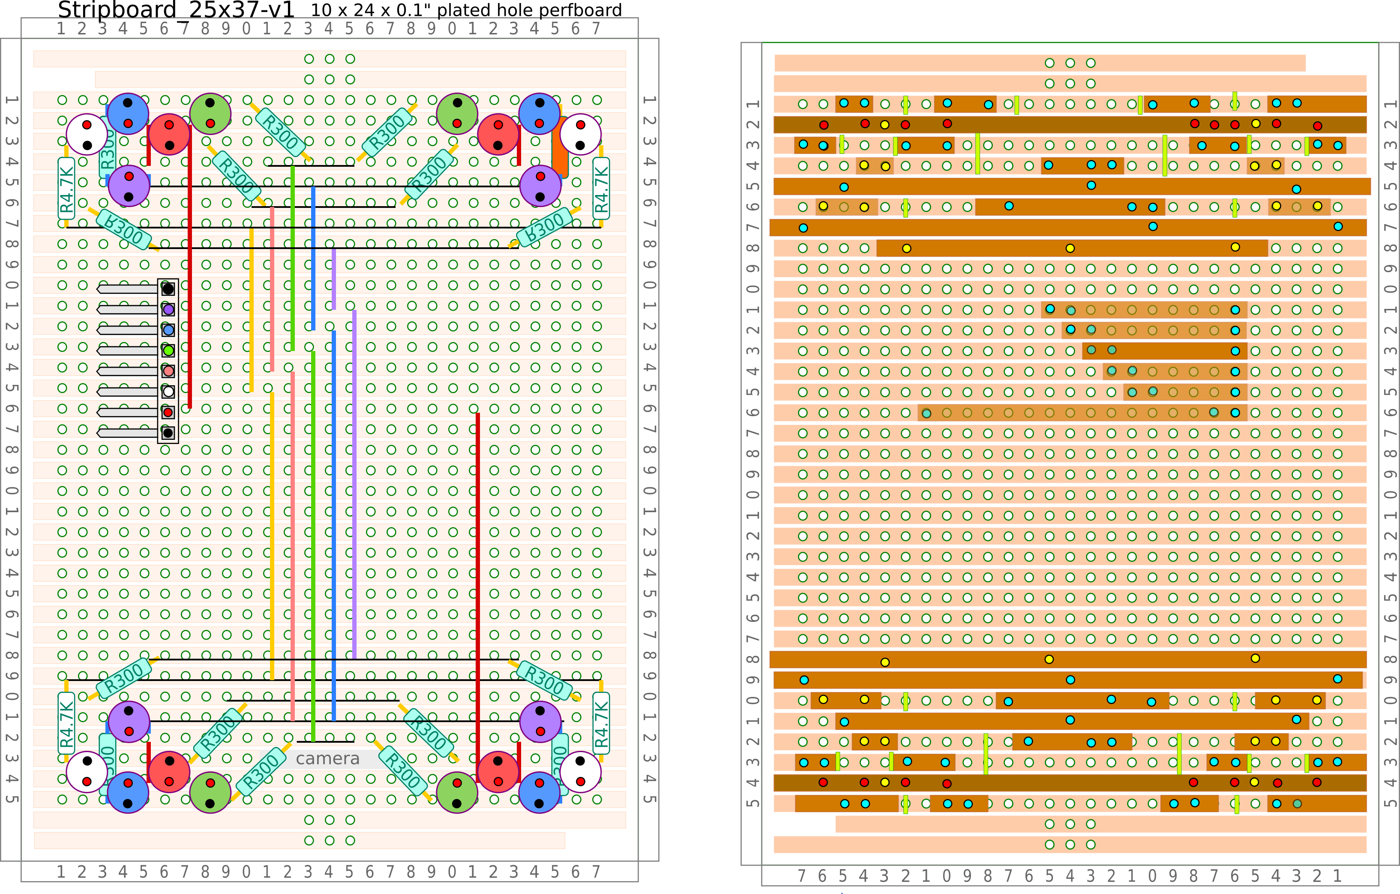
edocs/circuits/test_light_1.png
