panibillo/Colorimeter/edocs/circuits/test_light_2.png

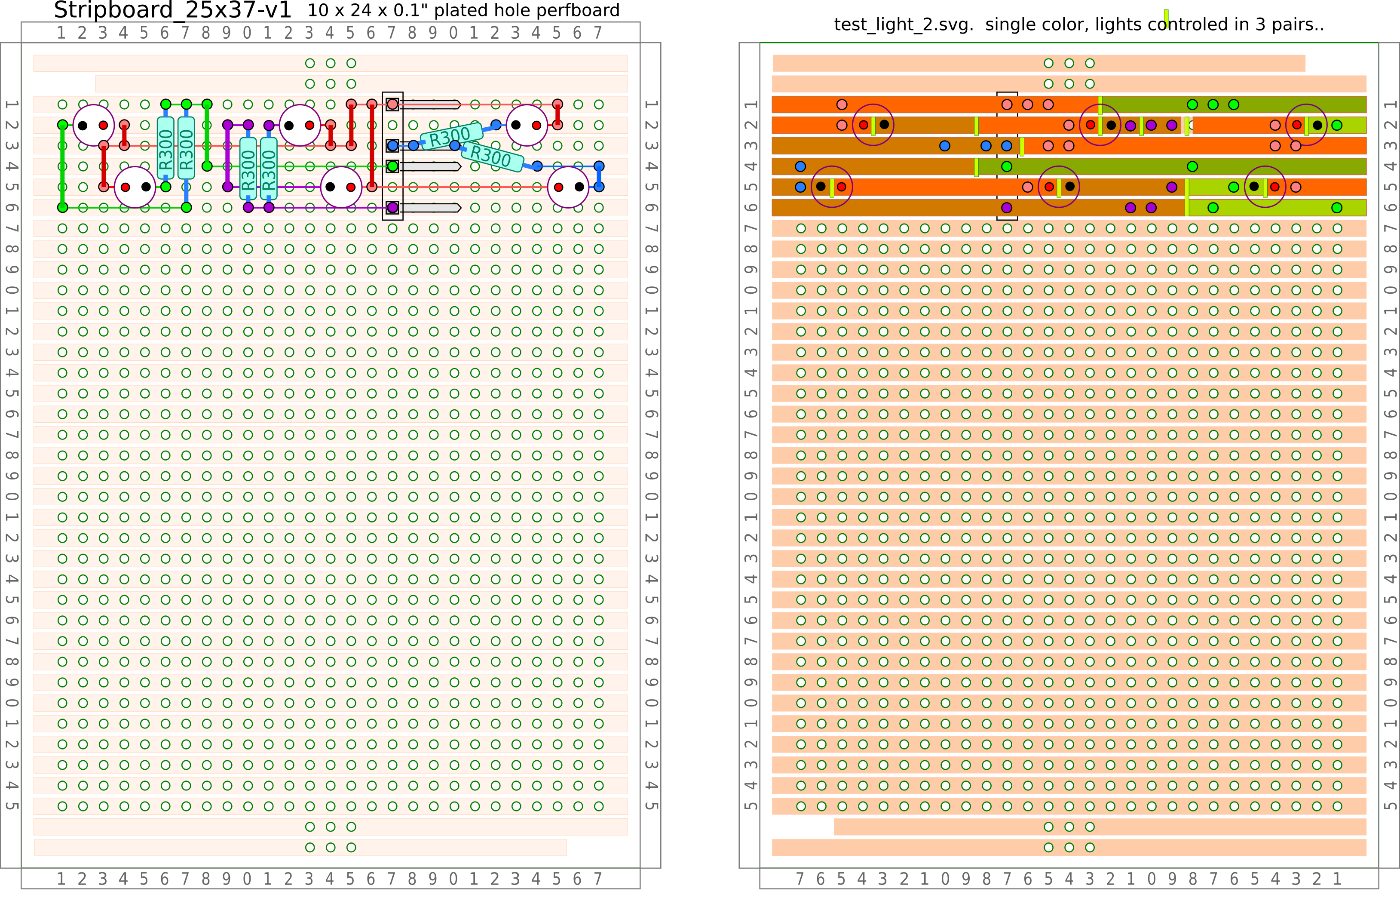
edocs/circuits/test_light_2.png
