panibillo/Colorimeter/edocs/circuits/test_light_2c.png

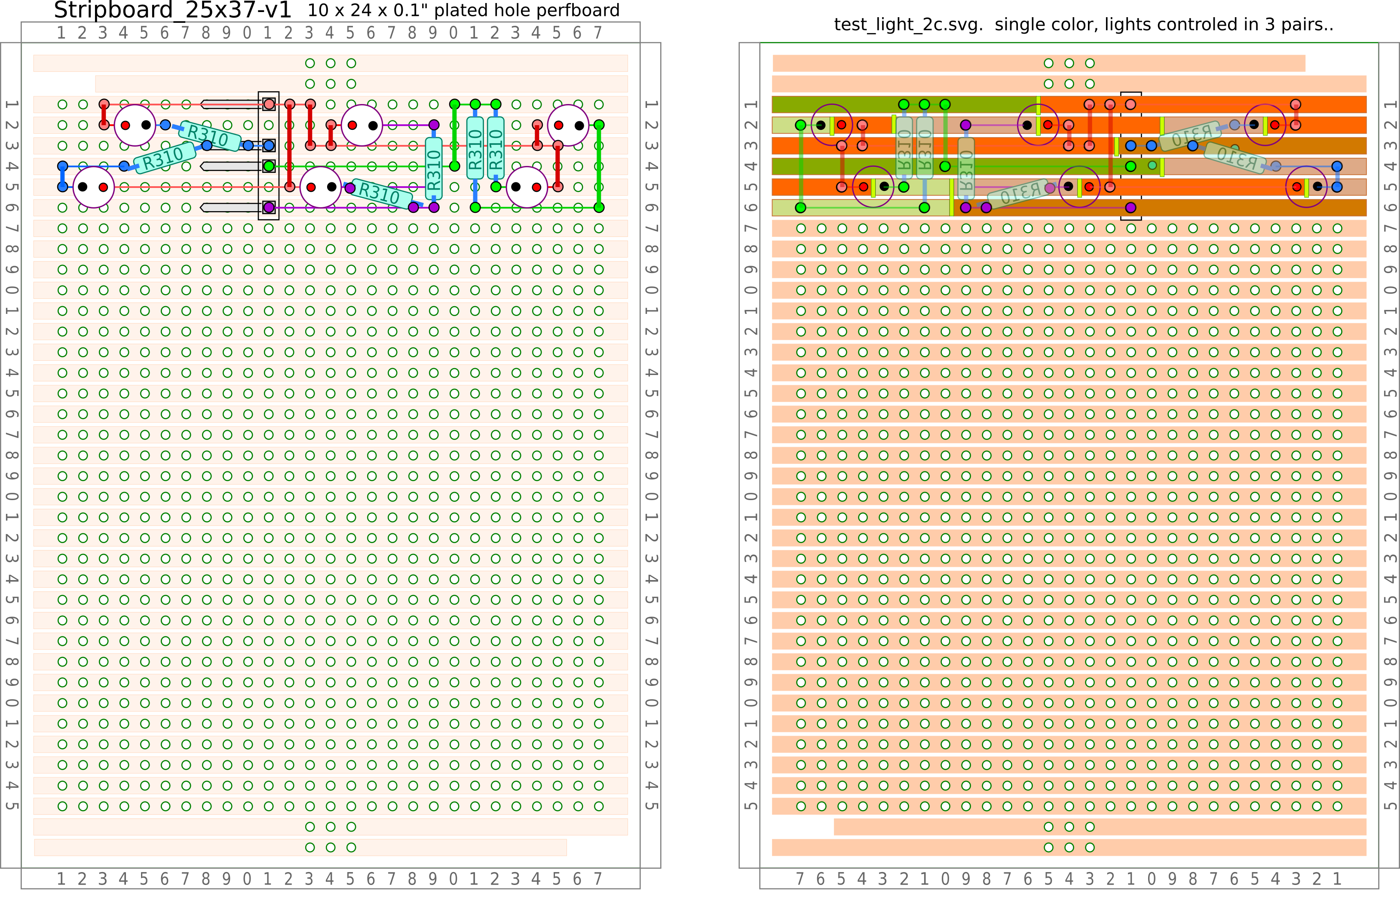
edocs/circuits/test_light_2c.png
