panibillo/Colorimeter/test/bayer_display.png

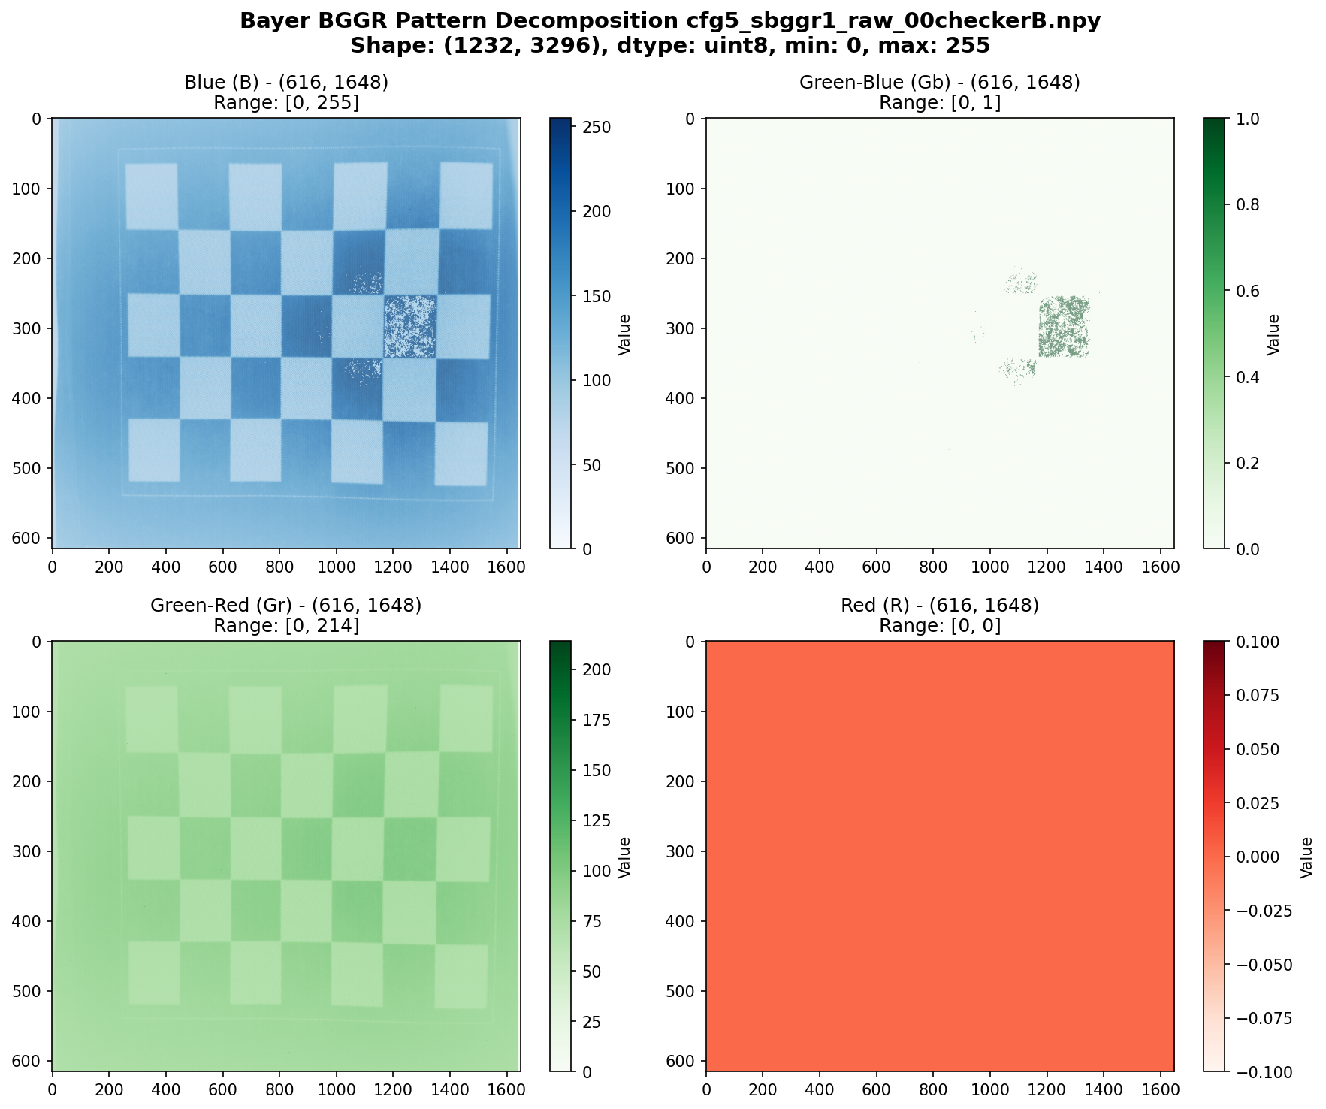
test/bayer_display.png
