panibillo/Colorimeter/test/bayer_distributions.png

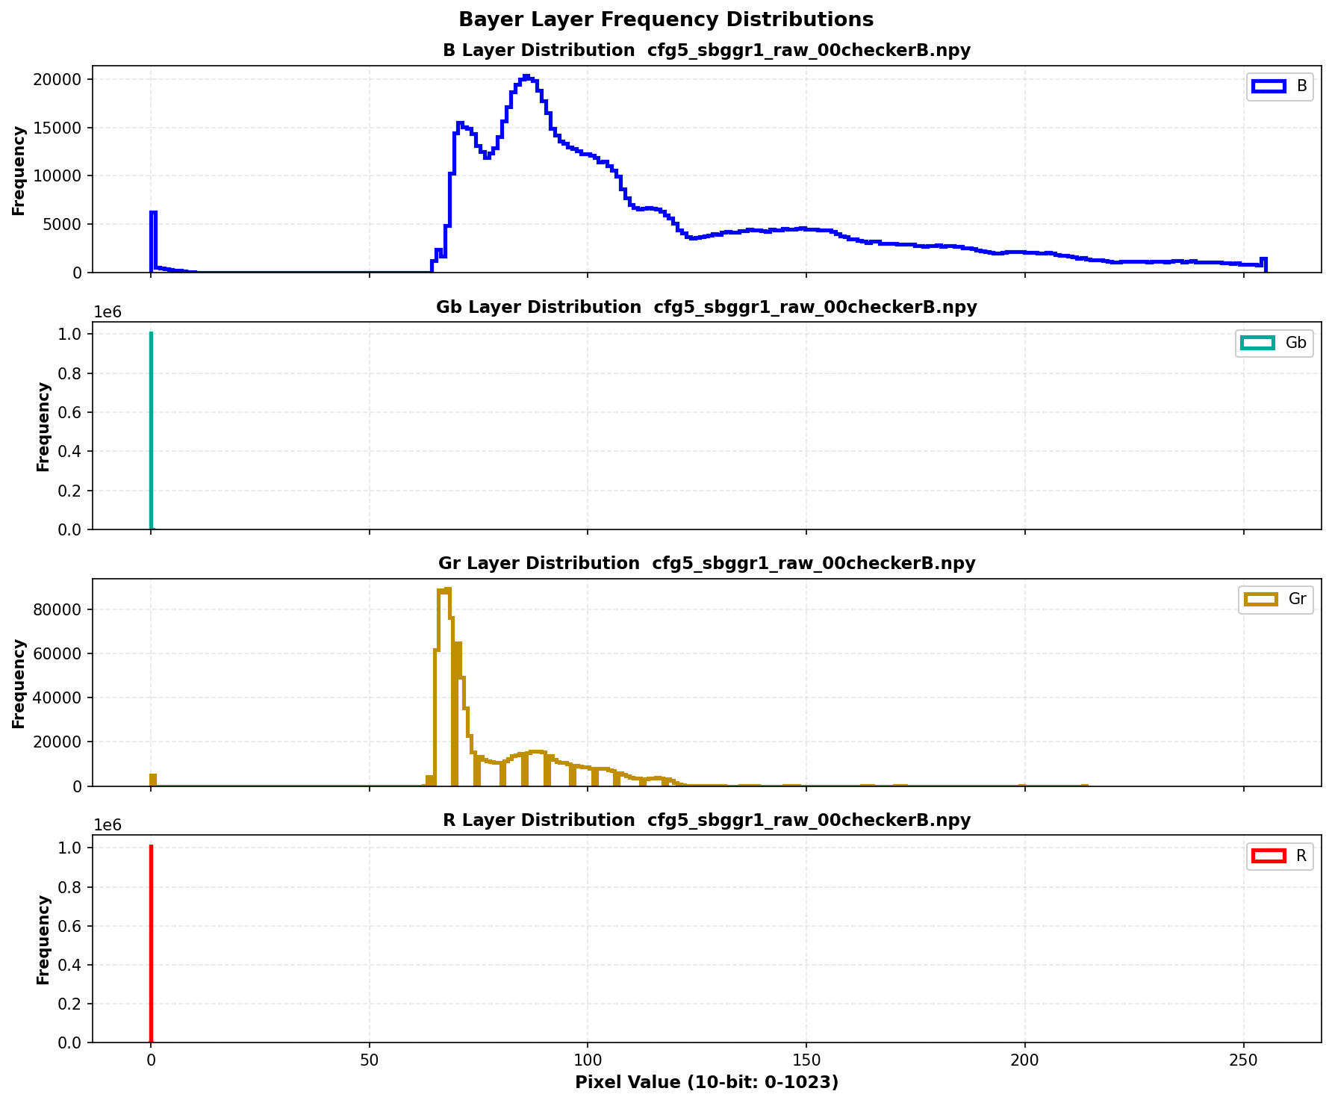
test/bayer_distributions.png
