panibillo/Colorimeter/test/rect_plot.png

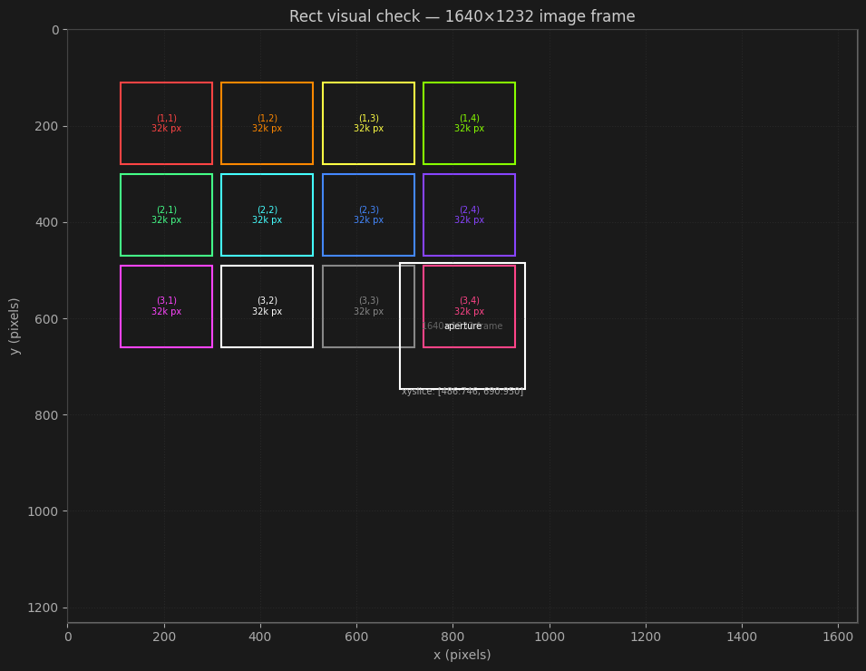
test/rect_plot.png
