panibillo/Colorimeter/test_roi_visualization.png

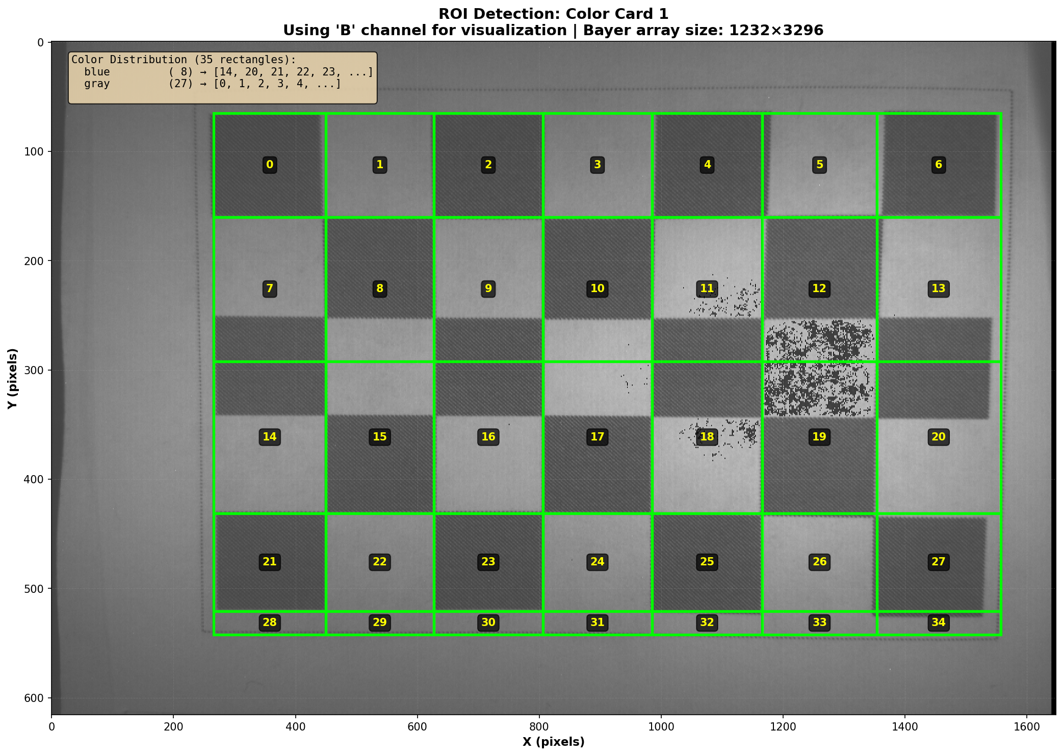
test_roi_visualization.png
