panibillo/Colorimeter/device/TODO.md

** UI design

Microcenter
$30   SKU: 005959   Adafruit Industries ILI9341 2.8" TFT LCD with Touchscreen Breakout Board w/MicroSD Socket - Note: capsense touchscreen does not need extra hardware. - check reviews.
$15   SKU: 699413   Element 14 8MP Raspberry Pi Camera Module
$ 5   SKU: 422709   Case with camera cable.
$10   SKU: 221770   Inland 5mm 5 Colors LED Light Emitting Diode Assortment Kit - 500 Pcs
