panibillo/Colorimeter/docs/PeCo75 Arsenator History_files/7a47a4eb93c75562a8534e60adf9f255_aCRH.webp

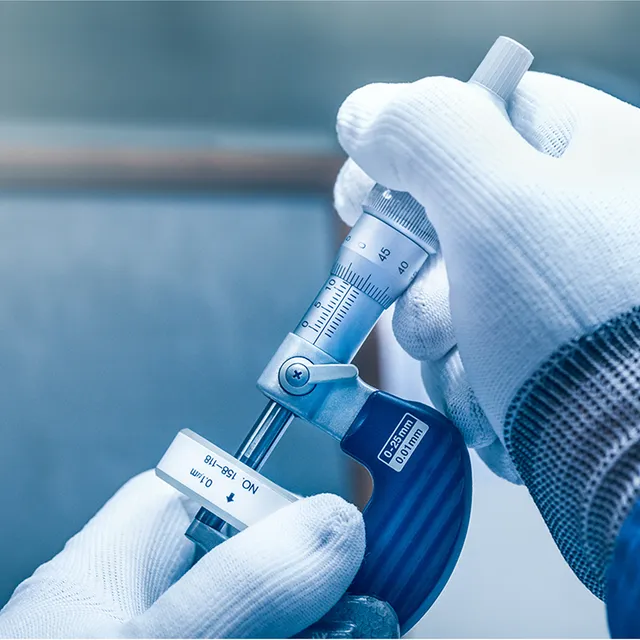
docs/PeCo75 Arsenator History_files/7a47a4eb93c75562a8534e60adf9f255_aCRH.webp
