panibillo/Colorimeter/tex/figs/R-inf-guide-C1020-royal-blue.B-1.pdf

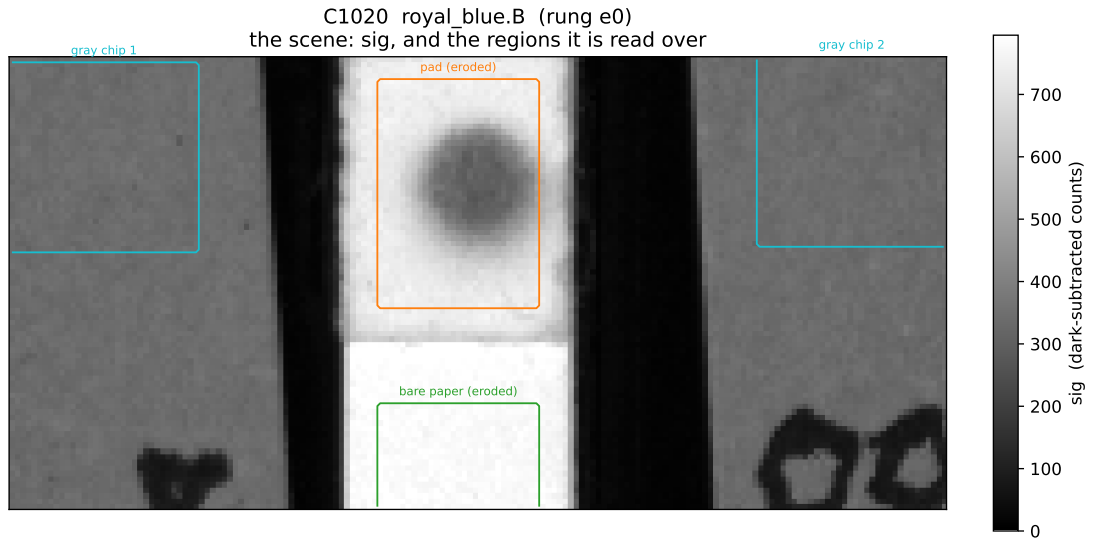
[picture p134: page 1]
gray chip 1; gray chip 2; pad (eroded)

C1020 royal_blue.B (rung e0)
the scene: sig, and the regions it is read over

sig (dark-subtracted counts)

bare paper (eroded)
