panibillo/Colorimeter/tex/figs/R-inf-guide-C1020-royal-blue.B-2.pdf

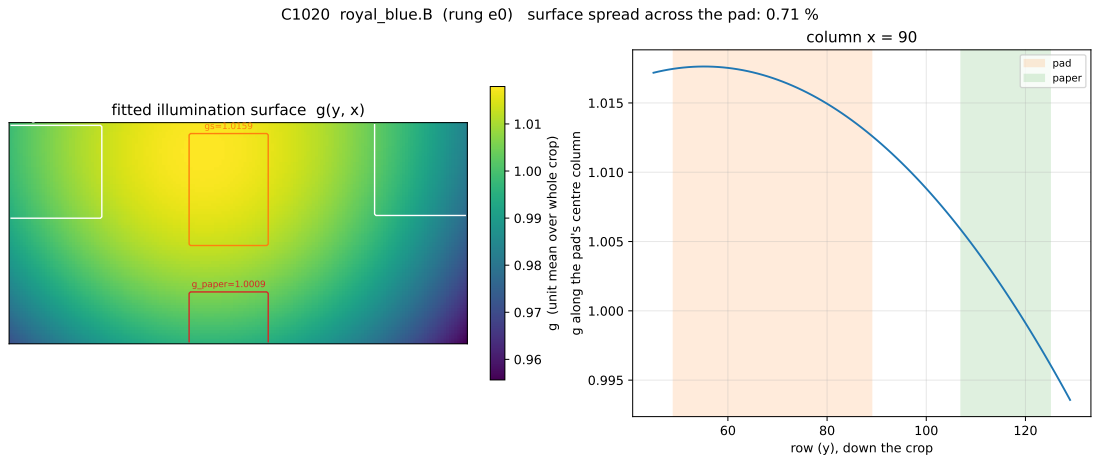
[picture p135: page 1]
g_paper=1.0009; column x = 90; pad paper

C1020 royal_blue.B (rung e0) surface spread across the pad: 0.71 %

fitted illumination surface g(y, x)

g along the pad's centre column

g (unit mean over whole crop)

row (y), down the crop
