panibillo/Colorimeter/edocs/kicad/MBCAL8_LBT8r-l_stencil/MBCAL8_LBT8r-l_stencil.kicad_pcb

## KiCad design edocs/kicad/MBCAL8_LBT8r-l_stencil/MBCAL8_LBT8r-l_stencil.kicad_pcb (2026-09-08)

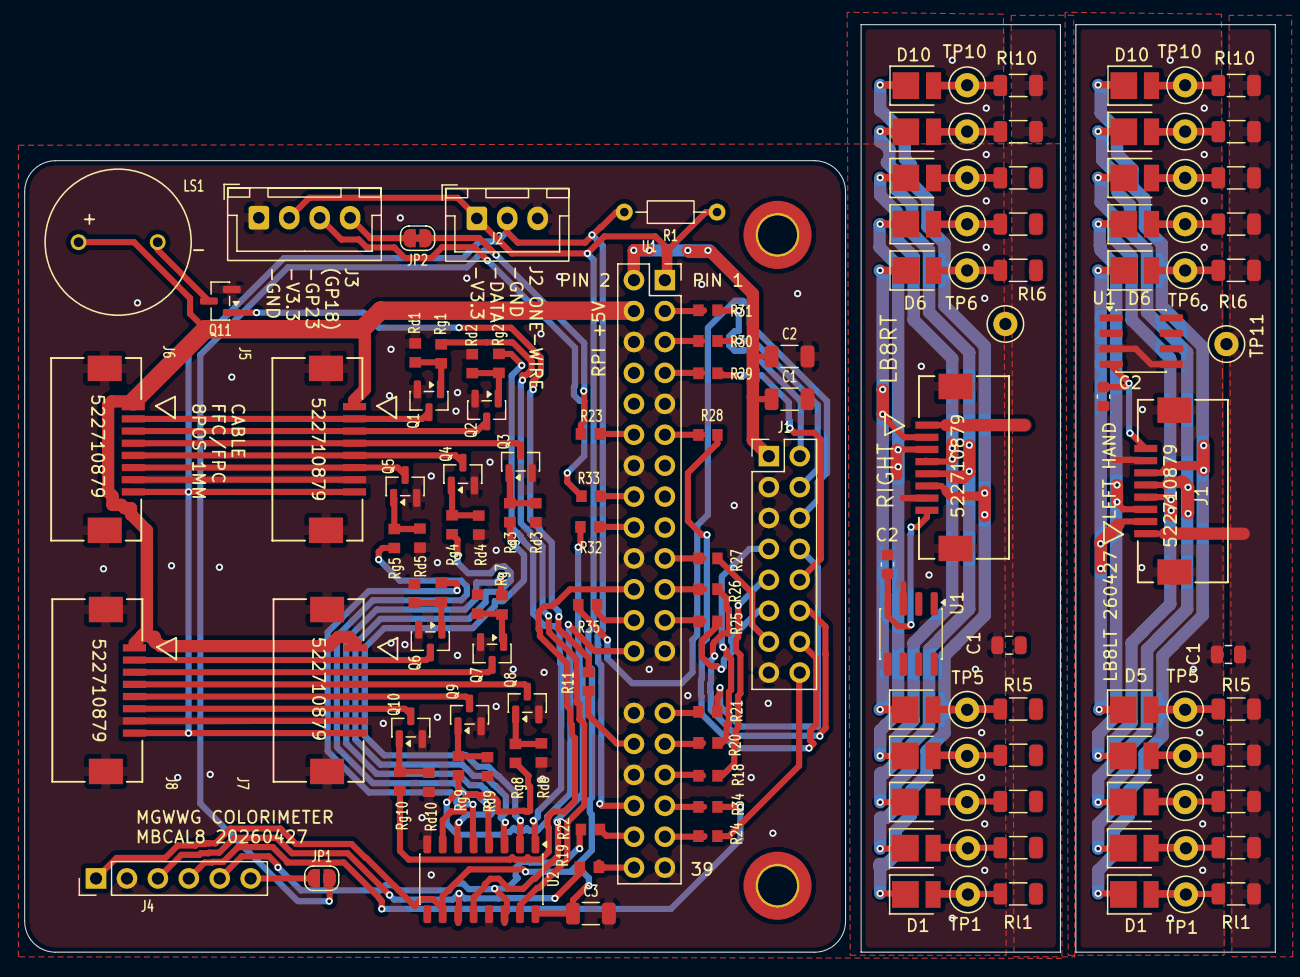
[picture p139: board MBCAL8_LBT8r-l_stencil.kicad_pcb from above]

Board: 2 copper layers, 102.7 x 76.2 mm, 137 parts (0 on the bottom side), 87 nets.

Parts:
C1, C1#2: C_Small; C_0805_2012Metric
C1#3: 10uf Tant; C_1206_3216Metric
C2, C2#3: C_Small; C_0603_1608Metric
C2#2, C3: 100nF Ceramic; C_1206_3216Metric
D1, D1#2, D2, D2#2, D3, D3#2, D4, D4#2, D5, D5#2, D6, D6#2, D7, D7#2, D8, D8#2, D9, D9#2, D10, D10#2: LED; LED_PLCC_2835
J1: Conn_02x08_Odd_Even; PinHeader_2x08_P2.54mm_Vertical
J1#2, J1#3, J5, J6, J7, J8: 522710879; CON_522710879_MOL
J2: Conn_01x03_Socket; JST_XH_B3B-XH-A_1x03_P2.50mm_Vertical
J3: Conn_01x04_Socket; JST_XH_B4B-XH-A_1x04_P2.50mm_Vertical
J4: Conn_01x06; PinHeader_1x06_P2.54mm_Vertical
JP1: SolderJumper_2_Open; SolderJumper-2_P1.3mm_Open_RoundedPad1.0x1.5mm
JP2: SolderJumper_2_Bridged; SolderJumper-2_P1.3mm_Bridged_RoundedPad1.0x1.5mm
LS1: CEM-1203_42_; CUI_CEM-1203_42_
Q1, Q2, Q3, Q4, Q5, Q6, Q7, Q8, Q9, Q10: AO3400A; SOT-23
Q11: MMBT3904; SOT-23
R1: R_axial; R_Axial_DIN0204_L3.6mm_D1.6mm_P7.62mm_Horizontal
R11: 1K; RESC1608X55N
R18, R20, R21, R24, R25, R26, R27, R28, R29, R30, R31, R32, R33, R34, R35: R33; RESC1608X55N
R19, R22, R23: R470; RESC1608X55N
Rd1, Rd2, Rd3, Rd4, Rd5, Rd6, Rd7, Rd8, Rd9, Rd10: 10K; RESC1608X55N
Rg1, Rg2, Rg3, Rg4, Rg5, Rg6, Rg7, Rg8, Rg9, Rg10: 500; RESC1608X55N
Rl1, Rl1#2, Rl2, Rl2#2, Rl3, Rl3#2, Rl4, Rl4#2, Rl5, Rl5#2, Rl6, Rl6#2, Rl7, Rl7#2, Rl8, Rl8#2, Rl9, Rl9#2, Rl10, Rl10#2: R; R_1206_3216Metric
TP1, TP1#2, TP2, TP2#2, TP3, TP3#2, TP4, TP4#2, TP5, TP5#2, TP6, TP6#2, TP7, TP7#2, TP8, TP8#2, TP9, TP9#2, TP10, TP10#2, TP11, TP11#2: TestPoint_Small; TestPoint_Loop_D1.80mm_Drill1.0mm_Beaded
U1: RPi_Zero_W; PinSocket_2x20_P2.54mm_Vertical
U1#2, U1#3: DS18B20Z; SOIC-8_3.9x4.9mm_P1.27mm
U2: 74HC595; JEITA_SOIC-16_3.9x9.9mm_P1.27mm

Connections:
+5V: C1.2, C1#2.2, J1#2.1, J1#3.1, J5.1, J6.1, J7.1, J8.1, LS1.P, Rl1.1, Rl1#2.1, Rl2.1, Rl2#2.1, Rl3.1, Rl3#2.1, Rl4.1, Rl4#2.1, Rl5.1, Rl5#2.1, Rl6.1, Rl6#2.1, Rl7.1, Rl7#2.1, Rl8.1, Rl8#2.1, Rl9.1, Rl9#2.1, Rl10.1, Rl10#2.1, TP11.1 (1_1), TP11#2.1 (1_1), U1.4 (5V_PWR)
/Buzzer_IO: Q11.1 (B), R11.2
/D2-TSIRQ: J1.10, R29.1
/D3-LITE: J1.9, R18.1
/D4-SC CS: J1.8, R21.1
/D9-TFT DC: J1.7, R20.1
/D10-TFT CS: J1.6, R35.2
/ICSP MISO: J1.12, R26.1
/ICSP MOSI: J1.13, R27.1
/ICSP SCK: J1.11, R25.1
/SCL: J1.4, R30.1
/SDA: J1.2, R31.1
/led 1 gate: Q1.1 (G), Rd1.1, Rg1.1
/led 2 gate: Q2.1 (G), Rd2.1, Rg2.1
/led 3 GPIO: Rg3.2, U2.2 (QC)
/led 3 gate: Q3.1 (G), Rd3.1, Rg3.1
/led 4 GPIO: Rg4.2, U2.3 (QD)
/led 4 gate: Q4.1 (G), Rd4.1, Rg4.1
/led 5 GPIO: Rg5.2, U2.4 (QE)
/led 5 gate: Q5.1 (G), Rd5.1, Rg5.1
/led 6 GPIO: Rg6.2, U2.5 (QF)
/led 6 gate: Q6.1 (G), Rd6.1, Rg6.1
/led 7 GPIO: Rg7.2, U2.6 (QG)
/led 7 gate: Q7.1 (G), Rd7.1, Rg7.1
/led 8 GPIO: Rg8.2, U2.7 (QH)
/led 8 gate: Q8.1 (G), Rd8.1, Rg8.1
/led 9 GPIO: Rg9.2, U1.26 (GPIO7_CE1)
/led 9 gate: Q9.1 (G), Rd9.1, Rg9.1
/led 10 GPIO: Rg10.2, U1.22 (GPIO25)
/led 10 gate: Q10.1 (G), Rd10.1, Rg10.1
/one wire: C2.1, C2#3.1, J1#2.8, J1#3.8, U1#2.4 (DQ), U1#3.4 (DQ)
/one-wire: J2.2, J5.8, J6.8, J7.8, J8.8, R1.2, U1.36 (GPIO16_CE2)
GND: C1.1, C1#2.1, C1#3.2, C2.2, C2#2.2, C2#3.2, C3.2, J1.3, J1.5, J1.15, J1#2.7, J1#2.P1, J1#2.P2, J1#3.7, J1#3.P1, J1#3.P2, J2.3, J3.1, J4.2, J5.7, J5.P1, J5.P2, J6.7, J6.P1, J6.P2, J7.7, J7.P1, J7.P2, J8.7, J8.P1, J8.P2, Q1.2 (S), Q2.2 (S), Q3.2 (S), Q4.2 (S), Q5.2 (S), Q6.2 (S), Q7.2 (S), Q8.2 (S), Q9.2 (S), Q10.2 (S), Q11.2 (E), Rd1.2, Rd2.2, Rd3.2, Rd4.2, Rd5.2, Rd6.2, Rd7.2, Rd8.2, Rd9.2, Rd10.2, U1.6 (GND), U1.9 (GND), U1.14 (GND), U1.20 (GND), U1.25 (GND), U1.30 (GND), U1.34 (GND), U1.39 (GND), U1#2.3 (V_{DD}), U1#2.5 (GND), U1#3.3 (V_{DD}), U1#3.5 (GND), U2.8 (GND), U2.13 (~OE)
LED1: D5.1 (K), D5#2.1 (K), D6.1 (K), D6#2.1 (K), J1#2.2, J1#3.2, J5.2, J6.2, Q1.3 (D)
LED2: D4.1 (K), D4#2.1 (K), D7.1 (K), D7#2.1 (K), J1#2.3, J1#3.3, J5.3, J6.3, Q2.3 (D)
LED3: D3.1 (K), D3#2.1 (K), D8.1 (K), D8#2.1 (K), J1#2.4, J1#3.4, J5.4, J6.4, Q3.3 (D)
LED4: D2.1 (K), D2#2.1 (K), D9.1 (K), D9#2.1 (K), J1#2.5, J1#3.5, J5.5, J6.5, Q4.3 (D)
LED5: D1.1 (K), D1#2.1 (K), D10.1 (K), D10#2.1 (K), J1#2.6, J1#3.6, J5.6, J6.6, Q5.3 (D)
LED6: J7.2, J8.2, Q6.3 (D)
LED7: J7.3, J8.3, Q7.3 (D)
LED8: J7.4, J8.4, Q8.3 (D)
LED9: J7.5, J8.5, Q9.3 (D)
LED10: J7.6, J8.6, Q10.3 (D)
unnamed: D1.2 (A), D1#2.2 (A), Rl1.2, Rl1#2.2, TP1.1 (1_1), TP1#2.1 (1_1)
unnamed: D2.2 (A), D2#2.2 (A), Rl2.2, Rl2#2.2, TP2.1 (1_1), TP2#2.1 (1_1)
unnamed: D3.2 (A), D3#2.2 (A), Rl3.2, Rl3#2.2, TP3.1 (1_1), TP3#2.1 (1_1)
unnamed: D4.2 (A), D4#2.2 (A), Rl4.2, Rl4#2.2, TP4.1 (1_1), TP4#2.1 (1_1)
unnamed: D5.2 (A), D5#2.2 (A), Rl5.2, Rl5#2.2, TP5.1 (1_1), TP5#2.1 (1_1)
unnamed: D6.2 (A), D6#2.2 (A), Rl6.2, Rl6#2.2, TP6.1 (1_1), TP6#2.1 (1_1)
unnamed: D7.2 (A), D7#2.2 (A), Rl7.2, Rl7#2.2, TP7.1 (1_1), TP7#2.1 (1_1)
unnamed: D8.2 (A), D8#2.2 (A), Rl8.2, Rl8#2.2, TP8.1 (1_1), TP8#2.1 (1_1)
unnamed: D9.2 (A), D9#2.2 (A), Rl9.2, Rl9#2.2, TP9.1 (1_1), TP9#2.1 (1_1)
unnamed: D10.2 (A), D10#2.2 (A), Rl10.2, Rl10#2.2, TP10.1 (1_1), TP10#2.1 (1_1)
unnamed: C1#3.1, C2#2.1, J1.1, U1.2 (5V_PWR)
unnamed: J1.14, R28.1
unnamed: J1.16, R24.1
unnamed: J3.3, R33.2
unnamed: J3.4, JP2.2 (B)
unnamed: J4.3, R19.2, U2.11 (SRCLK)
unnamed: J4.4, R34.1
unnamed: J4.5, R22.2, U2.14 (SER)
unnamed: J4.6, JP1.1 (A)
unnamed: JP1.2 (B), JP2.1 (A), R23.2
unnamed: LS1.N, Q11.3 (C)
unnamed: R31.2, U1.3 (GPIO2_SDA1)
unnamed: R30.2, U1.5 (GPIO3_SCL1)
unnamed: R29.2, U1.7 (GPIO4_GPCLK0)
unnamed: R21.2, U1.29 (GPIO5)
unnamed: R20.2, U1.31 (GPIO6)
unnamed: R35.1, U1.24 (GPIO8_CE0)
unnamed: R26.2, U1.21 (GPIO9_MISO)
unnamed: R27.2, U1.19 (GPIO10_MOSI)
unnamed: R25.2, U1.23 (GPIO11_SCLK)
unnamed: R11.1, U1.32 (GPIO12_PWM0)
unnamed: R18.2, U1.33 (GPIO13_PWM1)
unnamed: R28.2, U1.11 (GPIO17)
unnamed: R23.1, U1.12 (GPIO18_PCM_CLK)
unnamed: R34.2, U1.35 (GPIO19_MISO1)
unnamed: R22.1, U1.38 (GPIO20_MOSI1)
unnamed: R19.1, U1.40 (GPIO21_SCLK1)
unnamed: R33.1, U1.16 (GPIO23)
unnamed: R32.1, U1.18 (GPIO24)
unnamed: R24.2, U1.37 (GPIO26)
unnamed: Rg1.2, U2.15 (QA)
unnamed: Rg2.2, U2.1 (QB)
unnamed: R32.2, U2.12 (RCLK)
V3.3: C3.1, J2.1, J3.2, J4.1, R1.1, U1.1 (3V3_PWR), U2.10 (~SRCLR), U2.16 (VCC)
