panibillo/Colorimeter/edocs/kicad/light_board_7/light_board_7.kicad_pcb

## KiCad design edocs/kicad/light_board_7/light_board_7.kicad_pcb (2026-09-08)

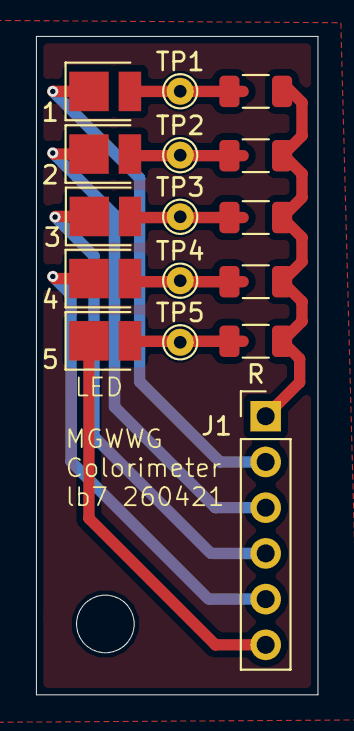
[picture p140: board light_board_7.kicad_pcb from above]

Board: 2 copper layers, 15.6 x 36.6 mm, 16 parts (0 on the bottom side), 11 nets.

Parts:
1, 2, 3, 4, 5: LED; LED_PLCC_2835
J1: Conn_01x06; PinHeader_1x06_P2.54mm_Vertical
R, R1, R2, R3, R4: R; R_1206_3216Metric
TP1, TP2, TP3, TP4, TP5: TestPoint_Small; TestPoint_THTPad_D1.5mm_Drill0.7mm

Connections:
+5V: J1.1, R.1, R1.1, R2.1, R3.1, R4.1
LED1: 1.1 (K), J1.2
LED2: 2.1 (K), J1.3
LED3: 3.1 (K), J1.4
LED4: 4.1 (K), J1.5
LED5: 5.1 (K), J1.6
unnamed: 1.2 (A), R1.2, TP1.1 (1_1)
unnamed: 2.2 (A), R2.2, TP2.1 (1_1)
unnamed: 3.2 (A), R3.2, TP3.1 (1_1)
unnamed: 4.2 (A), R4.2, TP4.1 (1_1)
unnamed: 5.2 (A), R.2, TP5.1 (1_1)
