panibillo/Colorimeter/edocs/kicad/main_board_7/main_board_7.kicad_pcb

## KiCad design edocs/kicad/main_board_7/main_board_7.kicad_pcb (2026-09-08)

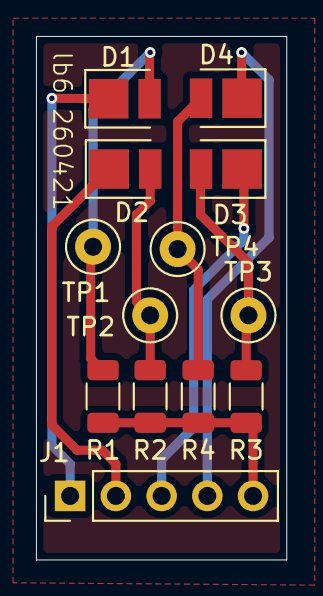
[picture p141: board main_board_7.kicad_pcb from above]

Board: 2 copper layers, 13.9 x 29.1 mm, 13 parts (0 on the bottom side), 9 nets.

Parts:
D1, D2, D3, D4: LED; LED_PLCC_2835
J1: Conn_01x05; PinHeader_1x05_P2.54mm_Vertical
R1, R2, R3, R4: R; R_1206_3216Metric
TP1, TP2, TP3, TP4: TestPoint_Small; TestPoint_Loop_D1.80mm_Drill1.0mm_Beaded

Connections:
+5V: J1.5, R1.1, R2.1, R3.1, R4.1
/J1: D1.1 (K), J1.1
/J2: D2.1 (K), J1.2
/J3: D3.1 (K), J1.3
/J4: D4.1 (K), J1.4
unnamed: D1.2 (A), R1.2, TP1.1 (1_1)
unnamed: D2.2 (A), R2.2, TP2.2 (1_1)
unnamed: D3.2 (A), R3.2
unnamed: D4.2 (A), R4.2
