panibillo/Colorimeter/edocs/kicad/light_board_8_testpoints/light_board_8_testpoints.kicad_pcb

## KiCad design edocs/kicad/light_board_8_testpoints/light_board_8_testpoints.kicad_pcb (2026-09-08)

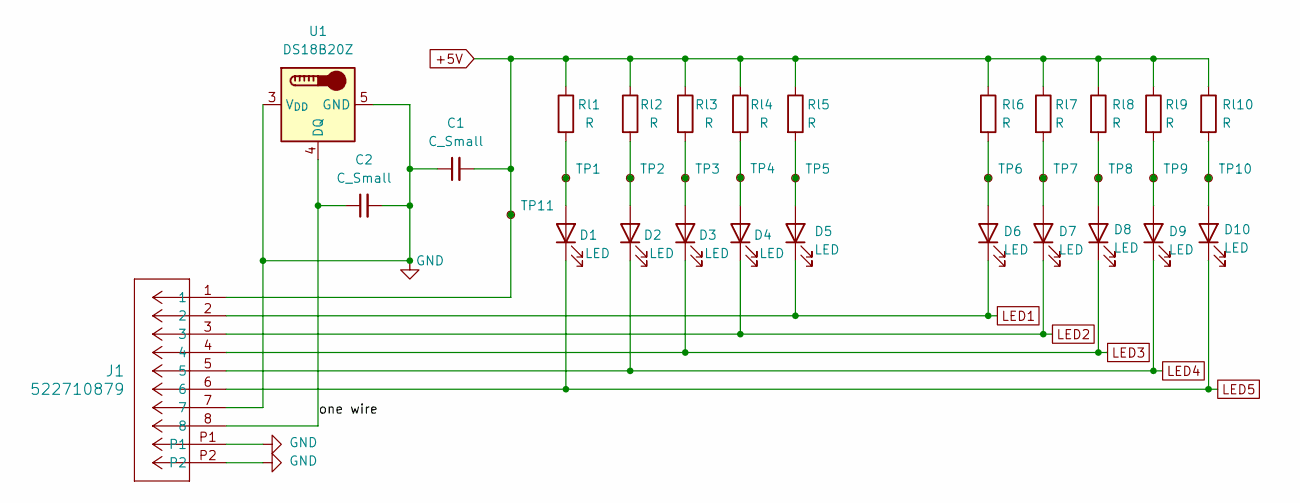
[picture p142: schematic light_board_8_testpoints.kicad_sch, Colorimeter - lighting]

Parts:
C1: C_Small; C_0805_2012Metric
C2: C_Small; C_0603_1608Metric
D1, D2, D3, D4, D5, D6, D7, D8, D9, D10: LED; LED_PLCC_2835
J1: 522710879; CON_522710879_MOL
Rl1, Rl2, Rl3, Rl4, Rl5, Rl6, Rl7, Rl8, Rl9, Rl10: R; R_1206_3216Metric
TP1, TP2, TP3, TP4, TP5, TP6, TP7, TP8, TP9, TP10, TP11: TestPoint_Small; TestPoint_Loop_D1.80mm_Drill1.0mm_Beaded
U1: DS18B20Z; SOIC-8_3.9x4.9mm_P1.27mm

Connections:
+5V: C1.2, J1.1, Rl1.1, Rl2.1, Rl3.1, Rl4.1, Rl5.1, Rl6.1, Rl7.1, Rl8.1, Rl9.1, Rl10.1, TP11.1 (1_1)
/one wire: C2.1, J1.8, U1.4 (DQ)
GND: C1.1, C2.2, J1.7, J1.P1, J1.P2, U1.3 (V_{DD}), U1.5 (GND)
LED1: D5.1 (K), D6.1 (K), J1.2
LED2: D4.1 (K), D7.1 (K), J1.3
LED3: D3.1 (K), D8.1 (K), J1.4
LED4: D2.1 (K), D9.1 (K), J1.5
LED5: D1.1 (K), D10.1 (K), J1.6
unnamed: D1.2 (A), Rl1.2, TP1.1 (1_1)
unnamed: D2.2 (A), Rl2.2, TP2.1 (1_1)
unnamed: D3.2 (A), Rl3.2, TP3.1 (1_1)
unnamed: D4.2 (A), Rl4.2, TP4.1 (1_1)
unnamed: D5.2 (A), Rl5.2, TP5.1 (1_1)
unnamed: D6.2 (A), Rl6.2, TP6.1 (1_1)
unnamed: D7.2 (A), Rl7.2, TP7.1 (1_1)
unnamed: D8.2 (A), Rl8.2, TP8.1 (1_1)
unnamed: D9.2 (A), Rl9.2, TP9.1 (1_1)
unnamed: D10.2 (A), Rl10.2, TP10.1 (1_1)

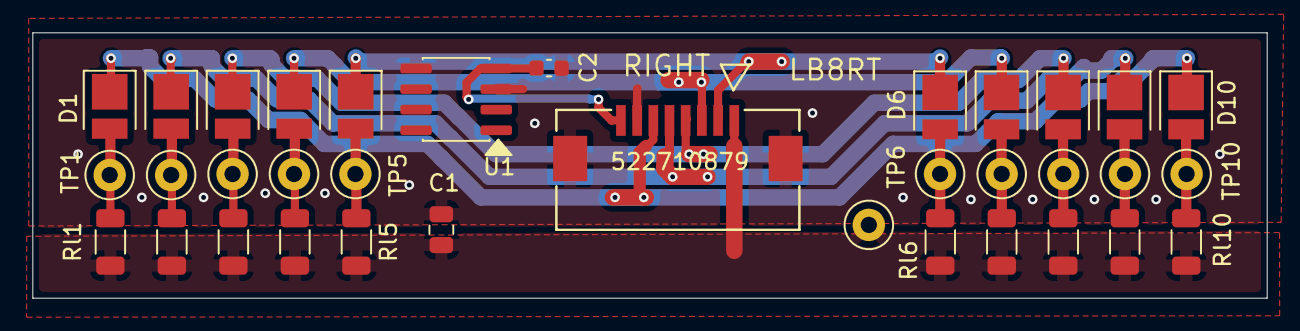
[picture p143: board light_board_8_testpoints.kicad_pcb from above]

Board: 2 copper layers, 76.2 x 16.4 mm, 35 parts (0 on the bottom side), 18 nets.
