panibillo/Colorimeter/src/arbiter.py

"""
arbiter.py  —  The one object above the two slots.
---------------------------------------------------
The Arbiter owns everything shared and single-instance: the display (one
screen, one focus), the camera + LED bank (one capture at a time), the buzzer,
the keyboard, and the main event loop.  Slots and phases never touch these —
they call the arbiter (the contract documented at the top of phases.py) and it
grants, defers, or denies.

Because the widget Pool is the single physical screen, `enter()` may run only
for the *focused* slot; a backgrounded slot advances its model (activate() and
timers mutate slot state only) but is never drawn.  This is why render() is a
no-op for an unfocused slot.

What the arbiter arbitrates
---------------------------
- **Focus.** One slot is displayed; the other stays live. The slot toggle
  switches which is drawn. Nothing auto-switches focus.
- **The camera.** At most one capture across both slots. A capture starts only
  from a focused CAPTURE press, then runs capture→analysis to completion while
  the user may toggle away; every CAPTURE button is disabled while a capture is
  live (ReadPhase asks `capture_available()`).
- **The buzzer.** A countdown reaching zero alarms — alarm only, never a focus
  switch — and the phase advances its own model via `on_expire`.

Run it:
    COLORIMETER_SIMULATION=1 python3 src/arbiter.py        # mock hardware
    python3 src/arbiter.py                                 # real Pi hardware

Headless logic self-test (no display, fake camera):
    PYTHONPATH=src python3 src/arbiter.py --selftest
"""

from __future__ import annotations

import datetime
import functools
import logging
import os
import signal
import subprocess
import sys
import time
from pathlib import Path

_SIMULATION_MODE = os.environ.get("COLORIMETER_SIMULATION", "0") == "1"

# Hardware drivers are imported lazily in _init_hardware() so this module (and
# its logic self-test) imports cleanly on a machine without the display/GPIO
# stacks.  Only the pure model + widget layer is imported at module load.
import sqlite3

import config_repo as config
import logging_manager
import widgets
import shutdown_screen
import splash_screen
import startup_checks
import version
import sample_repo
import exposure_repo
import layout
from widgets import Button, TextBox
from pool import Pool
from slot import Slot
from phases import (build_phases, EntryPhase, Entry2Phase, ReadPhase,
                    VariantPhase, ReagentWeights,
                    _factor_value, _image_reps, _mmss, _to_float)

log = logging.getLogger(__name__)

# Phases during which the shared camera is unconditionally kept open: once a
# run reaches read (CAPTURE imminent) through analysis. reagent1 is
# deliberately NOT here — the camera should stay off as much as possible
# (it is believed to heat up and drift), on only long enough beforehand to be
# thermally stable. reagent2 is also absent from this tuple: whether the
# camera is wanted during reagent2 is a countdown threshold, not a blanket
# phase membership — see _reagent2_within()/_camera_wanted()/
# _maybe_open_camera(). Outside all of this (entry/entry2, and after results)
# no capture is imminent, so the camera is released.
_CAMERA_PHASES = ("read", "analysis")

# Reagent weight grid.  One entry box, one record key — the map is flat so a
# keystroke's destination is decided by which box was typed in and by nothing
# else.  The old single-field-per-reagent design picked the key from
# slot.running, which meant the same pixel wrote to a different column of the
# database depending on whether a timer happened to be counting.
WT_FIELD_KEYS = {
    "wt1_init_fld":  "reagent1_initial_wt",
    "wt1_final_fld": "reagent1_final_wt",
    "wt2_init_fld":  "reagent2_initial_wt",
    "wt2_final_fld": "reagent2_final_wt",
}


# Image viewer.  The preview is for looking at, not measuring, so the LED
# settle is a fraction of a capture run's LED_ON_WARMUP_S (2.0 s) — colour
# accuracy is not required and the operator's wait is what matters.
_PREVIEW_LED_CH      = 10       # LEDBank channel for the white LED
_PREVIEW_LED_NAME    = "white"  # its name in the `exposure` table
_PREVIEW_SETTLE_S    = 0.25     # after switching the LED on, before capturing
_PREVIEW_FALLBACK_US = 10_000   # first guess when nothing better is known

# Preview auto-exposure.  The preview is metered on the **sample** ROI alone:
# it is the only rectangle whose contents have to be readable, and the white
# patch beside it is far brighter, so metering over the frame (or over `white`,
# which is what the stored calibration exposures are for) leaves the sample a
# dark smudge — or, when the stored exposure was calibrated against a dimmer
# scene, blows it out.  Target and tolerance follow the capture path's e3
# convention: the median of the brightest Bayer channel at half of the
# sensor's 10-bit full scale.  See _meter_sample_level().
_PREVIEW_TARGET        = 512    # half of 1023 — capture_runner.HALF_SAT
_PREVIEW_AE_TOLERANCE  = 0.20   # accept a median within ±20 % of the target
_PREVIEW_AE_MAX_FRAMES = 3      # metered frames per preview, at most
# Frames the preview will spend waiting for the sensor to adopt a requested
# exposure, well under the capture path's MAX_SETTLE_FRAMES: a frame taken
# slightly off the request is fine here (the metering scales from the exposure
# the metadata reports, not from the request), whereas a screen that sits
# frozen for a dozen full-res captures is not.
_PREVIEW_SETTLE_FRAMES = 4
_PREVIEW_MIN_US        = 1_000  # exposure floor, matching the capture path
_PREVIEW_MAX_US        = 200_000  # ceiling: past this the preview is too slow

_VIEW_ZOOM_STEP      = 1.5      # one press of + or −
# One press of an arrow in view mode, as a fraction of the view box.  The
# 1px/10px button picks between them: it is a fine/coarse switch for panning
# and a literal pixel step for the edit nudge.  A pan of one image pixel would
# be invisible at every zoom the viewer can reach, which is why view mode
# scales with the view instead.
_VIEW_PAN_FINE       = 0.05     # with the step on 1px
_VIEW_PAN_COARSE     = 0.25     # with the step on 10px
_EDIT_MARGIN         = 0.5      # Edit zooms to the rectangle plus half its size
_EDIT_EDGE_TOL_PX    = 12       # canvas px within which a tap arms an edge
_EDIT_MIN_SIDE       = 16       # smallest ROI a Save will accept, image px

# Bounds for a reagent countdown entered on the Menu → Phases screen.  Zero is
# excluded (a wait that expires the instant it starts is never what was meant)
# and the ceiling is one hour, well past the longest protocol step.
# The range a reagent countdown may hold, shared with the Q10 formula's clamp
# so a hand-typed duration and a computed one are held to one answer about
# what is runnable.
_CFG_MIN_SECS, _CFG_MAX_SECS = config.MIN_REAGENT_SECS, config.MAX_REAGENT_SECS
# The step buttons on each phases row, in the order they are laid out.
_CFG_STEPS = (-60, -10, 10, 60)

# Config editor: body rows per page for the role/browse views (layout.py draws
# four), the roles view's grid size (4 rows x 2 columns, all on one page —
# layout.py draws eight), and the label of the entry that sits at the end of
# the role list rather than naming a role.
_CFGE_ROWS       = 4
_CFGE_ROLE_SLOTS = 8
_CFGE_RESTORE    = "Restore Factory Defaults"

# LED Color picker (Menu → LED Colors): 'dark' and 'jpg' are drawn fixed at
# the end of the active row for operator awareness only (a dark frame and a
# colour-corrected white-light photo are taken as part of every capture,
# automatically — see capture_runner.py). They are never offered in the
# inactive row, never selectable, and never written into led_color_order.
_LEDPICK_SPECIALS = ("dark", "jpg")

# Capture page: the largest signal (DN, black removed) a window setting may name.
_CAP_MAX_DN = 960

# Approximate (r, g, b) swatch colour per LED name — close enough to its
# wavelength to read at a glance — and the text colour that reads on it.
_LEDPICK_SWATCH = {
    "violet":     ((138,  43, 226), "white"),
    "royal_blue": (( 65, 105, 225), "white"),
    "blue":       ((  0,   0, 255), "white"),
    "cyan":       ((  0, 255, 255), "black"),
    "green":      ((  0, 170,   0), "white"),
    "amber":      ((255, 191,   0), "black"),
    "red_orange": ((255,  69,   0), "white"),
    "red":        ((213,   0,   0), "white"),
    "photo_red":  ((139,   0,   0), "white"),
    "white":      ((255, 255, 255), "black"),
    "dark":       ((  0,   0,   0), "white"),
    "jpg":        ((255, 255, 255), "black"),
}


def _led_initials(name: str) -> str:
    """'blue' -> 'B'; 'royal_blue' -> 'R B' — initials of each '_'-separated word."""
    return " ".join(w[0].upper() for w in name.split("_") if w)


def _wrap_csv(text: str, max_len: int) -> "tuple[str, str]":
    """
    Split a comma-separated string onto two lines, breaking only at a comma so
    no color name is cut mid-word. Whatever does not fit on line 1 goes onto
    line 2 whole, even past max_len — ten LED names fit two lines at the
    picker's font size with room to spare, and a line that ran long once would
    still rather show the whole value than silently truncate it.
    """
    parts = text.split(",") if text else []
    line1 = ""
    i = 0
    while i < len(parts):
        candidate = parts[i] if not line1 else f"{line1},{parts[i]}"
        if len(candidate) > max_len and line1:
            break
        line1 = candidate
        i += 1
    line2 = ",".join(parts[i:])
    return line1, line2


# Tunables (LED range, loop cadence, timeouts, reagent durations, rowid, the
# backlight pin) are rows in the database's `config` table and are read through
# config_repo — see the config.* calls throughout this module.


def _clamp_secs(secs: int) -> int:
    """Hold an entered reagent duration inside the allowed range."""
    return max(_CFG_MIN_SECS, min(_CFG_MAX_SECS, int(secs)))


def _clamp_us(us: float) -> int:
    """Hold a preview exposure inside the range the viewer will ask the sensor for."""
    return max(_PREVIEW_MIN_US, min(_PREVIEW_MAX_US, int(us)))


def _cfge_fit(name: str, limit: int = 13) -> str:
    """
    Break a parameter name at its underscores so it fits the config editor's
    title, which has only the 120 px between the two corner buttons.

    Example:
        >>> _cfge_fit("prefetch_budget_s")
        'prefetch\\nbudget_s'
        >>> _cfge_fit("layer_keep_min_dn")
        'layer_keep\\nmin_dn'
    """
    if len(name) <= limit:
        return name
    lines, line = [], ""
    for part in name.split("_"):
        candidate = f"{line}_{part}" if line else part
        if line and len(candidate) > limit:
            lines.append(line)
            line = part
        else:
            line = candidate
    lines.append(line)
    return "\n".join(lines)


class Arbiter:
    """One instance per run.  Call start() to init hardware and enter the loop."""

    def __init__(self, capture_factory=None) -> None:
        # capture_factory: a zero-arg callable returning a capture session (for
        # tests). None -> the real CaptureSession, imported lazily on first use.
        # Hardware (drivers loaded in _init_hardware; None until then)
        self._backlight = None
        self._disp      = None
        self._touch     = None
        self._kb        = None
        self._beeper    = None
        self._temp      = None
        self._ILI9341   = None
        self._kb_ok     = None      # what KbReader.open() said, for the checks

        # The boot splash, live only between _init_display() and the operator
        # pressing MENU or START.  _resume_display consults it, because an
        # aborted shutdown screen during the boot has nothing else to go back
        # to — there is no focused slot and no pool yet.
        self._splash: "splash_screen.Splash | None" = None
        self._boot:   "splash_screen.BootLog | None" = None

        # Model
        self._pool:   Pool | None = None
        self._phases: dict        = {}
        self._slots:  dict[str, Slot] = {}
        self._focused: Slot | None = None

        # Slots whose timer expired while unfocused, oldest first — each shows a
        # visible "Resume <slot>" alarm button until that slot regains focus.
        self._alarms: list[Slot] = []

        # Focus within the current screen
        self._focusables: list = []
        self._focus_idx:  int  = -1

        # The single capture in flight, plus which slot owns it.
        self._capture_factory = capture_factory
        self._capture: CaptureSession | None = None
        self._capture_slot: Slot | None = None
        # Live "Capturing <color>, N exposures" / "Capturing dark images, N
        # exposures" counter mirrored onto the read phase's collect_line while
        # a capture is in flight — see pump_capture(). Reset at both
        # request_capture() success paths below.
        self._cap_progress_kind: str | None = None   # "lit" | "dark" | None
        self._cap_progress_n:    int = 0

        # The normal path's capture prefetch (CaptureRunner.run_prefetch()),
        # started automatically near the end of a slot's reagent2 countdown —
        # see _maybe_start_prefetch(). Parked (not pumped further) once done,
        # holding the camera/archive open, until request_capture() promotes it
        # into self._capture or it is cancelled. At most one at a time, mirroring
        # self._capture — a second slot nearing its own reagent2 threshold
        # while this is in flight/parked simply defers (see _maybe_start_prefetch()).
        self._prefetch: CaptureSession | None = None
        self._prefetch_slot: Slot | None = None
        # self._camera_epoch as it stood when the parked prefetch's own session
        # was created — see _new_session(). request_capture() only promotes a
        # parked prefetch whose stamp still matches the CURRENT _camera_epoch;
        # a mismatch means some other session (the other slot's run, an image
        # viewer preview, a forced refocus) touched the shared camera's focus
        # or exposure since this one parked, so its "before" darks and
        # whatever run_capture() would do next could silently disagree about
        # camera state — safer to discard it and fall back to a fresh run.
        self._prefetch_epoch: int | None = None

        # Set once the capture subsystem's heavy first-imports (picamera2,
        # libcamera, numpy, cv2) have been warmed — see prewarm_capture().
        self._capture_prewarmed = False

        # The persistent camera + LED bank, owned by the Arbiter and shared by
        # every capture.  Opened within a lead window before a slot's reagent2
        # countdown expires (so the sensor-start settle AND the dark-frame
        # prefetch batch both complete before CAPTURE is reachable) and reused
        # across captures; released when no slot needs them and at cleanup.
        # Each CaptureSession *borrows* these rather than opening its own.
        # None until opened — see _ensure_camera()/_maybe_open_camera().
        self._camera = None
        self._leds   = None
        # Bumped by _new_session() every time it hands a brand-new session the
        # shared camera — the counter a parked prefetch's _prefetch_epoch is
        # checked against before being promoted (see above).
        self._camera_epoch: int = 0

        # Placeholder analysis timer: (slot, started_at) or None.
        self._analysis: tuple | None = None

        # Shutdown state: guards against a second signal re-entering shutdown()
        # or cleanup() running its hardware-release chain twice.
        self._shutting_down = False
        self._cleaned_up    = False

        # Reference data: the entry-screen pre-fills, read from the config
        # table's `defaults` and `device` roles.
        self._defaults: sample_repo.Defaults | None = None

        # Menu screen state: the slot to return to when the menu closes.
        self._pre_menu_slot: Slot | None = None

        # LED test state (Menu → Advanced → Test LED): whether the screen is
        # up, which LED it has lit, and a message in place of the lit line
        # (e.g. the LED bank failed to open).  While the screen is up the
        # shared LED bank is held open and no prefetch starts.
        self._ledtest_open = False
        self._ledtest_lit: str | None = None
        self._ledtest_msg = ""

        # Capture Image state (Menu → Advanced → Capture Image): what is
        # chosen, kept between visits, and the status line.  The name is
        # re-offered (the next free one) each time the screen opens.
        self._img_led: str | None = None
        self._img_rungs: set = set()
        self._img_types: set = {"bayer_bound", "darkframes"}
        self._img_name = ""
        self._img_desc = ""
        self._img_status = ""
        self._img_saving = ""       # the name of the image being captured

        # Wifi state (Menu → Advanced → Wifi): which view is up, the one
        # nmcli job in flight (polled by pump_wifi) and what the last ones
        # said.  The backend is made on first use: nmcli on the device, a
        # fake under simulation (see wifi.backend()).
        self._wifi_view: str | None = None      # 'status' | 'networks' | 'join'
        self._wifi_backend = None
        self._wifi_job = None
        self._wifi_job_kind = ""
        self._wifi_device = None                # wifi.Device
        self._wifi_radio: bool | None = None
        self._wifi_networks: list = []          # [wifi.Network]
        self._wifi_saved: list = []             # saved profile names
        self._wifi_sel: str | None = None       # selected row's key
        self._wifi_page = 0
        self._wifi_msg = ""
        self._wifi_forget_armed: str | None = None
        self._wifi_ssid = ""
        self._wifi_password = ""
        self._wifi_show = False
        self._wifi_hidden = False

        # Calibrate Touchpad state (Menu → Advanced → Calibrate Touchpad).
        # While a new calibration is on trial, _tcal_old holds the values it
        # replaced in memory, so a revert never needs the file.
        self._tcal_view: str | None = None      # 'home' | 'corners' | 'test'
        self._tcal_raw: dict = {}               # corner label → (rx, ry)
        self._tcal_step_t0 = 0.0                # when the current corner was shown
        self._tcal_note = ""                    # a corner-view complaint
        self._tcal_old: dict | None = None      # the values in use before the trial
        self._tcal_new: dict | None = None      # the values on trial
        self._tcal_trial_end = 0.0
        self._tcal_err: tuple | None = None     # last BR check (err_x, err_y)
        self._tcal_test_t = 0.0                 # last touch in the test view
        self._tcal_msg = ""
        self._wifi_connecting = ""

        # Capture screen state (Menu → Advanced → Capture): which view is
        # showing and what kind of run is in flight.  A menu-launched run uses
        # self._capture with _capture_slot = None (the None marks it
        # standalone, so pump_capture routes it to _pump_capture_screen).  _cap_mode is the capture path a
        # *test sequence* takes (ReadPhase → request_capture); the Capture page
        # no longer sets it.
        self._cap_mode:     str = "normal"    # "calibration" | "normal"
        self._cap_run_mode: str = "fit"       # the in-flight standalone run: "fit" | "show"
        self._cap_group: str = "1"            # images per LED, '1'..'5'
        self._cap_view:  str | None = None    # None | "choice" | "show"
        # Choice form: the LED chosen on the bar, the settings fields' text, and
        # the line of help or status under them.
        self._cap_led: str | None = None
        self._cap_values: dict[str, str] = {}    # the boxes' text, for the chosen LED
        self._cap_global: dict[str, str] = {}    # the global window's text
        self._cap_over: dict[str, dict] = {}     # LEDs with a window of their own
        self._cap_layers: dict[str, list] = {}   # required Bayer layers per LED
        self._cap_layers0: dict[str, list] = {}  # ... as stored, to spot changes
        self._cap_hint_msg: str = ""
        self._cap_running: str | None = None   # LED being calibrated now
        self._cap_fit = None                   # finished fit, awaiting SAVE
        # Show screen: the LED, the exposures on offer, what is chosen, the plot.
        self._show_led: str = ""
        self._show_exps: list = []
        self._show_i: int = 0
        self._show_mode: str = "exposure"
        self._show_layer: str = "B"
        self._show_hint_msg: str = ""
        self._show_image = None

        # Phases screen state (Menu → Phases): the reagent countdowns in
        # seconds, staged while the screen is open and written only by its OK.
        self._cfg_secs: dict[str, int] = {"r1": 0, "r2": 0}

        # Config editor state (Menu → Config): which of the three views is up,
        # what it is showing, and where in the list it is.  _cfge_start holds
        # the value each field on the current page was loaded with, which is
        # what "edited" is measured against and what Rollback puts back.
        self._cfge_view:  str | None = None   # None | "roles" | "role" | "browse"
        self._cfge_role:  str = ""            # the role the role/browse views show
        self._cfge_name:  str = ""            # the parameter the browse view shows
        self._cfge_page:  int = 0
        self._cfge_list:  list = []           # the whole list being paged through
        self._cfge_start: dict[str, str] = {}
        # The page each list was showing when the operator dropped a level.
        # Stepping back comes up on those same four rows: a role picked off
        # page 2 has to hand the screen back on page 2, not at the top of a
        # list the operator would then have to page through again.
        self._cfge_roles_page: int = 0        # roles view, on entering a role
        self._cfge_names_page: int = 0        # role view, on entering Browse
        # An edit lives only in its field, and both the confirm modals and the
        # Browse view take the fields off the screen — so anything typed is
        # held here for the render that brings the role view back.
        self._cfge_hold:  dict[str, str] = {}
        # Whether the footer is currently drawn in its edit-pending state, so a
        # keystroke repaints those five buttons only when it flips.
        self._cfge_footer_pending: bool = False

        # Image viewer state (Menu → View Image, and later Read → View Sample).
        # _view_open is read by _camera_wanted(), so the shared camera is held
        # for as long as the screen is up; without it _maybe_release_camera()
        # would close the sensor on the very next main-loop pass.
        self._view_open      = False
        self._view_frame     = None    # the whole captured frame, numpy BGR
        self._view_bayer     = None    # that frame's raw mosaic, for recap saves
        self._view_state     = None    # image_view.ViewState over that frame
        self._view_pad:   bool = False   # editing the test pad, not the measurement ROIs
        self._view_rois:  dict = {}    # name -> rect.Rect, in image space
        self._view_selected: str | None = None   # one name, or None
        self._view_return_slot: Slot | None = None
        self._view_step      = 1       # edit nudge, image px: 1 or 10; also
                                       # picks the view-mode pan fraction
        self._view_status    = ""      # transient message for the name strip
        # The exposure the last preview settled on, in µs — the starting point
        # for the next one, so re-imaging normally converges on its first frame
        # instead of walking back from the stored calibration every time.
        self._view_exposure_us: int | None = None
        # Edit mode: a working copy of the selected rectangle, and which of its
        # sides (if any) the arrows move.  The working copy is what the screen
        # draws and what Save validates; the stored ROI is untouched until then,
        # so Cancel is free.
        self._view_mode      = "view"  # "view" | "edit"
        self._view_editing   = None    # rect.Rect working copy, or None
        self._view_armed: str | None = None   # left|right|top|bottom, or None

        # Recapture options dialog (opened by the viewer's Img button).
        self._recap_focus: str | None = None   # None | "auto" | "reread"
        self._recap_exp        = "sample"      # "sample" | "whole"
        self._recap_save_focus = False
        self._recap_save_exp   = False
        # Non-exclusive: either, neither, or both may be armed at once.
        self._recap_save_roi   = False   # save the bound ROI as jpeg+bayer h5
        self._recap_save_whole = False   # save the whole frame as jpeg+bayer h5
        # When True, Capture takes a white-LED-off frame instead of the usual
        # briefly-lit one — for a dark reference at the same exposure.
        self._recap_dark       = False

        # LED Color picker state (Menu → LED Colors): the staged active-LED
        # sequence (LED names only — 'dark'/'jpg' never appear in it), which
        # LED is selected (present in exactly one of the two rows at a time,
        # so its name alone identifies it), and the history Prior/Next pages
        # through.
        self._ledpick_colors:   list = []            # staged order, LED names only
        self._ledpick_selected: "str | None" = None
        self._ledpick_history:  list = []             # [(rowid, value)] loaded on open
        self._ledpick_idx:      int = 0                # position in _ledpick_history

    # ── Lifecycle ──────────────────────────────────────────────────────────────

    def start(self, boot=None) -> None:
        """
        Bring the instrument up behind the splash screen, then run.

        The boot is in three acts, because the splash cannot narrate its own
        preconditions: the database and the display come up silently (the
        launcher having timed them into `boot`), the splash then replays those
        and narrates everything after them, and finally the operator chooses
        where to start.

        Args:
            boot: A splash_screen.BootLog the launcher filled in around
                  db_bootstrap.ensure().  Omitted, the splash simply has one
                  fewer line to show.
        """
        self._init_logging()
        if _SIMULATION_MODE:
            log.info("SIMULATION MODE: mock hardware")

        self._boot = boot or splash_screen.BootLog()
        with self._boot.step("Display"):
            self._init_drivers()
            self._init_display()

        splash = self._splash = splash_screen.Splash(
            self._disp, simulation=_SIMULATION_MODE,
            version=version.__version__)
        splash.open()
        splash.replay(self._boot)

        self._init_peripherals(splash)
        # Only now can anything press OK, so notices wait until here.
        splash.attach_input(touch=self._touch, kb=self._kb)

        with splash.running("Screens"):
            self._build_model(splash)

        report = self._run_startup_checks(splash)
        choice = splash.finish(report.summary(), ok=report.ok)
        self._splash = None

        if choice == "menu":
            # open_menu rather than focus: its OK/CANCEL returns the view to
            # the slot passed here, so MENU still lands on the Begin screen,
            # and the Begin screen is not painted twice to get there.
            self.open_menu(self._slots["A"])
        else:
            self.focus(self._slots["A"])
        self._run()

    def _run_startup_checks(self, splash):
        """
        Run the completeness checks as the splash's last narrated step.

        Anything that had to be loaded from a default gets its own message and
        its own OK press — the boot pauses on each one rather than letting a
        recovered value scroll past unread.  Then the step list is replaced by
        the warnings and failures, which is the only part of the boot the
        operator has anything to do about.
        """
        i = splash.step("Configuration")
        report = startup_checks.run_all(
            restored=self._boot.restored if self._boot else None,
            touch=self._touch, temp=self._temp, keyboard=self._kb_ok,
            simulation=_SIMULATION_MODE,
            progress=lambda label: splash.status(f"Checking {label}..."))
        for message in (self._boot.notices if self._boot else []):
            splash.notice(message)
        for message in report.notices():
            splash.notice(message)
        if not report.ok:
            splash.fail(i)
        elif report.warnings():
            splash.warn(i)
        else:
            splash.done(i)

        # The steps have finished saying anything useful; hand the screen over
        # to what the checks found.  Nothing is drawn when nothing went wrong.
        splash.problems(report.problems())
        return report

    @staticmethod
    def _init_logging() -> None:
        name = (os.environ.get("COLORIMETER_LOGLEVEL") or "INFO").upper()
        level = getattr(logging, name, logging.INFO)
        logging.basicConfig(level=level,
                            format="%(levelname)-8s [%(name)s] %(message)s")
        logging_manager.set_level(name if isinstance(level, int) else "INFO")

    def _init_hardware(self) -> None:
        """
        Bring up every device, unnarrated.

        Kept for callers that have no splash to report to (the self-test at
        the foot of this module); start() uses the three phases below so the
        splash can time and show them one at a time.
        """
        self._init_drivers()
        self._init_display()
        self._init_peripherals(None)

    def _init_drivers(self) -> None:
        """
        Import the drivers for this launch mode and construct them.

        No device is talked to here beyond switching the backlight on, so this
        is fast and cannot fail on absent hardware — the probing is in
        _init_display and _init_peripherals.
        """
        if _SIMULATION_MODE:
            from mock.gpiozero_mock import DigitalOutputDevice
            from mock.ili9341_mock import ILI9341
            from mock.tsc2007_mock import TSC2007
            from mock import beeper_mock as beeper
            from mock.kb_reader_mock import KbReader
            from mock.DS18B20_mock import DS18B20
        else:
            from gpiozero import DigitalOutputDevice
            from ili9341 import ILI9341
            from tsc2007 import TSC2007
            import beeper
            from kb_reader import KbReader
            from DS18B20 import DS18B20

        self._beeper    = beeper
        self._ILI9341   = ILI9341
        self._kb        = KbReader()
        self._backlight = DigitalOutputDevice(config.backlight_pin(),
                                              initial_value=True)
        self._disp      = ILI9341()
        self._touch     = TSC2007()
        self._temp      = DS18B20()

        def _shutdown(signum=None, frame=None):
            self.shutdown()

        signal.signal(signal.SIGINT,  _shutdown)
        signal.signal(signal.SIGTERM, _shutdown)

        # Installed here rather than after the peripherals, so the splash's
        # own buttons click like every other button.  Safe this early: beeper
        # builds its singleton at import.
        widgets.set_button_sound(beeper.click)

    def _init_display(self) -> None:
        """
        Bring up the display — the one step the splash cannot narrate, being
        the step that gives it somewhere to draw.
        """
        self._disp.init()

        # Registered here, immediately after the display exists, rather than
        # after the peripherals: the mock display is where simulated key and
        # mouse events come from, so a splash pumping input during the steps
        # below would otherwise be deaf for all of them.  Safe this early —
        # the mock touch driver's handlers work before its init().
        if _SIMULATION_MODE and hasattr(self._disp, "register_key_handler"):
            self._disp.register_key_handler(self._kb._on_key_event)          # type: ignore
            self._disp.register_mouse_handler(self._touch._on_touch)         # type: ignore
            self._disp.register_touch_release_handler(self._touch._on_release)  # type: ignore

    def _init_peripherals(self, splash) -> None:
        """
        Probe touch, keyboard and the temperature bus, narrating each.

        A step that runs without raising is not the same as a device that
        answered: KbReader.open() returns False when no keyboard is on the
        bus, and DS18B20.init() finds no probe just as quietly.  Both used to
        report 'ok' — the step had, after all, completed — which said the
        opposite of what the operator needed to know.  So the steps that can
        come up empty are marked from what they found, not from whether they
        returned, and startup_checks says what to do about it.

        Args:
            splash: The Splash to report to, or None to run silently.
        """
        def run(label, fn, found=None):
            """Narrate `fn`; mark the step amber when `found` says it is empty."""
            if splash is None:
                return fn()
            i = splash.step(label)
            try:
                out = fn()
            except BaseException:
                splash.fail(i)
                raise
            if found is not None and not found(out):
                splash.warn(i)
            else:
                splash.done(i)
            return out

        run("Touch", self._touch.init)
        self._kb_ok = run("Keyboard", self._kb.open, found=bool)
        run("Temperature", self._temp.init,
            found=lambda _: getattr(self._temp, "connected", False))

    def _build_model(self, splash=None) -> None:
        """
        Build the widget pool, the phase registry and the two slots.

        Args:
            splash: Unused beyond keeping the call sites symmetrical — the
                    step is narrated by the caller, which times it.
        """
        self._pool = Pool.build()
        # Step 1's countdown is a configured constant, so it is baked into the
        # phase here.  Step 2's is not passed at all: it depends on the sample,
        # and Reagent2Phase asks reagent2_plan() for it when it needs one.
        self._phases = build_phases(
            reagent1_secs=config.reagent1_secs(),
            preimage=config.capture_preimage_enabled(),
            test_variant=config.test_variant_enabled())
        self._slots = {"A": Slot("A"), "B": Slot("B")}
        self._load_defaults()

    def _load_defaults(self) -> None:
        """Load the GUI default values (entry pre-fills) from the config table."""
        try:
            self._defaults = sample_repo.load_defaults()
        except sqlite3.Error:
            log.exception("Arbiter: could not load defaults")
            self._defaults = None
        if self._defaults is None:
            log.warning("Arbiter: no defaults loaded — entry fields start blank")

    def cleanup(self) -> None:
        """
        Release every hardware resource.  Idempotent (safe to call more than
        once), and each release is wrapped independently so one device
        failing to close can't strand the rest still holding their pins/fds.
        """
        if self._cleaned_up:
            return
        self._cleaned_up = True
        log.info("Arbiter: cleanup")

        if self._capture is not None:
            try:
                self._capture.cancel()
            except Exception:
                log.exception("Arbiter: cleanup: capture.cancel failed")
            self._capture = None

        if self._prefetch is not None:
            try:
                self._prefetch.cancel()
            except Exception:
                log.exception("Arbiter: cleanup: prefetch.cancel failed")
            self._prefetch = None
            self._prefetch_slot = None
            self._prefetch_epoch = None

        # Sessions borrow the shared camera without stopping it, so the Arbiter
        # (its owner) releases it here.
        self._release_camera()

        if self._disp and self._ILI9341:
            try:
                self._disp.fill_screen(self._ILI9341.BLACK)
            except Exception:
                log.exception("Arbiter: cleanup: fill_screen failed")

        if self._kb:
            try:
                self._kb.cleanup()
            except Exception:
                log.exception("Arbiter: cleanup: keyboard release failed")
        if self._beeper:
            try:
                self._beeper.cleanup()
            except Exception:
                log.exception("Arbiter: cleanup: beeper release failed")
        if self._touch:
            try:
                self._touch.cleanup()
            except Exception:
                log.exception("Arbiter: cleanup: touch release failed")
        if self._temp:
            try:
                self._temp.cleanup()
            except Exception:
                log.exception("Arbiter: cleanup: temperature sensor release failed")
        if self._disp:
            try:
                self._disp.cleanup()
            except Exception:
                log.exception("Arbiter: cleanup: display release failed")
        if self._backlight:
            try:
                self._backlight.close()
            except Exception:
                log.exception("Arbiter: cleanup: backlight release failed")

    def shutdown(self, error: BaseException | None = None) -> None:
        """
        The one true shutdown entry point — called by the SIGINT/SIGTERM
        handler and by the launchers' top-level except clauses.  Shows the
        interactive shutdown screen (Abort / Re-launch / Exit / Power off)
        while hardware is still live.  "Abort" returns to the running program
        without releasing hardware; all other choices release hardware, then
        act on the choice.  Never returns: it always ends in sys.exit() or
        os.execv(), except when choosing "Abort".

        A second call while shutdown is already in progress (e.g. a second
        Ctrl-C because the first seems to hang) skips straight to a hard
        process exit rather than re-entering this method or cleanup().
        """
        if self._shutting_down:
            log.warning("Arbiter: shutdown re-entered — forcing immediate exit")
            os._exit(1)
        self._shutting_down = True
        log.info("Arbiter: shutdown requested%s", " (error)" if error else "")

        choice = "exit"
        try:
            if self._disp is not None:
                choice = shutdown_screen.run(self._disp, self._touch, self._kb,
                                             error=error, simulation=_SIMULATION_MODE,
                                             timeout_s=config.shutdown_timeout_s())
        except Exception:
            log.exception("Arbiter: shutdown screen failed")

        if choice == "abort":
            log.info("Arbiter: shutdown aborted, resuming")
            self._shutting_down = False
            self._resume_display()
            return

        try:
            self.cleanup()
        finally:
            self._finish_shutdown(choice)

    def _finish_shutdown(self, choice: str) -> None:
        """Act on the operator's shutdown choice.  Hardware is already released."""
        if choice == "relaunch":
            log.info("Arbiter: relaunching")
            os.execv(sys.executable, [sys.executable] + sys.argv)
        elif choice == "poweroff":
            if _SIMULATION_MODE:
                log.info("Arbiter: SIMULATION — would power off now")
            else:
                log.info("Arbiter: powering off")
                try:
                    subprocess.run(["sudo", "shutdown", "-h", "now"], check=True)
                except Exception:
                    log.exception("Arbiter: poweroff command failed")
        sys.exit(0)

    # ── Phase contract: clock / stamps ─────────────────────────────────────────

    def now(self) -> float:
        return time.monotonic()

    def timestamp(self) -> str:
        return datetime.datetime.now().strftime("%Y-%m-%d %H:%M:%S")

    def epoch(self) -> int:
        """Wall-clock seconds since the epoch — for the samples.* milestone stamps."""
        return int(time.time())

    # ── Phase contract: temperature sensor ─────────────────────────────────────

    def read_temperature(self):
        """
        Sample the DS18B20 and return the temperature in Celsius as a float, or
        None if no sensor is connected / the reading failed.  Called from the
        entry2 Temp label button so the operator can capture the sample's
        temperature with one press.
        """
        if self._temp is None:
            return None
        return self._temp.read_c()

    def temperature_attached(self) -> bool:
        """
        Whether a DS18B20 was found on the 1-Wire bus.

        Separate from read_temperature() because the two answer different
        questions: a probe that is present but whose reading failed is an
        error worth showing the operator, while no probe at all is the
        ordinary case on a unit run without one — entry2 offers the
        configured default temperature instead of an error there.
        """
        return bool(getattr(self._temp, "connected", False))

    # ── Phase contract: reagent 2's temperature-compensated countdown ──────────

    def t2ref25_secs(self) -> int:
        """protocol.t2ref25_secs — reagent 2's wait at the 25 °C reference."""
        return config.t2ref25_secs()

    def reagent2_plan(self, slot: Slot) -> tuple:
        """
        How long reagent step 2 should run for this slot, and on what grounds.

        The duration is config_repo.reagent2_secs(theta); this method's job is
        only to decide which theta answers.  The sample's own temperature is
        preferred — entered or probe-read on Entry screen 2 and persisted as a
        float — and defaults.default_temperature stands in when the field was
        left empty, which is the same stand-in Entry 2's Temp button offers on a
        unit with no probe.

        The stand-in is reported rather than hidden: a wait computed from an
        assumed temperature is a weaker claim than one computed from a measured
        one, so Reagent2Phase brackets it on screen and the operator can see
        which they are looking at before pressing START.

        Args:
            slot: The slot whose sample temperature to read.

        Returns:
            (secs, temp_c, measured) — the countdown in seconds, the
            temperature it came from in °C, and whether that temperature came
            from the sample rather than the configured stand-in.
        """
        temp_c = _to_float(slot.record.get("samp_degC"))
        measured = temp_c is not None
        if not measured:
            temp_c = getattr(self._defaults, "default_temperature", None)
            if temp_c is None:
                # No sample temperature and no stand-in: the only honest answer
                # left is the reference itself, which is the uncompensated wait.
                temp_c = config.REF_TEMP_C
                log.warning("Arbiter: slot %s has no sample temperature and no "
                            "configured default — reagent 2 will run "
                            "uncompensated", slot.name)
        return config.reagent2_secs(temp_c), float(temp_c), measured

    def reagent1_stir_seconds(self) -> int:
        """protocol.reagent1_stir_seconds — stir duration for reagent 1."""
        return config.reagent1_stir_seconds()

    def reagent_weigh_plan(self, slot: Slot, n: int) -> ReagentWeights:
        """
        Everything the weight grid needs about reagent `n`, in grams.

        `net` deliberately answers two different questions, because the same
        cell answers them in turn:

        - initial entered, final blank -> what the packet holds
          (initial - the empty packet's own weight), which is what the operator
          needs before pouring;
        - both entered -> what was actually poured in (initial - final), which
          is the number the analysis wants.

        `overage` is net - target either way, so a single reading of the Over
        cell means "this much more than the protocol asks for" both before and
        after the pour.

        `target` comes from the sample volume alone and no longer waits for a
        valid initial weight: it fills the Target cell, and it is what makes an
        overage computable at all, so gating it on the initial weight would
        leave the grid blank exactly when the operator is deciding what to do.

        On a test-variant run `target` is also scaled by the run's weight
        factor (R1_wt_factor / R2_wt_factor), so Over, the START gate and the
        "Add x g" instruction all follow the varied amount.

        Any of `initial`, `final`, `net`, `target` and `overage` may be None —
        an unentered or unparseable weight is absent, not zero.

        Args:
            slot: The slot whose record to read weights from.
            n: 1 for reagent 1, 2 for reagent 2.

        Returns:
            A ReagentWeights(initial, final, net, target, overage, tol).
        """
        prefix = f"reagent{n}_"
        empty_wt = (config.reagent1_empty_packet_wt() if n == 1
                    else config.reagent2_empty_packet_wt())
        ratio = (config.reagent1_100ml_wt() if n == 1
                 else config.reagent2_100ml_wt())
        tol = config.reagent_wt_tolerance()

        initial = _to_float(slot.record.get(f"{prefix}initial_wt", ""))
        final = _to_float(slot.record.get(f"{prefix}final_wt", ""))
        sample_wt = _to_float(slot.record.get("samp_grams", ""))

        if initial is None:
            net = None
        elif final is None:
            net = initial - empty_wt
        else:
            net = initial - final

        target = (None if sample_wt is None else sample_wt / 100.0 * ratio
                  * _factor_value(slot.record.get(f"R{n}_wt_factor")))
        overage = None if (net is None or target is None) else net - target

        return ReagentWeights(initial=initial, final=final, net=net,
                              target=target, overage=overage, tol=tol)

    def reagent_time_factor(self, slot: Slot, n: int) -> float:
        """
        Multiplier on reagent `n`'s countdown: the run's R{n}_time_factor.

        1.0 on a production run.  Only the countdown is scaled; the stir
        sub-alarm keeps its configured length.
        """
        return _factor_value(slot.record.get(f"R{n}_time_factor"))

    def reagent_finals_complete(self, slot: Slot) -> bool:
        """
        Both reagents' final packet weights have been entered.

        The gate between a finished capture and analysis: reagentN_g is the
        difference of the two weighings, so a run missing a final weighing has
        no record of how much reagent it actually received.
        """
        return all(str(slot.record.get(f"reagent{n}_final_wt", "")).strip()
                   for n in (1, 2))

    def reagent2_stir_plan(self, slot: Slot) -> int:
        """
        Stir duration in seconds for reagent 2, temperature-compensated.
        Returns 0 if no stir sub-alarm is configured.
        """
        return config.reagent2_stir_secs(
            float(slot.record.get("samp_degC", "21.0") or "21.0")
        )

    def _stir_alarm(self, slot: Slot) -> None:
        """Sound a 2-second beep for the stir sub-alarm."""
        log.info("Arbiter: STIR ALARM for slot %s", slot.name)
        if self._beeper is None:
            return
        fn = getattr(self._beeper, "beep", None)
        if callable(fn):
            fn(duration=2.0)

    # ── Phase contract: database / sample lifecycle ────────────────────────────

    def defaults(self):
        """The loaded GUI defaults (entry pre-fills), or None if unavailable."""
        return self._defaults

    def _samp_no_template(self) -> str:
        return self._defaults.samp_no_template if self._defaults else ""

    def next_sample_no(self, slot: Slot | None = None) -> str:
        """
        The next sample number for a slot opening fresh: one past the database
        and past whatever the *other* slots are displaying, so two slots never
        show the same number.  The asking slot is left out of that comparison —
        it is asking what to hold, so its own value cannot stand in its way.
        """
        held = [s.record.get("samp_no", "")
                for s in self._slots.values() if s is not slot]
        try:
            return sample_repo.next_sample_no(self._samp_no_template(), held)
        except sqlite3.Error:
            log.exception("Arbiter: next_sample_no failed")
            return ""

    def claim_next_no(self, slot: Slot) -> None:
        """
        Put the next unclaimed number in `slot`, moving any slot showing it aside.

        Unclaimed means "no row in samples" — Begin inserts synchronously, so the
        table is the whole claim registry and what another slot merely displays
        is not a claim.  This therefore takes the true next number and bumps that
        slot, rather than skipping past it.  (Were the insert ever deferred, this
        would have to consult the begun slots as well.)

        Returning early when the slot already holds that number is what makes
        repeated ID presses idempotent.
        """
        template = self._samp_no_template()
        try:
            want = sample_repo.next_sample_no(template)      # the table alone
            if sample_repo.same_samp_no(slot.record.get("samp_no", ""), want):
                return                                       # already ours
            slot.record["samp_no"] = want
            for other in self._slots.values():
                # A claimed number is in the table, so next_sample_no could not
                # have offered it; skipping those slots is belt and braces.
                if other is slot or other.record.get("db_rowid") is not None:
                    continue
                if sample_repo.same_samp_no(other.record.get("samp_no", ""), want):
                    other.record["samp_no"] = self.next_sample_no(other)
        except sqlite3.Error:
            log.exception("Arbiter: claim_next_no failed for slot %s", slot.name)

    def begin_sample(self, slot: Slot) -> bool:
        """
        Reserve the sample row at Begin (INSERT), claiming its samp_no in the DB.
        Returns False on a duplicate/invalid samp_no (UNIQUE violation) so the
        caller can warn the operator instead of advancing.
        """
        r = slot.record
        try:
            rowid = sample_repo.insert_sample(
                r["samp_no"], r["user"], r["test_kit"], r["test_lot"],
                r["instrument_sn"])
        except sqlite3.IntegrityError:
            log.warning("Arbiter: samp_no %r already in use", r["samp_no"])
            return False
        except sqlite3.Error:
            log.exception("Arbiter: begin_sample failed for slot %s", slot.name)
            return False
        r["db_rowid"] = rowid
        log.info("Arbiter: reserved sample %s (rowid=%s) for slot %s",
                 r["samp_no"], rowid, slot.name)
        return True

    def persist(self, slot: Slot, **cols) -> None:
        """
        Update the slot's record and write the given columns to its samples row.
        A no-op on the DB side until the row is reserved (db_rowid set); the
        record is always updated so the values survive in memory regardless.
        """
        slot.record.update(cols)
        rowid = slot.record.get("db_rowid")
        if rowid is None:
            return
        try:
            sample_repo.update_sample(rowid, **cols)
        except sqlite3.Error:
            log.exception("Arbiter: persist failed for slot %s (rowid=%s)",
                          slot.name, rowid)

    # ── Phase contract: test-variant treatment ─────────────────────────────────

    def equipment_list(self) -> list:
        """The test-variant screen's Equip choices; [] if they cannot be read."""
        try:
            return sample_repo.equipment_list()
        except sqlite3.Error:
            log.exception("Arbiter: equipment list unavailable")
            return []

    def latest_treatment(self):
        """The newest treatments row as a dict, or None (also on a read error)."""
        try:
            return sample_repo.latest_treatment()
        except sqlite3.Error:
            log.exception("Arbiter: latest treatment unavailable")
            return None

    def save_treatment(self, slot: Slot) -> None:
        """
        Write the slot's test-variant choices as its treatments row.

        The factors are stored as numbers; VariantPhase only lets Continue
        through once each one parses, so the conversion cannot fail here.
        """
        r = slot.record
        try:
            sample_repo.save_treatment(
                r.get("samp_no"), test_equip=r.get("test_equip"),
                image_reps=int(r.get("image_reps") or 1),
                **{k: _to_float(r.get(k)) for k in VariantPhase.FIELDS.values()})
        except sqlite3.Error:
            log.exception("Arbiter: save_treatment failed for slot %s", slot.name)

    def _flush_entry(self, slot: Slot) -> None:
        """
        Write typed edits to the claimed row before the view leaves the screen.

        Screen 1's three identity fields are editable only once the row
        exists, and keystrokes
        land in the record rather than the database (write_one opens its own
        connection, far too costly per character).  So the record is flushed at
        the moments the operator navigates away, which is every way out of the
        screen bar losing power.  samp_no is deliberately absent: it is claimed,
        and the screen locks it.

        The read screen's manual reading is flushed the same way.  It is also
        written when CAPTURE is pressed, but for a lab standard the amount is
        typed in ahead — often while previewing the read screen during the
        reagent 2 countdown — and must reach samples.manual_read even if the
        operator leaves the screen first.

        Gated on the *viewed* phase, so edits made while previewing screen 1 from
        entry2, or the read screen from reagent 2, are flushed too.
        """
        if slot.record.get("db_rowid") is None:
            return
        r = slot.record
        if slot.phase == "entry":
            self.persist(slot, user=r["user"], test_kit=r["test_kit"],
                         test_lot=r["test_lot"])
        elif slot.phase == "read":
            self.persist(slot, manual_read=r["manual_read"])

    # ── Phase contract: navigation / render ────────────────────────────────────

    def goto(self, slot: Slot, phase_id: str) -> None:
        """
        Advance a slot to a phase (the real protocol flow): this becomes the
        slot's live phase.  Runs its once-only activate, then draws if focused.
        """
        self._flush_entry(slot)
        slot.phase = slot.active_phase = phase_id
        self._phases[phase_id].activate(self, slot)
        self.render(slot)

    def view(self, slot: Slot, phase_id: str) -> None:
        """
        Preview a phase without advancing the test (PRIOR/NEXT browsing).  Only
        the viewed phase changes — the live phase, its timer, and any capture
        keep running untouched.  No activate(), so nothing is started or reset.
        """
        self._flush_entry(slot)
        slot.phase = phase_id
        self.render(slot)

    def resume(self, slot: Slot) -> None:
        """Return the view to the slot's live phase (the header Resume button)."""
        self.view(slot, slot.active_phase)

    def render(self, slot: Slot) -> None:
        """
        Draw the slot's current phase.  A no-op for an unfocused slot: enter()
        writes into the single shared pool, so only the focused slot may run it.
        """
        if slot is not self._focused or self._pool is None:
            return
        self._pool.hide_all()
        self._phases[slot.phase].enter(self._pool, slot, self)
        self._paint_slot_toggle()
        self._paint_alarm(slot)
        self._pool.render(self._disp)
        self._rebuild_focus()

    def focus(self, slot: Slot) -> None:
        """Make a slot the displayed one and render it (user-initiated only)."""
        if self._focused is not None and self._focused is not slot:
            self._flush_entry(self._focused)   # the slot being left behind
        self._focused = slot
        self._disarm_alarm(slot)     # regaining focus clears its visible alarm
        self.render(slot)

    def _resume_display(self) -> None:
        """Repaint whatever was on screen before a full-screen interruption
        (e.g. an aborted shutdown screen) — the splash, a slot, or the Menu."""
        # During the boot there is no focused slot and often no pool, so
        # without this an aborted shutdown screen would leave a blank panel
        # with the splash still pumping input onto it.
        if self._splash is not None:
            self._splash.repaint()
            return
        if self._focused is not None:
            self.render(self._focused)
        elif self._ledtest_open:
            self._ledtest_render()
        else:
            self._render_menu()

    def toggle_slot(self) -> None:
        """Switch the display to the other slot; both stay live regardless."""
        other = self._slots["B"] if self._focused is self._slots["A"] else self._slots["A"]
        log.info("Arbiter: focus %s -> %s", self._focused.name, other.name)
        self.focus(other)

    # def _paint_slot_toggle(self) -> None:
    #     """Label the slot button with the slot you would switch TO."""
    #     target = "B" if self._focused.name == "A" else "A"
    #     from palette import color
    #     btn = self._pool["slot_btn"]
    #     btn.label = target
    #     btn.color = color("slot_b_bg" if target == "B" else "slot_a_bg")
    #     btn.on_press = self.toggle_slot

    def _paint_slot_toggle(self) -> None:
        """Show the CURRENT slot (id + colour); pressing it toggles to the other."""
        current = self._focused.name
        from palette import color
        btn = self._pool["slot_btn"]
        btn.label = current
        btn.color = color("slot_a_bg" if current == "A" else "slot_b_bg")
        btn.on_press = self.toggle_slot

    # ── Menu screen ──────────────────────────────────────────────────────────────
    # A screen of its own, reached by the dedicated footer MENU button (not the
    # A/B toggle) and left via its own OK/CANCEL — never tied to slot A/B data.

    def open_menu(self, slot: Slot) -> None:
        """Open the Menu screen; `slot` is who OK/CANCEL will return the view to."""
        self._flush_entry(slot)
        self._pre_menu_slot = slot
        self._focused = None
        self._render_menu()

    def _render_menu(self) -> None:
        if self._pool is None:
            return
        self._pool.hide_all()
        self._pool.put("menu_cancel_btn", "CANCEL", on=self._menu_cancel)
        self._pool.put("menu_title",      "Menu")
        self._pool.put("menu_ok_btn",     "OK",     on=self._menu_ok)
        # The 3x2 option grid, laid out in layout.py.  "View Image" is disabled
        # while a capture is in flight — the imaging tools share the camera and
        # LED bank with the capture path.  "Reagent Phases" edits the two
        # reagent countdowns; "Config" is the general editor over every
        # setting, reagent countdowns included.  "Advanced" holds the rarely
        # used tools, Capture among them.
        self._pool.put("menu_capture",    "Advanced", on=self._render_advanced)
        self._pool.put("menu_stub1",      "View\nImage",
                       on=self._menu_open_image_view,
                       enabled=self.capture_available())
        self._pool.put("menu_defaults",   "LED\nColors", on=self._menu_open_ledpick)
        self._pool.put("menu_stub2",      "Config",   on=self._cfge_open)
        self._pool.put("menu_config",     "Reagent\nPhases", on=self._menu_open_config)
        self._pool.put("menu_power",      "Power",    on=self._menu_power)
        self._pool.render(self._disp)
        self._rebuild_focus()

    # Nothing is staged at the menu level any more — the screens it opens each
    # commit their own changes — so OK and CANCEL are two ways out of the same
    # screen.  Both are kept because the header chrome is shared with the
    # screens below, where the distinction still means something.

    def _menu_ok(self) -> None:
        """Leave the menu."""
        self._close_menu()

    def _menu_cancel(self) -> None:
        """Leave the menu."""
        self._close_menu()

    def _close_menu(self) -> None:
        slot = self._pre_menu_slot or self._slots["A"]
        self._pre_menu_slot = None
        self.focus(slot)

    def _menu_power(self) -> None:
        self.shutdown()

    def _menu_open_image_view(self) -> None:
        """
        Menu → View Image (Tool 1): the whole frame with every ROI drawn on.

        Exit returns to the Menu, not to the slot, so the menu's OK/CANCEL
        still get their say over anything staged before the viewer was opened.
        """
        self.open_image_view(slot=None)

    # ── Advanced screen (Menu → Advanced) ───────────────────────────────────────
    # The Menu's layout again, for tools an operator rarely needs.  Like the
    # Menu, nothing is staged here, so OK and CANCEL both go back to the Menu.

    def _render_advanced(self) -> None:
        if self._pool is None:
            return
        p = self._pool
        p.hide_all()
        p.put("menu_cancel_btn", "CANCEL", on=self._render_menu)
        p.put("adv_title",       "Advanced")
        p.put("menu_ok_btn",     "OK",     on=self._render_menu)
        p.put("adv_capture",   "Capture",  on=self._menu_open_capture)
        p.put("adv_test_led",  "Test LED", on=self._ledtest_open_screen,
              enabled=self._ledtest_available())
        p.put("adv_cap_image", "Capture\nImage", on=self._img_open)
        p.put("adv_wifi",      "Wifi",     on=self._wifi_open)
        p.put("adv_touch_cal", "Calibrate\nTouchpad", on=self._tcal_open)
        p.render(self._disp)
        self._rebuild_focus()

    # ── LED test (Menu → Advanced → Test LED) ───────────────────────────────────
    # Tap a swatch on the LED bar to light that LED; tap it again to put it
    # out.  At most one is lit: tapping another puts the first out before
    # lighting the second.  Nothing is saved, so SAVE and CANCEL both leave,
    # and leaving always puts every LED out.  Only the LED bank is used — the
    # camera is not opened.

    def _ledtest_available(self) -> bool:
        """True when no capture or prefetch is using the LED bank."""
        return self.capture_available() and self._prefetch is None

    def _ledtest_open_screen(self) -> None:
        if not self._ledtest_available():
            return
        self._ledtest_open = True
        self._ledtest_lit = None
        self._ledtest_msg = ""
        if self._ledtest_bank() is None:
            self._ledtest_msg = "LED bank failed to open - see the log"
        self._ledtest_render()

    def _ledtest_bank(self):
        """The shared LED bank, opened here if no capture has opened it; or None."""
        if self._leds is None:
            try:
                from lighting_cal8 import LEDBank
                self._leds = LEDBank()
            except Exception:
                log.exception("Arbiter: LED test could not open the LED bank")
                return None
        return self._leds

    def _ledtest_toggle(self, led: str) -> None:
        """Light `led`, or put it out if it is the one lit."""
        leds = self._ledtest_bank()
        if leds is None:
            return
        try:
            leds.all_off()
            self._ledtest_lit = None if led == self._ledtest_lit else led
            if self._ledtest_lit is not None:
                leds.set_channel(led, True)
            self._ledtest_msg = ""
        except Exception:
            log.exception("Arbiter: LED test could not switch %s", led)
            self._ledtest_lit = None
            self._ledtest_msg = f"Could not switch {led} - see the log"
        self._ledtest_render()

    def _ledtest_all_off(self) -> None:
        if self._leds is not None:
            try:
                self._leds.all_off()
            except Exception:
                log.exception("Arbiter: LED test could not switch the LEDs off")
        self._ledtest_lit = None

    def _ledtest_leave(self) -> None:
        """Put every LED out and go back to the Advanced screen."""
        self._ledtest_all_off()
        self._ledtest_open = False
        self._render_advanced()

    def _ledtest_status_text(self) -> str:
        if self._ledtest_msg:
            return self._ledtest_msg
        if self._ledtest_lit is None:
            return "All LEDs off"
        return f"On: {self._ledtest_lit}"

    def _ledtest_render(self) -> None:
        if self._pool is None:
            return
        from palette import color, rgb
        from lighting_cal8 import LEDBank
        p = self._pool
        p.hide_all()
        p.put("menu_cancel_btn", "CANCEL", on=self._ledtest_leave)
        p.put("ledt_title",      "LED Test")
        p.put("menu_ok_btn",     "SAVE",   on=self._ledtest_leave)
        usable = self._leds is not None
        for i, led in enumerate(LEDBank.color_names(), 1):
            name = f"cap_led{i}"
            fill_rgb, text_name = _LEDPICK_SWATCH[led]
            lit = led == self._ledtest_lit
            p.put(name, "ON" if lit else _led_initials(led),
                  on=lambda l=led: self._ledtest_toggle(l), enabled=usable)
            w = p[name]
            w.color = w.disabled_color = rgb(*fill_rgb)
            w.text_color = color(text_name)
            w.border_color = color("black") if lit else None
        p.put("ledt_hint",   "Tap color to toggle LED on or off")
        p.put("ledt_status", self._ledtest_status_text())
        p.render(self._disp)
        self._rebuild_focus()

    # ── Capture Image (Menu → Advanced → Capture Image) ────────────────────────
    # Photographs one LED at the chosen rungs of its stored exposures and saves
    # the ticked image types as one test image (capture_image.py).  Capture
    # saves as its last step, so there is no SAVE: BACK just leaves, and
    # abandons a capture under way, which then leaves no file.

    _IMG_TYPE_BUTTONS = (("jpg_whole", "jpg\nwhole"), ("jpg_bound", "jpg\nbound"),
                         ("bayer_whole", "Bayers\nwhole"),
                         ("bayer_bound", "Bayers\nbound"),
                         ("darkframes", "Dark\nframes"))

    def _img_open(self) -> None:
        import config_repo
        import test_image_repo
        self._img_name = test_image_repo.next_name(config_repo.capture_test_image_dir())
        self._img_status = ""
        self._cap_view = None
        self._img_render()

    def _img_read_fields(self) -> None:
        """Keep what the two text boxes show: they are edited by keyboard."""
        if self._pool is None or self._cap_view != "image":
            return
        self._img_name = str(self._pool["img_fld_name"].value).strip()
        self._img_desc = str(self._pool["img_fld_desc"].value)

    def _img_choice(self):
        import capture_image
        return capture_image.ImageChoice(
            self._img_led or "", [r for r in self._img_rung_list()],
            [t for t in capture_image.IMAGE_TYPES if t in self._img_types],
            self._img_name, self._img_desc)

    def _img_rung_list(self) -> "list[str]":
        import exposure_repo
        return [r for r in exposure_repo.RUNGS if r in self._img_rungs]

    def _img_problem(self, exposures) -> "str | None":
        """Why Capture cannot run now, or None."""
        import capture_image
        import config_repo
        import test_image_repo
        if self._img_led is None:
            return "Tap an LED color"
        if not exposures:
            return f"{self._img_led} has no stored exposures"
        problem = capture_image.choice_problem(self._img_choice(), exposures)
        return problem or test_image_repo.name_problem(
            self._img_name, config_repo.capture_test_image_dir())

    def _img_pick_led(self, led: str) -> None:
        self._img_read_fields()
        self._img_led = led
        self._img_status = ""
        self._img_render()

    def _img_toggle_rung(self, rung: str) -> None:
        import exposure_repo
        self._img_read_fields()
        if rung == "All":
            stored = set(exposure_repo.rung_exposures(self._img_led or ""))
            self._img_rungs = set() if stored <= self._img_rungs else stored
        else:
            self._img_rungs ^= {rung}
        self._img_status = ""
        self._img_render()

    def _img_toggle_type(self, kind: str) -> None:
        self._img_read_fields()
        self._img_types ^= {kind}
        self._img_status = ""
        self._img_render()

    def _img_render(self) -> None:
        if self._pool is None:
            return
        import exposure_repo
        from palette import color, rgb
        from lighting_cal8 import LEDBank
        self._img_read_fields()
        self._cap_view = "image"
        p = self._pool
        p.hide_all()
        busy = self._capture is not None
        exposures = exposure_repo.rung_exposures(self._img_led) if self._img_led else {}
        problem = self._img_problem(exposures)
        idle = self._ledtest_available()
        p.put("menu_cancel_btn", "BACK", on=self._img_back)
        p.put("img_title", "Capture\nimage")
        p.put("menu_ok_btn", "Capture", on=self._img_capture,
              enabled=problem is None and idle)
        sel, unsel = color("start_green"), color("btn_gray")
        for i, led in enumerate(LEDBank.color_names(), 1):
            name = f"cap_led{i}"
            fill_rgb, text_name = _LEDPICK_SWATCH[led]
            p.put(name, _led_initials(led), on=lambda l=led: self._img_pick_led(l),
                  enabled=not busy)
            w = p[name]
            w.color = w.disabled_color = rgb(*fill_rgb)
            w.text_color = color(text_name)
            w.border_color = color("black") if led == self._img_led else None
        p.put("img_rung_lbl", "Rungs")
        for i, rung in enumerate(exposure_repo.RUNGS + ("All",), 1):
            name = f"img_rung{i}"
            on = (rung in self._img_rungs if rung != "All"
                  else bool(exposures) and set(exposures) <= self._img_rungs)
            p.put(name, rung, on=lambda r=rung: self._img_toggle_rung(r),
                  enabled=not busy and (rung == "All" and bool(exposures)
                                        or rung in exposures))
            p[name].color = sel if on else unsel
        rungs = " ".join(self._img_rung_list())
        p.put("img_info", f"{self._img_led or '-'} - {rungs or '-'}")
        p.put("img_lbl_name", "Name", on=lambda: self._img_hint(
            "File name; saved as <name>.h5 in test_image"))
        p.put("img_fld_name", self._img_name)
        p.put("img_lbl_desc", "Desc", on=lambda: self._img_hint(
            "Description, typed on the keyboard"))
        p.put("img_fld_desc", self._img_desc)
        for i, (kind, text) in enumerate(self._IMG_TYPE_BUTTONS, 1):
            name = f"img_type{i}"
            p.put(name, text, on=lambda k=kind: self._img_toggle_type(k),
                  enabled=not busy)
            ticked = kind in self._img_types
            p[name].color = sel if ticked else unsel
            p[name].border_color = color("black") if ticked else None
        p.put("img_status", self._img_status or problem or "Tap Capture")
        p.render(self._disp)
        self._rebuild_focus()

    def _img_hint(self, text: str) -> None:
        self._img_read_fields()
        self._img_status = text
        self._img_render()

    def _img_back(self) -> None:
        """Back to Advanced, abandoning a capture under way (it leaves no file)."""
        if self._cap_run_mode == "image" and self._capture is not None:
            self._capture.cancel()
            self._capture = None
            self._capture_slot = None
        self._img_read_fields()
        self._cap_view = None
        self._render_advanced()

    def _img_capture(self) -> None:
        """Photograph and save the test image the screen describes."""
        import capture_image
        from capture_runner import CaptureConfig
        self._img_read_fields()
        if not self._ledtest_available():
            self._img_hint("Camera busy - try again later")
            return
        choice = self._img_choice()

        def make_runner(cam, leds, cfg):
            return capture_image.CaptureImageRunner(cam, leds, choice, cfg)

        session = self._new_session(CaptureConfig(led_colors=[choice.led]),
                                    runner_factory=make_runner)
        if not session.start():
            log.error("Arbiter: test image failed to start: %s", session.error)
            self._img_hint(f"Camera failed: {session.error}"[:48])
            return
        self._capture = session
        self._capture_slot = None
        self._cap_run_mode = "image"
        self._img_saving = choice.name
        self._img_status = f"Capturing {choice.name} ..."
        self._img_render()

    def _pump_image(self, session) -> None:
        """Drive a running test image; say where it went when it ends."""
        import config_repo
        import test_image_repo
        progress = session.step()
        if progress is not None:
            if not getattr(progress, "transient", False):
                self._img_status = f"{self._img_saving}: {progress.message}"[:80]
                if self._cap_view == "image" and self._pool is not None:
                    self._pool.set("img_status", self._img_status)
                    self._pool.redraw(self._disp, "img_status")
            return
        self._capture = None
        self._capture_slot = None
        if session.error is not None:
            self._img_status = f"Not saved: {session.error}"[:80]
        else:
            self._img_status = f"Saved {self._img_saving}"
            self._img_name = test_image_repo.next_name(
                config_repo.capture_test_image_dir())
            if self._pool is not None:      # the redraw reads the box back
                self._pool["img_fld_name"].value = self._img_name
        if self._cap_view == "image":
            self._img_render()

    # ── Wifi (Menu → Advanced → Wifi) ───────────────────────────────────────────
    # Status shows what the device is connected to and how to reach it (IP,
    # MAC, hostname).  Networks lists what the radio sees and the saved
    # profiles, to connect or forget.  Join takes a network name and password
    # from a USB keyboard.  All nmcli work runs as one background job at a
    # time (wifi.py), polled by pump_wifi(), so a slow connect never freezes
    # the screen.  BACK cancels a job under way.  A joined network is saved
    # by NetworkManager and rejoins at boot.

    _WIFI_ROWS = 4

    def _wifi(self):
        if self._wifi_backend is None:
            import wifi
            self._wifi_backend = wifi.backend()
        return self._wifi_backend

    def _wifi_open(self) -> None:
        self._wifi_msg = ""
        self._wifi_view = "status"
        self._wifi_start("status", self._wifi().status())

    def _wifi_start(self, kind: str, job) -> None:
        """Start a job, cancelling any still running, and repaint."""
        if self._wifi_job is not None:
            self._wifi_job.cancel()
        self._wifi_job, self._wifi_job_kind = job, kind
        self._wifi_render()

    def _wifi_busy(self) -> bool:
        return self._wifi_job is not None

    def pump_wifi(self) -> None:
        """Poll the job in flight; act on its result when it ends."""
        job = self._wifi_job
        if job is None:
            return
        result = job.poll()
        if result is None:
            return
        kind = self._wifi_job_kind
        self._wifi_job, self._wifi_job_kind = None, ""
        self._wifi_done(kind, result)

    def _wifi_done(self, kind: str, result) -> None:
        import wifi
        if kind == "status":
            if result.ok:
                radio, device, listing = result.outputs
                self._wifi_radio = wifi.parse_radio(radio)
                self._wifi_device = wifi.parse_device(device)
                self._wifi_networks = wifi.parse_networks(listing)
            else:
                self._wifi_msg = result.message
        elif kind == "scan":
            if result.ok:
                self._wifi_networks = wifi.parse_networks(result.outputs[0])
                self._wifi_saved = wifi.parse_saved(result.outputs[1])
                self._wifi_msg = (f"{len(self._wifi_networks)} networks seen"
                                  if self._wifi_networks else "No networks seen")
            else:
                self._wifi_msg = result.message
        elif kind == "connect":
            name, self._wifi_connecting = self._wifi_connecting, ""
            if result.ok:
                self._wifi_password = ""
                self._wifi_msg = f"Connected to {name}"
                self._wifi_view = "status"
                self._wifi_start("status", self._wifi().status())
                return
            self._wifi_msg = result.message
            if result.message == "Wrong password?" and self._wifi_view == "networks":
                self._wifi_join_view(name, hidden=False)   # a saved password failed
                return
        elif kind == "forget":
            self._wifi_msg = (f"Forgot {self._wifi_forget_armed}" if result.ok
                              else result.message)
            self._wifi_forget_armed = None
            if result.ok:
                self._wifi_start("scan", self._wifi().scan())
                return
        elif kind == "radio":
            if result.ok:
                self._wifi_start("status", self._wifi().status())
                return
            self._wifi_msg = result.message
        self._wifi_render()

    # Rows of the Networks view: what the radio sees, strongest first, then
    # the saved profiles it does not see.  A row's key survives a rescan, so
    # the selection does too.

    def _wifi_rows(self) -> "list[dict]":
        saved = set(self._wifi_saved)
        active = self._wifi_device.connection if self._wifi_device else ""
        rows, seen = [], set()
        for n in self._wifi_networks:
            profile = n.ssid if n.ssid in saved else (active if n.in_use else None)
            if profile:
                seen.add(profile)
            seen.add(n.ssid)
            text = (f"{'* ' if n.in_use else ''}{n.ssid}  {n.signal}%"
                    f"{' lock' if n.secured else ''}{' saved' if profile else ''}")
            rows.append({"key": "v:" + n.ssid, "ssid": n.ssid, "profile": profile,
                         "visible": True, "secured": n.secured, "text": text})
        for name in self._wifi_saved:
            if name not in seen:
                rows.append({"key": "s:" + name, "ssid": name, "profile": name,
                             "visible": False, "secured": True,
                             "text": f"{name}  saved, not seen"})
        return rows

    def _wifi_selected(self) -> "dict | None":
        return next((r for r in self._wifi_rows() if r["key"] == self._wifi_sel), None)

    def _wifi_pick(self, key: str) -> None:
        self._wifi_sel = key
        self._wifi_forget_armed = None
        self._wifi_msg = ""
        self._wifi_render()

    def _wifi_step_page(self, delta: int) -> None:
        pages = max(1, -(-len(self._wifi_rows()) // self._WIFI_ROWS))
        self._wifi_page = max(0, min(pages - 1, self._wifi_page + delta))
        self._wifi_render()

    def _wifi_networks_view(self) -> None:
        self._wifi_view = "networks"
        self._wifi_msg = "Scanning ..."
        self._wifi_forget_armed = None
        self._wifi_start("scan", self._wifi().scan())

    def _wifi_join_view(self, ssid: str, hidden: bool) -> None:
        self._wifi_view = "join"
        self._wifi_ssid, self._wifi_hidden = ssid, hidden
        self._wifi_password = ""
        if self._pool is not None:          # the render reads the boxes back
            self._pool["wifi_fld_ssid"].value = ssid
            self._pool["wifi_fld_pass"].value = ""
        self._wifi_render()

    def _wifi_connect_selected(self) -> None:
        row = self._wifi_selected()
        if row is None:
            return
        self._wifi_forget_armed = None
        if not row["visible"]:
            self._wifi_begin_connect(row["ssid"], self._wifi().up(row["profile"]))
        elif row["secured"] and not row["profile"]:
            self._wifi_join_view(row["ssid"], hidden=False)
        else:
            self._wifi_begin_connect(row["ssid"], self._wifi().connect(row["ssid"]))

    def _wifi_begin_connect(self, ssid: str, job) -> None:
        self._wifi_connecting = ssid
        self._wifi_msg = f"Connecting to {ssid} ..."
        self._wifi_start("connect", job)

    def _wifi_forget(self) -> None:
        """First tap arms, second tap forgets: forgetting can cut off SSH."""
        row = self._wifi_selected()
        if row is None or not row["profile"]:
            return
        if self._wifi_forget_armed != row["profile"]:
            self._wifi_forget_armed = row["profile"]
            self._wifi_msg = f"Tap Forget again to forget {row['profile']}"
            self._wifi_render()
            return
        self._wifi_msg = f"Forgetting {row['profile']} ..."
        self._wifi_start("forget", self._wifi().forget(row["profile"]))

    def _wifi_read_fields(self) -> None:
        if self._pool is None or self._wifi_view != "join":
            return
        self._wifi_ssid = str(self._pool["wifi_fld_ssid"].value)
        self._wifi_password = str(self._pool["wifi_fld_pass"].value)

    def _wifi_toggle(self, which: str) -> None:
        self._wifi_read_fields()
        if which == "show":
            self._wifi_show = not self._wifi_show
        else:
            self._wifi_hidden = not self._wifi_hidden
        self._wifi_render()

    def _wifi_join_connect(self) -> None:
        self._wifi_read_fields()
        ssid = self._wifi_ssid.strip()
        if not ssid:
            self._wifi_msg = "Type the network name"
            self._wifi_render()
            return
        self._wifi_begin_connect(ssid, self._wifi().connect(
            ssid, self._wifi_password, self._wifi_hidden))

    def _wifi_back(self) -> None:
        """Join → Networks → Status → Advanced, cancelling any job under way."""
        self._wifi_read_fields()
        if self._wifi_job is not None:
            self._wifi_job.cancel()
            self._wifi_job, self._wifi_job_kind = None, ""
            self._wifi_connecting = ""
        self._wifi_msg = ""
        if self._wifi_view == "join":
            self._wifi_password = ""
            self._wifi_view = "networks"
            self._wifi_render()
        elif self._wifi_view == "networks":
            self._wifi_view = "status"
            self._wifi_start("status", self._wifi().status())
        else:
            self._wifi_view = None
            self._render_advanced()

    def _wifi_render(self) -> None:
        if self._pool is None or self._wifi_view is None:
            return
        self._wifi_read_fields()
        p = self._pool
        p.hide_all()
        busy = self._wifi_busy()
        view = self._wifi_view
        title = {"status": "Wifi", "networks": "Networks", "join": "Join"}[view]
        p.put("menu_cancel_btn", "BACK", on=self._wifi_back)
        p.put("wifi_title", title)
        if view == "status":
            p.put("menu_ok_btn", "Refresh", enabled=not busy,
                  on=lambda: self._wifi_start("status", self._wifi().status()))
            self._wifi_render_status(p, busy)
        elif view == "networks":
            p.put("menu_ok_btn", "Scan", enabled=not busy, on=self._wifi_networks_view)
            self._wifi_render_networks(p, busy)
        else:
            p.put("menu_ok_btn", "Connect", on=self._wifi_join_connect, enabled=not busy)
            self._wifi_render_join(p, busy)
        p.render(self._disp)
        self._rebuild_focus()

    def _wifi_render_status(self, p, busy: bool) -> None:
        import wifi
        d, radio = self._wifi_device, self._wifi_radio
        if d is None:
            lines = ["Reading ..." if busy else "No Wi-Fi details", "", "", "", ""]
        else:
            signal = next((f"  {n.signal}%" for n in self._wifi_networks if n.in_use), "")
            state = "Wi-Fi off" if radio is False else (d.state or "unknown").capitalize()
            lines = [f"Status  {state}",
                     f"Network  {d.connection or '-'}{signal}",
                     f"IP  {', '.join(d.addresses) or '-'}",
                     f"MAC  {d.mac or '-'}",
                     ""]
        lines[4] = f"Host  {wifi.hostname()}.local"
        for i, text in enumerate(lines, 1):
            p.put(f"wifi_line{i}", text)
        p.put("wifi_msg", self._wifi_msg)
        p.put("wifi_networks", "Networks", on=self._wifi_networks_view,
              enabled=not busy and radio is not False)
        if radio is False:
            p.put("wifi_radio", "Turn\nWi-Fi on", enabled=not busy,
                  on=lambda: self._wifi_start("radio", self._wifi().radio_on()))

    def _wifi_render_networks(self, p, busy: bool) -> None:
        from palette import color
        rows = self._wifi_rows()
        pages = max(1, -(-len(rows) // self._WIFI_ROWS))
        self._wifi_page = min(self._wifi_page, pages - 1)
        first = self._wifi_page * self._WIFI_ROWS
        for i in range(self._WIFI_ROWS):
            name = f"wifi_row{i + 1}"
            if first + i >= len(rows):
                continue
            row = rows[first + i]
            p.put(name, row["text"][:34], on=lambda k=row["key"]: self._wifi_pick(k),
                  enabled=not busy)
            w = p[name]
            chosen = row["key"] == self._wifi_sel
            w.color = color("start_green") if chosen else color("white")
            w.disabled_color = w.color
            w.text_color = color("black") if row["visible"] else color("btn_gray")
            w.border_color = color("black")
        p.put("wifi_up", "▲", on=lambda: self._wifi_step_page(-1),
              enabled=self._wifi_page > 0)
        p.put("wifi_down", "▼", on=lambda: self._wifi_step_page(1),
              enabled=self._wifi_page < pages - 1)
        p.put("wifi_list_msg", self._wifi_msg or "Tap a network")
        row = self._wifi_selected()
        p.put("wifi_connect", "Connect", on=self._wifi_connect_selected,
              enabled=not busy and row is not None)
        p.put("wifi_forget", "Forget" if self._wifi_forget_armed is None else "Forget?",
              on=self._wifi_forget,
              enabled=not busy and row is not None and bool(row["profile"]))
        p.put("wifi_other", "Other...", enabled=not busy,
              on=lambda: self._wifi_join_view("", hidden=True))

    def _wifi_render_join(self, p, busy: bool) -> None:
        from palette import color
        p.put("wifi_lbl_ssid", "Network")
        p.put("wifi_fld_ssid", self._wifi_ssid, enabled=not busy)
        p.put("wifi_lbl_pass", "Password")
        p.put("wifi_fld_pass", self._wifi_password, enabled=not busy)
        p["wifi_fld_pass"].secret = not self._wifi_show
        for name, text, on, key in (("wifi_show", "Show", self._wifi_show, "show"),
                                    ("wifi_hidden", "Hidden", self._wifi_hidden, "hidden")):
            p.put(name, text, on=lambda k=key: self._wifi_toggle(k), enabled=not busy)
            p[name].color = color("start_green") if on else color("btn_gray")
        p.put("wifi_join_msg", self._wifi_msg or
              "Type on the keyboard: tap a box, type, Enter.\n"
              "Hidden: the network does not announce its name.")

    # ── Calibrate Touchpad (Menu → Advanced → Calibrate Touchpad) ───────────────
    # Four corner taps give a new touch calibration (tsc2007.solve_affine).
    # The present one is never put at risk:
    #   - while the corners are tapped, raw readings are collected and the
    #     transform in use is not touched;
    #   - a fit whose BR check misses by more than CAL_MAX_ERR_PX is refused;
    #   - a good fit is tried in memory only, for _TCAL_TRIAL_S seconds.  SAVE
    #     keeps it; BACK, Esc or the countdown running out puts the old values
    #     back, from memory, so the file is never read or written to revert;
    #   - SAVE goes through touch_cal_store.save(): the old file is copied to
    #     touch_cal.bakN.json, then replaced in one step.  If that fails the
    #     old values go back into use.
    # The corner view takes over the main loop's touch handling (_run), since
    # a raw reading is wanted there, not a position.

    _TCAL_TRIAL_S = 30      # a new calibration's trial, before it reverts
    _TCAL_STEP_S = 20       # a corner with no tap for this long stops the run
    _TCAL_TEST_S = 15       # the test view closes after this long untouched
    _TCAL_HELP = ("Calibrate: tap 4 crosshairs with a stylus.\n"
                  "Test: touch anywhere to see where it lands.")

    def _tcal_on_trial(self) -> bool:
        return self._tcal_new is not None

    def _tcal_open(self) -> None:
        self._tcal_view = "home"
        self._tcal_err = None
        self._tcal_msg = ""
        self._tcal_render()

    def _tcal_back(self) -> None:
        """Test → home → Advanced.  Leaving the screen ends a trial unsaved."""
        if self._tcal_view == "test":
            self._tcal_view = "home"
            self._tcal_render()
            return
        if self._tcal_on_trial():
            self._tcal_revert("Not saved.")
        self._tcal_view = None
        self._render_advanced()

    def _tcal_start_corners(self) -> None:
        if self._tcal_on_trial():
            self._tcal_revert("")
        self._tcal_raw = {}
        self._tcal_note = ""
        self._tcal_err = None
        self._tcal_view = "corners"
        self._tcal_step_t0 = time.monotonic()
        self._tcal_render()

    def _tcal_targets(self):
        import tsc2007
        return tsc2007.corner_targets(layout.SCREEN_W, layout.SCREEN_H)

    def _tcal_pump_corner(self) -> None:
        """
        One main-loop pass of the corner view, in place of the usual touch
        handling: gather a tap's raw readings, or stop if none comes.
        """
        import tsc2007
        t = self._touch
        if not t.is_touched:                                    # type: ignore
            if time.monotonic() - self._tcal_step_t0 > self._TCAL_STEP_S:
                self._tcal_finish(f"No tap for {self._TCAL_STEP_S} s; stopped. "
                                  "Nothing was changed.")
            return
        time.sleep(0.05)                                        # debounce
        readings = []
        deadline = time.monotonic() + 0.8
        while time.monotonic() < deadline and t.is_touched:     # type: ignore
            readings.append(t.read_raw())                       # type: ignore
            time.sleep(0.02)
        if not readings:
            readings = [t.read_raw()]                           # type: ignore
        deadline = time.monotonic() + 3.0                       # wait for the lift
        while t.is_touched and time.monotonic() < deadline:     # type: ignore
            if _SIMULATION_MODE and hasattr(self._disp, "process_events"):
                self._disp.process_events()                     # type: ignore
            time.sleep(0.02)
        self._tcal_corner_tapped(tsc2007.average_raw(readings))

    def _tcal_corner_tapped(self, raw) -> None:
        """Record one corner's raw (rx, ry), or None for no steady reading."""
        import tsc2007
        self._tcal_step_t0 = time.monotonic()
        if raw is None:
            self._tcal_note = "No steady reading. Press a little firmer."
            self._tcal_render()
            return
        targets = self._tcal_targets()
        self._tcal_raw[targets[len(self._tcal_raw)][0]] = raw
        self._tcal_note = ""
        if len(self._tcal_raw) < len(targets):
            self._tcal_render()
            return
        try:
            cal, ex, ey = tsc2007.solve_affine(self._tcal_raw,
                                               layout.SCREEN_W, layout.SCREEN_H)
        except ValueError:
            self._tcal_finish("The taps were in a line, so they give no "
                              "calibration. Nothing was changed.")
            return
        self._tcal_err = (ex, ey)
        log.info("touch calibration: raw %s  BR error (%+.1f, %+.1f) px",
                 self._tcal_raw, ex, ey)
        if max(abs(ex), abs(ey)) > tsc2007.CAL_MAX_ERR_PX:
            self._tcal_finish(f"The check corner missed by more than "
                              f"{tsc2007.CAL_MAX_ERR_PX} px. Not used; "
                              "nothing was changed. Try again.")
            return
        self._tcal_old = self._touch.cal                        # type: ignore
        self._tcal_new = cal
        self._touch.apply_cal(cal)                              # type: ignore
        self._tcal_trial_end = time.monotonic() + self._TCAL_TRIAL_S
        self._tcal_finish("")

    def _tcal_finish(self, msg: str) -> None:
        """Leave the corner view for home, with `msg`."""
        self._tcal_msg = msg
        self._tcal_view = "home"
        self._tcal_render()

    def _tcal_revert(self, msg: str) -> None:
        """Put the values from before the trial back into use (memory only)."""
        if self._tcal_old is not None:
            self._touch.apply_cal(self._tcal_old)               # type: ignore
        self._tcal_old = self._tcal_new = None
        self._tcal_msg = (msg + " The old calibration is back in use.").strip()
        log.info("touch calibration trial ended unsaved")

    def _tcal_save(self) -> None:
        import touch_cal_store
        if not self._tcal_on_trial():
            return
        old, new = self._tcal_old, self._tcal_new
        try:
            bak = self._touch.save_cal()                        # type: ignore
        except (touch_cal_store.CalWriteError, OSError, ValueError) as e:
            log.error("touch calibration not saved: %s", e)
            self._tcal_revert(f"Not saved: {e}."[:120])
            self._tcal_view = "home"
            self._tcal_render()
            return
        log.info("touch calibration saved to %s; old %s; new %s; backup %s",
                 self._touch.cal_path, old, new, bak)           # type: ignore
        self._tcal_old = self._tcal_new = None
        self._tcal_msg = (f"Saved. The old values are kept in {bak.name}."
                          if bak else "Saved.")
        self._tcal_view = "home"
        self._tcal_render()

    def _tcal_start_test(self) -> None:
        self._tcal_view = "test"
        self._tcal_test_t = time.monotonic()
        self._tcal_render()

    def _tcal_mark(self, px: int, py: int) -> None:
        """Draw a + where a touch landed, in the test view."""
        from palette import color
        self._tcal_test_t = time.monotonic()
        self._tcal_cross(px, py, 6, color("alert_text"))

    def _tcal_cross(self, x: int, y: int, size: int, c) -> None:
        """A 2-pixel-wide + at (x, y), from rectangles every display can fill."""
        from geometry import Rect
        self._disp.fill_rect(Rect(x - size, y - 1, 2 * size + 1, 2), c)
        self._disp.fill_rect(Rect(x - 1, y - size, 2, 2 * size + 1), c)

    def _tcal_tick(self) -> None:
        """Once a second: count the trial down, and close an idle test view."""
        now = time.monotonic()
        if self._tcal_on_trial() and now >= self._tcal_trial_end:
            self._tcal_revert(f"No SAVE in {self._TCAL_TRIAL_S} s.")
            if self._tcal_view is not None:
                self._tcal_view = "home"
                self._tcal_render()
            return
        if self._tcal_view == "test" and now - self._tcal_test_t > self._TCAL_TEST_S:
            self._tcal_view = "home"
            self._tcal_render()
            return
        if self._tcal_on_trial() and self._tcal_view in ("home", "test"):
            self._pool.set("tcal_msg", self._tcal_trial_text())     # type: ignore
            self._pool.redraw(self._disp, "tcal_msg")               # type: ignore

    def _tcal_trial_text(self) -> str:
        left = max(0, round(self._tcal_trial_end - time.monotonic()))
        return (f"Trying the new calibration. SAVE keeps it;\n"
                f"it goes back to the old one in {left} s.")

    def _tcal_file_lines(self) -> "list[str]":
        """What is in use, the file and its backups, the last check."""
        path = Path(self._touch.cal_path)                       # type: ignore
        if self._tcal_on_trial():
            in_use = "In use  NEW, on trial (not saved)"
        elif self._touch.calibrated:                            # type: ignore
            in_use = "In use  the saved calibration"
        else:
            in_use = "In use  built-in defaults (no usable file)"
        try:
            when = datetime.datetime.fromtimestamp(path.stat().st_mtime)
            file_line = f"File  {path.name}  {when:%Y-%m-%d %H:%M}"
        except OSError:
            file_line = f"File  {path.name}  (none)"
        baks = len(list(path.parent.glob(f"{path.stem}.bak*{path.suffix}")))
        err = (f"Check corner  off by ({self._tcal_err[0]:+.1f}, "
               f"{self._tcal_err[1]:+.1f}) px" if self._tcal_err else "")
        return [in_use, file_line, f"Backups  {baks}", err]

    def _tcal_render(self) -> None:
        if self._pool is None or self._tcal_view is None:
            return
        from palette import color
        p = self._pool
        p.hide_all()
        view = self._tcal_view
        if view == "corners":
            n = len(self._tcal_raw)
            label, x, y = self._tcal_targets()[n]
            p.put("tcal_prompt", self._tcal_note or
                  f"Tap the X with a stylus\n{n + 1} of 4    Esc stops")
            p.render(self._disp)
            self._rebuild_focus()
            self._tcal_cross(x, y, 15, color("black"))
            from geometry import Rect
            self._disp.fill_rect(Rect(x - 3, y - 3, 7, 7), color("alert_text"))
            return
        p.put("menu_cancel_btn", "BACK", on=self._tcal_back)
        p.put("menu_ok_btn", "SAVE", on=self._tcal_save, enabled=self._tcal_on_trial())
        msg = self._tcal_trial_text() if self._tcal_on_trial() else self._tcal_msg
        if view == "test":
            p.put("tcal_title", "Test")
            p.put("tcal_prompt", "Touch anywhere:\na + marks where it lands")
            p.put("tcal_msg", msg)
        else:
            p.put("tcal_title", "Touchpad")
            for i, text in enumerate(self._tcal_file_lines(), 1):
                p.put(f"tcal_line{i}", text)
            p.put("tcal_msg", msg or self._TCAL_HELP)
            p.put("tcal_calibrate", "Calibrate", on=self._tcal_start_corners)
            p.put("tcal_test", "Test", on=self._tcal_start_test)
        p.render(self._disp)
        self._rebuild_focus()

    # ── Phases screen (Menu → Phases) ──────────────────────────────────────────
    # Custom reagent countdowns, entered on the instrument itself.  The two
    # durations are staged in self._cfg_secs while the screen is open and are
    # written (as new rows in the `config` table) only by its OK, so a mis-tap
    # costs nothing — CANCEL leaves the saved values alone.
    #
    # They are ordinary `protocol` parameters, so the config editor below can
    # reach them too; this screen exists because stepping a countdown by ±10 s
    # against a mm:ss readout is the way an operator actually wants to set one.
    # Restore supersedes a custom value with the commissioned row again; the
    # edit stays in the table as history either way.
    #
    # The R2 row edits protocol.t2ref25_secs — the step 2 wait at 25 °C, not
    # the wait any particular sample will get, which is computed from its own
    # temperature (see reagent2_plan()).  protocol.q10 is deliberately NOT here:
    # a stepper invites nudging, and Q10 is a calibration constant for a test
    # kit rather than something to adjust between runs.  It is edited in
    # Menu -> Config, where changing it looks like the commissioning act it is.

    def _menu_open_config(self) -> None:
        """Open the phases screen, staging the durations now in force."""
        self._cfg_secs = {"r1": config.reagent1_secs(),
                          "r2": config.t2ref25_secs()}
        self._render_config()

    def _render_config(self) -> None:
        if self._pool is None:
            return
        p = self._pool
        # A slot mid-protocol already read these durations; editing them now
        # would change a running countdown out from under it. Viewing stays
        # available — only the editable controls are locked.
        editable = not self._any_slot_active()
        p.hide_all()
        # Top-corner chrome like the Menu and Capture screens.
        p.put("menu_cancel_btn", "CANCEL", on=self._cfg_cancel)
        p.put("cfg_title",       "Phases")
        p.put("menu_ok_btn",     "OK",     on=self._cfg_ok)
        # R2's label carries the reference temperature, because the number in
        # that field is not the wait a sample gets — it is the wait at 25 °C
        # that every sample's wait is scaled from.
        for row, lbl in (("r1", "Reagent 1"), ("r2", "Reagent 2\n@25°C")):
            p.put(f"cfg_{row}_lbl", lbl)
            for step in _CFG_STEPS:
                p.put(self._cfg_step_widget(row, step), f"{step:+d}",
                      on=(lambda r=row, d=step: self._cfg_step(r, d)),
                      enabled=editable)
        p.put("cfg_r1_fld", enabled=editable)
        p.put("cfg_r2_fld", enabled=editable)
        p.put("cfg_hint")
        p.put("cfg_restore", "Restore", on=self._cfg_restore, enabled=editable)
        self._cfg_paint_values(redraw=False)
        p.render(self._disp)
        self._rebuild_focus()

    @staticmethod
    def _cfg_step_widget(row: str, step: int) -> str:
        """Widget name of one step button, e.g. ('r1', -60) -> 'cfg_r1_m60'."""
        return f"cfg_{row}_{'m' if step < 0 else 'p'}{abs(step)}"

    def _cfg_paint_values(self, redraw: bool = True) -> None:
        """
        Write the staged durations into their fields and the hint line.

        `redraw` repaints just those three widgets — a step button changes
        nothing else on the screen, so it costs one small update instead of a
        full-screen render on every tap.
        """
        p = self._pool
        if p is None:
            return
        for row in ("r1", "r2"):
            p.set(f"cfg_{row}_fld", str(self._cfg_secs[row]))
        p.set("cfg_hint", f"seconds     R1 {_mmss(self._cfg_secs['r1'])}"
                          f"     R2 {_mmss(self._cfg_secs['r2'])} @25°C")
        if redraw:
            for name in ("cfg_r1_fld", "cfg_r2_fld", "cfg_hint"):
                p.redraw(self._disp, name)

    def _cfg_staged(self, row: str) -> int:
        """
        The row's duration as it now reads on screen, clamped to the allowed
        range.  The field is editable (a keyboard can type a duration straight
        in), so what it shows — not the last stepped value — is the answer;
        anything unparseable falls back to the staged value.
        """
        field = self._pool.get(f"cfg_{row}_fld") if self._pool else None
        try:
            return _clamp_secs(int(str(field.value).strip()))
        except (AttributeError, TypeError, ValueError):
            return self._cfg_secs[row]

    def _cfg_step(self, row: str, delta: int) -> None:
        self._cfg_secs[row] = _clamp_secs(self._cfg_staged(row) + delta)
        self._cfg_paint_values()

    def _cfg_restore(self) -> None:
        """Stage the commissioned durations (saved only if OK follows)."""
        self._cfg_secs = {"r1": int(config.default("protocol", "reagent1_secs")),
                          "r2": int(config.default("protocol", "t2ref25_secs"))}
        self._cfg_paint_values()

    def _cfg_ok(self) -> None:
        """Save the staged durations, apply them, and return to the Menu."""
        for row, key in (("r1", "reagent1_secs"), ("r2", "t2ref25_secs")):
            secs = self._cfg_staged(row)
            self._cfg_secs[row] = secs
            # Matching the commissioned value again means there is nothing
            # custom left to remember: restore rather than freeze today's
            # commissioned value into an operator row.
            if secs == config.default("protocol", key):
                config.restore("protocol", key)
            else:
                config.save("protocol", key, secs)
        self._apply_reagent_secs()
        self._render_menu()

    def _cfg_cancel(self) -> None:
        """Discard the staged durations and return to the Menu."""
        self._render_menu()

    def _apply_reagent_secs(self) -> None:
        """
        Rebuild the phase strategies so the new durations take effect at once.

        Phases hold no run state (slots do), so this is safe mid-run: a
        countdown already running lives on its slot and is untouched — only
        what the next START arms changes.

        Only step 1 needs the rebuild.  Step 2's phase holds no duration to
        replace — it reads t2ref25_secs and q10 through reagent2_plan() every
        time it arms — so an edit to either is already in force by the time
        this is called.  It is rebuilt along with step 1 regardless, because
        build_phases() makes the whole registry or none of it.
        """
        r1 = config.reagent1_secs()
        self._phases = build_phases(reagent1_secs=r1,
                                    preimage=config.capture_preimage_enabled(),
                                    test_variant=config.test_variant_enabled())
        log.info("Arbiter: reagent 1 countdown set to %ds; reagent 2 reference "
                 "%ds @%.0f °C, Q10 %.2f",
                 r1, config.t2ref25_secs(), config.REF_TEMP_C, config.q10())

    # ── Config editor (Menu → Config) ──────────────────────────────────────────
    # Every setting the instrument has, in one screen with three views: the list
    # of roles, one role's parameters, and one parameter's history.  Built as
    # _cfge_* methods rather than Phase objects for the reason set out for the
    # image viewer below — a Phase is bound to a Slot, and this screen has none.
    #
    # A value is typed into its field from the USB keyboard, or picked from the
    # Browse view, which is the whole editor for a touch-only instrument (there
    # is no on-screen keyboard).  Typing marks the row edited — red on yellow —
    # and from then until Rollback or Save the paging buttons are dead, so an
    # unsaved edit cannot be scrolled off the screen and lost.
    #
    # Nothing here writes SQL: config_repo owns the four transactions (save,
    # set_default, restore, restore_all) and this screen only decides which one
    # a button calls and with what.

    def _cfge_open(self) -> None:
        """Menu → Config: open the editor on the first page of roles."""
        self._cfge_role = ""
        self._cfge_name = ""
        self._cfge_roles_page = 0
        self._cfge_names_page = 0
        self._cfge_open_roles()

    def _cfge_editable(self) -> bool:
        """
        False while a slot is past entry: a live sample has already read these
        values and none of them may move under it.  The screen stays viewable —
        only the fields and the write buttons go dead.
        """
        return not self._any_slot_active()

    # ── the three views ────────────────────────────────────────────────────────

    def _cfge_open_roles(self, page: int = 0) -> None:
        """Show the roles, with Restore Factory Defaults after the last one."""
        self._cfge_view  = "roles"
        self._cfge_start = {}
        # Restore rides at the end of the list, so it lands on the last page
        # rather than under a finger aiming for the first role.
        self._cfge_list  = config.roles() + [_CFGE_RESTORE]
        self._cfge_goto(page)
        self._cfge_render()

    def _cfge_enter_role(self, role: str) -> None:
        """A role tapped on the roles view: remember this page, then open it."""
        self._cfge_roles_page = self._cfge_page
        self._cfge_open_role(role)

    def _cfge_open_role(self, role: str, page: int = 0) -> None:
        """Show one role's parameters, four to a page, alphabetically."""
        self._cfge_view = "role"
        self._cfge_role = role
        self._cfge_list = config.items(role)
        self._cfge_goto(page)
        self._cfge_render()

    def _cfge_open_browse(self, name: str) -> None:
        """
        Show every value one parameter has held: in force, default, history.

        Only ever reached from the role view, so the page it leaves is the one
        it has to come back to.

        Looking a value up is the obvious thing to do halfway through typing
        one, so an edit in progress is held rather than blocked or discarded —
        CANCEL comes back to the role view with it still in its field.
        """
        self._cfge_hold = dict(self._cfge_pending())
        self._cfge_names_page = self._cfge_page
        self._cfge_view = "browse"
        self._cfge_name = name
        self._cfge_list = config.history(self._cfge_role, name)
        self._cfge_goto(0)
        self._cfge_render()

    # ── paging ─────────────────────────────────────────────────────────────────

    def _cfge_page_size(self) -> int:
        """Roles view shows all 8 at once (4x2 grid); role/browse page by 4."""
        return _CFGE_ROLE_SLOTS if self._cfge_view == "roles" else _CFGE_ROWS

    def _cfge_pages(self) -> int:
        """How many pages the current list fills (at least one, even if empty)."""
        return max(1, -(-len(self._cfge_list) // self._cfge_page_size()))

    def _cfge_page_rows(self) -> list:
        """The slice of the list the current view's body slots are showing."""
        size  = self._cfge_page_size()
        first = self._cfge_page * size
        return self._cfge_list[first:first + size]

    def _cfge_goto(self, page: int) -> None:
        """
        Show `page` of the list just loaded, clamped to what the list has.

        A remembered page can outlive the list it was counted against — a role
        loses a parameter, a value drops out of a history — so it is clamped
        rather than trusted, and the operator lands on the last page instead of
        on four blank rows.
        """
        self._cfge_page = max(0, min(self._cfge_pages() - 1, page))

    def _cfge_page_step(self, delta: int) -> None:
        self._cfge_goto(self._cfge_page + delta)
        self._cfge_render()

    # ── rendering ──────────────────────────────────────────────────────────────

    def _cfge_render(self) -> None:
        """Draw the view that is up, header and footer included."""
        if self._pool is None:
            return
        p = self._pool
        p.hide_all()
        p.put("menu_cancel_btn", "CANCEL", on=self._cfge_cancel)
        p.put("cfge_title", self._cfge_title())
        p.put("menu_ok_btn", "OK", on=self._cfge_ok)
        if self._cfge_view == "roles":
            self._cfge_put_roles()
        elif self._cfge_view == "role":
            self._cfge_put_role()
        else:
            self._cfge_put_browse()
        self._cfge_put_footer()
        p.render(self._disp)
        self._rebuild_focus()

    def _cfge_title(self) -> str:
        """
        The header line, at most three lines in the 120 px between the corner
        buttons: what screen this is, then what it is showing.
        """
        if self._cfge_view == "roles":
            return "Config\nRoles"
        if self._cfge_view == "role":
            return f"Config\n{self._cfge_role}"
        return f"{self._cfge_role}\n{_cfge_fit(self._cfge_name)}"

    def _cfge_put_roles(self) -> None:
        from palette import color
        p = self._pool
        for i, role in enumerate(self._cfge_page_rows(), 1):
            row = f"cfge_row{i}"
            if role == _CFGE_RESTORE:
                p.put(row, "Restore Factory\nDefaults",
                      on=self._cfge_confirm_restore_all,
                      enabled=self._cfge_editable())
                p[row].color = color("label_coral")
            else:
                p.put(row, role, on=lambda r=role: self._cfge_enter_role(r))
                p[row].color = color("slot_b_bg")

    def _cfge_put_role(self) -> None:
        """
        Four rows of `name / value / Browse`.

        A parameter the table marks editable=0 — the serial numbers, the
        backlight pin — shows greyed and takes neither keystrokes nor a Browse:
        it is a record of how the instrument was built, not a setting.
        """
        p = self._pool
        editable = self._cfge_editable()
        self._cfge_start = {}
        for i, (name, _vtype, value, row_editable, _isdefault) in enumerate(
                self._cfge_page_rows(), 1):
            self._cfge_start[name] = value
            can_edit = editable and bool(row_editable)
            p.put(f"cfge_lbl{i}", name)
            # The field shows what was typed if an edit is being held over from
            # a modal or the Browse view, and the stored value otherwise.
            fld = p.put(f"cfge_fld{i}", self._cfge_hold.pop(name, value),
                        enabled=can_edit)
            # `editable` is what makes a TextBox take characters at all, and it
            # sets focusability; both have to be re-stated every render because
            # the four field widgets are shared with every other page and view.
            fld.editable  = can_edit
            fld.focusable = can_edit
            p.put(f"cfge_btn{i}", "Browse",
                  on=lambda n=name: self._cfge_open_browse(n),
                  enabled=bool(row_editable))
            self._cfge_paint_row(i, redraw=False)
        # Anything still held names a parameter on another page, which cannot
        # happen while paging is locked out — drop it rather than let it
        # reappear over an unrelated row later.
        self._cfge_hold = {}

    def _cfge_put_browse(self) -> None:
        """
        Four rows of one parameter's history: value, when and by whom it was
        first stored, and whether it is the row in force or the commissioned
        default.  Use puts it back in force — no typing involved, which is what
        makes this the editor a touch-only instrument gets.
        """
        from palette import color
        p = self._pool
        editable = self._cfge_editable()
        for i, (value, add_dt, source, active, isdefault) in enumerate(
                self._cfge_page_rows(), 1):
            marks = "  ".join(m for m, on in (("in force", active),
                                              ("default", isdefault)) if on)
            p.put(f"cfge_lbl{i}", f"{add_dt or '?'}  {source or '?'}  {marks}")
            fld = p.put(f"cfge_fld{i}", value, enabled=False)
            fld.editable  = False
            fld.focusable = False
            fld.color, fld.bg = color("black"), color("white")
            p.put(f"cfge_btn{i}", "Use",
                  on=lambda v=value: self._cfge_activate(v),
                  enabled=editable and not active)

    def _cfge_put_footer(self) -> None:
        """
        The five action buttons.  Paging is dead while an edit is pending —
        the field is the only place that edit exists, so paging away would
        discard it without saying so.
        """
        p = self._pool
        pending = bool(self._cfge_pending())
        self._cfge_footer_pending = pending
        p.put("cfge_prior", "< Prior", on=lambda: self._cfge_page_step(-1),
              enabled=self._cfge_page > 0 and not pending)
        p.put("cfge_rollback", "Rollbk", on=self._cfge_rollback, enabled=pending)
        p.put("cfge_save", "Save", on=self._cfge_save, enabled=pending)
        p.put("cfge_default", "Default", on=self._cfge_confirm_default,
              enabled=pending)
        p.put("cfge_next", "Next >", on=lambda: self._cfge_page_step(1),
              enabled=self._cfge_page < self._cfge_pages() - 1 and not pending)

    def _cfge_repaint_footer(self) -> None:
        """
        Repaint the five footer buttons after the pending-edit state flipped.

        Keyboard focus is preserved rather than rebuilt: the operator is typing
        in a field, and _rebuild_focus() would drop them back to the first
        widget mid-word.
        """
        keep = self._focused_widget()
        self._cfge_put_footer()
        for name in ("cfge_prior", "cfge_rollback", "cfge_save",
                     "cfge_default", "cfge_next"):
            self._pool[name].invalidate()
            self._pool.redraw(self._disp, name)
        self._focusables = self._pool.focusable_widgets()
        self._focus_idx  = (self._focusables.index(keep)
                            if keep in self._focusables else -1)

    def _cfge_paint_row(self, i: int, redraw: bool = True) -> None:
        """
        Colour one role-view field by its state: edited (red on yellow), fixed
        by the table (grey), or the value in force (black on white).  A no-op
        when the colour is already right, so most keystrokes cost no redraw.
        """
        from palette import color
        p    = self._pool
        fld  = p[f"cfge_fld{i}"]
        name = self._cfge_row_name(i)
        if name is None:
            return
        if not fld.editable:
            want = ("btn_gray", "white")
        elif str(fld.value) != self._cfge_start.get(name, ""):
            want = ("edited_text", "field_yellow")
        else:
            want = ("black", "white")
        fg, bg = color(want[0]), color(want[1])
        if (fld.color, fld.bg) == (fg, bg):
            return
        fld.color, fld.bg = fg, bg
        if redraw:
            fld.invalidate()
            p.redraw(self._disp, f"cfge_fld{i}")

    # ── edit state ─────────────────────────────────────────────────────────────

    def _cfge_row_name(self, i: int) -> "str | None":
        """The parameter name on body row i (1..4), or None if the row is empty."""
        rows = self._cfge_page_rows()
        return rows[i - 1][0] if 1 <= i <= len(rows) else None
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
