panibillo/Colorimeter/rpiconfig/Rpi-zero-W-2-for-mainboard_C-config.txt

# Rpi-zero-W-2-for-mainboard_C 
# On strip-board, controls 5 leds - only.
# /boot/firmware/config.txt 
# For more options and information see
# http://rptl.io/configtxt
# Some settings may impact device functionality. See link above for details
#   Enabled:   =on   or  =1
#   Disabled:  =off  or  =0

# Uncomment some or all of these to enable the optional hardware interfaces
#dtparam=i2c_arm=on
#dtparam=i2s=on
dtparam=spi=off

# Enable audio (loads snd_bcm2835)
dtparam=audio=on

# Additional overlays and parameters are documented
# /boot/firmware/overlays/README

# Automatically load overlays for detected cameras
camera_auto_detect=1

# Automatically load overlays for detected DSI displays
display_auto_detect=1

# Automatically load initramfs files, if found
auto_initramfs=1

# Enable DRM VC4 V3D driver
dtoverlay=vc4-kms-v3d
max_framebuffers=2

# Don't have the firmware create an initial video= setting in cmdline.txt.
# Use the kernel's default instead.
disable_fw_kms_setup=1

# Run in 64-bit mode
arm_64bit=1

# Disable compensation for displays with overscan
disable_overscan=1

# Run as fast as firmware / board allows
arm_boost=1

[cm4]
# Enable host mode on the 2711 built-in XHCI USB controller.
# This line should be removed if the legacy DWC2 controller is required
# (e.g. for USB device mode) or if USB support is not required.
otg_mode=1

[cm5]
dtoverlay=dwc2,dr_mode=host

[all]
enable_uart=1
dtoverlay=w1-gpio

# Initialize GPIO pins
#   pins and values match hardware
#   op = output
#   dl = drive low
# Values for ColorCam mainboard_C driving test_light_1 light board
#   Set all pins to LOW at boot time to keep LED's off.
gpio=5=op,dl
gpio=6=op,dl
gpio=22=op,dl
gpio=26=op,dl
gpio=27=op,dl
