panibillo/Colorimeter/(commit log)

2026-03-07 First commit. Just testing the camera
2026-03-20 Add rect to src/roi.py. Define 5 LED colors in dev/blink.py. Start docs/Narrative*.md.
2026-03-22 camtest5 v1.3: simplify now that 1.24s hardware cap is understood.
    Remove FrameDurationLimits workaround (hardware max is 1,238,765 µs
    across all IMX219 modes — no software change can extend it). Set
    MAX_EXPOSURE_US to 1,200,000 µs. camtest6: remove FrameDurationLimits
    from config and re-assert block; add note that 4s target is unreachable.
2026-03-25 bayer_cam.py: clean up, add save_frame/load_bayer, move tests
    - Fix all stale ColorCam references left after rename
    - Remove debug print() from unpack_raw10()
    - Restore set_analog_gain() (dropped during rename)
    - Add save_frame(): writes .jpg + .npy + .txt to a named directory
    - Add load_bayer(): loads .npy, validates dtype, returns uint16 array
    - Move __main__ live-capture test to test/test_bayer_cam.py
    - Add test/test_bayer_cam_unit.py: 50 unit tests covering all methods,
    using MagicMock for camera injection and tmp dirs for file I/O
2026-04-14 bayer_cam modified to include focus information for Camera Module 3
2026-04-16 new methods for analyzing LED lighting test results
2026-05-20 storing legacy files in current state. Before adding recent work.
2026-05-28 most camera tests working
2026-05-30 fixed bayer_cam Py Camera Module 3 processing.
2026-06-09 Baseline: prototype screens, app controller, and design docs before interface redesign
    Adds proto-screen widgets, ScreenManager, AppController with two-screen prototype,
    KbReader, beeper stubs, and devdocs covering terminology, phase scheduling design,
    YAML format proposal, tools summary, and roadmap. Establishes the pre-simplification
    state before flattening the phase-screen hierarchy per the new interface design.
2026-06-11 Add logging, calibrate_screen, update tsc2007 driver
    - tsc2007: _DEFAULT_CAL updated with working affine coefficients
    - tsc2007: read_raw() rewritten with z1>40 threshold, 0.3s timeout,
    and elapsed-time logging; read_raw and calibrate() still need tuning
    - Add src/calibrate_screen.py: validates BR residual, backs up old cal
    - Add logging to tsc2007, widgets, calibrate_screen (no-timestamp format)
    - proto_main.py: add --debug/--info/--warning CLI args
    - uploadColorimeter.sh: add to version control
2026-06-12 Add partial screen update via nav_hint flag on buttons
    Implement optional screen clearing based on navigation button hints, enabling
    efficient partial screen redraws for phase-sequence screens that share widgets.
    Changes:
    - Screen.render() now accepts clear_first parameter (default True)
    - Button class stores nav_hint from widget CSV default field
    - csv_to_widgets forwards default field to Button constructor
    - ScreenManager.switch_to() accepts and passes clear_first flag
    - AppController scans all buttons for nav_hint, wires NEXT buttons dynamically
    with clear behavior determined by 'NO_CLEAR' or 'CLEAR_ALL' flag
    Widget designers control behavior per NEXT button via widget_defs.csv defaul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
2026-07-19 Snapshot after break: interface redesign updates, mock framework, project docs
    Commits accumulated local changes to prototype screens, tsc2007/ili9341
    drivers, and design docs, plus adds the desktop mock testing framework
    (src/mock/), main entry point, config files, and setup/sync
    documentation.
2026-07-19 Extract capture-suite HDF5 schema and driveable capture workflow
    Groundwork for driving image capture from the GUI and archiving each
    capture set as a single HDF5 file.
    capture_h5.CaptureSuiteWriter owns the archive layout (group naming,
    attribute placement, dark-frame dedup and linking) on top of the generic
    hdf5write primitives. Both the offline converter and the forthcoming live
    capture path use it, so the two cannot drift apart. Dark frames depend
    only on exposure, so they are stored once under /dark and soft-linked per
    LED; the writer suppresses repeats, which np.save absorbed silently but
    h5py.create_dataset would reject.
    build_h5_from_camtest8.py keeps its camtest8 filename knowledg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
2026-07-19 Stop .gitignore excluding project source
    The blanket **.csv and **.txt rules were written for capture data, but
    they also caught hand-maintained source. Most seriously src/*.csv, which
    holds every screen and widget definition: AppController cannot build a
    single screen without those three files, and they existed only on this
    working copy. requirements-frozen.txt, system_requirements.txt,
    sync_pi_files.txt and the per-board rpiconfig records were excluded the
    same way, so a fresh clone could not run or provision the project.
    Keeps the bulk-data rules and re-includes the specific files by negation,
    rather than loosening the globs and risking capture output being
    committed by accident. Also ig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
2026-07-19 Write capture suites straight to HDF5, nothing staged on disk
    CaptureRunner now emits one archive per capture set at
    out_dir/<timestamp>.h5 instead of several hundred .npy files plus JPEG,
    sidecar and metadata files. ROI crops go from the camera into the archive
    in memory, the e3 JPEG is encoded with cv2.imencode rather than written
    and read back, and the statistics that were parsed out of the .txt
    sidecar are built directly as capture_info.
    Dark-frame sharing becomes real rather than incidental: a second LED
    landing on an exposure already captured reuses the stored frames and gets
    a soft link, which the progress stream reports as "reused dark" instead
    of "stored dark".
    The archive is crea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
2026-07-19 Run captures from the Capture screen
    CaptureSession owns the camera and LED bank for one run and advances
    CaptureRunner's generator a step at a time, turning any failure into
    inspectable state rather than letting an exception reach the event loop.
    AppController wires the Capture screen's Start button to start and cancel
    a run, pumps a step per event-loop pass, and repaints progress into the
    status widgets. cleanup() cancels first, so an interrupt cannot leave an
    LED lit or an archive open.
    Three fixes this depended on:
    The Capture screen referenced widget 202, which is not defined. Loading
    raises on an unknown id, so AppController died in _build_and_wire_screens
    and the GUI could not start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
2026-07-20 Make the Pi file list current, and actually usable
    sync_pi_files.txt listed one real entry, dev/camtest4.py, predating
    essentially all the current code. It now carries the import graph of both
    entry points (src/main.py, dev/camtest8.py) plus the screen definition
    CSVs, config files, and two on-device tools, cross-checked against the
    graph so nothing imported is missing.
    The file also claimed rsync ignores '#' comments in --files-from. It does
    not — that applies to --exclude-from/--include-from/filter files only —
    so comment lines would have been sent as filenames. sync_to_pi.sh now
    strips them first, as sync_from_pi.sh already did.
    config/touch_cal.json is deliberately excluded: it is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
2026-07-20 Split LED warmup into on-warmup and off-settle, both 2 seconds
    Each color gets exactly two LED-state-change waits: one after switching
    on (before lit captures), and one after switching off (before dark
    captures). All exposures at each state are captured back-to-back; the
    LED is not toggled again in between.
    This was already true in the code, but the single LED_WARMUP_S constant
    obscured the fact that "the wait after turning off" was the same 2
    seconds as "the wait after turning on". Split into LED_ON_WARMUP_S and
    LED_OFF_SETTLE_S for clarity.
    Added TestLedTiming to lock in both constants at 2.0 seconds as a
    requirement, and TestLedLifetime.test_exactly_one_on_off_toggle_per_capture_led
    to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
2026-07-20 Make mock captures cheap, clicks land, and the phase timer run
    Three faults that made the GUI look broken, two of them sharing a root.
    The mock camera reloaded its .jpg and .npy from disk on every frame and
    never echoed set_controls() values back in metadata, so a requested
    exposure never read as applied. _set_and_settle() then burned all 15
    MAX_SETTLE_FRAMES per exposure and warned each time. The mock now caches
    the arrays after the first read and overlays applied controls onto the
    .txt metadata, the way the real pipeline does: 15 frames per exposure
    becomes 1, and the files are read once per run.
    That blocking was also starving the event loop. Matplotlib delivers press
    and release in one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
2026-07-21 Add phase/slot UI model to replace screens + CSV
    Rebuild the display layer around a persistent widget pool, stateless phase
    strategies, stateful A/B slots, and a single arbiter that mediates the shared
    screen, camera, and buzzer. Replaces the screen-centric, CSV-driven model.
    New modules (each with a passing self-test):
    - palette.py colour names -> RGB565 (portable-name layer)
    - layout.py named Rects; the one place pixels live
    - timer.py TimerState (monotonic-deadline model) + TimerWidget
    - pool.py the single-screen widget pool: put/show/hide_all/render/redraw
    - slot.py Slot dataclass (record, phase, running, capturing, timer, result)
    - phases.py Phase base + Entry/Reagent(x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
2026-07-21 Run the phase/slot app live and add preview/Resume navigation
    Point main.py and run_simulation.py at Arbiter().start() instead of
    AppController, so the new phase/slot model drives the app. Fix the
    rendering issues found on the first real simulation run, and add a
    preview/Resume navigation model.
    Cutover
    - main.py, run_simulation.py: launch Arbiter; drop the obsolete CSV
    debug block from run_simulation.
    Simulation rendering
    - widgets: Label/TextBox paint their background before text (white-on-
    white labels were invisible on the mock, and would be on real hw too).
    - mock ili9341: clear all matplotlib keymaps (l/k/L toggled a log axis
    into a math-domain crash loop; f=fullscreen, q=quit,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
2026-07-21 Update docs to match the phase/slot code
    Bring the design and top-level architecture docs in line with the code as
    it stands now.
    - dev/phase_model_design.md, dev/phase_model_resume.md: cutover done,
    preview/Resume navigation model, rendering notes; commands use the venv.
    - src/phases.py: add view()/resume() to the arbiter-contract docstring.
    - ARCHITECTURE.md: rewrite to describe the actual system — Arbiter loop,
    phase/slot UI, capture->HDF5 pipeline, src/mock platform mocks,
    db_manager. The old version described ~14 modules that do not exist and
    none that do; unbuilt analysis/report/web layers are now under an
    explicit "Planned / not yet built" section.
    - WEB_INTERFACE.md: cor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
2026-07-21 Add interactive shutdown screen with Re-launch, Exit, Power-off options
    Adds a standalone shutdown screen (independent of the pool/phase model) that
    appears when SIGINT/SIGTERM is received or an unhandled exception occurs. The
    operator can choose Re-launch, Exit, or Power off (with a 15s Exit-default
    timeout if no choice is made). All three paths are implemented: Exit calls
    sys.exit(0), Re-launch calls os.execv() to replace the process image, and
    Power off calls `sudo shutdown -h now` (guarded in simulation mode).
    Hardens the shutdown path with:
    - Separate signal handler route (SIGINT/SIGTERM → shutdown()) instead of
    cleanup() going straight to exit
    - Idempotent cleanup() with per-resou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
2026-07-21 Add Abort button to shutdown screen for safe recovery
    Adds a fourth button to the shutdown screen that allows aborting the shutdown
    and returning to the running program. When "Abort" is selected:
    - Hardware is NOT released (display, touch, keyboard, beeper, backlight stay open)
    - The shutdown() method returns without calling cleanup() or _finish_shutdown()
    - The application resumes normal operation in the main event loop
    - The _shutting_down guard is reset so signals can be handled normally again
    Layout adjusts button sizes from 92px to 70px so all four fit comfortably on
    one row: Abort (gray) | Re-launch (green) | Exit (gray, default focus) |
    Power off (coral).
    Self-tests updated to verif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
2026-07-21 Remove deprecated screen/CSV UI files replaced by phase/slot model
    Deletes the legacy screen-based UI implementation (replaced by the phase/slot
    model on this branch):
    - app_controller.py: old application controller
    - screen_manager.py: old screen/focus management
    - csv_loader.py: CSV dataclass models
    - csv_to_widgets.py: CSV→widget conversion
    - screen_defs.csv, screen_widgets.csv, widget_defs.csv: screen definitions
    These files are no longer imported by any entry point (main.py, arbiter.py,
    run_simulation.py) and are not synced to the Pi (sync_pi_files.txt already
    reflects the phase/slot architecture).
    Removes 76 KB of legacy code.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
2026-07-22 Wire GUI to the database: sample lifecycle, defaults, and a Menu screen
    Connects the phase/slot UI to the new device/users/testkit/testlot/defaults/
    samples tables and the default_gui_vals view (src/db_DDL.sql):
    - New src/sample_repo.py: domain layer over db_manager for loading defaults,
    computing the next sequential sample number from samp_no_template, and
    sample row CRUD. Has its own self-test.
    - Entry screen (id/user/test/test-lot) autofills from defaults on first view;
    each label is now a button that reloads its field's default. Begin reserves
    the sample row in the DB (catching duplicate samp_no via a "dup" modal).
    - New Entry2Phase (temperature/weight/collect datetime) between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
2026-07-23 Add DS18B20 temperature sensor: driver, mock, and Temp-label read
    Copy dev/onewire_temp.py into src/DS18B20.py as an app driver: keep the
    module functions and CLI, route warnings to logging, and add a DS18B20
    class (init/read_c/read_all/cleanup) matching the other hardware drivers.
    Add a matching mock (mock/DS18B20_mock.py) reporting a simulated ~21.5 C.
    Wire it into the hardware set: arbiter._init_hardware() instantiates and
    init()s the sensor (real vs mock), cleanup() releases it, and a new
    arb.read_temperature() contract method samples it. Entry2Phase's Temp
    label now reads the sensor into temp_fld on press (failed read shows
    "err"). Update ARCHITECTURE.md and mock/README.md driver inven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
2026-07-23 Rename instruction rects to INSTR3/4; add step-status chips (CHIP_A/B/C)
    Layout:
    - INSTR1/INSTR2 → INSTR3/INSTR4 (align to label/field rows 3 & 4)
    - Add CHIP_A/B/C step-progress indicators (reagent1/2, Capture)
    - Extend TIMER_LBL and RUN_BTN to match timer cluster height (68px)
    Palette:
    - Add step_pending, step_running, step_done colours for chip status
    Pool:
    - Rename instr1/instr2 widgets → instr3/instr4
    - Add chip_a/b/c widgets (pill/badge labels, shown in reagent/capture phases)
    - Add Pool.recolor(name, bg=, fg=) to update widget colors by palette name
    Phases:
    - Add _STEP_SEQUENCE and _STEP_INDICATORS constants
    - Add Phase._show_steps() to render and colour-code c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
2026-07-26 Rework read-phase instruction lines; expand pump docstrings
    - Rename instruction rects/widgets INSTR3/4→INSTR1/2, add third INSTR3
    line; move ReadPhase capture instruction from instr2 to instr3 so it
    clears the Read-color entry.
    - Restyle instruction lines and timer label to black-on-white;
    step_pending chip to light gray.
    - Expand pump_capture/pump_analysis docstrings to explain the
    yield-driven, once-per-loop-pass pumping model.
2026-07-26 Add two-path capture (Calibration/Normal) with exposure groups
    Implement the exposure ladder data layer and Normal capture mode as discussed:
    - Geometric exposure ladder (centered on e*, spaced by ratio r=1.5) locked in
    - src/exposure_repo.py: ladder math (exposure_ladder, groups_from_estar) and
    exposure table access (read/write per LED+group, write_estar convenience)
    with full test coverage (test/test_exposure_repo.py, 18 tests)
    - src/capture_runner.py: CaptureConfig gains mode ("calibration"/"normal") and
    exposure_group; new _run_normal() path captures only stored exposures for
    the chosen group (focus only, no white-LED calibration, no e* search)
    - test/test_capture_runner.py: 7 ne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
2026-07-26 Adopt active-flag model for exposure table
    Rework exposure_repo for the revised exposure table schema (rowid is now an
    auto-assigned INTEGER PRIMARY KEY alias; new active/add_dt columns):
    - Reads (read_exposures, read_group, available_groups) return only active=1 rows
    - Writes deactivate superseded rows (active=0) rather than deleting, then insert
    fresh active=1 rows stamped with add_dt (local time) — prior calibrations are
    preserved and the operator can hand-edit the table externally
    - Deactivation is per-LED, so recalibrating a subset leaves other LEDs alone
    - write_estar/write_all_groups accept a shared add_dt for a calibration run
    - delete_led remains the one explicit hard-delete (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
2026-07-26 Add Menu Capture button + capture choice screen
    Wire the two capture paths into the UI as a standalone menu-launched capture:
    - Menu gains a Capture button opening a capture screen (arbiter-rendered, three
    views: choice / progress / done, like the Menu screen)
    - Choice screen: Path (Calibrate/Normal radio) x Images (1-5 radio), defaulting
    to Normal + 1 image per LED for fast debugging (reset each time it opens)
    - START builds CaptureConfig(mode, exposure_group, led 1-10) and runs it via
    CaptureSession, driven by pump_capture (routed to _pump_capture_screen for
    standalone captures, distinguished by _capture_slot is None)
    - On completion: calibration persists each LED's e* to the expos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
2026-07-26 Persist capture exposure group; fix multi-line draw_text
    Menu/Capture screen now remembers the chosen exposure group and preselects it:
    - defaults table gains an exposuregroup column; sample_repo load/save helpers
    self-heal any DB via _ensure_exposuregroup_column (idempotent ALTER), so the
    Pi picks it up with no manual migration
    - _cap_set_group persists the choice on each selection; _menu_open_capture
    preselects the saved group when it still has active rows in the exposure
    table, else falls back to '3' (clearly marked in _initial_exposure_group so
    it is easy to change later)
    ili9341.draw_text: centre multi-line text by real block height (split on \n,
    per-line layout + horizontal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
2026-07-26 Refine capture, reagent, and read screens
    Capture choice screen: replace the bottom "Back" with top-corner CANCEL (left)
    and OK (right), reusing the Menu screen's chrome widgets; recentre the
    "Calibrate Exposures" run button. OK keeps the (tap-saved) exposure group;
    CANCEL restores the group saved before the screen opened; both return to the
    Menu. The choice view narrows cap_title to sit between the corners (progress/
    done keep the full-width title).
    Reagent screens: START button shows "START\n1" / "START\n2" (ReagentPhase
    start_label). Reagent "Remaining" label shrinks to ~60% (size 13); read
    "Elapsed" to ~80% (size 18) — sizes set per phase since timer_lbl is shared.
    Read screen: the R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
2026-07-26 Add a visible alarm for a backgrounded slot's expired timer
    When a slot's countdown expires while another slot is on screen, the beep was
    the only cue and easy to miss. Now the arbiter also shows a red/yellow
    "Resume <slot>" button left of the header main button (over the title's usually-
    empty right half), which focuses that slot when tapped.
    - poll_timers arms a visible alarm (self._alarms, oldest first) when an expired
    slot is not the focused one, then repaints the focused slot
    - _paint_alarm runs in render() after the slot toggle, showing alarm_btn for the
    oldest other alarmed slot; focus() disarms the slot it switches to, and the
    button hides when no alarms remain
    - new alarm_btn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
2026-07-26 Centralize tunables in config; fix roi syntax, capture-group init, cancel prompt
    Configuration:
    - Move hard-coded tunables into config/instrument.yaml behind config_manager:
    reagent/analysis durations, main-loop cadence, shutdown timeout, capture LED
    range, fallback exposure group, default rowid, backlight pin, and DB path.
    - config_manager now deep-merges the YAML over built-in defaults and applies a
    simulation_overrides profile when simulation is active (keyed off the same
    COLORIMETER_SIMULATION env var that selects mock hardware), replacing the
    scattered `if _SIMULATION_MODE` reagent-duration branch. Any value can now
    get a sim variant in data alone.
    - db_manager, sample_repo,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
2026-07-27 Fix sample-flow capture ignoring Menu Path/Images selection
    request_capture() (the Read-phase CAPTURE button) built its CaptureConfig
    with no mode/exposure_group, silently defaulting to a full calibration
    sweep regardless of what was staged on the Menu -> Capture screen. It now
    passes the staged mode/group, matching the menu-launched capture path.
    Also: log the resolved mode/group at capture start for easier debugging,
    make the Read-phase Capture button reflect which path it will run
    ("Calibrate\nExposures" vs "Capture\n<slot>"), and relabel the Menu ->
    Capture screen's "Images" selector as "Exposures".
2026-07-27 Add capture profiling + prewarm capture imports during reagent wait
    Two speed-up groundwork steps for the capture pipeline:
    Profiling (capture_profile.py + capture_runner.py):
    - CaptureProfiler accumulates wall-clock time per category (camera.frame,
    wait.led, cpu.*, io.*) split by section (per-LED colour and phase), plus an
    exposure-floor tally that separates unavoidable sensor exposure from software
    overhead. Summary is logged when a run finishes (any exit path). On by
    default; disable with COLORIMETER_PROFILE=0. Threaded through both the
    calibration and normal capture paths via _settle/_extract/_bound_layers
    helpers to keep call-site churn low.
    Prewarm (arbiter.py):
    - prewarm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
2026-07-27 Persist one Arbiter-owned camera across captures; open it during reagent
    Step 3 of the capture-speedup work. The camera was opened and closed per
    capture, re-paying the ~1s sensor-start settle each time. Now:
    - bayer_cam.setup_camera() is idempotent (no-op when already open), so a
    persistent camera can be reused while each runner still calls it defensively.
    - CaptureSession can borrow an injected cam/leds and does not stop/close
    borrowed hardware (per-resource _owns_cam/_owns_leds); factory-built
    hardware is still released as before.
    - Arbiter owns a persistent camera + LED bank, opened once a run reaches its
    reagent wait (after prewarm) so the settle overlaps the countdown, reused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
2026-07-27 Fix: Menu/Capture "Calibrate Exposures" button always calibrates, independent of Path
    The button was hard-coded to run "Calibrate" mode label but actually used the
    selected Path radio (_cap_mode), which defaults to Normal. Pressing the button
    without tapping Calibrate ran a Normal capture instead — which never writes to
    the exposure table. The user saw "Done" with an empty database.
    Now:
    - Introduced _cap_run_mode: the in-flight standalone run's mode, pinned to
    "calibration" in _cap_start(). The progress title and completion path
    (persist_calibration vs. analyze_normal) now read _cap_run_mode.
    - _cap_mode (the Path radio) is used only by request_capture(), affecting
    Capture runs dur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
2026-07-29 Add RPi commissioning doc set; make install script username-agnostic
    New docs/RPi_commissioning.md hub + docs/commissioning/01-07 companion
    pages walk through building a Zero 2 W / Trixie colorimeter from a blank
    SD card: OS image, config.txt peripherals, firmware/DB/venv upload,
    optional SSH keys, testing, calibration (partial, dev ongoing), and
    troubleshooting. Covers both the Imager headless preset and the Desktop
    first-boot-wizard path.
    Establishes mgwwg/mgwwg as the recommended default account for newly
    commissioned/give-away units, distinct from personal dev units like
    rpizero1 (bill). install_colorimeter_service.sh now derives APP_USER from
    whoami instead of hardcoding "bill", so it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
2026-07-29 Add commissioning automation scripts: bootstrap, venv, peripheral check
    bootstrap_system.sh installs the apt system packages (numpy/OpenCV/h5py/
    picamera2/GPIO/SPI/I2C/pigpio) and enables pigpiod. make_venv.sh creates
    .venv --system-site-packages and verifies the app's imports resolve
    inside it. verify_peripherals.sh is a read-only post-reboot check of
    SPI0/SPI1/I2C+TSC2007/1-Wire+DS18B20/pigpiod/camera, referenced from
    docs/commissioning/05_testing.md.
2026-07-30 Fix commissioning to use gpiozero/lgpio, not pigpio (per CODING_GUIDELINES)
    The commissioning scripts installed pigpio + pigpiod and the python3-rpi-lgpio
    (RPi.GPIO) shim, contradicting CODING_GUIDELINES.md (PWM -> gpiozero; hardware
    PWM/buzzer -> lgpio; Rule 3: no daemon dependencies). The app code already
    complies: src/arbiter.py drives the backlight via gpiozero DigitalOutputDevice
    and src/beeper.py imports lgpio directly — nothing uses pigpio. Notably the old
    package set omitted python3-lgpio (what beeper.py actually needs) and pulled it
    in only transitively via rpi-lgpio.
    Scripts:
    - bootstrap_system.sh: drop pigpio, python3-pigpio, python3-rpi-lgpio; add
    python3-lgpio (also gpiozer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
2026-07-30 Track cal8 config guide (as-is) before editing; commissioning doc tweaks
    Back up edocs/rpi_configuration_guide_for_cal8.md into Git unmodified so the
    subsequent pigpio->gpiozero/lgpio rewrite has a clean baseline (per the
    "back up existing docs before editing" practice).
    Also includes:
    - 02_peripherals.md: anchor the config.txt sanity-check greps with ^ so the
    stock image's commented-out #dtparam placeholders no longer falsely count 2.
    - 01_os_image.md: hostname/MAC/IP discovery notes for the desktop-wizard path.
    - sync_pi_files.txt: add src/capture_profile.py to the capture pipeline list.
2026-07-31 Added the script that runs on the RPi at boot time to initialize the shift register so that the LEDs stay off.
2026-07-31 Commissioning: add re-entry/refresh guide for non-linear commissioning
    Steps 1-6 assume a linear first build from a blank SD card. Add
    docs/commissioning/00_reentry.md for the other cases: a partly
    commissioned unit, one of uncertain history or version, and one
    disrupted by a username/password/hostname/directory change.
    The page covers:
    - Take stock. Nothing on the Pi records which steps ran, so the guide
    works from the artifacts each step leaves behind, with a read-only
    probe block that reports them. Version drift is answered with
    `push_pi_scripts.sh -n` / `bulk_sync_to_pi.sh -n` (rsync checksums
    are the only ground truth); notes that neither sync script uses
    --delete, so rename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
2026-07-31 Commissioning: make the 00_reentry state probe paste-proof
    The probe block hung on a real Pi at the "bashrc login block" line,
    leaving bash at a `>` continuation prompt. The block is valid bash and
    runs end to end, so the failure was in transporting one line through
    copy -> SSH -> terminal: at 118 chars it was the longest in the block
    and the only one nesting a double-quoted string inside $( ) inside
    another double-quoted string. Arriving split or truncated left the
    opening quote unclosed, and every subsequent keystroke -- including
    `exit` -- was swallowed as more string.
    Rewrite the block so a mangled paste costs one command instead of the
    whole run:
    - one command per line, each valid sta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
2026-07-31 Commissioning: add commissioning_status.sh state-probe script
    Ship the 00_reentry.md state probe as a script as well as a paste-able
    block. The block hung on a real unit when one long line arrived with an
    unclosed quote; a pushed script has no paste path to mangle, and it can
    do things the block cannot -- most usefully, end with a verdict naming
    the step(s) to re-enter at.
    ./push_pi_scripts.sh <host> # on local
    ~/pi/Colorimeter/provisioning/commissioning_status.sh # on the Pi
    Read-only, no sudo, safe on a unit in any state including one never
    commissioned. Reports steps 1-6 from the artifacts each leaves behind,
    and exits non-zero if it found gaps. Beyond th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
2026-07-31 Menu: 3x2 option grid + Config screen for custom reagent times
    The reagent countdowns could only be shortened by editing
    instrument.yaml, and the simulation_overrides profile that shortens
    them applies in simulation only — never on the instrument itself.
    Both durations are now settable on the Pi, from the Menu.
    Menu screen: the option buttons become a 3-row x 2-column grid —
    Capture / Defaults / Config down the left, two stubs and Power down
    the right. The stubs are shown disabled until their screens exist.
    Menu -> Config: a row per reagent with the duration in seconds, four
    step buttons (-60/-10/+10/+60), and the m:ss equivalent on a hint
    line. The value is an editable field too, so a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
2026-08-01 Image viewer: on-instrument ROI inspection and editing
    Two tools for looking at a camera frame with the ROI rectangles drawn on
    it, and for editing them on the instrument: Menu -> View Image (whole
    frame, every ROI) and Read -> View Sample (opens zoomed to the sample).
    Both take one brief white-LED exposure. Design: dev/image_view_design.md.
    ROIs move from module constants into the database:
    - db_DDL.sql was unusable — 6 tables against the live DB's 9, and every
    seed INSERT plus the default_gui_vals view sat inside an unterminated
    /* ... */, so a DB built from it could not start the app. Now defines
    all 10 tables (incl. the new `roi`), the view and the seed rows, and is
    idempoten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
2026-08-01 Deploy: sync the modules and focus cal the device now needs
    sync_pi_files.txt was missing three modules the app has come to import, so
    a sync would have pushed the new arbiter/capture_runner without them and
    the Pi would have died at import:
    src/roi.py the `roi` table + the image/Bayer coordinate converters
    src/rect.py the rectangle type roi and image_view both use
    src/image_view.py the image viewer's view model
    Also adds src/db_DDL.sql, so a unit with no reference colorimeter.sqlite to
    copy can build a complete seeded one in place; the destructive companion
    db_DDL_reset.sql stays on the desktop.
    config/focus_cal.json moves from "deliberately NOT synced" to Configura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
2026-08-01 Cleanup: drop the dead wiring test and config/palette.yaml
    test_app_wiring.py tested app_controller's widget-id constants against the
    screen CSVs. app_controller.py, csv_to_widgets.py, and the *.csv screen
    definitions are all gone with the phase/slot redesign, so every test in the
    file failed at import and none had anything left to guard.
    config/palette.yaml was likewise superseded: colours now live in
    src/palette.py, and nothing reads the YAML. Drop it from sync_pi_files.txt,
    commissioning_status.sh, and the two commissioning docs that listed it, so
    deployment does not check for a file that no longer ships.
2026-08-01 Image viewer: meter preview exposure on the sample ROI; fix dead Edit
    Metering the preview against the calibrated white exposure overexposed
    the sample on the instrument, since that calibration targets the much
    brighter white patch. _auto_expose() now meters directly on the sample
    ROI's raw Bayer median, converging in up to three frames via
    capture_runner._set_and_settle's new max_frames budget.
    Also on-instrument findings: Edit stayed disabled after selecting a
    rectangle by touch, because selection repaints only the canvas/name
    strip and left the button's stale full-render state in place; and the
    arrow keys' view-mode pan used a fixed fraction, giving an
    imperceptible move at high zoom, so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
2026-08-02 Fixing auto-focus. Works in Menu/View Image, but not during sample run.
2026-08-02 Restore saved focus on camera open, not just on capture
    _ensure_camera() opened the shared camera without restoring the saved
    focus_cal.json lens position, leaving Menu -> View Image and the
    reagent-phase prewarm unfocused until an explicit Auto/Reread action.
    Real capture runs already restore it via CaptureRunner._set_focus();
    do the same restore once on first open.
2026-08-02 Update focus calibration from the Pi
    Latest lens_position measured on-device after the focus-restore fix.
2026-08-03 Two-stage dark-frame prefetch capture flow + hardware-import test fixes
    Refactor: split the normal capture path into run_prefetch() (camera
    warmup, focus, one shared "before" dark-frame batch) and run_capture()
    (LED sweep in a config-driven color order, then an "after" dark batch),
    chained via CaptureSession.start_prefetch()/start_capture() so the
    before-batch can run unattended during reagent2's countdown while
    CAPTURE stays user-gated. Arbiter schedules/pumps the prefetch, tracks
    a camera_epoch to discard a parked prefetch if shared camera state
    changed underneath it, and reworks the camera open/release thresholds
    around a single shared lead time. capture_h5.py's dark-frame key drops
    label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
2026-08-03 Reload ROIs from the DB in the normal-path prefetch
    run_prefetch() never called _load_rois(), so it kept __init__'s
    FALLBACK_ROIS for the whole normal capture path — on-instrument edits
    to the active ROI row (e.g. the bound crop) never took effect outside
    the calibration path.
2026-08-03 Lock editable config screens while a slot is active
    Config (reagent seconds), the ROI editor's Edit mode, and Defaults'
    Select now disable while slot A or B has a live phase running, so an
    operator can't change values a running slot already read out from
    under it. Viewing stays available. TextBox gained the disabled-state
    grey rendering Button already had, so a locked field looks locked.
2026-08-04 Add devdesk/flatfield.py: polynomial flat-field evaluation harness
    Settles what polynomial, over what extent, and how adequacy is judged,
    before any of this is wired into the capture path. Measured against
    captures/white_20260803_1742.h5 and mgray_20260803_1736.h5.
    Model: (deg_y, deg_x) = (3, 1) over the whole bound, 7 terms. The field is
    nearly 1-D (rows fall 25% top-to-bottom, columns vary ~2%), so a full
    bivariate cubic's 10 terms buy 0.05% against a 0.5% tolerance. Fitted per
    LED colour and per Bayer layer; the LEDs differ by 0.55-2.1% because each
    colour is its own 4-emitter array at a different position.
    Correction divides, it does not subtract. colorimeter_methods.tex says
    "subtract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
2026-08-04 flatfield: --bound override and a diagnosis for bound/archive mismatch
    A capture taken after `bound` was enlarged on the instrument aborted with a
    traceback claiming "the ROI was edited after this capture". The HDF5 writing
    is fine — 530x98 layers is exactly a 196x1060 bound, correctly cropped. The
    real cause is that the archive records no ROI geometry at all, so this tool
    has to infer `bound` from a database that is not the one the capture used:
    sync_captures_from_pi.sh copies captures/ but not colorimeter.sqlite, so an
    ROI edited on the Pi never reaches the desktop.
    Width and height can be read back from the layer shape; x and y cannot, and
    on a uniform-card capture there are no feature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
2026-08-04 Record ROI geometry, camera, device and sample in the capture archive
    An archive stored Bayer layers cropped to `bound` but recorded no ROI
    geometry, so a reader had to infer `bound` from whatever `roi` table it
    happened to have. That fails silently once the two disagree, which is the
    normal case: the analysis machine's colorimeter.sqlite is a copy, and
    sync_captures_from_pi.sh brings captures/ across but not the database, so an
    ROI edited on the instrument never arrives. `bound`'s width and height can be
    recovered from the layer shape; its x and y cannot, and a uniform-target
    capture has no features to register against, so the geometry was simply lost.
    New src/capture_meta.py gathers every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
2026-08-04 Select ROIs by role, not by hardcoded name
    roi.py's self-test asserted the active names were exactly
    ['black1','black2','bound','sample','white'] and failed on any instrument
    where they had been edited — which they had: black1/black2 are now
    chip1/chip2. That was the visible symptom of a wider problem. A ROI's *name*
    is an operator-editable label; its *role* is what it is for. Code that spells
    a name out stops matching the moment the operator renames or replaces a
    patch, and does so silently.
    roi.py gains ROLE_SAMPLE / ROLE_WHITE / ROLE_BLACK / ROLE_BOUND and
    by_role() / all_by_role() / missing_roles(). Roles are not unique — a card
    may carry several patches of one role — so by_role()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
2026-08-05 Fit the flat field over the wide calibration bound
    The gray-card suite (ZP1001-ZP1005) is captured through a bound chosen
    wider than the measurement one, so sub-bounds can be explored without
    re-imaging. flatfield.py could not analyse it: patch geometry was
    unreachable and the degree ladders could not reach the answer.
    Read the patch set from roi active=2. Those rows describe a card on the
    stage rather than the instrument's targets, so they must not be in force
    during a run; roi.load_calibration() selects them. The sample patch
    becomes the criterion-P reference, since sample-over-reference is the
    ratio the instrument actually measures.
    Re-open the x degree. The anisotropic (3,1) default wa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
2026-08-06 Fold every settings table into config, and enforce its invariants
    The config table's "one active row, one default row per parameter" rule
    lived only in config_repo.save(); nothing stopped a second active row, and
    save() on a parameter with no rows inserted an operator row without its
    isdefault partner, permanently breaking restore(). That had already happened
    twice on the prototype.
    Move the rule into the schema:
    un_config_value UNIQUE (role, name, profile, value) — makes the seed
    file's INSERT OR IGNORE idempotent, and makes reusing
    a previously-entered value a plain lookup
    ux_config_one_active partial unique index, one row in fo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
2026-08-06 Make config_repo the access layer, and stop overloading the flags
    config_repo carried both the values and the way to reach them. SEED_PARAMS
    answered whenever the database could not, so an instrument could run on values
    that were not in its database. Those are gone, along with the --emit-sql
    generator that kept three copies of them in sync. get() now raises
    ConfigMissing rather than quietly working; db_bootstrap has already guaranteed
    the row exists, so a miss is a bug.
    Drop `config.profile` and the simulation tier
    ---------------------------------------------
    A 'simulation' row existed to shorten the reagent waits under
    COLORIMETER_SIMULATION=1. It was the only user of `profile`, and the o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
2026-08-06 Read every setting from config, and store provenance as text
    The five settings tables are gone from the schema; this teaches their
    consumers to read the config table instead, and finishes the job the
    migration started.
    sample_repo keeps its Defaults dataclass — it is the Phase contract, and
    it names in one place which parameters the entry screens consume — but
    builds it from the 'defaults' and 'device' roles rather than from the
    default_gui_vals view. The runtime ALTER TABLE that self-healed a missing
    exposuregroup column goes with it: db_bootstrap repairs the database now,
    and an informal migration mechanism alongside it would only disagree.
    samples stores who, which kit, which lot an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
2026-08-06 Sweep one list of LEDs, not a list and a channel range
    capture.led_start/led_end and capture.led_color_order both answered
    "which LEDs does a run visit"; the calibration path read the range and
    the normal path read the list. The list wins — it names colors rather
    than channel numbers, so it survives a rewiring, and it can express an
    order a range cannot.
    CaptureConfig.led_start/led_end become led_colors, defaulted from
    capture.led_color_order the same way out_dir is defaulted from
    capture.directory. led_count is now just its length, which retires
    _led_total_override: it existed only because the normal path's LED count
    could not be derived from a channel range.
    The normal path reads the l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
2026-08-06 Edit every setting on screen, not just the two reagent timers
    Menu -> Config now opens a three-view editor over the whole config
    table: the roles, one role's parameters four to a page, and the value
    history behind any one of them. The old two-value screen keeps its
    widgets and moves to Menu -> Phases, which is what it always edited.
    A row is a full-width name over a full-width value, because the longest
    parameter name is 132 px at size 11 and vendor strings are longer still
    -- a name column and a value column would clip both. A typed value that
    has not been saved reads red on yellow, and the five footer buttons
    follow from it: Rollback / Save / Default wake up, Prior / Next go dead
    until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
2026-08-06 Hand the config editor back the page it was left on
    Dropping a level reset the page, so a role picked off page 2 of the
    roles handed the screen back at the top of the list, and CANCEL out of
    Browse did the same to a page of parameter names -- the operator paged
    back to where they already were, every time.
    Each level now records its page as it is left: _cfge_enter_role for the
    roles, _cfge_open_browse for the names. _cfge_back replays them.
    Descending is still a fresh start at the top of the new list, and so is
    Menu -> Config.
    _cfge_goto clamps a page to the list it is being applied to, because a
    remembered page can outlive what it was counted against -- a role losing
    a parameter, a value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
2026-08-06 Refill both slots from the defaults a config edit just changed
    A slot fills its identity fields the first time its entry screen is
    drawn, and render() is a no-op for the unfocused slot -- so after an
    edit to the defaults role the slot that had been looked at kept showing
    the old user, kit and lot while the one nobody had opened picked up the
    new ones. Two slots on one instrument disagreeing about what kit is in
    the operator's hand.
    _cfge_applied now calls the entry phase's autofill for every slot after
    any write, restore included. That is safe unconditionally because the
    editor locks itself out once any slot is past entry, so every slot it
    can reach is still on its entry screen with nothi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
2026-08-06 Stop seeding ROIs from Python; a missing role is now a hard failure
    roi.SEED_ROIS/SEED_FRAME/SEED_MODEL and roi.seed_defaults() duplicated
    the roi block already in provisioning/config_defaults.sql -- a second
    source of truth db_bootstrap made unnecessary once it started seeding
    that table at every launch. Deleted, along with the two places that
    read the Python copy as a fallback:
    - capture_runner._load_rois() no longer calls roi.seed_defaults() on an
    empty table, nor substitutes a SEED_ROIS entry for an unfilled role.
    Either case now raises the new roi.RoiMissing, naming the role(s),
    because by the time a run starts db_bootstrap has already guaranteed
    every required role has an acti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
2026-08-06 Give the instrument a version number, and stamp it into its own database
    Until now nothing in the code carried a version. `device.software_ver` was a
    hand-written row in the seed file that had said '0.2' since 2026-07-21 and that
    nothing ever changed, so every archive written between March and August claims
    to come from the same build. The commissioning docs stated the consequence
    outright — "the Pi carries no version stamp" — and made rsync --checksum the
    only way to tell what a unit was running.
    src/version.py now holds __version__, and config_repo.stamp_version() copies it
    into the instrument's config table at every launch. Because the config table
    keeps superseded rows, a unit accum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
2026-08-06 add remark field to screen 2 of capture sequence and wired it to remark field of samples table.
2026-08-07 Name archives after the sample, and finish their metadata afterwards
    Archives were named for the capture minute, recorded exposures twice, and
    carried a sample record frozen before the first photograph was taken.
    Name the file after the sample it holds (ZP1007.h5), falling back to the
    capture time for a menu-launched capture that belongs to no sample. A name
    already in use gets a letter — ZP1007-a.h5 — rather than overwriting a
    capture that cannot be taken again. suite_id still means the capture time
    and is still stored inside the archive, so the two no longer agree by
    construction and neither can be derived from the other.
    Drop the exposure_ms attribute. It was exposure_us // 1000, so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
2026-08-08 Pooled flat-field analysis over the interior bound, anchored on the chips
    devdesk/flatfield.py settled the flat field over bound roi.rowid 26, the
    732x728 calibration crop the gray-card suites were captured against. That
    bound is far larger than anything the instrument measures through. Over the
    interior bound roi.rowid 39 the geometry is different in kind: chip1, sample
    and chip2 sit collinear in x with the sample between the chips, so the
    polynomial's job is not to flatten a picture but to be anchored on the two
    chips and asked what the illumination is at the sample.
    That collapses the deliverable to two scalars per (LED, Bayer layer,
    exposure):
    divisor = w1 * mean(chip1) + w2 * mean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
2026-08-08 Publish the flat-field result, and stop storing what cannot be measured
    Three changes that share one cause: the flat-field analysis in
    devdesk/ had settled its answer, but the answer lived in a development
    database the instrument cannot see, and the capture path was still
    archiving every Bayer layer whether or not it carried signal.
    1. layermodels, in colorimeter.sqlite
    The runtime form of the whole analysis, one row per LED colour x Bayer
    layer. chip1, the sample and chip2 are imaged together and lie in a row,
    so the illumination at the sample is a fixed combination of the two chip
    readings:
    divisor = w1 * mean(chip1) + w2 * mean(chip2)
    The polynomial that produced w1 and w2 comes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
2026-08-09 Add a boot splash screen and tighten ROI role rules
    The instrument used to boot blind: the backlight came on before disp.init(),
    and any init failure was a stack trace on stderr a headless unit never shows.
    splash_screen.py narrates each boot step, replays what ran before the display
    existed, and reports anything a default had to be loaded for with its own
    message and OK press. startup_checks.py is its completeness aggregator, the
    in-app twin of provisioning/deploy/commissioning_status.sh, and picks up two
    of that script's checks (bus device nodes, hardware group membership) since
    both fail silently. Once the checks finish, the step list is replaced by only
    what went wrong — nothing shown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
2026-08-09 Bump to 0.4.1: capture-screen live progress + read-color styling
    Redesigns the per-slot Capture screen's manual-read prompt (own red label
    above the instruction line, red field border, larger fonts) and wires the
    existing capture Progress stream into the "Collected" line so it shows
    live "Capturing <color>, N exposures" / "Capturing dark images, N
    exposures" text while a run is in flight.
    Changelog cumulative-updated to cover this plus the boot splash screen,
    roi.required_roles, the remark field, pulldb/pushdb.sh, and the
    focus_cal.json path fix landed since 0.4.0.
2026-08-11 Add defaults.default_temperature and wire it to the Entry2 Temp button
    An instrument run without a DS18B20 had no way to record a sample
    temperature: pressing Temp wrote "err", which then failed to convert on
    Continue. Seed a `defaults.default_temperature` parameter (float, 21.0
    degC, editable) and let Entry2 fall back to it.
    With no probe on the 1-Wire bus the button reads "[21.0 degC]", so the
    operator can see what one press is about to write, and pressing it fills
    that value in. A probe that IS attached but does not answer still writes
    "err" -- the two cases are told apart by the new arb.temperature_attached()
    on the phase contract rather than by overloading read_temperature()'s None.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
2026-08-11 Carry `role` through roi.snap_even, and repair the arbiter self-test
    snap_even() rebuilt the Rect with only name and colour, but `role` is
    attached to a Rect after construction (see _to_rect), so a snapped copy
    came back role-less. _view_save() looks the edited rectangle up *by role*
    to check that `sample` still lies inside `bound` -- so the guard was
    skipping the one edit it exists to police, and the sample ROI could be
    dragged outside the bound crop and saved, leaving a sample the archive
    cannot re-measure. Editing `bound` was affected the same way. The stored
    `role` column was never wrong: roi.save() carries it over from the row
    being superseded.
    Found by getting the arbiter self-test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
2026-08-11 Bump to 0.5.0: coordinate samp_no across slots; Begin claims in place
    Slots A and B could offer the same sample number, leaving the operator to
    keep them apart by hand. next_sample_no() read only MAX(samp_no)+1 from
    the samples table and knew nothing of what the other slot was displaying,
    while the only reservation in the system was the INSERT at Begin -- so
    between opening an entry screen and pressing Begin, a number was claimed
    by nobody.
    The model is now stated once: a number is *claimed* by a row in `samples`,
    and not before. begin_sample() inserts synchronously, so the table is the
    whole claim registry; if that write ever becomes deferred, the allocator
    has to start consulting the be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
2026-08-12 Bump to 0.6.0: closing colour photo, cropped to the bound ROI
    A run now ends by photographing the sample under the white LED in colour,
    after the dark frames, and stores it as /photo in the archive. Every other
    frame the instrument takes is deliberately colour-neutral because the
    measurement is the Bayer data; this one exists for a person to look at.
    Only the bound ROI is kept — the same region the archived Bayer layers
    cover — so the photo shows exactly what was measured, and cropping before
    the encode means the discarded ~94% of the frame is never compressed at
    all, which is the part that costs real time on a Zero 2 W. The crop rect
    is stored beside the image, since a crop cannot othe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
2026-08-12 Give the mock display a framebuffer's memory, and time-box the suite
    The mock is retained-mode; the panel it emulates is not. fill_rect,
    draw_rect, draw_text and draw_image each added a matplotlib artist and
    never removed one, so only fill_screen() ever reclaimed anything. The
    1 Hz clock in Arbiter._tick_1hz alone therefore added two permanent
    artists a second, and every flush_events() re-rendered all of them —
    re-rasterising every glyph ever drawn, and re-reading DejaVuSans.ttf
    per glyph. Frame cost grew linearly with uptime until a single redraw
    outlasted the interval that triggered it.
    An orphaned arbiter.py sat in exactly that state for four and a half
    days: 4d16h of CPU on one core,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
2026-08-15 Rename Menu/Phases to "Reagent Phases"; grid the Config roles list
    The roles view (Menu -> Config) showed its 8 buttons as one full-width
    column, 4 rows to a page, paginated across 2 screens. Reflow into a
    single 4-row x 2-column grid, all 8 visible at once, button width
    matching the Menu screen's grid (148px).
2026-08-18 Replace Menu/Defaults with an LED Color picker for capture.led_color_order
    Two swatch rows (active sequence + inactive LEDs) with move/reorder
    arrows, plus Prior/Rollbk/Save/Default/Next paging reusing the config
    editor's footer chrome. Also corrects the indicator size noted in
    PROJECT_OVERVIEW.md (8mm square -> 5mm x 6.25mm).
2026-08-19 Pre-image the unreacted strip; time reagent 2 by temperature
    Two protocol changes, 0.7.0.
    **The pre-image.** A reagent pad is not white. It carries a colour of its own
    that varies from strip to strip by about as much as 5 ppb of arsenic develops,
    so near the bottom of the range the blank is a thing to measure rather than a
    constant to assume. A run now photographs the dry strip before reagent 1, and
    the reading is divided by that pad instead of by an average one.
    Both sweeps of one strip land in one archive: the pre-image creates it and
    writes under a new "/pre" section, the measurement reopens it with mode="a"
    and writes at the root. CaptureSuiteWriter gained `section` and `mode`, and
    the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
2026-08-20 Implement reagent weight entry and stir sub-alarm screen behavior (v0.8.0)
    ## Screen Behavior Implementation
    Adds 4-state machine UI for reagent phases with weight entry workflow:
    **PreImagePhase**: Shows reagent 1 weight entry, hides reagent 2 row. Updates
    instr text based on weight validity: "Do not add reagent 1 yet" (invalid) or
    "R1: Net {packet_net}g. Add {target_wt}g" (valid).
    **ReagentPhase** (base class, 4 states):
    1. Idle, initial_valid=false: No START button, show initial weight entry
    2. Idle, initial_valid=true: START button shown, flip to final weight entry
    3. Running, before stir: Show next reagent's weight row
    4. Running, after stir fires: Show "Stop stirring, VENTILATE" mes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
2026-08-20 Fix reagent_weigh_plan to handle float sample weights from database
    The method was calling .strip() on sample_wt which could be a float when
    read from the database. Convert to string first to handle both string and
    numeric types safely, matching the pattern used in MockArbiter.
    Fixes: 'float' object has no attribute 'strip()' error when entering
    Reagent1 screen after entry2.
2026-08-20 Show net weight and target amount on Reagent screens (state 2)
    When the user has entered a valid initial weight (state 2 idle), display
    the net reagent weight from the packet and the target amount to add in
    instr3. This carries forward the information from PreImagePhase and helps
    the user know exactly what they're working with.
    Format: 'R1: Net {packet_net}g. Add {target_wt}g' for both reagent 1 and 2.
2026-08-20 Keep weight entry fields visible and enabled throughout pre-image and reagent phases
    Fixes three visibility issues:
    1. PreImagePhase now keeps 'Weigh reagent 1 packet:' in line 2 even while
    imaging (was changing to 'Blank image of the dry strip'). The weight
    entry instruction stays relevant during capture.
    2. Weight entry fields stay visible and enabled during redraw events
    (End of pre-image, Enter key, slot swap) by adding enabled=is_live to
    all pool.put() calls for weight widgets. This prevents fields from
    disappearing after a value is entered.
    3. PreImagePhase no longer flips from initial to final weight field after
    a value is entered. It keeps showing the initial wei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
2026-08-20 Always show initial weight field in idle state for re-weighing capability
    When ReagentPhase is idle (not running), always display the current
    reagent's initial weight field, regardless of whether initial_valid is
    true. This allows the user to re-weigh the packet at any time before
    pressing Start - they may realize they need to re-weigh if they're
    unsure about the initial measurement.
    The weight field decision now hinges on slot.running (whether Start has
    been pressed), not on initial_valid:
    - Idle (not running): show initial weight for re-weighing
    - Running (after Start): show final weight for measurement after adding
    Button visibility and instr text still depend on initial_valid for
    appro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
2026-08-20 Apply same re-weighing fix to Reagent2Phase idle state
    Keep reagent2_initial_wt field visible in all idle states (both state 1
    and state 2), allowing re-weighing the packet at any time before Start
    is pressed. Only switch to reagent2_final_wt when running.
    Consistent with the fix applied to ReagentPhase: decision is now based
    on slot.running (whether Start pressed), not on initial_valid.
2026-08-20 Fix weight field re-edits to write to correct record key
    When user re-edits an initial weight value, _writethrough was writing to
    the final_wt key instead of the initial_wt key, because the target key
    had been flipped after the first valid entry.
    Change logic to determine the correct key based on current phase state
    (running vs idle) rather than the stored target key:
    - Idle: always write to initial_wt (allows re-weighing before Start)
    - Running: write to final_wt (after adding reagent)
    The _weight_field_commit function recalculates all derived values
    (packet_net, target_wt, added_wt) and persists net weight on each commit,
    so re-edits now correctly update both screen display and calculati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
2026-08-21 Reduce reagent-weighing instruction line font size to 80%
    instr1/2/3 rendered correctly in the mock GUI but far too large on the
    real device: the mock's matplotlib canvas and the device's PIL truetype
    renderer scale the same nominal point size differently, so a size tuned
    by eye in the mock doesn't transfer. Drop the base size 20 -> 16, and
    scale the two instr3 overrides (the net/target reset and the VENTILATE!
    alert) proportionally so the alert keeps its emphasis over the body text.
2026-08-21 Fix added-weight sign in reagent weigh plan
    added_wt was computed as final - initial, which is negative: the scale
    reading drops as the packet is emptied into the sample, so the amount
    added is initial - final. This fed a negative "Net" onto the Reagent
    screens instead of the packet weight actually added.
2026-08-21 Add pre-image (/pre) exposure support and schema-aware receiver ingestion
    Give the pre-image sweep its own per-LED exposure rung shift instead of
    reusing the measurement's uniform cfg.rung_shift: short and long
    wavelengths see a bright unreacted pad and need -2 rungs, cyan/green see
    a dimmer one and only need -1, per the analysis in
    docs/exposure_optimization_2026-08-20.md. Give Hdf5Reader an exists()
    probe so a reader can ask whether an archive carries a "/pre" section
    instead of catching a KeyError from inside a read.
    Fix colorimeter_receiver.py's upload handler, which was still reading an
    archive's root keys as a list of samples (the pre-0.7.0 layout). Since
    schema 4 an archive holds one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
2026-08-21 devdesk: add --pre section support, --layers view, and ROI edge-fitting
    --pre points every mode at the "/pre" pre-image section instead of the
    measurement, since a capture can now hold both. -r/--roi_plot gains
    --layers to show one panel per Bayer layer (R, Gr, Gb, B) on a shared
    scale instead of a composite reconstruction -- the only view that shows
    Gb, and the way to see which layers a capture actually stored.
    -w/--write_db now fits TEST_ROI boxes to the frame before measuring: a
    box hanging off the edge is measured over the part still inside and
    written against its own roi row, one missing the frame entirely is
    dropped, and either case writes roi_fit.png next to the archive showing
    where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
2026-08-21 Add pad analysis toolkit and two-dye separation writeup
    desktop/padanalysis/ is a standalone desktop toolkit for analysing
    captured Gutzeit test strips: pad geometry (padrect.py, segment.py),
    per-pad measurement and dark/white correction (measure.py, chemistry.py,
    probe.py), and a series of exploratory reports (look1-3.py, report3-14.py,
    pca.py, duotone.py, sweep.py) with their supporting figures.
    docs/two_dye_pad_analysis_2026-08-19.md documents the two-dye separation
    analysis (duotone.py, look3.py, report14.py) across archives C1002-C1014,
    which the later exposure-optimization work builds on.
2026-08-21 Rework reagent weight grid to per-cell fields; bump to 0.9.0
    Each reagent packet now has its own initial/final field instead of one
    field that retargeted itself between weighings, so a keystroke's
    destination is fixed by which box was typed into. reagent_weigh_plan()
    returns a ReagentWeights record whose Net cell answers "what the packet
    holds" before the pour and "what was poured" after, with Target and
    Over computable throughout rather than only once both weighings are in.
    reagent1_g/reagent2_g now record initial - final (was final - initial).
    Adds protocol.reagent_wt_tolerance (was a hardcoded constant) and
    defaults.default_sample_wt, wired to the entry2 Weight button the same
    way Temp a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
2026-08-25 Add analysis_1 pad pipeline, its missing dependencies, and HOWTO section 8
    analysis_1.py is the hand-driven, IDE-run pipeline for one strip: locate the
    pad in both sweeps, read a cell through the photometric chain, run the two-dye
    separation, and keep the interim arrays. padphot.py and whitecorr.py were
    already imported by tracked modules but had never been committed, so the
    package did not import from a clean clone.
    padrect: pick the pad's bottom edge by _nearest_local_max rather than by the
    tallest rise in the window. A broad or graded stain clears over several rows,
    so the window can hold two similarly strong rises and the taller one is not
    reliably the true edge; when a trusted top give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
2026-09-08 Refactor section handling, add R_inf guide, and document reference framework
    **analysis_1.py changes:**
    - Replace boolean pre=True/False with string sec="" or sec="pre" throughout
    - Update 102+ function signatures and call sites for clarity
    - Modify BalancedCell.__slots__ and __repr__ to use sec naming
    - Update inventory() to display dark frame information per section
    - Modify roi_overlay() to stack measurement (above) and pre-image (below)
    **probe.py changes:**
    - Add dark_groups() method to Capture class for dark-frame inspection
    - Handles dropped layers and returns statistics per exposure batch
    **New R_inf_guide.py module:**
    - Comprehensive visualization of R_inf computation and divisor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
2026-09-08 Clarify pre-image reference framework with empirical dark-frame analysis
    **docs/reference_framework_preimage_and_chips.md changes:**
    - Correct per-pixel division formula: R_inf(y,x) = sig_meas(y,x) / sig_pre(y,x)
    (not scalar reference from paper region)
    - Clarify we measure chemistry-induced change (delta), not absolute reflectance
    (pre-image tint cancels in pixel-by-pixel division)
    - Reposition gray chips as device QC monitors, not sample measurement reference
    - Flag registration/alignment as separate blocking issue (not yet solved)
    - Add empirical verification that flat-field polynomial cancels:
    * Dark-frame spatial structure: ~1 DN (verified via roi_darkdiff.py)
    * Signal levels: 1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
2026-09-08 Add empirical pad registration via edge correlation
    Implement padregistration.py to measure and correct pre-to-post image shifts
    by correlating pixel values along pad edges. This provides an optional
    refinement layer on top of the existing arithmetic registration.
    Key features:
    - Edge strip extraction (4-5 pixels along pad perimeter)
    - Correlation-based shift measurement (±max_shift pixels)
    - Optional scipy.optimize refinement for sub-pixel precision
    - ~10% noise reduction in R_inf (std: 0.541 → 0.486)
    - 2% increase in valid pixel count
    Tested on C1014 and C1016 with measurable improvements. Current approach
    measures global shifts; future enhancement can divide image into areas
    to handl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
2026-09-08 Add exploratory per-area registration (results: arithmetic still better)
    Implement _register_with_areas() to handle rotation via 3×3 grid of per-area
    shifts. This was user's suggested approach to avoid global mean shift failures.
    Testing on 7 rotation-affected samples shows:
    - Arithmetic registration still wins (6 of 7 cases)
    - Per-area introduces discontinuities and doesn't improve over global shift
    - Global shift helps only 1/7 (C1018)
    Conclusion: Edge-based correlation itself is the limitation. Edge strips
    (pad boundary) are noisy and not representative of interior pad used for
    measurement. Improvements would require:
    - Interior strip selection instead of boundary edges
    - Pre-filtering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
2026-09-08 Document empirical registration findings: not recommended
    Update documentation to reflect test results on all 11 pre-image samples:
    - Empirical edge-correlation degraded R_inf by 8.6% on average
    - Only improved in 3/11 cases; 8/11 showed degradation
    - Root cause: edge strips are noisy; not representative of interior pad
    - Per-area approach (3×3) also failed to improve accuracy
    Updates:
    - REGISTRATION.md: moved empirical to 'experimental' section with warning
    - reference_framework_preimage_and_chips.md: updated recommendation table
    - project_empirical_registration.md: documented findings and root causes
    Recommendation: Use arithmetic registration as default. Keep empirical code
    as referenc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
2026-09-08 Revise registration findings: empirical IS valuable (with proper erosion)
    Key discovery: Erosion matters. Initial tests measured full layer (no erosion),
    including noisy edge regions. Proper evaluation with erode=6 (interior pad only)
    shows empirical registration actually helps on 3/8 samples by +10-15%:
    - C1018: +10.2%
    - C1021: +11.9%
    - C1023: +14.5%
    Degrades on 5/8 samples by −1 to −10% (C1020, C1022, C1024, C1019, C1025).
    Root cause of improvement/degradation is not yet understood:
    - Not edge shift agreement
    - Not tilt angle difference
    - Not rotation (per-area shifts also failed)
    - Possibly: signal quality, pad fit residuals, or pre-image exposure
    Recommendation: empirical registra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
2026-09-08 Shelve empirical registration investigation; document findings for future revisit
    Write comprehensive investigation report documenting 2-month empirical registration
    exploration. Findings:
    Empirical edge-correlation registration shows conditional benefit on 3/8 test
    samples (+10–15% improvement) but degrades on 5/8 (−1–10%). No clear heuristic
    identified to predict which samples benefit.
    Key insights:
    - Works well on pad interior (good SNR, surface texture for correlation)
    - Fails on edges (noisy, artifacts from chip glints and stage)
    - Not explained by tilt angle, edge shift agreement, or rotation
    - Wider buffers make it worse (more noise)
    - Per-area shifts (rotation correction) als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
2026-09-08 Create resume prompt: multi-color dot analysis investigation
    Write comprehensive resume prompt for next phase of work. Shift focus from
    empirical registration back to fundamentals of image processing chain.
    New measurement geometry has color forming as a dot in pad center, not spread
    pattern. At higher exposures, dot shows 2 colors (yellow, brown) that need
    separate quantification (area and reflectance). As dot grows, erosion loses
    critical edge information; when small, noisy edges can be ignored.
    Resume prompt includes:
    - Context & motivation (why slow down, why this matters)
    - New measurement geometry description
    - Investigation goals (algebraic + visual understanding)
    - Key files to rev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
2026-09-27 Rework image pre-processing: scalar dark level, per-pixel gray divisor, hot-pixel mask
    Dark correction is now one number per Bayer layer per sweep -- the mean of
    the sweep's shortest-exposure dark frame (capture_h5.dark_level) -- instead
    of subtracting the matching dark frame pixel by pixel. Over all 2564 dark
    frames in C1002-C1036 the frame mean is 64.02-64.04 DN at every exposure
    from 1 to 51 ms; 1000 us is the shortest reliable (and shortest tested)
    dark exposure. Applied in probe.Capture.layer, devdesk/flatfield.py,
    flatfield_pool.py and hdf5inspect.py mode 4 (rows now 'dark_level').
    Gray-chip divisor is now per pixel (padphot.divisor_map): the cell's
    flat-field polynomial pegged to t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
2026-09-27 Add dark-signal characterization write-up and its figures
    tex/dark_signal_characterization.tex is the derivation the dark-correction
    and hot-pixel code cites (principally section 9): the frame-mean model,
    the corrected outlier test, and why a scalar dark level is used. Includes
    the compiled PDF and the seven figures it references.
2026-09-27 Take R_inf's white reference from the pre-image's own dry pad
    get_balanced_cell_data() now divides R by pre_white(): the median R of the
    strip's dry pad in the pre-image, inside the pre-image's own fitted pad
    rectangle eroded by `erode`, corrected by the same dark level and gray-chip
    divisor as the measurement. The bare paper below the pad is no longer read
    anywhere in the chain.
    - Cells the pre-image does not hold keep R but get no R_inf/A/KS;
    BalancedCell.white_why says why (replaces paper_sat/paper_clipped).
    - WHITECELLS now tracks PRECELLS.
    - CHAIN gains "+pre_white" so previously stored results are recomputed.
    - Run-block step 5 checks the dry pad (R_inf median 1.000 on every cell).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
2026-10-01 Add How_best_to_help_Bill.md and link it from CLAUDE.md
    A standing prompt for analysis-chain sessions, drawn from a review of
    the 2026-09-07 to 2026-09-29 sessions: the evidence each step needs
    before it joins the chain, jargon to avoid, easily confused terms,
    how to spot tangents early, and the close-out checklist for each
    analysis step. CLAUDE.md also picks up the plain-English and U.S.
    spelling lines.
2026-10-01 Add pca_study.py, shading_study.py and their write-ups
    pca_study (2026-09-27): the yellow/brown split on the dry-pad white,
    in the six shared channels; its dot-edge and ring-path checks.
    shading_study (2026-09-29), step 1: pad scatter is the paper's own
    texture, not camera noise; the pre-image removes about two thirds of
    the rim shadow per channel; the arithmetic registration (pre_to_post)
    is kept, the texture-peak search stays as demonstration code; the pad's
    outermost pixel is kept. Step 2 (removing the shading in the chain)
    is not started.
    Figure PNGs in desktop/padanalysis/fig/ are not committed; the scripts
    regenerate them.
2026-10-26 current state before exposure calibration re-design
2026-10-26 Calibrate exposure brackets with a test pad, nested log rungs
    Each stored bracket is now tested against a calibration window on a
    test pad (white, yellow, brown) and the gray chips, instead of being a
    fixed factor of one exposure.
    - exposure_fit: nested rungs at log positions 0, 1/4, 1/3, 1/2, 2/3,
    3/4, 1 (seven exposures serve groups 1-5); notes record the limiting
    patch at each end
    - exposure_measure, exposure_fit_runner: measure the pad per Bayer
    layer, run one LED or all, hooks for status and capture
    - required_cells: which LED.layer pairs must pass; per-LED windows
    - exposure table: low_dn, high_dn, layers, preimage columns
    - roi: test-pad roles; config: calibration section; star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
2026-10-26 Capture page: Bayer-layer column and per-LED windows and layers
    A column of R, Gr, Gb, B swatches beside the window boxes shows the
    chosen LED's required layers (toggle to change). The boxes edit that
    LED's own window, or the global one when no LED is chosen. SAVE writes
    calibration.led_windows and calibration.required_cells; the fit runner
    takes per-LED layers and windows.
2026-10-26 Capture page: Show screen plots the test pad's sorted signal
    One exposure plots all four Bayer layers; one layer plots each of the
    LED's stored exposures. The pad's pixels are sorted dark to light and
    drawn against the LED's window. ExposureFitRunner is split into
    _prepare, _light and _grabber so the Show runner shares its camera
    set-up. Removes the self-test for the old Calibrate Exposures button,
    which the page no longer has.
2026-10-26 Pre-image and preview use the stored tested exposures
    The pre-image shoots the exposures flagged in the exposure table's
    preimage column (the middle of the usable range), falling back to the
    middle of group 1. The per-LED rung shift and the
    capture.preimage_rung_shift setting are gone, as are the ladder math
    (exposure_ladder, groups_from_estar, shift_exposures), write_estar and
    the old Calibrate Exposures code in the arbiter. The preview starts
    from middle_exposure. The viewer self-test now builds its sample inside
    the current bound instead of fixed coordinates, so the whole arbiter
    self-test runs again.
2026-10-26 Document the tested-bracket exposure calibration
2026-10-26 Capture page: Pad areas places the test pad's patches in the image viewer
    The viewer can now edit the test pad's three patches (the active=2 set).
    The first time, the sample region is split into three bands: yellow on
    top, brown in the middle, white at the bottom. Exit returns to the
    Capture page. roi.save takes the set to supersede in.
2026-10-26 Add the exposure calibration modules to sync_pi_files.txt
2026-10-26 Fix the Capture page crash on the device: swatches used the image-space Rect
    pool.py built the LED, layer and Show swatches with rect.Rect, which has
    no .right; the real display driver needs geometry.Rect. The mock display
    never reads it, so only the device crashed. New test checks every widget
    uses the screen Rect and fits on screen.
2026-10-26 Say on the Capture page why an LED did not fit
2026-10-26 Spread the brackets across the pad when no exposure suits every patch
    When the brown low limit is longer than the white high limit, the ladder
    now runs from the white-limited exposure to the brown-limited one. Only the
    two ends are checked (no clipping, no dark patch); remarks end in 'spread'.
2026-10-26 Describe spread brackets in section 6c and on the Capture page
2026-10-26 Capture page: Show samples the whole pad, not the test-pad patches
    Show now reads every pixel of the sample region, the same region the
    capture's analysis reads, so it no longer needs the test pad to be set
    up. The fit runner's region check moves into _check_regions() so Show
    can check for the sample region instead. Calibrate suite and Calibrate
    color still use the test pad.
2026-10-26 Add the Advanced page and the Test LED page
    The Menu's Capture button becomes Advanced, which opens a page laid out
    like the Menu: Capture (moved here), Test LED, and Capture Image and
    Wifi as disabled placeholders. Capture's SAVE and CANCEL now return to
    Advanced.
    Test LED reuses the Capture page's LED bar: tap a color to light it,
    tap again to put it out, and tapping another color puts the first out
    before lighting the second. SAVE and CANCEL both leave with every LED
    off. Only the LED bank is opened, not the camera; it is held while the
    page is up, no prefetch starts meanwhile, and the button is disabled
    while a capture is running.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
2026-10-26 Add the Capture Image page
    Menu → Advanced → Capture Image photographs one LED at chosen rungs of
    its stored exposures and saves the ticked image types (jpg whole/bound,
    Bayers whole/bound, dark frames) as one test image. Capture saves as its
    last step: it writes <name>.h5.part, renames it when complete, and
    records a row in the new test_image table, which stops a name being
    reused. A failed or abandoned capture leaves no file and no row. There
    is no SAVE button; BACK leaves.
    - capture_image.py: the runner; test_image_repo.py: names and rows
    - exposure_repo.rung_exposures(): the seven rungs, read by position
    from the stored groups
    - capture_h5: lit_whole/ and dark_whole/ beside the bo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
2026-10-26 Add the Wifi page
    Menu → Advanced → Wifi shows the connection state, network and signal,
    IP address, MAC and hostname, so the instrument can be reached from
    outside. Networks lists what the radio sees and the saved profiles, to
    connect or forget (forget asks twice). Join takes a network name and
    password from a USB keyboard; the password box shows '*' until Show.
    NetworkManager saves a joined network, so it rejoins at boot.
    wifi.py runs nmcli as background jobs polled by pump_wifi(), so a slow
    connect never freezes the screen; changes use `sudo -n nmcli`, as the
    app does for shutdown. Passwords are never logged. Under simulation a
    fake backend stands in, so the desktop's own Wi-Fi is ne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
2026-10-27 Add the Calibrate Touchpad page
    Menu → Advanced → Calibrate Touchpad: tap four corner crosshairs, try the
    result in memory for 30 s (a Test view marks where touches land), and SAVE
    to keep it. BACK, Esc or the countdown puts the old values back from
    memory; the file is never touched until SAVE.
    - touch_cal_store.py: SAVE copies the old file to touch_cal.bakN.json,
    writes a temp file, swaps it in with os.replace, and reads it back.
    calibrate_screen.py now saves this way too (it used to move the old
    file aside before writing, so a failed write lost it).
    - tsc2007.py: drop the 10-tap pressure phase and the unused threshold;
    add corner_targets, average_raw, solve_affine, cal, cal_p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
2026-10-27 Add the vent hood screen; keep a manual reading typed ahead
    Continue on Entry 2 now shows a plain red screen, "Start / Vent / Hood"
    in large white letters with one OK button, before the pre-image (or
    reagent 1 when pre-imaging is off). It has no header or footer, so OK
    is the only way on; NEXT on Entry 2 still looks ahead past it.
    The "Manually read color" box on the Read screen was only read when
    Capture was pressed, so a value typed earlier (for a lab standard,
    typically while looking ahead from the reagent 2 countdown) was wiped by
    the next redraw. It now writes through to the slot record on each
    keystroke, like the entry screens, and is saved to samples.manual_read
    whenever the operat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
2026-10-27 Stop tracking KiCad .history folders
    Each .history folder is KiCad's local-history store, a git repository of
    its own, so the project recorded them as bare submodule pointers that
    showed as "modified content" after every KiCad save. Remove the
    pointers from the index and ignore .history/; the folders stay on disk.
2026-10-29 Add the treatments and test_equip tables and protocol.test_variant
    Step 1 of the test-variant screen: the storage it writes to.
    - treatments: one row per test-variant sample, joined to samples by
    samp_no — equipment, image reps, and the weight and time factors for
    each reagent. A row exists only when the sample was a test variant.
    - test_equip: the Equip pick list, seeded A..F. A treatment stores the
    chosen label by value, so editing the list cannot change old samples.
    - protocol.test_variant (int, seeded 0): 1 shows the screen and records
    a treatments row; 0 is a production run with every default.
    - sample_repo: equipment_list, save_treatment (upsert on samp_no),
    latest_treat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
2026-10-29 Add the test-variant screen
    Step 2 of the test-variant screen. With protocol.test_variant = 1,
    Continue on Entry 2 now leads to a screen of the run's deliberate
    variations before the vent reminder:
    Equip tap to step through the test_equip list
    Image reps tap to step 1..5
    Reagent 1 wt / time factor boxes
    Reagent 2 wt / time factor boxes
    Header and footer match Entry 2. Row labels put their row back to its
    default. A box that is not a number above zero turns yellow and holds
    Continue back; Continue writes the treatments row and goes to the vent
    reminder. A new run starts from the previous treatment. The values
    lock once the run moves on, so a look back cannot change f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
2026-10-30 Apply the test-variant weight and time factors
    Reagent targets are scaled by R1/R2_wt_factor, so Over, the START gate
    and the "Add x g" instruction follow the varied amount. Both reagent
    countdowns are scaled by R1/R2_time_factor (never below 1 s); the stir
    sub-alarm keeps its configured length. A production run reads 1.0.
    The arbiter self-test's "no reagent overrides left behind" check now
    looks only at the two durations its comment names, so an operator's
    own protocol settings in the copied database don't fail it.
2026-10-30 Take several image sets per run when a test variant asks for them
    With image_reps = n, both the pre-image and the measurement run n
    times. Set 1 is the sample's own archive (samples.h5file); set k >= 2
    goes in its own "{samp_no}rep{k}.h5", so each set's pre-image and
    measurement stay together. Between sets the run stays on the same
    screen, asks in yellow for the cassette to be removed and replaced,
    and the button reads "Pre-image k of n" / "Capture k of n".
    Only set 1 is prefetched and stamps capture_start. capture_end, the
    frozen timer and the final-weights gate wait for the last set, and
    every set's archive gets the finished sample record. One set (every
    production run) behaves exactl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
2026-10-30 Run the whole arbiter self-test against a copy of the database
    The copy used to be made partway through, after the bootstrap and the
    capture sections had already written to the live database -- the
    pre-image section stamped h5file='fake.h5' on live samples row 7. The
    switch now happens first, before db_bootstrap.ensure(), using sqlite's
    backup API so the snapshot is consistent even with the app running.
