panibillo/Colorimeter/hardware/IMG_3596.JPG

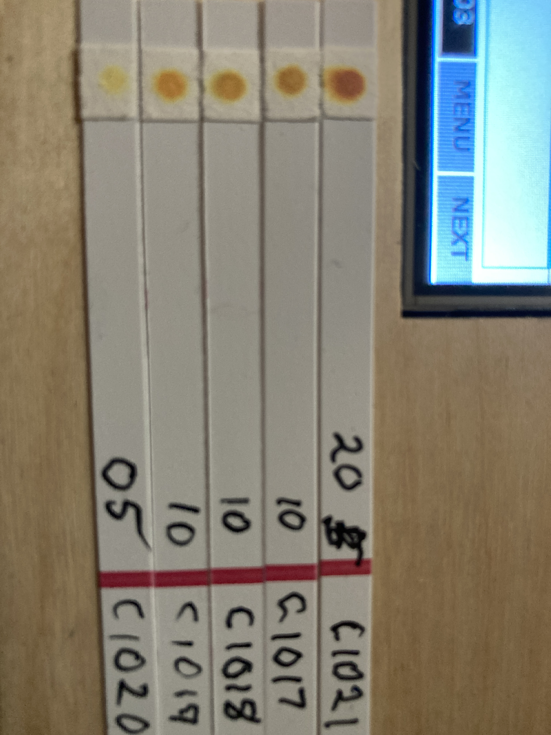
hardware/IMG_3596.JPG
