panibillo/Colorimeter/hardware/IMG_3597.JPG

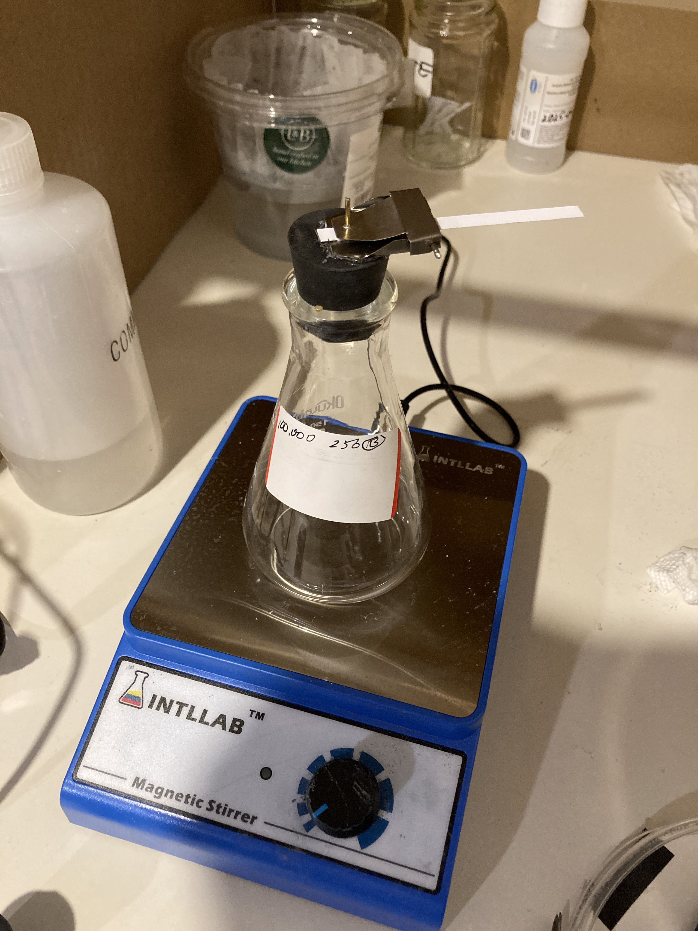
hardware/IMG_3597.JPG
